Octanis1/Octanis1-Electronics/README.md

This repo contains all Octanis 1 electronics schematics, BOM, etc.
