Octanis1/Octanis1-Electronics/octanis_eps/v0.2_compact_version/octanis_eps_revised.pdf

09/05/15 21:36 f=2.00 /Users/raffael/Desktop/Octanis/octanis-pcb/Octanis1-Electronics/octanis_eps/v0.2_compact_version/octanis_eps_revised.brd

86k6

3k32

100nF

10uF 100mH

22uF

100nF

TPS2022D 1M

100nF
100nF

920k

Octanis_EPS v0.2
