Octanis1/Octanis1-Electronics/octanis_eps/v0.3_footprint_corrections/indexed.bmp

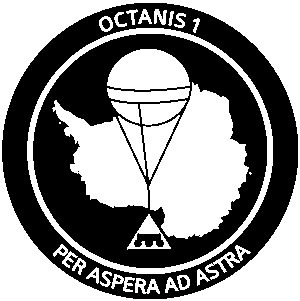
octanis_eps/v0.3_footprint_corrections/indexed.bmp
