Octanis1/Octanis1-Electronics/octanis_bom.xlsx

Sheet: octanis_v0.1bom
 | STATUS | Qty | Value | Device | Package | Parts | Description
 | mouser | 2 |  | LEDCHIP-LED0603 | CHIP-LED0603 | LED1
 | order in progress | 1 | - BAT + | PINHD-1X2 | 1X02 | BATTERY | PIN HEADER
 | order in progress | 1 | - SOLAR + | PINHD-1X2 | 1X02 | SOLAR | PIN HEADER
 | mouser | 1 | 0.01 | R-EU_R1206 | R1206 | RSBAT | RESISTOR
 | in kit | 7 | 0.1uF | C-EUC0603 | C0603 | C11
 | mouser | 1 | 0.22uF | C-EUC0603 | C0603 | C13 | CAPACITOR
 | in kit | 1 | 0.47uF | C-EUC0603 | C0603 | CG4 | CAPACITOR
 | in kit | 1 | 0R | R-EU_R0603 | R0603 | R28 | RESISTOR
should be matched | 2M in kit | 1 | 1.8M | R-EU_R0603 | R0603 | RG1 | RESISTOR
 | in kit | 2 | 100 | R-EU_R0603 | R0603 | RG5
 | in kit | 1 | 100k | R-EU_R0603 | R0603 | R5 | RESISTOR
 | in kit | 5 | 100nF | C-EUC0603 | C0603 | C14
 | mouser | 2 | 103AT | THERMISTOR-2
 | in kit | 2 | 10k | R-EU_R0603 | R0603 | RPUC
 | in kit | 2 | 10nF | C-EUC0603 | C0603 | C4
 | mouser | 2 | 10uF | CPOL-EUA/3216-18R | A/3216-18R | C12 | POLARIZED CAPACITOR
re-ordered ebay | mouser | 2 | 12p | C-EUC0603 | C0603 | C25 | cap at resonator !TOO SMALL!
should be matched | 20k in Kit | 1 | 18.2k | R-EU_R0603 | R0603 | RG2 | RESISTOR
 | in kit | 1 | 1M | R-EU_R0603 | R0603 | R16 | RESISTOR
 | in kit | 4 | 1k | R-EU_R0603 | R0603 | R1
 | in kit | 2 | 1uF | C-EUC0603 | C0603 | C7
 | in kit 603 | 2 | 1uF | C-EUC1206 | C1206 | C1
 | mouser | 1 | 1uH | XFL4020 | Coilcraft XFL4020 | L1 | http://www.mouser.ch/ProductDetail/Coilcraft/XFL4020-102MEB/
 | ebay |  | 2.2nF
 |  | 1 | 21.5k | R-EU_R1206 | R1206 | RT1 | RESISTOR
 | mouser | 3 | 22uF | C-EUC0603 | C0603 | C3 | http://www.mouser.ch/ProductDetail/TDK/C1608X5R1A226M080AC/?qs=sGAEpiMZZMs0AnBnWHyRQFzBYxg9rzNcR2ipNJY1lio%3d
 | mouser | 1 | 32.768kHz | FC-12M | FC-12M | Q1 | kHz RANGE CRYSTAL UNIT
 | mouser | 1 | 33nF | C-EUC0603 | C0603 | CG2 | CAPACITOR
 | mouser | 1 | 4.7uF | C-EUC0603 | C0603 | C10 | CAPACITOR
should be matched | in kit | 1 | 68k | R-EU_R0603 | R0603 | R3 | RESISTOR
should be matched | in kit | 1 | 270k | R-EU_R0603 | R0603 | R3 | RESISTOR
 | in kit | 1 | 470n | C-EUC0603 | C0603 | C18 | CAPACITOR
 | 510 in kit | 1 | 500 (variable) | R-EU_R1206 | R1206 | R4 | RESISTOR
 | mouser | 1 | 5V-ok | LEDCHIPLED_0603 | CHIPLED_0603 | LED3 | LED
 | available | 2 | BC547 | BC547 | TO92 | T1
mouser 3 | breakout | 1 | BMP180 | BMP180 | BMP180 | U9 | temp/pressure sensor
 | samples ordered | 1 | BQ24210 | BQ24210_DQC_10 | DQC10_P84X2P4 | U1 | charge controller
 | samples ordered | 1 | BQ27510_DRZ_12 | BQ27510_DRZ_12 | DRZ12_1P95X2P45 | U2 | fuel gauge
 | samples ordered | 4 | DRV8836DSSR | DRV8836DSSR | SON50P200X300X80-13N | U3 | h-bridge driver
 | available | 1 | HEATPAD | 22-23-2021 | 22-23-2021 | HEATPAD | .100 (2.54mm) Center Header - 2 Pin"
ebay | breakout | 1 | HMC5883L | HMC5883L | LPCC16 | COMPASS
ebay | breakout | 1 | MPU-6050 | MPU-6050 | QFN24 | MPU-6050 | pressure sensor
 | samples ordered | 1 | MSP430F5529IPNR | F552X---PN80 | PN80 | U6 | ***MSP430F552X***PN80
 | samples ordered | 1 | REG1117 | REG1117 | SOT223 | IC1 | 800mA and 1A Low Dropout (LDO) Positive Regulator
 | samples ordered | 1 | TPS61230 | TPS61230 | DRC-S-PVSON-N11 | U$1 | step up converter
 | check value! | 1 | float | R-EU_R1206 | R1206 | RVDM | RESISTOR

Sheet: eps_v0.2bom
BOM EPS Octanis1
Active components |  |  |  |  |  |  |  |  |  |  | Digikey | (QTY: for 4 boards)
Reference | Unit Price (CHF) | Qty | Total price | Manufacturer | Package | Provider | Description |  |  |  | TI samples
TPS62086RLTT | 6.35 | 1 | 6.35 | TI | VQFN-7 | Farnell | 3.3V 3A buck converter (discharge) |  |  |  | more qty needed |  | more qty ordered
LTC3402EMS#PBF | 11.1 | 1 | 11.1 | Linear Devices | MSOP10 | Farnell | Adjustable boost converter 2A (charge |  |  |  | available in the lab
MSP430G2744IDA38R | 2.85 | 1 | 2.85 | TI | TSSOP38 | TI | MCU |  |  |  | similar available in the lab
INA213AIDCKT | 1.7 | 2 | 3.4 | TI | SC70-6 | Farnell | Gain 50 current sensor 35µA polarization |  |  |  | not on digikey
TPS2022D | 3.5 | 3 | 10.5 | TI | SOIC8 | Farnell | 1.5A distribution switch
ADR127BUJZ-REEL7 | 10.15 | 1 | 10.15 | Analog Devices | TSOT23-6 | Farnell | Precision 1.25V voltage reference
OPA2333AIDGKT | 3.6 | 4 | 14.4 | TI | MSOP8 | Farnell | Low power OPA 2 channels
FDV301N | 0.288 | 3 | 0.864 | Farichild | SOT-23 | Farnell | N canal MOSFET
IRLL024NPBF | 1.25 | 3 | 3.75 | IR | SOT-223 | Farnell | N hexfet 2V threshold
MJD44H11T4 | 0.713 | 1 | 0.713 | ST micro | TO-252 | Farnell | BJT
Reference | Unit Price (CHF) | Qty | Total price | Manufacturer | Package | Provider | Description | Comment on order
1kOhm | 0.015 | 3 | 0.045 | - | 603 | Farnell
50mOhm 0.1% 1/2W | 0.1 | 3 | 0.3 | - | 1206 | Farnell | current shunts precision resistor | 25pcs 0.5%
10kOhm 0.1% | 0.03 | 6 | 0.18 | - | 603 | Farnell |  | 30pc
100kOhm | 0.015 | 5 | 0.075 | - | 603 | Farnell
200kOhm | 0.015 | 5 | 0.075 | - | 603 | Farnell
147kOhm 0.1% | 0.03 | 1 | 0.03 | - | 603 | Farnell |  | 5
953Ohm 0.1% | 0.03 | 1 | 0.03 | - | 603 | Farnell |  | 5
86k6Ohm 0.1% | 0.5 | 1 | 0.5 | - | 603 | Farnell |  | 5
4k02Ohm 0.1% | 0.5 | 1 | 0.5 | - | 603 | Farnell |  | 5
560kOhm 0.1% | 0.1 | 2 | 0.2 | - | 603 | Farnell |  | 10pcs
3k32Ohm 0.1% | 0.5 | 1 | 0.5 | - | 603 | Farnell |  | 5
30k1Ohm 0.1% | 0.5 | 1 | 0.5 | - | 603 | Farnell |  | 5
~~1.3MOhm 0.1%~~ | ~~0.5~~ | ~~1~~ | ~~0.5~~ | ~~-~~ | ~~603~~ | ~~Farnell~~ |  | ~~5pc 1%~~
~~549kOhm 0.1%~~ | ~~0.5~~ | ~~1~~ | ~~0.5~~ | ~~-~~ | ~~603~~ | ~~Farnell~~ |  | ~~5pc 1%~~
82kOhm 0.1% | 0.5 | 1 | 0.5 | - | 603 | Farnell |  | 5
1MOhm | 0.015 | 6 | 0.09 | - | 603 | Farnell
162kOhms 1% | 0.015 | 3 | 0.045 |  | 603 | Farnell |  | 15pcs
20kOhms 0.11% | 0.03 | 1 | 0.03 |  | 603 | Farnell |  | 5
23.2kOhms 0.1% | 0.03 | 1 | 0.03 |  | 603 | Farnell |  | 5
31.60kOhms 0.1% | 0.03 | 1 | 0.03 |  | 603 | Farnell |  | 5
920kOhms 0.1% | 0.03 | 1 | 0.03 |  | 603 | Farnell |  |  | BUY 820K + 100K | ordered 10+20
MBRM120LT1G | 0.9 | 3 | 2.7 | - | D0216AA | Farnell | shottky | 25pc
150nF | 0.03 | 4 | 0.12 | - | 603 | Farnell |  | 20pc | 1,5uF in schematics | note: only 10% available for this package
100nF | 0.03 | 10 | 0.3 | - | 603 | Farnell
10nF | 0.03 | 10 | 0.3 | - | 603 | Farnell
12pF 1% -->12.5?? | 0.5 | 2 | 1 | - | 603 | Farnell |  | 25pc
10uF | 0.5 | 1 | 0.5 | - | A/3216-18R | Farnell | polarized capacitor
22uF | 0.5 | 1 | 0.5 | - | A/3216-18R | Farnell | polarized capacitor
470pF | 0.003 | 1 | 0.003 | - | 603 | Farnell |  | 10pcs
4.7pF | 0.003 | 1 | 0.003 | - | 603 | Farnell |  | 10pc
4.7uF | 0.5 | 1 | 0.5 | - | 1206 | Farnell | X5R or X7R family recommended | 10pcs 1206
22uF | 0.5 | 2 | 1 | - | 603 | Farnell | X5R or X7R family recommended
10uF | 0.5 | 2 | 1 | - | 1206 | Farnell | X5R or X7R family recommended | 10pcs
10uH | 1.25 | 1 | 1.25 | Coiltronics | DR127 | Farnell | Power inductor 10uH
DR127-R47-R. | 1.2 | 1 | 1.2 | Coiltronics | DR128 | Farnell | Power inductor 0.47uH
32kHz crystal | 0.5 | 1 | 0.5 | - | FC-12M | Farnell | Crystal | ordered one with 6pF cap!
 |  |  | 79.643

Sheet: eps_v0.4bom
BOM EPS Octanis1 |  |  |  |  |  |  |  |  |  |  |  |  |  |  |  |  |  | 2:50:00
Active components |  |  |  |  |  |  |  |  |  |  |  |  |  |  |  |  |  |  | Digikey | (QTY: for 4 boards)
Reference | Unit Price (CHF) | Qty | Total price | Manufacturer | Package | Provider | Description |  |  |  | Qty | Value | Device | Package | Parts |  | Description |  | samples
TPS62086RLTT | 6.35 | 1 | 6.35 | TI | VQFN-7 | Farnell | 3.3V 3A buck converter (discharge) |  |  |  | 1 | TPS62086 | TPS62086 | QFN-7 | U$4 |  | 3-A |  | more qty needed |  | more qty ordered
LTC3402EMS#PBF | 11.1 | 1 | 11.1 | Linear Devices | MSOP10 | Farnell | Adjustable boost converter 2A (charge |  |  |  | 3 | TPS2022D | TPS2022D | SO8 | U$101, U$102, U | $103 | TEXAS INSTRUMENTS - TPS202 | 2D - IC, 1.5A PWR DIST SWITCH 8SOIC | available in the lab
MSP430G2744IDA38R | 2.85 | 1 | 2.85 | TI | TSSOP38 | TI | MCU |  |  |  | 1 | OPA347 | OPA347 | SC70-5 | IC101 |  | micro Power, |  | similar available in the lab
INA213AIDCKT | 1.7 | 2 | 3.4 | TI | SC70-6 | Farnell | Gain 50 current sensor 35µA polarization |  |  |  | 3 | OPA2333DGK | OPA2333DGK | MSOP08 | IC1, IC2, IC100 |  | DUAL 1.8V, microPOWER CMOS | OPERATIONAL AMPLIFIERS Zerø-Drift Series | not on digikey
TPS2022D | 3.5 | 3 | 10.5 | TI | SOIC8 | Farnell | 1.5A distribution switch |  |  |  | 3 | IRLL024NPBF | N-HEXFET-2D_SOT232- | SOT223 | Q1, Q2, Q100 |  | HEXFET® Power MOSFET 2 Dra | in connects | more precision needed
ADR127BUJZ-REEL7 | 10.15 | 1 | 10.15 | Analog Devices | TSOT23-6 | Farnell | Precision 1.25V voltage reference |  |  |  | 1 | MSP430G2544 | MSP430G2544 | TSSOP38_MSPGXX44_SERIES | U$5 |  | MSP430G2x44 |  | Ordered on MOUSER
OPA2333AIDGKT | 3.6 | 4 | 14.4 | TI | MSOP8 | Farnell | Low power OPA 2 channels |  |  |  | 1 | MJD44H11T0-252 | MJD44H11T0-252 | TO252 | U$1 |  | MJD44H11,
FDV301N | 0.288 | 3 | 0.864 | Farichild | SOT-23 | Farnell | N canal MOSFET |  |  |  | 1 | MBRM120LTIG | MBRM120LTIG | DO216AA | U$7
IRLL024NPBF | 1.25 | 3 | 3.75 | IR | SOT-223 | Farnell | N hexfet 2V threshold |  |  |  | 1 | MAX6190BESA | MAX6190BESA | SO8 | U$100 |  | MAX6190–MAX6195/MAX6198
MJD44H11T4 | 0.713 | 1 | 0.713 | ST micro | TO-252 | Farnell | BJT |  |  |  | 1 (2 available) | LTC3402 | LTC3402 | MSOP10 | U$6 |  | 1
Reference | Unit Price (CHF) | Qty | Total price | Manufacturer | Package | Provider | Description | Comment on order |  |  | 2 | INA213 | INA213 | SC70-6 | U$2, U$3 |  | Voltage
1kOhm | 0.015 | 3 | 0.045 | - | 603 | Farnell |  |  |  |  | 1 | FC-12M | FC-12M | FC-12M | Q3 |  | kHz RANGE CRYSTAL UNIT
50mOhm 0.1% 1/2W | 0.1 | 3 | 0.3 | - | 1206 | Farnell | current shunts precision resistor | 25pcs 0.5% |  |  | 1 | 0.47uH | DR127 | DR127 | 0.47uH |  | High Power Density, High E | fficiency, Shielded Inductors
10kOhm 0.1% | 0.03 | 6 | 0.18 | - | 603 | Farnell |  | 30pc |  |  | 2 | 10UH | DR127 | DR127 | 10UH |  | High Power Density, High E | fficiency, Shielded Inductors
100kOhm | 0.015 | 5 | 0.075 | - | 603 | Farnell
200kOhm | 0.015 | 5 | 0.075 | - | 603 | Farnell |  |  |  |  | 1 | 953R 0.1% | R-EU_R0603 | R0603 | R100 |  | RESISTOR, European symbol
147kOhm 0.1% | 0.03 | 1 | 0.03 | - | 603 | Farnell |  | 5 |  |  | 1 | 0Ohm | R-EU_R0603 | R0603 | R4 |  | RESISTOR, European symbol
953Ohm 0.1% | 0.03 | 1 | 0.03 | - | 603 | Farnell |  | 5 |  |  | 4 | 1.5uF | C-EUC0603 | C0603 | C1, C2, C7, C12 |  | CAPACITOR, European symbol
86k6Ohm 0.1% | 0.5 | 1 | 0.5 | - | 603 | Farnell |  | 5 |  |  | 8 | 100k --> precision??? | R-EU_R0603 | R0603 | R15, R19, R104, | R108, R111, R112, R117, R119 | RESISTOR, European symbol
4k02Ohm 0.1% | 0.5 | 1 | 0.5 | - | 603 | Farnell |  | 5 |  |  | 1 | 100mH | BLM15HD601SN1 | 402 | FERRITE |  | EMIFIL (R) Chip Ferrite Be | ad for GHz Noise
560kOhm 0.1% | 0.1 | 2 | 0.2 | - | 603 | Farnell |  | 10pcs |  |  | 8 | 100nF | C-EUC0603 | C0603 | C10, C100, C102 | , C105, C_IC1, C_IC2, C_IC100, C_IC101 | CAPACITOR, European symbol
3k32Ohm 0.1% | 0.5 | 1 | 0.5 | - | 603 | Farnell |  | 5 |  |  | 3 | 10k 0.1% | R-EU_R0603 | R0603 | R11, R18, R23 |  | RESISTOR, European symbol
30k1Ohm 0.1% | 0.5 | 1 | 0.5 | - | 603 | Farnell |  | 5 |  |  | 2 | 10m | CURRENT_RESISTOR | 4PADS_RESISTOR | RSENSE1, R_SENS | E1
~~1.3MOhm 0.1%~~ | ~~0.5~~ | ~~1~~ | ~~0.5~~ | ~~-~~ | ~~603~~ | ~~Farnell~~ |  | ~~5pc 1%~~ |  |  | 1 | 10nF | C-EUC0603 | C0603 | C11 |  | CAPACITOR, European symbol
~~549kOhm 0.1%~~ | ~~0.5~~ | ~~1~~ | ~~0.5~~ | ~~-~~ | ~~603~~ | ~~Farnell~~ |  | ~~5pc 1%~~ |  |  | 1 | 10uF | C-EUC1206 | C1206 | C3 |  | CAPACITOR, European symbol
82kOhm 0.1% | 0.5 | 1 | 0.5 | - | 603 | Farnell |  | 5 |  |  | 1 | 10uF | CPOL-EUA/3216-18R | A/3216-18R | C103 |  | POLARIZED CAPACITOR, Europ | ean symbol
1MOhm | 0.015 | 6 | 0.09 | - | 603 | Farnell |  |  |  |  | 2 | 12pF | C-EUC0603 | C0603 | C5, C6 |  | CAPACITOR, European symbol
162kOhms 1% | 0.015 | 3 | 0.045 |  | 603 | Farnell |  | 15pcs |  |  | 1 | 147k 0.1% | R-EU_R0603 | R0603 | R105 |  | RESISTOR, European symbol
20kOhms 0.11% | 0.03 | 1 | 0.03 |  | 603 | Farnell |  | 5 |  |  | 3 | 162k 0.1% | R-EU_R0603 | R0603 | R14, R22, R27 |  | RESISTOR, European symbol
23.2kOhms 0.1% | 0.03 | 1 | 0.03 |  | 603 | Farnell |  | 5 |  |  | 7 | 1k | R-EU_R0603 | R0603 | R1, R2, R3, R5, | R10, R13, R17 | RESISTOR, European symbol
31.60kOhms 0.1% | 0.03 | 1 | 0.03 |  | 603 | Farnell |  | 5 |  |  | 8 | 1M | R-EU_R0603 | R0603 | R6, R7, R8, R9, | R24, R113, R114, R115 | RESISTOR, European symbol
920kOhms 0.1% | 0.03 | 1 | 0.03 |  | 603 | Farnell |  |  | BUY 820K + 100K | ordered 10+20 | 1 | 2.2nF | C-EUC0603 | C0603 | C101 |  | CAPACITOR, European symbol
MBRM120LT1G | 0.9 | 3 | 2.7 | - | D0216AA | Farnell | shottky | 25pc |  |  | 5 | 200k | R-EU_R0603 | R0603 | R29, R103, R107 | , R116, R118 | RESISTOR, European symbol
150nF | 0.03 | 4 | 0.12 | - | 603 | Farnell |  | 20pc | 1,5uF in schematics | note: only 10% available for this package | 1 | 20k 0.1% | R-EU_R0603 | R0603 | R25 |  | RESISTOR, European symbol
100nF | 0.03 | 10 | 0.3 | - | 603 | Farnell |  |  |  |  | 1 | 22uF | C-EUC0603 | C0603 | C14 |  | CAPACITOR, European symbol
10nF | 0.03 | 10 | 0.3 | - | 603 | Farnell |  |  |  |  | 1 | 22uF | C-EUC1206 | C1206 | C4 |  | CAPACITOR, European symbol
12pF 1% -->12.5?? | 0.5 | 2 | 1 | - | 603 | Farnell |  | 25pc |  |  | 1 | 22uF | CPOL-EUA/3216-18R | A/3216-18R | C104 |  | POLARIZED CAPACITOR, Europ | ean symbol
10uF | 0.5 | 1 | 0.5 | - | A/3216-18R | Farnell | polarized capacitor |  |  |  | 1 | 23.2k 0.1% | R-EU_R0603 | R0603 | R28 |  | RESISTOR, European symbol
22uF | 0.5 | 1 | 0.5 | - | A/3216-18R | Farnell | polarized capacitor |  |  |  | 1 | 30.1k 0.1% | R-EU_R0603 | R0603 | R16 |  | RESISTOR, European symbol
470pF | 0.003 | 1 | 0.003 | - | 603 | Farnell |  | 10pcs |  |  | 1 | 31.60k 0.1% | R-EU_R0603 | R0603 | R26 |  | RESISTOR, European symbol
4.7pF | 0.003 | 1 | 0.003 | - | 603 | Farnell |  | 10pc |  |  | 1 | 3k32 0.1% | R-EU_R0603 | R0603 | R106 |  | RESISTOR, European symbol
4.7uF | 0.5 | 1 | 0.5 | - | 1206 | Farnell | X5R or X7R family recommended | 10pcs 1206 |  |  | 1 | 4.7pF | C-EUC0603 | C0603 | C8 |  | CAPACITOR, European symbol
22uF | 0.5 | 2 | 1 | - | 603 | Farnell | X5R or X7R family recommended |  |  |  | 1 | 4.7uF | C-EUC1206 | C1206 | C13 |  | CAPACITOR, European symbol
10uF | 0.5 | 2 | 1 | - | 1206 | Farnell | X5R or X7R family recommended | 10pcs |  |  | 1 | 470pF | C-EUC0603 | C0603 | C9 |  | CAPACITOR, European symbol
10uH | 1.25 | 1 | 1.25 | Coiltronics | DR127 | Farnell | Power inductor 10uH |  |  |  | 1 | 4k02 0.1% | R-EU_R0603 | R0603 | R102 |  | RESISTOR, European symbol
DR127-R47-R. | 1.2 | 1 | 1.2 | Coiltronics | DR128 | Farnell | Power inductor 0.47uH |  |  |  | 1 | 50m | CURRENT_RESISTOR | 4PADS_RESISTOR | RSENSE2
32kHz crystal | 0.5 | 1 | 0.5 | - | FC-12M | Farnell | Crystal | ordered one with 6pF cap! |  |  | 2 | 560k 0.1% | R-EU_R0603 | R0603 | R21, R109 |  | RESISTOR, European symbol
 |  |  |  |  |  |  |  |  |  |  | 1 | 82k 0.1% | R-EU_R0603 | R0603 | R12 |  | RESISTOR, European symbol
 |  |  |  |  |  |  |  |  |  |  | 1 | 86k6 0.1% | R-EU_R0603 | R0603 | R101 |  | RESISTOR, European symbol
 |  |  | 79.643 |  |  |  |  |  |  |  | 2 | 920k (100k + 820k) 0.1% | R-EU_R0603 | R0603 | R20, R110 |  | RESISTOR, European symbol
Part | list exported from / | Users/raffael/Deskto | p/Octanis/octanis-pcb/Oc | tanis1-Electron | ics/octanis_eps/v0.4_second_run/octanis | _eps_v04.sch at 08/09/15 1 | 2:50:00
Qty | Value | Device | Package | Parts |  | Description
2 |  | JP1E | JP1 | I2C, SLEEP |  | JUMPER
1 |  | JP4Q | JP4Q | JP3 |  | JUMPER
4 |  | PINHD-1X1 | 1X01 | BT_CHG, DSP_CMD | , VCC, VREF | PIN HEADER
1 |  | PINHD-2X12 | 2X12 | JP1 |  | PIN HEADER
1 | 0Ohm | R-EU_R0603 | R0603 | R4 |  | RESISTOR, European symbol
4 | 1.5uF | C-EUC0603 | C0603 | C1, C2, C7, C12 |  | CAPACITOR, European symbol
8 | 100k | R-EU_R0603 | R0603 | R15, R19, R104, | R108, R111, R112, R117, R119 | RESISTOR, European symbol
1 | 100mH | BLM15HD601SN1 | 402 | FERRITE |  | EMIFIL (R) Chip Ferrite Be | ad for GHz Noise
8 | 100nF | C-EUC0603 | C0603 | C10, C100, C102 | , C105, C_IC1, C_IC2, C_IC100, C_IC101 | CAPACITOR, European symbol
3 | 10k | R-EU_R0603 | R0603 | R11, R18, R23 |  | RESISTOR, European symbol
2 | 10m | CURRENT_RESISTOR | 4PADS_RESISTOR | RSENSE1, R_SENS | E1
1 | 10nF | C-EUC0603 | C0603 | C11 |  | CAPACITOR, European symbol
1 | 10uF | C-EUC1206 | C1206 | C3 |  | CAPACITOR, European symbol
1 | 10uF | CPOL-EUA/3216-18R | A/3216-18R | C103 |  | POLARIZED CAPACITOR, Europ | ean symbol
2 | 12pF | C-EUC0603 | C0603 | C5, C6 |  | CAPACITOR, European symbol
1 | 147k | R-EU_R0603 | R0603 | R105 |  | RESISTOR, European symbol
3 | 162k | R-EU_R0603 | R0603 | R14, R22, R27 |  | RESISTOR, European symbol
8 | 1M | R-EU_R0603 | R0603 | R6, R7, R8, R9, | R24, R113, R114, R115 | RESISTOR, European symbol
7 | 1k | R-EU_R0603 | R0603 | R1, R2, R3, R5, | R10, R13, R17 | RESISTOR, European symbol
1 | 2.2nF | C-EUC0603 | C0603 | C101 |  | CAPACITOR, European symbol
5 | 200k | R-EU_R0603 | R0603 | R29, R103, R107 | , R116, R118 | RESISTOR, European symbol
1 | 20k | R-EU_R0603 | R0603 | R25 |  | RESISTOR, European symbol
1 | 22uF | C-EUC0603 | C0603 | C14 |  | CAPACITOR, European symbol
1 | 22uF | C-EUC1206 | C1206 | C4 |  | CAPACITOR, European symbol
1 | 22uF | CPOL-EUA/3216-18R | A/3216-18R | C104 |  | POLARIZED CAPACITOR, Europ | ean symbol
1 | 23.2k | R-EU_R0603 | R0603 | R28 |  | RESISTOR, European symbol
1 | 30.1k | R-EU_R0603 | R0603 | R16 |  | RESISTOR, European symbol
1 | 31.60k | R-EU_R0603 | R0603 | R26 |  | RESISTOR, European symbol
1 | 3k32 | R-EU_R0603 | R0603 | R106 |  | RESISTOR, European symbol
1 | 4.7pF | C-EUC0603 | C0603 | C8 |  | CAPACITOR, European symbol
1 | 4.7uF | C-EUC1206 | C1206 | C13 |  | CAPACITOR, European symbol
1 | 470pF | C-EUC0603 | C0603 | C9 |  | CAPACITOR, European symbol
1 | 4k02 | R-EU_R0603 | R0603 | R102 |  | RESISTOR, European symbol
1 | 50m | CURRENT_RESISTOR | 4PADS_RESISTOR | RSENSE2
2 | 560k | R-EU_R0603 | R0603 | R21, R109 |  | RESISTOR, European symbol
1 | 82k | R-EU_R0603 | R0603 | R12 |  | RESISTOR, European symbol
1 | 86k6 | R-EU_R0603 | R0603 | R101 |  | RESISTOR, European symbol
2 | 920k | R-EU_R0603 | R0603 | R20, R110 |  | RESISTOR, European symbol
1 | 953R | R-EU_R0603 | R0603 | R100 |  | RESISTOR, European symbol
2 | DR127 | DR127 | DR127 | 0.47UH, 10UH |  | High Power Density, High E | fficiency, Shielded Inductors
1 | FC-12M | FC-12M | FC-12M | Q3 |  | kHz RANGE CRYSTAL UNIT
2 | INA213 | INA213 | SC70-6 | U$2, U$3 |  | Voltage
1 | LTC3402 | LTC3402 | MSOP10 | U$6 |  | 1
1 | MAX6190BESA | MAX6190BESA | SO8 | U$100 |  | MAX6190–MAX6195/MAX6198
1 | MBRM120LTIG | MBRM120LTIG | DO216AA | U$7
1 | MJD44H11T0-252 | MJD44H11T0-252 | TO252 | U$1 |  | MJD44H11,
1 | MSP430G2544 | MSP430G2544 | TSSOP38_MSPGXX44_SERIES | U$5 |  | MSP430G2x44
3 | N-HEXFET-2D_SOT232- | N-HEXFET-2D_SOT232- | SOT223 | Q1, Q2, Q100 |  | HEXFET® Power MOSFET 2 Dra | in connects
3 | OPA2333DGK | OPA2333DGK | MSOP08 | IC1, IC2, IC100 |  | DUAL 1.8V, microPOWER CMOS | OPERATIONAL AMPLIFIERS Zerø-Drift Series
1 | OPA347 | OPA347 | SC70-5 | IC101 |  | micro Power,
3 | TPS2022D | TPS2022D | SO8 | U$101, U$102, U | $103 | TEXAS INSTRUMENTS - TPS202 | 2D - IC, 1.5A PWR DIST SWITCH 8SOIC
1 | TPS62086 | TPS62086 | QFN-7 | U$4 |  | 3-A
1 | d SBW clk | PINHD-1X2 | 1X02 | JP2 |  | PIN HEADER

Sheet: octanis_v0.4bom
ORDERED | Qty | Value | Device | Package | Parts | Description |  | Digikey | (QTY: for 4 boards)
 | 1 | 0R | R-EU_R0402 | R0402 | R7 | RESISTOR, European symbol |  | TI samples
 | 10 | 100n | C-EUC0603 | C0603 | C2, C11, C15, C16, C18, C19, C20, C29 | CAPACITOR, European symbol (2 of them in 0402 package) |  | more qty needed |  | more qty ordered
 | 3 | 10k | R-EU_R0603 | R0603 | R16, RPUC, RPUD | RESISTOR, European symbol |  | available in the lab
 | 2 | 10n | C-EUC0603 | C0603 | C17 | CAPACITOR, European symbol |  | similar available in the lab
 | 2 | 10u | CPOL-EUA/3216-18R | A/3216-18R | C25, C30 | POLARIZED CAPACITOR, European symbol |  | not on digikey
 | 2 | 12p | C-EUC0402 | C0402 | C9, C22 | CAPACITOR, European symbol |  | ordered on MOUSER
 | 2 | 1M | R-EU_R0603 | R0603 | R2, R3 | RESISTOR, European symbol
 | 4 | 1k | R-EU_R0603 | R0603 | R4, R6, R8, R9 | RESISTOR, European symbol
 | 1 | 1uH | XFL4020 | XFL4020 | L1 | coilcraft
 | 1 | 2.2n | C-EUC0603 | C0603 | C21 | CAPACITOR, European symbol
470nF in kit | 1 | 220n | C-EUC0603 | C0603 | C13 | CAPACITOR, European symbol
 | 4 | 22uF | C-EUC0603 | C0603 | C3, C5, C6 | CAPACITOR, European symbol
10pc | 1 | 32.768kHz | MS3V-T1R | MS3V-T1R | Q2 | microcrystal | --> Abracon LLC AB26TRQ-32.768KHZ-T
 | 1 | 3V-ok | LEDCHIPLED_0603 | CHIPLED_0603 | GREEN | LED
 | 1 | 4.7u | C-EUC0603 | C0603 | C10 | CAPACITOR, European symbol
5pc | 1 | 4.7uH | LQM2MP_G0 | 806 | L3 | LQM2MPN4R7NG0
 | 4 | 470n | C-EUC0603 | C0603 | C8, C26, C27, C28 | CAPACITOR, European symbol
 | 1 | 5V-ok | LEDCHIPLED_0603 | CHIPLED_0603 | RED | LED
4 pc | 1 | 91k 0.1% Â±25 ppm/Â°C | R-EU_R0402 | R0402 | R10 | RESISTOR, European symbol
4 pc | 1 | BME280 | BME280 | BME280 | IC1 | DIGITAL HUMIDITY, PRESSURE AND TEMPERATURE SENSOR* Digital interface IÂ²C (up to 3.4 MHz) and SPI (3 and 4 wire, up to 10 MHz)* Supply voltage VDD main supply voltage range: 1.71 V to 3.6 V*VDDIO interface voltage range: 1.2 V to 3.6 V
 | 4 | DRV8836DSSR | DRV8836DSSR | SON50P200X300X80-13N | U3, U4, U5, U7 | DUAL LOW VOLTAGE H-BRIDGE IC,SON-12
3pc | 1 | HMC5883L | HMC5883L | LPCC16 | COMPASS
 | 1 | HX1 | HX1 | HX1 | U$4 | Radiometrix HX1:
 | 2 | LED0 | LEDCHIPLED_0603 | CHIPLED_0603 | LED0 | LED
 | 1 | MPU-6050 | MPU-6050 | QFN24 | MPU-6050
 | 1 | MSP432 | MSP432 | PZ100 | MSP1
4pc | 1 | SST26VF064B | SST26VF064B | SOIC_8-LEAD | U$3
5pc | 1 | TPS61232 | TPS61232 | S-PVSON-N10 | U$1 | Up to 96% Efficiency Synchronous Boost Converter
50pin + ali | 7pin | header 2mm male
2pc + ali | 7pin | header 2mm female

Sheet: octanis_v0.5bom
ORDERED | Qty | Value | Device | Package | Parts | Description |  | Digikey | (QTY: for 4 boards)
 |  |  |  |  |  |  |  | TI samples
 |  |  |  |  |  |  |  | more qty needed |  | more qty ordered
 |  |  |  |  |  |  |  | available in the lab
 |  |  |  |  |  |  |  | similar available in the lab
 |  |  |  |  |  |  |  | not on digikey
 |  |  |  |  |  |  |  | ordered on MOUSER
 | 1 | 0R | R-EU_R0402 | R0402 | R11 | RESISTOR, European symbol
 | 3 | 100k | R-EU_R0603 | R0603 | R12, R13, R21 | RESISTOR, European symbol
 | 2 | 100n | C-EUC0402 | C0402 | C16, C26 | CAPACITOR, European symbol
 | 7 | 100n | C-EUC0603 | C0603 | C6, C11, C14, C18, C20, C21, C24 | CAPACITOR, European symbol | --> Abracon LLC AB26TRQ-32.768KHZ-T
 | 1 | 10k | R-EU_R0603 | R0603 | R19 | RESISTOR, European symbol
 | 4 | 10n | C-EUC0603 | C0603 | C33, C34, C35, C36 | CAPACITOR, European symbol
 | 1 | 10nF | C-EUC0603 | C0603 | C5 | CAPACITOR, European symbol
 | 2 | 10u | CPOL-EUA/3216-18R | A/3216-18R | C13, C15 | POLARIZED CAPACITOR, European symbol
 | 1 | 100n + 10n | C-EUC0603 | C0603 | C22 | CAPACITOR, European symbol
 | 2 | 6p | C-EUC0402 | C0402 | C23, C25 | CAPACITOR, European symbol
 | 2 | 12p | C-EUC0603 | C0603 | C17, C19 | CAPACITOR, European symbol
 | 2 | 1M | R-EU_R0603 | R0603 | R4, R5 | RESISTOR, European symbol
 | 4 | 1k | R-EU_R0603 | R0603 | R2, R6, R7, R9 | RESISTOR, European symbol
 | 1 | 1n | C-EUC0603 | C0603 | C1 | CAPACITOR, European symbol
 | 1 | 1uH | XFL4020 | XFL4020 | L1
 | 3 | 22uF | C-EUC0603 | C0603 | C2, C4, C7 | CAPACITOR, European symbol
 | 1 | 3 x 22uF | C-EUC0603 | C0603 | C9 | CAPACITOR, European symbol
 | 1 | 32.768kHz | FC-12M | FC-12M | Q1 | kHz RANGE CRYSTAL UNIT
 | 1 | 32.768kHz | MS3V-T1R | MS3V-T1R | Q2
 | 1 | 3V-ok | LEDCHIPLED_0603 | CHIPLED_0603 | 3V | LED
 | 2 | 4.7k | R-EU_R0603 | R0603 | R1, R3 | RESISTOR, European symbol
 | 1 | 4.7uH | LQM2MP_G0 | 806 | L2
 | 8 | 470n | C-EUC0603 | C0603 | C10, C12, C27, C28, C29, C30, C31, C32 | CAPACITOR, European symbol
 | 1 | 47k | R-EU_R0603 | R0603 | R10 | RESISTOR, European symbol
 | 1 | 5V-ok | LEDCHIPLED_0603 | CHIPLED_0603 | 5V | LED
 | 4 | 6.8k | R-EU_R0603 | R0603 | R15, R16, R18, R20 | RESISTOR, European symbol
 | 1 | 91k 0.1% ±25 ppm/°C | R-EU_R0402 | R0402 | R14 | RESISTOR, European symbol
 | 1 | BME280 | BME280 | BME280 | IC1 | DIGITAL HUMIDITY, PRESSURE AND TEMPERATURE SENSOR* Digital interface I²C (up to 3.4 MHz) and SPI (3 and 4 wire, up to 10 MHz)* Supply voltage VDD main supply voltage range: 1.71 V to 3.6 V*VDDIO interface voltage range: 1.2 V to 3.6 V
 | 1 | BNO055A | BNO055A | BNO055 | IC2
 | 4 | DRV8836DSSR | DRV8836DSSR | SON50P200X300X80-13N | U2, U3, U6, U7 | DUAL LOW VOLTAGE H-BRIDGE IC,SON-12
 | 4 | INA210 | INA210 | SC70-6 | U9, U10, U11, U12 | Voltage
 | 1 | LED0 | LEDCHIPLED_0603 | CHIPLED_0603 | LED1 | LED
 | 1 | LED1 | LEDCHIPLED_0603 | CHIPLED_0603 | LED2 | LED
 | 1 | MAX6001SOT-23 | MAX6001SOT-23 | MAX6001 | U8
 | 1 | MSP432 | MSP432 | PZ100 | U4
 | 1 | RN2483 | RN2483 | RN2483 | U13 | Microchip Low-Power Long Range LoRaTM Technology Transceiver Module
 | 1 | 0.05R | CURRENT_RESISTOR | 4PADS_RESISTOR | RS4
 | 1 | 0.05R | CURRENT_RESISTOR | 4PADS_RESISTOR | RS3
 | 1 | 0.05R | CURRENT_RESISTOR | 4PADS_RESISTOR | RS2
 | 1 | 0.05R | CURRENT_RESISTOR | 4PADS_RESISTOR | RS1
--> search different flash | 1 | SST26VF064B | SST25VF064C | SOIC_8-LEAD | U5
 | 1 | TPS61232 | TPS61232 | S-PVSON-N10 | U1 | Up to 96% Efficiency Synchronous Boost Converter

Sheet: weather_strip_v1bom
ORDERED | Qty | Value | Device | Package | Parts | Description | MPN | OC_FARNELL | OC_NEWARK | PACKAGE | Digikey | (QTY: for 4 boards)
 | 1 |  | PINHD-1X5 | 1X05 | JP1 | PIN HEADER |  |  |  |  | TI samples
 |  |  |  |  |  |  |  |  |  |  | more qty needed |  | more qty ordered
 | 4 | 100n | C-EUC0603 | C0603 | C3, C4, C11 | CAPACITOR, European symbol |  |  |  |  | available in the lab
 | 1 | 10k | R-EU_R0603 | R0603 | R1 | RESISTOR, European symbol |  |  |  |  | similar available in the lab
 | 1 | 10u | CPOL-EUA/3216-18R | A/3216-18R | C12 | POLARIZED CAPACITOR, European symbol |  |  |  |  | not on digikey
 | 1 | 1nF | 1NF/1000PF-50V-10%(0603) | 0603-CAP | C1 | CAP-07886 |  |  |  |  | Mouser
reordered 3 | 1 | BMP180 | BMP180 | BMP180 | U9 | BOSCH BMP180 DIGITAL BAROMETRIC PRESSURE SENSOR
3 pc | 1 | MCP3425 | MCP3425 | SOT-23-6 | U$5
 | 1 | ML8511-UV-SENSOR | ML8511-UV-SENSORSMD | ML8511 | U1
3 pc | 1 | SHT21 | SHT21 | DFN300X300X110-7N | U2 | SENSOR, HUMIDITY & TEMP | SHT21 | 1855468 | 20T1172 | DFN-6

Sheet: EPSv05_BOM
Qty | Value | Device | Package | Parts | Description
4 |  | PINHD-1X2 | 1X02 | JP2, JP3, JP5, JP6 | PIN HEADER
1 |  | PINHD-2X4 | 2X04 | JP1 | PIN HEADER
1 |  | PINHD-2X8 | 2X08 | JP4 | PIN HEADER
2 | 50mOhm | CURRENT_RESISTOR | 4PADS_RESISTOR | R_SENSE |  | p
1 | 10mOhm | CURRENT_RESISTOR | 4PADS_RESISTOR | R_SENSE1 |  | p
1 | 10uF | CPOL-EUA/3216-18R | A/3216-18R | C7 | POLARIZED CAPACITOR, European symbol | p
4 | 1.5uF | C-EUC0603 | C0603 | C1, C2, C8, C9 | CAPACITOR, European symbol | p
7 | 100nF | C-EUC0603 | C0603 | C3, C4, C15, C31, C35, C100, C_IC1 | CAPACITOR, European symbol | p
1 | 10nF | C-EUC0603 | C0603 | C13 | CAPACITOR, European symbol | 100n?
1 | 150pF | C-EUC0603 | C0603 | C24 | CAPACITOR, European symbol | p
4 | 1uF | C-EUC0603 | C0603 | C20, C21, C27, C101 | CAPACITOR, European symbol | p
2 | 2.2uF | C-EUC0603 | C0603 | C22, C23 | CAPACITOR, European symbol | p
1 | 22pF | C-EUC0603 | C0603 | C26 | CAPACITOR, European symbol | p
1 | 22uF | C-EUC0603 | C0603 | C19 | CAPACITOR, European symbol | p
1 | 4.7nF | C-EUC0603 | C0603 | C25 | CAPACITOR, European symbol
1 | 47nF | C-EUC0603 | C0603 | C36 | CAPACITOR, European symbol
7 | 10uF | C-EUC0805 | C0805 | C10, C14, C32, C34, C37, C38, C104 | CAPACITOR, European symbol | p
12 | 22uF | C-EUC0805 | C0805 | C5, C6, C11, C12, C16, C17, C18, C28, C29, C30, C102, C103 | CAPACITOR, European symbol | p
1 | 47uF Tantal | C-EUC1210 | C1210 | C33 | CAPACITOR, European symbol | p
8 | LED | LEDCHIPLED_0603 | CHIPLED_0603 | +3V3_1 | LED | red
5 | CSD16327Q3_DQG_8 | CSD16327Q3_DQG_8 | DQG8 | U1, U2, U3, U10, U11 |  | p
1 | DR127 | DR127 | DR127 | 6.8UH | High Power Density, High Efficiency, Shielded Inductors
1 | 32.768kHz | MS3V-T1R | MS3V-T1R | Q1 |  | p
1 | OPA2333DGK | OPA2333DGK | MSOP08 | IC1 | DUAL 1.8V, microPOWER CMOS OPERATIONAL AMPLIFIERS Zerø-Drift Series | p
1 | 33k | R-EU_R0603 | R0603 | R100 | RESISTOR, European symbol
1 | 165k | R-EU_R0603 | R0603 | R101 | RESISTOR, European symbol | 15+150
1 | 1.5k | R-EU_R0603 | R0603 | R15 | RESISTOR, European symbol | p
6 | 100k | R-EU_R0603 | R0603 | R9, R17, R20, R21, R32, R33 | RESISTOR, European symbol | p
1 | 10k | R-EU_R0603 | R0603 | R19 | RESISTOR, European symbol | p
1 | 150-220k | R-EU_R0603 | R0603 | R37 | RESISTOR, European symbol | p
10 | 1M | R-EU_R0603 | R0603 | R4, R6, R8, R24, R27, R28, R30, R102, R103, R104 | RESISTOR, European symbol | p
11 | 1k | R-EU_R0603 | R0603 | R1, R2, R3, R5, R7, R11, R12, R13, R14, R25, R26 | RESISTOR, European symbol | p
1 | 2.2M 1% | R-EU_R0603 | R0603 | R34 | RESISTOR, European symbol | p
4 | 200k 0.1% | R-EU_R0603 | R0603 | R10, R18, R22, R23 | RESISTOR, European symbol | p
1 | 270k | R-EU_R0603 | R0603 | R35 | RESISTOR, European symbol | p
1 | 4.7k | R-EU_R0603 | R0603 | R16 | RESISTOR, European symbol | p
1 | 470k | R-EU_R0603 | R0603 | R38 | RESISTOR, European symbol | 510k
1 | 47k | R-EU_R0603 | R0603 | R39 | RESISTOR, European symbol | p
2 | 4k7 | R-EU_R0603 | R0603 | R29, R31 | RESISTOR, European symbol | p
1 | 56k | R-EU_R0603 | R0603 | R36 | RESISTOR, European symbol | 68k
1 | 10 | R-EU_R1206 | R1206 | R40 | RESISTOR, European symbol | p
1 | 2 | R-EU_R2012 | R2012 | R41 | RESISTOR, European symbol | -
3 | TPS630250RNCT | TPS630250RNCR | RNC0014A | U6, U7, U100 |  | ?
1 | TPS61088 | TPS61088 | R-PVQFN-N20 | U$1 |  | p
1 | BQ24650_RVA_16 | BQ24650_RVA_16 | RVA16_2P14X2P14 | U9 |  | p
2 | INA213 | INA213 | SC70-6 | U$2, U$3 | Current sensor | p
1 | TPS2022D | TPS2022D | SO8 | U5 | TEXAS INSTRUMENTS - TPS2022D - IC, 1.5A PWR DIST SWITCH 8SOIC | p
1 | BAT54C | BAT54C | SOT23 | D1 | Schottky Diodes | p
1 | BSS123 | BSS123 | SOT23 | Q100 | N-CHANNEL MOS FET
1 | TPS61232 | TPS61232 | S-PVSON-N10 | U8 | Up to 96% Efficiency Synchronous Boost Converter | p
1 | MSP430G2544 | MSP430G2544 | TSSOP38_MSPGXX44_SERIES | U4 | MSP430G2x44
1 | 1.5uH | XFL4020 | XFL4020 | L4
4 | 1uH | XFL4020 | XFL4020 | L1, L2, L3, L100

Sheet: weather_strip_v2bom
ORDERED | Qty | Value | Device | Package | Parts | Description | MPN | OC_FARNELL | OC_NEWARK | PACKAGE | Digikey | (QTY: for 4 boards)
 | 1 |  | PINHD-1X5 | 1X05 | JP1 | PIN HEADER |  |  |  |  | TI samples
 |  |  |  |  |  |  |  |  |  |  | more qty needed |  | more qty ordered
 | 4 | 100n | C-EUC0603 | C0603 | C3, C4, C11 | CAPACITOR, European symbol |  |  |  |  | available in the lab
 | 1 | 10k | R-EU_R0603 | R0603 | R1 | RESISTOR, European symbol |  |  |  |  | similar available in the lab
 | 1 | 10u | CPOL-EUA/3216-18R | A/3216-18R | C12 | POLARIZED CAPACITOR, European symbol |  |  |  |  | not on digikey
 | 1 | 1nF | 1NF/1000PF-50V-10%(0603) | 0603-CAP | C1 | CAP-07886 |  |  |  |  | Mouser
reordered 3 | 1 | BMP180 | BMP180 | BMP180 | U9 | BOSCH BMP180 DIGITAL BAROMETRIC PRESSURE SENSOR
3 pc | 1 | MCP3425 | MCP3425 | SOT-23-6 | U$5
 | 1 | ML8511-UV-SENSOR | ML8511-UV-SENSORSMD | ML8511 | U1
3 pc | 1 | SHT21 | SHT21 | DFN300X300X110-7N | U2 | SENSOR, HUMIDITY & TEMP | SHT21 | 1855468 | 20T1172 | DFN-6
BOM weather strip board v2
BOARD PANNEL 1 |  |  |  |  | BOARD PANNEL 2
Part | Value | Package | Library |  | Part | Value | Package | Library
C15 | 1n | 0603-CAP | SparkFun-Capacitors |  | C31 | 1n | 0603-CAP | SparkFun-Capacitors
C16 | 100n | 0603-CAP | SparkFun-Capacitors |  | C32 | 100n | 0603-CAP | SparkFun-Capacitors
C17 | 100n | C0603 | rcl |  | C33 | 100n | C0603 | rcl
C18 | 100n | C0603 | rcl |  | C34 | 100n | C0603 | rcl
C19 | 100n | C0603 | rcl |  | C35 | 100n | C0603 | rcl
C20 | 100n | C0603 | rcl |  | C36 | 100n | C0603 | rcl
C21 | 100n | C0603 | rcl |  | C37 | 100n | C0603 | rcl
C22 | 12p | C0603 | rcl |  | C38 | 12p | C0603 | rcl
C23 | 12p | C0603 | rcl |  | C39 | 12p | C0603 | rcl
C24 | 100n + 10n | C0603 | rcl |  | C40 | 100n + 10n | C0603 | rcl
C25 | 670p | C0603 | rcl |  | C41 | 670p | C0603 | rcl
C26 | 270p | C0603 | rcl |  | C42 | 270p | C0603 | rcl
C27 | 10u | C0603 | rcl |  | C43 | 10u | C0603 | rcl
C28 | 1u | C0603 | rcl |  | C44 | 1u | C0603 | rcl
C29 | 100n | C0603 | rcl |  | C45 | 100n | C0603 | rcl
C30 | 10uF | EIA3216 | SparkFun-Retired |  | C46 | 10uF | EIA3216 | SparkFun-Retired
L1 | 100uH | COILCRAFT | AS3935 |  | L2 | 100uH | COILCRAFT | AS3935
Q4 | 32.768kHz | FC-12M | crystal |  | Q5 | 32.768kHz | FC-12M | crystal
R30 | 10k | R0603 | resistor |  | R34 | 10k | R0603 | resistor
R31 | 10k | R0603 | rcl |  | R35 | 10k | R0603 | rcl
R32 | 10k | R0603 | rcl |  | R36 | 10k | R0603 | rcl
R33 | 10k | R0603 | resistor |  | R37 | 10k | R0603 | resistor
U1 | BMP180 | BMP180 | SparkFun-Sensors |  | U7 | SHT21 | DFN300X300X110-7N | SENSIRION-SHT21
U2 | SHT21 | DFN300X300X110-7N | SENSIRION-SHT21 |  | U8 | BMP180 | BMP180 | SparkFun-Sensors
U3 | ML8511-UV-SENSORSMD | ML8511 | SparkFun-Sensors |  | U4 | MCP3425 | SOT-23-6 | phMeter
U4 | MCP3425 | SOT-23-6 | phMeter |  | U3 | ML8511-UV-SENSORSMD | ML8511 | SparkFun-Sensors
U5 | BNO055A | BNO055 | BNO055 |  | U11 | AS3935 | 16LDMLPQ | AS3935
U6 | AS3935 | 16LDMLPQ | AS3935 |  | U12 | BNO055A | BNO055 | BNO055

Sheet: aria
 | 120 | 1 inch header |  | Digikey | (QTY: for 1 boards)
digi | 100 | 2mm header |  | TI samples
 |  | BAT-CR1220 |  | more qty needed
 |  | MISCRO-SD |  | available in the lab
 |  | 100n | C-EUC0603 | similar available in the lab
 |  |  |  | not on digikey

Sheet: resistorcap in folder
Available Kit components
 | No. | Description | Spec | Item (25pcs/item) | Amount | Additionnal values in separate strips | Additionnal values in stock
 | Resistor |  |  |  |  |  | 0.01 5%
 | 1 | YAGEO R0603,0Ω±5% | RC0603 JR-07 0R | 4 | 100 |  | 0.05 1%
 | 2 | YAGEO R0603,1Ω±5% | RC0603 JR-07 1R | 2 | 50
 | 3 | YAGEO R0603,1.2Ω±5% | RC0603 JR-07 1R2 | 2 | 50
 | 4 | YAGEO R0603,1.5Ω±5% | RC0603 JR-07 1R5 | 2 | 50
 | 5 | YAGEO R0603,2Ω±5% | RC0603 JR-07 2R | 2 | 50
 | 6 | YAGEO R0603,2.7Ω±5% | RC0603 JR-07 2R7 | 2 | 50
 | 7 | YAGEO R0603,3.3Ω±5% | RC0603 JR-07 3R3 | 2 | 50
 | 8 | YAGEO R0603,4.3Ω±5% | RC0603 JR-07 4R3 | 2 | 50
 | 9 | YAGEO R0603,5.1Ω±5% | RC0603 JR-07 5R1 | 2 | 50
 | 10 | YAGEO R0603,6.8Ω±5% | RC0603 JR-07 6R8 | 2 | 50
 | 11 | YAGEO R0603,8.2Ω±5% | RC0603 JR-07 8R2 | 2 | 50
 | 12 | YAGEO R0603,10Ω±5% | RC0603 JR-07 10R | 2 | 50
 | 13 | YAGEO R0603,12Ω±5% | RC0603 JR-07 12R | 2 | 50
 | 14 | YAGEO R0603,15Ω±5% | RC0603 JR-07 15R | 2 | 50
 | 15 | YAGEO R0603,20Ω±5% | RC0603 JR-07 20R | 2 | 50 | 22R
 | 16 | YAGEO R0603,27Ω±5% | RC0603 JR-07 27R | 2 | 50 | 30R
 | 17 | YAGEO R0603,33Ω±5% | RC0603 JR-07 33R | 2 | 50 | 39R
 | 18 | YAGEO R0603,43Ω±5% | RC0603 JR-07 43R | 2 | 50
 | 19 | YAGEO R0603,51Ω±5% | RC0603 JR-07 51R | 2 | 50 | 56R
 | 20 | YAGEO R0603,68Ω±5% | RC0603 JR-07 68R | 2 | 50 | 75R
 | 21 | YAGEO R0603,82Ω±5% | RC0603 JR-07 82R | 2 | 50 | 91R
 | 22 | YAGEO R0603,100Ω±5% | RC0603 JR-07 100R | 2 | 50
 | 23 | YAGEO R0603,120Ω±5% | RC0603 JR-07 120R | 2 | 50
 | 24 | YAGEO R0603,150Ω±5% | RC0603 JR-07 150R | 2 | 50
 | 25 | YAGEO R0603,200Ω±5% | RC0603 JR-07 200R | 2 | 50 | 220R
 | 26 | YAGEO R0603,270Ω±5% | RC0603 JR-07 270R | 2 | 50 | 300R
 | 27 | YAGEO R0603,330Ω±5% | RC0603 JR-07 330R | 2 | 50 | 390R
 | 28 | YAGEO R0603,430Ω±5% | RC0603 JR-07 430R | 2 | 50 | 470R
 | 29 | YAGEO R0603,510Ω±5% | RC0603 JR-07 510R | 2 | 50 | 560R
 | 30 | YAGEO R0603,680Ω±5% | RC0603 JR-07 680R | 2 | 50 | 750R
 | 31 | YAGEO R0603,820Ω±5% | RC0603 JR-07 820R | 2 | 50 | 910R
 | 32 | YAGEO R0603,1KΩ±5% | RC0603 JR-07 1K | 4 | 100
 | 33 | YAGEO R0603,1.2KΩ±5% | RC0603 JR-07 1K2 | 2 | 50
 | 34 | YAGEO R0603,1.5KΩ±5% | RC0603 JR-07 1K5 | 2 | 50
 | 35 | YAGEO R0603,2KΩ±5% | RC0603 JR-07 2K | 2 | 50 | 2K2
 | 36 | YAGEO R0603,2.7KΩ±5% | RC0603 JR-07 2K7 | 2 | 50 | 3K
 | 37 | YAGEO R0603,3.3KΩ±5% | RC0603 JR-07 3K3 | 2 | 50 | 3K9
 | 38 | YAGEO R0603,4.3KΩ±5% | RC0603 JR-07 4K3 | 2 | 50 | 4K7
 | 39 | YAGEO R0603,5.1KΩ±5% | RC0603 JR-07 5K1 | 2 | 50 | 5k6
 | 40 | YAGEO R0603,6.8KΩ±5% | RC0603 JR-07 6K8 | 2 | 50 | 7k5
 | 41 | YAGEO R0603,8.2KΩ±5% | RC0603 JR-07 8K2 | 2 | 50 | 9k1
 | 42 | YAGEO R0603,10KΩ±5% | RC0603 JR-07 10K | 4 | 100
 | 43 | YAGEO R0603,12KΩ±5% | RC0603 JR-07 12K | 2 | 50
 | 44 | YAGEO R0603,15KΩ±5% | RC0603 JR-07 15K | 2 | 50
 | 45 | YAGEO R0603,20KΩ±5% | RC0603 JR-07 20K | 2 | 50 | 22k
 | 46 | YAGEO R0603,27KΩ±5% | RC0603 JR-07 27K | 2 | 50 | 30k
 | 47 | YAGEO R0603,33KΩ±5% | RC0603 JR-07 33K | 2 | 50 | 39k
 | 48 | YAGEO R0603,43KΩ±5% | RC0603 JR-07 43K | 2 | 50 | 47k
 | 49 | YAGEO R0603,51KΩ±5% | RC0603 JR-07 51K | 2 | 50 | 56k
 | 50 | YAGEO R0603,68KΩ±5% | RC0603 JR-07 68K | 2 | 50 | 75k
 | 51 | YAGEO R0603,82KΩ±5% | RC0603 JR-07 82K | 2 | 50 | 91k
 | 52 | YAGEO R0603,100KΩ±5% | RC0603 JR-07 100K | 2 | 50
 | 53 | YAGEO R0603,120KΩ±5% | RC0603 JR-07 120K | 1 | 25
 | 54 | YAGEO R0603,150KΩ±5% | RC0603 JR-07 150K | 1 | 25
 | 55 | YAGEO R0603,200KΩ±5% | RC0603 JR-07 200K | 1 | 25 | 220k
 | 56 | YAGEO R0603,270KΩ±5% | RC0603 JR-07 270K | 1 | 25 | 300k
 | 57 | YAGEO R0603,330KΩ±5% | RC0603 JR-07 330K | 1 | 25 | 390k
 | 58 | YAGEO R0603,430KΩ±5% | RC0603 JR-07 430K | 1 | 25 | 470k
 | 59 | YAGEO R0603,510KΩ±5% | RC0603 JR-07 510K | 1 | 25 | 560k
 | 60 | YAGEO R0603,680KΩ±5% | RC0603 JR-07 680K | 1 | 25 | 750k
 | 61 | YAGEO R0603,820KΩ±5% | RC0603 JR-07 820K | 1 | 25 | 910k
 | 62 | YAGEO R0603,1MΩ±5% | RC0603 JR-07 1M | 1 | 25
 | 63 | YAGEO R0603,2MΩ±5% | RC0603 JR-07 2M | 1 | 25
 | Capacitor
 | 1 | SAMSUNG/muRata C0603,15pF±5% 50V C0G | C0603 15pF | 1 | 25 |  | 12p
 | 2 | SAMSUNG/muRata C0603,22pF±5% 50V C0G | C0603 22pF | 4 | 100
 | 3 | SAMSUNG/muRata C0603,27pF±5% 50V C0G | C0603 27pF | 2 | 50
 | 4 | SAMSUNG/muRata C0603,33pF±5% 50V C0G | C0603 33pF | 2 | 50
 | 5 | SAMSUNG/muRata C0603,47pF±5% 50V C0G | C0603 47pF | 1 | 25
 | 6 | SAMSUNG/muRata C0603,68pF±5% 50V C0G | C0603 68pF | 1 | 25
 | 7 | SAMSUNG/muRata C0603,82pF±5% 50V C0G | C0603 82pF | 1 | 25
 | 8 | SAMSUNG/muRata C0603,100pF±5% 50V C0G | C0603 100pF | 2 | 50
 | 9 | SAMSUNG/muRata C0603,120pF±5% 50V C0G | C0603 120pF | 1 | 25
 | 10 | SAMSUNG/muRata C0603,150pF±5% 50V C0G | C0603 150pF | 1 | 25
 | 11 | SAMSUNG/muRata C0603,180pF±5% 50V C0G | C0603 180pF | 1 | 25
 | 12 | SAMSUNG/muRata C0603,220pF±10% 50V X7R | C0603 220pF | 1 | 25
 | 13 | SAMSUNG/muRata C0603,1nF±10% 50V X7R | C0603 1nF | 1 | 25 |  | 2.2n
 | 14 | SAMSUNG/muRata C0603,10nF±10% 25V X7R | C0603 10nF | 1 | 25 |  | 33n
 | 15 | SAMSUNG/muRata C0603,100nF±10% 16V X7R | C0603 100nF | 4 | 100 |  | 220n
 | 16 | SAMSUNG/muRata C0603,470nF±10% 16V X7R | C0603 470nF | 2 | 50 |  | 150n
 | 17 | SAMSUNG/muRata C0603,1uF±10% 10V X5R | C0603 1uF | 2 | 50
 |  |  |  |  |  |  | 4.7u
 |  |  |  |  |  |  | 10u (603) | 10u (tantalum 1201)
 |  |  |  |  |  |  | 22u
