Octanis1/Octanis1-Electronics/octanis_eps/BOM EPS octanis1.xlsx

BOM EPS Octanis1
Active components
Reference | Unit Price (CHF) | Qty | Total price | Manufacturer | Package | Provider | Description
TPS62086RLTT | 6.35 | 1 | 6.35 | TI | VQFN-7 | Farnell | 3.3V 3A buck converter (discharge)
LTC3402EMS#PBF | 11.1 | 1 | 11.1 | Linear Devices | MSOP10 | Farnell | Adjustable boost converter 2A (charge
MSP430G2744IDA38R | 2.85 | 1 | 2.85 | TI | TSSOP38 | TI | MCU
INA213AIDCKT | 1.7 | 2 | 3.4 | TI | SC70-6 | Farnell | Gain 50 current sensor 35µA polarization
TPS2022D | 3.5 | 3 | 10.5 | TI | SOIC8 | Farnell | 1.5A distribution switch
ADR127BUJZ-REEL7 | 10.15 | 1 | 10.15 | Analog Devices | TSOT23-6 | Farnell | Precision 1.25V voltage reference
OPA2333AIDGKT | 3.6 | 4 | 14.4 | TI | MSOP8 | Farnell | Low power OPA 2 channels
FDV301N | 0.038 | 3 | 0.114 | Farichild | SOT-23 | Farnell | N canal MOSFET
IRLL024NPBF | 1.25 | 3 | 3.75 | IR | SOT-223 | Farnell | N hexfet 2V threshold
MJD44H11T4 | 0.713 | 1 | 0.713 | ST micro | TO-252 | Farnell | BJT
Reference | Unit Price (CHF) | Qty | Total price | Manufacturer | Package | Provider | Description
1kOhm | 0.015 | 3 | 0.045 | - | 603 | Farnell
50mOhm 0.1% | 0.1 | 3 | 0.3 | - | 1206 | Farnell | current shunts precision resistor
10kOhm 0.1% | 0.03 | 6 | 0.18 | - | 603 | Farnell
100kOhm | 0.015 | 5 | 0.075 | - | 603 | Farnell
200kOhm | 0.015 | 5 | 0.075 | - | 603 | Farnell
147kOhm 0.1% | 0.03 | 1 | 0.03 | - | 603 | Farnell
953Ohm 0.1% | 0.03 | 1 | 0.03 | - | 603 | Farnell
86k6Ohm 0.1% | 0.5 | 1 | 0.5 | - | 603 | Farnell
4k02Ohm 0.1% | 0.5 | 1 | 0.5 | - | 603 | Farnell
560kOhm 0.1% | 0.1 | 2 | 0.2 | - | 603 | Farnell
3k32Ohm 0.1% | 0.5 | 1 | 0.5 | - | 603 | Farnell
30k1Ohm 0.1% | 0.5 | 1 | 0.5 | - | 603 | Farnell
1.3MOhm 0.1% | 0.5 | 1 | 0.5 | - | 603 | Farnell
549kOhm 0.1% | 0.5 | 1 | 0.5 | - | 603 | Farnell
82kOhm 0.1% | 0.5 | 1 | 0.5 | - | 603 | Farnell
1MOhm | 0.015 | 6 | 0.09 | - | 603 | Farnell
162kOhms 1% | 0.015 | 3 | 0.045 |  | 603 | Farnell
20kOhms 0.11% | 0.03 | 1 | 0.03 |  | 603 | Farnell
23.2kOhms 0.1% | 0.03 | 1 | 0.03 |  | 603 | Farnell
31.60kOhms 0.1% | 0.03 | 1 | 0.03 |  | 603 | Farnell
920kOhms 0.1% | 0.03 | 1 | 0.03 |  | 603 | Farnell
MBRM120LT1G | 0.9 | 3 | 2.7 | - | D0216AA | Farnell | shottky
150nF | 0.03 | 4 | 0.12 | - | 603 | Farnell
100nF | 0.03 | 10 | 0.3 | - | 603 | Farnell
10nF | 0.03 | 10 | 0.3 | - | 603 | Farnell
12pF 1% | 0.5 | 2 | 1 | - | 603 | Farnell
10uF | 0.5 | 1 | 0.5 | - | A/3216-18R | Farnell | polarized capacitor
22uF | 0.5 | 1 | 0.5 | - | A/3216-18R | Farnell | polarized capacitor
470pF | 0.003 | 1 | 0.003 | - | 603 | Farnell
4.7pF | 0.003 | 1 | 0.003 | - | 603 | Farnell
4.7uF | 0.5 | 1 | 0.5 | - | 1206 | Farnell | X5R or X7R family recommended
22uF | 0.5 | 2 | 1 | - | 603 | Farnell | X5R or X7R family recommended
10uF | 0.5 | 2 | 1 | - | 1206 | Farnell | X5R or X7R family recommended
10uH | 1.25 | 1 | 1.25 | Coiltronics | DR127 | Farnell | Power inductor 10uH
DR127-R47-R. | 1.2 | 1 | 1.2 | Coiltronics | DR128 | Farnell | Power inductor 0.47uH
32Mhz crystal | 0.5 | 1 | 0.5 | - | FC-12M | Farnell | Crystal
 |  | Total | 78.893
