Octanis1/Octanis1-Electronics/MSP-EXP432P401R Hardware Design Files/Hardware/MSP-EXP432P401R_BOM.xlsx

BOM for MSP-EXP432P401R
Do not populate (Dnp) part if Quantity equals zero
Use exact PartNumber and Manufacturer if this data is provided
Feedback from CM needed where supplier equals CM
 | Qty | Reference | Manufacturer | Description | Part Number | PCB Decal/Package | Value | Supplier1 | Digikey Number | Comment
 | 1 | C1 | Standard | CAP CER 0.1UF 10V 20% X5R 0402,Digikey 445-4984-1-ND |  | 402 | 100n | Digikey | 445-4984-1-ND
 | 1 | C2 | Standard | CAP CER 0.1UF 10V 20% X5R 0402,Digikey 445-4984-1-ND |  | 402 | 100n | Digikey | 445-4984-1-ND
 | 1 | C3 | Standard | CAP TANT 10UF 10V 20% 1206,Digikey 493-2351-1-ND |  | TANT_3216 | 10u | Digikey | 493-2351-1-ND
 | 1 | C4 | Standard | CAP CER 0.1UF 10V 20% X5R 0402,Digikey 445-4984-1-ND |  | 402 | 100n | Digikey | 445-4984-1-ND
 | 1 | C5 | Standard | CAP CER 12PF 50V 5% NP0 0402,Digikey 445-1236-1-ND |  | 402 | 12p | Digikey | 445-1236-1-ND
 | 1 | C6 | Standard | CAP CER 12PF 50V 5% NP0 0402,Digikey 445-1236-1-ND |  | 402 | 12p | Digikey | 445-1236-1-ND
 | 1 | C7 | Standard | CAP CER 0.1UF 10V 20% X5R 0402,Digikey 445-4984-1-ND |  | 402 | 100n | Digikey | 445-4984-1-ND
 | 1 | C8 | Standard | CAP CER 0.1UF 10V 20% X5R 0402,Digikey 445-4984-1-ND |  | 402 | 100n | Digikey | 445-4984-1-ND
 | 1 | C9 | Standard | CAP CER 0.1UF 10V 20% X5R 0402,Digikey 445-4984-1-ND |  | 402 | 100n | Digikey | 445-4984-1-ND
 | 1 | C10 | Standard | CAP CER 4.7UF 10V Y5V 0805, Digikey 445-1370-1-ND |  | 805 | 4.7u | Digikey | 445-1370-1-ND
 | 1 | C11 | Standard | CAP CER 22PF 50V 5% NP0 0402, Digikey 445-1239-1-ND |  | 402 | 22p | Digikey | 445-1239-1-ND
 | 1 | C12 | Standard | CAP CER 22PF 50V 5% NP0 0402, Digikey 445-1239-1-ND |  | 402 | 22p | Digikey | 445-1239-1-ND
 | 1 | C13 | Standard | CAP CER 1000PF 50V 10% X7R 0402,Digikey 445-1256-1-ND |  | 402 | 1n | Digikey | 445-1256-1-ND
 | 1 | C14 | Standard | CAP CER 0.1UF 10V 20% X5R 0402,Digikey 445-4984-1-ND |  | 402 | 100n | Digikey | 445-4984-1-ND
 | 1 | C101 | Standard | CAP CER 12PF 50V 5% NP0 0402,Digikey 445-1236-1-ND |  | 402 | 12p | Digikey | 445-1236-1-ND
 | 1 | C102 | Standard | CAP CER 12PF 50V 5% NP0 0402,Digikey 445-1236-1-ND |  | 402 | 12p | Digikey | 445-1236-1-ND
 | 1 | C103 | Standard | CAP CER 0.1UF 10V 20% X5R 0402,Digikey 445-4984-1-ND |  | 402 | 100n | Digikey | 445-4984-1-ND
 | 1 | C104 | Standard | CAP CER 10000PF 10V 10% X7R 0402, Digikey 478-7890-1-ND |  | 402 | 10n | Digikey | 478-7890-1-ND
 | 1 | C105 | Standard | CAP CER 2.2UF 10V 10% X5R 0603, Digikey 587-1253-1-ND |  | 603 | 2.2u | Digikey | 587-1253-1-ND
 | 1 | C106 | Standard | CAP TANT 4.7UF 10V 10% 1206,Digikey 478-8221-1-ND |  | TANT_3216 | 4.7u | Digikey | 478-8221-1-ND
 | 1 | C107 | Standard | CAP CER 1UF 10V 10% X5R 0603, Digikey 445-1321-1-ND |  | 603 | 1u | Digikey | 445-1321-1-ND
 | 0 | C108 | Standard |  |  | 402 | dnp
 | 1 | C109 | Standard | CAP CER 10000PF 10V 10% X7R 0402, Digikey 478-7890-1-ND |  | 402 | 10n | Digikey | 478-7890-1-ND
 | 1 | C110 | Standard | CAP CER 10000PF 10V 10% X7R 0402, Digikey 478-7890-1-ND |  | 402 | 10n | Digikey | 478-7890-1-ND
 | 1 | C111 | Standard | CAP CER 0.1UF 10V 20% X5R 0402,Digikey 445-4984-1-ND |  | 402 | 100n | Digikey | 445-4984-1-ND
 | 1 | C112 | Standard | CAP CER 10000PF 10V 10% X7R 0402, Digikey 478-7890-1-ND |  | 402 | 10n | Digikey | 478-7890-1-ND
 | 1 | C113 | Standard | CAP CER 0.1UF 10V 20% X5R 0402,Digikey 445-4984-1-ND |  | 402 | 100n | Digikey | 445-4984-1-ND
 | 1 | C114 | Standard | CAP CER 10000PF 10V 10% X7R 0402, Digikey 478-7890-1-ND |  | 402 | 10n | Digikey | 478-7890-1-ND
 | 1 | C115 | Standard | CAP CER 33PF 50V 5% NP0 0402,Digikey 445-1241-1-ND |  | 402 | 33p | Digikey | 445-1241-1-ND
 | 1 | C116 | Standard | CAP CER 33PF 50V 5% NP0 0402,Digikey 445-1241-1-ND |  | 402 | 33p | Digikey | 445-1241-1-ND
 | 1 | C117 | Standard | CAP CER 4.7UF 10V 10% X5R 0603,Digikey 445-5170-1-ND |  | 603 | 4.7u | Digikey | 445-5170-1-ND
 | 1 | C118 | Standard | CAP CER 0.1UF 10V 20% X5R 0402,Digikey 445-4984-1-ND |  | 402 | 100n | Digikey | 445-4984-1-ND
 | 1 | C119 | TDK | CAP CER 4.7UF 10V 10% X5R 0603, Digikey 445-5170-1-ND | C1608X5R1A475K080AC | 603 | 4.7u | Digikey | 445-5170-1-ND
 | 1 | C120 | Standard | CAP CER 0.1UF 10V 20% X5R 0402,Digikey 445-4984-1-ND |  | 402 | 100n | Digikey | 445-4984-1-ND
 | 1 | C121 | Standard | CAP CER 0.1UF 10V 20% X5R 0402,Digikey 445-4984-1-ND |  | 402 | 100n | Digikey | 445-4984-1-ND
 | 1 | C122 | Standard | CAP CER 10000PF 10V 10% X7R 0402, Digikey 478-7890-1-ND |  | 402 | 10n | Digikey | 478-7890-1-ND
 | 1 | C123 | Standard | CAP CER 10000PF 10V 10% X7R 0402, Digikey 478-7890-1-ND |  | 402 | 10n | Digikey | 478-7890-1-ND
 | 1 | C124 | Standard | CAP CER 0.1UF 10V 20% X5R 0402,Digikey 445-4984-1-ND |  | 402 | 100n | Digikey | 445-4984-1-ND
 | 1 | C125 | Standard | CAP CER 10000PF 10V 10% X7R 0402, Digikey 478-7890-1-ND |  | 402 | 10n | Digikey | 478-7890-1-ND
 | 1 | C126 | Standard | CAP CER 0.22UF 16V 10% X5R 0402,Digikey 445-4972-1-ND |  | 402 | 220n | Digikey | 445-4972-1-ND
 | 1 | C127 | Standard | CAP CER 0.22UF 16V 10% X5R 0402,Digikey 445-4972-1-ND |  | 402 | 220n | Digikey | 445-4972-1-ND
 | 1 | C128 | Standard | CAP CER 47UF 10V 20% X5R 1206, Digikey 445-6006-1-ND |  | TANT_3216 | 47u | Digikey | 445-6006-1-ND
 | 1 | C129 | Standard | CAP CER 0.1UF 10V 20% X5R 0402,Digikey 445-4984-1-ND |  | 402 | 100n | Digikey | 445-4984-1-ND
 | 1 | C130 | Standard | CAP CER 1UF 10V 10% X5R 0603, Digikey 445-1321-1-ND |  | 603 | 1u | Digikey | 445-1321-1-ND
 | 1 | C131 | Standard | CAP CER 0.1UF 10V 20% X5R 0402,Digikey 445-4984-1-ND |  | 402 | 100n | Digikey | 445-4984-1-ND
 | 1 | C132 | Standard | CAP CER 1UF 10V 10% X5R 0603, Digikey 445-1321-1-ND |  | 603 | 1u | Digikey | 445-1321-1-ND
 | 1 | C133 | Standard | CAP CER 2.2UF 10V 10% X5R 0603, Digikey 587-1253-1-ND |  | 603 | 2.2u | Digikey | 587-1253-1-ND
 | 1 | C134 | Standard | CAP CER 0.1UF 10V 20% X5R 0402,Digikey 445-4984-1-ND |  | 402 | 100n | Digikey | 445-4984-1-ND
 | 1 | C135 | Standard | CAP CER 0.1UF 10V 20% X5R 0402,Digikey 445-4984-1-ND |  | 402 | 100n | Digikey | 445-4984-1-ND
 | 1 | C136 | Standard | CAP CER 0.1UF 10V 20% X5R 0402,Digikey 445-4984-1-ND |  | 402 | 100n | Digikey | 445-4984-1-ND
 | 1 | C137 | Standard | CAP CER 2.2UF 10V 10% X5R 0603, Digikey 587-1253-1-ND |  | 603 | 2.2u | Digikey | 587-1253-1-ND
 | 1 | C138 | Standard | CAP CER 0.1UF 10V 20% X5R 0402,Digikey 445-4984-1-ND |  | 402 | 100n | Digikey | 445-4984-1-ND
 | 1 | C139 | Standard | CAP CER 2.2UF 10V 10% X5R 0603, Digikey 587-1253-1-ND |  | 603 | 2.2u | Digikey | 587-1253-1-ND
 | 1 | C140 | Standard | CAP TANT 4.7UF 10V 10% 1206,Digikey 478-8221-1-ND |  | TANT_3216 | 4.7u | Digikey | 478-8221-1-ND
 | 1 | C141 | Standard | CAP CER 1UF 10V 10% X5R 0603, Digikey 445-1321-1-ND |  | 603 | 1u | Digikey | 445-1321-1-ND
 | 1 | C142 | Standard | CAP CER 0.1UF 10V 20% X5R 0402,Digikey 445-4984-1-ND |  | 402 | 100n | Digikey | 445-4984-1-ND
 | 1 | C143 | Standard | CAP CER 0.1UF 10V 20% X5R 0402,Digikey 445-4984-1-ND |  | 402 | 100n | Digikey | 445-4984-1-ND
 | 1 | C144 | Standard | CAP CER 2.2UF 10V 10% X5R 0603, Digikey 587-1253-1-ND |  | 603 | 2.2u | Digikey | 587-1253-1-ND
 | 1 | C145 | Standard | CAP CER 10000PF 10V 10% X7R 0402, Digikey 478-7890-1-ND |  | 402 | 10n | Digikey | 478-7890-1-ND
 | 1 | C146 | Standard | CAP CER 10000PF 10V 10% X7R 0402, Digikey 478-7890-1-ND |  | 402 | 10n | Digikey | 478-7890-1-ND
 | 1 | C147 | Standard | CAP CER 10000PF 10V 10% X7R 0402, Digikey 478-7890-1-ND |  | 402 | 10n | Digikey | 478-7890-1-ND
 | 1 | C148 | Standard | CAP CER 10000PF 10V 10% X7R 0402, Digikey 478-7890-1-ND |  | 402 | 10n | Digikey | 478-7890-1-ND
 | 1 | C149 | Standard | CAP CER 0.1UF 10V 20% X5R 0402,Digikey 445-4984-1-ND |  | 402 | 100n | Digikey | 445-4984-1-ND
 | 1 | D101 | NXP | DIODE SCHOTTKY 40V 120MA TO236AB,Digikey 568-4862-1-ND | BAS40-05 215 | SOT-23 | BAS40-05 | Digikey | 568-4862-1-ND
 | 1 | D102 | NXP | DIODE SCHOTTKY 40V 120MA TO236AB,Digikey 568-4862-1-ND | BAS40-05 215 | SOT-23 | BAS40-05 | Digikey | 568-4862-1-ND
 | 1 | IC101 | TI | IC REG LDO 3.3V 0.5A 8SON,Digikey 296-24854-1-ND | TPS73533DRB |  | TPS73533DRB | Digikey | 296-24854-1-ND
 | 1 | IC102 | TI | IC 4CH ESD-PROT ARRAY 6-SON,Digikey 296-23618-1-ND | TPD4E004DRY | USON | TPD4E004DRY | Digikey | 296-23618-1-ND
 | 1 | IC103 | TI | IC OR CTRLR SRC SELECT SOT23-5, Digikey 296-10880-1-ND | TPS2012DBV | SOT23-5 | TPS2012DBV | Digikey | 296-10880-1-ND
 | 1 | IC104 | TI | IC REG LDO 1.8V 0.2A 6WSON, Digikey 296-25213-1-ND | TLV70018DSE | WSON6 | TPS73533DRB | Digikey | 296-25213-1-ND
 | 1 | IC105 | TI | IC TXRX USB 2.0 ULPI 32QFN, Digikey 296-28545-1-ND | TUSB1210RHB | USON | TPD4E004DRY | Digikey | 296-28545-1-ND
 | 1 | IC106 | TI | IC MCU 32BIT | TM4C1294NCPDT |  | TM4C1294NCPDT | Digikey | 296-38028-ND
 | 1 | IC107 | TI | IC VREF SHUNT PREC 2.5V SC-70-5, Digikey 296-20873-1-ND | LM4040B25DCK | SC70-5 | LM4040B25DCK | Digikey | 296-20873-1-ND
 | 1 | IC108 | TI | IC BUS TRANSCVR 4BIT 16-UQFN, Digikey 296-24366-1-ND | SN74AVC4T245RSV | UQFN-16 | SN74AVC4T245RSV | Digikey | 296-24366-1-ND
 | 1 | IC109 | TI | IC BUS TRANSCVR 4BIT 16-UQFN, Digikey 296-24366-1-ND | SN74AVC4T245RSV | UQFN-16 | SN74AVC4T245RSV | Digikey | 296-24366-1-ND
 | 1 | IC110 | TI | IC BUS TRANSCVR 4BIT 16-UQFN, Digikey 296-24366-1-ND | SN74AVC4T245RSV | UQFN-16 | SN74AVC4T245RSV | Digikey | 296-24366-1-ND
 | 1 | IC111 | TI | IC 4BIT 1-4 FET MUX/DEMUX 16UQFN, Digikey 296-35586-1-ND | SN74CBTLV3257 | UQFN-16 | SN74CBTLV3257 | Digikey | 296-35586-1-ND
 | 1 | J1/J3 | CM | CONN HEADER 20POS .100" DUAL, FEMALE with long male leads | CNT-F254-2*10-GS-850-9 | 2X10 |  | CM | to be provided by CM
 | 1 | J2/J4 | CM | CONN HEADER 20POS .100" DUAL, FEMALE with long male leads | CNT-F254-2*10-GS-850-9 | 2X10 |  | CM | to be provided by CM
 | 0 | J5 | Standard | CONN HEADER .100 DUAL STR 40POS,Digikey S2012E-20-ND |  | 0.100 inch x 2 x 20 | dnp | Digikey | S2012E-20-ND
 | 1 | J6 | Standard | CONN HEADER .100 SINGL STR 3POS,Digikey S1012E-03-ND |  | 0.100 inch x 3 |  | Digikey | S1012E-03-ND
 | 1 | J7 | Standard | CONN HEADER .100 SINGL STR 3POS,Digikey S1012E-03-ND |  | 0.100 inch x 3 |  | Digikey | S1012E-03-ND
 | 0 | JP1 | Standard | CONN HEADER 2POS .100" SNGL TIN,Digikey SAM1075-02-ND |  | JP1M | GND | Digikey | SAM1075-02-ND | Part of JPX
 | 1 | JP2 | Standard | CONN HEADER 2POS .100" SNGL TIN,Digikey SAM1075-02-ND |  | JP1M | Place Jumper (+5V) | Digikey | SAM1075-02-ND | Part of JPX
 | 1 | JP3 | Standard | CONN HEADER 2POS .100" SNGL TIN,Digikey SAM1075-02-ND |  | JP1M | Place Jumper (+3V3) | Digikey | SAM1075-02-ND | Part of JPX
 | 1 | JP4.1 | Standard | CONN HEADER 2POS .100" SNGL TIN,Digikey SAM1075-02-ND |  | JP1M | Place Jumper (RTS) | Digikey | SAM1075-02-ND | Part of JPX
 | 1 | JP4.2 | Standard | CONN HEADER 2POS .100" SNGL TIN,Digikey SAM1075-02-ND |  | JP1M | Place Jumper (CTS) | Digikey | SAM1075-02-ND | Part of JPX
 | 1 | JP4.3 | Standard | CONN HEADER 2POS .100" SNGL TIN,Digikey SAM1075-02-ND |  | JP1M | Place Jumper (RXD) | Digikey | SAM1075-02-ND | Part of JPX
 | 1 | JP4.4 | Standard | CONN HEADER 2POS .100" SNGL TIN,Digikey SAM1075-02-ND |  | JP1M | Place Jumper (TXD) | Digikey | SAM1075-02-ND | Part of JPX
 | 0 | JP5.1 | Standard | CONN HEADER 2POS .100" SNGL TIN,Digikey SAM1075-02-ND |  | JP1M | SWCLK | Digikey | SAM1075-02-ND | Part of JPX
 | 0 | JP5.2 | Standard | CONN HEADER 2POS .100" SNGL TIN,Digikey SAM1075-02-ND |  | JP1M | SWTDIO | Digikey | SAM1075-02-ND | Part of JPX
 | 0 | JP5.3 | Standard | CONN HEADER 2POS .100" SNGL TIN,Digikey SAM1075-02-ND |  | JP1M | SWO | Digikey | SAM1075-02-ND | Part of JPX
 | 0 | JP5.4 | Standard | CONN HEADER 2POS .100" SNGL TIN,Digikey SAM1075-02-ND |  | JP1M | RST | Digikey | SAM1075-02-ND | Part of JPX
 | 1 | JP8 | Standard | CONN HEADER .100 SINGL STR 2POS,Digikey S1012E-02-ND |  | 0.100 inch x 2 | Place Jumper | Digikey | S1012E-02-ND
 | 1 | JP9 | Standard | CONN HEADER .100 SINGL STR 2POS,Digikey S1012E-02-ND |  | 0.100 inch x 2 | Place Jumper | Digikey | S1012E-02-ND
 | 1 | JP10 | Standard | CONN HEADER .100 SINGL STR 2POS,Digikey S1012E-02-ND |  | 0.100 inch x 2 | Place Jumper | Digikey | S1012E-02-ND
 | 1 | JP11 | Standard | CONN HEADER .100 SINGL STR 2POS,Digikey S1012E-02-ND |  | 0.100 inch x 2 | Place Jumper | Digikey | S1012E-02-ND
 | 1 | J101 | Hirose Electrical Co | CONN RCPT MICRO USB B SMD R/A, Digikey H11574CT-ND | ZX62R-B-5P | 6x8 mm | ZX62R-B-5P | Digikey | H11574CT-ND
 | 1 | J102 | Standard | CONN HEADER 10POS DUAL VERT, Digikey FTSH-105-01-F-D-K-ND | FTSH-105-01-F-D-K |  |  | Digikey | FTSH-105-01-F-D-K-ND
 | 0 | J103 | Standard |  |  | 0.050 inch x 7 | dnp
 | 1 | L1 | Murata | INDUCTOR 4.7UH 300MA 0806, Digikey 490-4044-1-ND | LQH2MCN4R7M02L | 806 | 4.7uH | Digikey | 490-4044-1-ND
 | 1 | L101 | Taiyo Yuden | 2.2uH, Tayo Yuden CBC2518T2R2M, Digikey 587-1618-1-ND | CBC2518T2R2M | 1007 | 2.2uH | Digikey | 587-1618-1-ND
 | 1 | LED1 | Standard | LED RED CLEAR 0603 SMD,Digikey 160-1181-1-ND |  | 603 | Low Current Red | Digikey | 160-1181-1-ND
 | 1 | LED2 | Everlight | LED RGB CLEAR SMD, Everlight 19-337/R6GHBHC-A01/2T | 19-337/R6GHBHC-A01/2T |  | 19-337 | Everlight | 19-337/R6GHBHC-A01/2T
 | 1 | LED101 | Standard | LED RED CLEAR 0603 SMD,Digikey 160-1181-1-ND |  | 603 | Low Current Red | Digikey | 160-1181-1-ND
 | 1 | LED102 | Standard | LED GREEN CLEAR 0603 SMD,Digikey 160-1183-1-ND |  | 603 | Low Current Green | Digikey | 160-1183-1-ND
 | 1 | MSP1 | TI | IC MCU 32BIT | MSP432P401RIPZ |  |  | #VALUE! | #VALUE!
 | 1 | MSP101 | TI | IC MCU 16BIT 8KB FLASH 16QFN,Digikey 296-28129-1-ND | MSP430G2452RSA | QFN 16 | MSP430G2452RSA | Digikey | 296-28129-1-ND
 | 1 | Q1 | Micro Crystal AG | MICRO CRYSTAL - MS3V-T1R 32.768KHZ 7.0PF +/-20PPM | MS3V-T1R | 6.7 x 1.40 mm | 32.7638 kHz, 7.0pF | Microcrystal | MS3V-T1R 7pF
 | 1 | Q2 | Standard | Crystal KX-7T 48MHz 12pF 30/30/50ppm | Geyer Electronic - 12.88710 |  | 48MHz, 12pF
 | 1 | Q101 | Standard | CRYSTAL 16MHZ 8PF SMD, Digikey 644-1174-1-ND | NX3225GA-16.000M-STD-CRG-1 |  | 16MHz, 8pF | Digikey | 644-1174-1-ND
 | 1 | R1 | Standard | RES 0.0 OHM 1/16W 0402 SMD,Digikey 311-0.0JRTR-ND |  | 402 | 0 | Digikey | 311-0.0JRTR-ND
 | 1 | R2 | Standard | RES 110 OHM 1/16W 1% 0402 SMD,Digikey 311-110LRCT-ND |  | 402 | 110 | Digikey | 311-110LRCT-ND
 | 1 | R3 | Standard | RES 16 OHM 1/10W 5% 0402 SMD, Digikey P16JCT-ND |  | 402 | 16 | Digikey | P16JCT-ND
 | 1 | R4 | Standard | RES 24 OHM 1/16W 5% 0402 SMD, Digikey 311-24JRCT-ND |  | 402 | 24 | Digikey | 311-24JRCT-ND
 | 1 | R5 | Panasonic | RES 91K OHM 1/8W 0.1% 0805 SMD, Digikey P91KDACT-ND | ERA-6AEB913V | 805 | 91kOhm, 0.1%, 25ppm/°C | Digikey | P91KDACT-ND
 | 1 | R6 | Standard | RES 47.0K OHM 1/16W 1% 0402 SMD,Digikey 311-47.0KLRCT-ND |  | 402 | 47k | Digikey | 311-47.0KLRCT-ND
 | 1 | R7 | Standard | RES 470 OHM 1/16W 1% 0402 SMD,Digikey 311-470LRCT-ND |  | 402 | 470 | Digikey | 311-470LRCT-ND
 | 1 | R8 | Standard | RES 1.0K OHM 1/16W 5% 0402 SMD, Digikey 311-1.0KJRCT-ND |  | 402 | 1k | Digikey | 311-1.0KJRCT-ND
 | 0 | R101 | Standard | RES 220K OHM 1/16W 1% 0402 SMD,Digikey 311-220KLRCT-ND |  | 402 | dnp | Digikey | 311-220KLRCT-ND
 | 1 | R102 | Standard | RES 100 OHM 1/16W 1% 0402 SMD, Digikey 311-100LRCT-ND |  | 402 | 100 | Digikey | 311-100LRCT-ND
 | 1 | R103 | Standard | RES 10.0K OHM 1/16W 1% 0402 SMD,Digikey 311-10.0KLRCT-ND |  | 402 | 10k | Digikey | 311-10.0KLRCT-ND
 | 1 | R104 | Standard | RES 51 OHM 1/16W 5% 0402 SMD, Digikey 311-51JRCT-ND |  | 402 | 51 | Digikey | 311-51JRCT-ND
 | 1 | R105 | Standard | RES 1.00K OHM 1/16W 1% 0402 SMD, Digikey 311-1.00KLRCT-ND |  | 402 | 1k | Digikey | 311-1.00KLRCT-ND
 | 1 | R106 | Standard | RES 2.0 OHM 1/16W 5% 0402 SMD, Digikey 311-2.0JRCT-ND |  | 402 | 2 | Digikey | 311-2.0JRCT-ND
 | 1 | R107 | Standard | RES 47.0K OHM 1/16W 1% 0402 SMD,Digikey 311-47.0KLRCT-ND |  | 402 | 47k | Digikey | 311-47.0KLRCT-ND
 | 1 | R108 | Standard | RES 1.0K OHM 1/16W 5% 0402 SMD, Digikey 311-1.0KJRCT-ND |  | 402 | 1k | Digikey | 311-1.0KJRCT-ND
 | 1 | R109 | Standard | RES 1.0K OHM 1/16W 5% 0402 SMD, Digikey 311-1.0KJRCT-ND |  | 402 | 1k | Digikey | 311-1.0KJRCT-ND
 | 1 | R110 | Standard | RES 1.0K OHM 1/16W 5% 0402 SMD, Digikey 311-1.0KJRCT-ND |  | 402 | 1k | Digikey | 311-1.0KJRCT-ND
 | 1 | R111 | Standard | RES 470 OHM 1/16W 1% 0402 SMD,Digikey 311-470LRCT-ND |  | 402 | 470 | Digikey | 311-470LRCT-ND
 | 1 | R112 | Standard | RES 220K OHM 1/16W 1% 0402 SMD,Digikey 311-220KLRCT-ND |  | 402 | 220k | Digikey | 311-220KLRCT-ND
 | 1 | R113 | Standard | RES 220K OHM 1/16W 1% 0402 SMD,Digikey 311-220KLRCT-ND |  | 402 | 220k | Digikey | 311-220KLRCT-ND
 | 1 | R114 | Standard | RES 220K OHM 1/16W 1% 0402 SMD,Digikey 311-220KLRCT-ND |  | 402 | 220k | Digikey | 311-220KLRCT-ND
 | 1 | R115 | Standard | RES 220K OHM 1/16W 1% 0402 SMD,Digikey 311-220KLRCT-ND |  | 402 | 220k | Digikey | 311-220KLRCT-ND
 | 1 | R116 | Standard | RES 4.7K OHM 1/16W 5% 0402 SMD,Digikey 311-4.7KJRCT-ND |  | 402 | 4k7 | Digikey | 311-4.7KJRCT-ND
 | 1 | R117 | Standard | RES 4.7K OHM 1/16W 5% 0402 SMD,Digikey 311-4.7KJRCT-ND |  | 402 | 4k7 | Digikey | 311-4.7KJRCT-ND
 | 1 | R118 | Standard | RES 820 OHM 1/16W 1% 0402 SMD,Digikey 311-820LRCT-ND |  | 402 | 820 | Digikey | 311-820LRCT-ND
 | 1 | R119 | Standard | RES 0.0 OHM 1/16W 0402 SMD,Digikey 311-0.0JRTR-ND |  | 402 | 0 | Digikey | 311-0.0JRTR-ND
 | 1 | R120 | Standard | RES 470 OHM 1/16W 1% 0402 SMD,Digikey 311-470LRCT-ND |  | 402 | 470 | Digikey | 311-470LRCT-ND
 | 0 | R121 | Standard | RES 0.0 OHM 1/16W 0402 SMD,Digikey 311-0.0JRTR-ND |  | 402 | 0 | Digikey | 311-0.0JRTR-ND
 | 0 | R122 | Standard | RES 0.0 OHM 1/16W 0402 SMD,Digikey 311-0.0JRTR-ND |  | 402 | 0 | Digikey | 311-0.0JRTR-ND
 | 1 | R123 | Standard | RES 33 OHM 1/16W 5% 0402 SMD,Digikey 311-33JRCT-ND |  | 402 | 33 | Digikey | 311-33JRCT-ND
 | 1 | R124 | Standard | RES 470 OHM 1/16W 1% 0402 SMD,Digikey 311-470LRCT-ND |  | 402 | 470 | Digikey | 311-470LRCT-ND
 | 1 | R125 | Standard | RES 10.0K OHM 1/16W 1% 0402 SMD,Digikey 311-10.0KLRCT-ND |  | 402 | 10k | Digikey | 311-10.0KLRCT-ND
 | 1 | R126 | Standard | RES 2.20K OHM 1/16W 1% 0402 SMD,Digikey 311-2.20KLRCT-ND |  | 402 | 2k2 | Digikey | 311-2.20KLRCT-ND
 | 1 | R127 | Standard | RES 3.30K OHM 1/16W 1% 0402 SMD,Digikey 311-3.30KLRCT-ND |  | 402 | 3k3 | Digikey | 311-3.30KLRCT-ND
 | 1 | R128 | Standard | RES 6.80K OHM 1/16W 1% 0402 SMD,Digikey 311-6.80KLRCT-ND |  | 402 | 6k8 | Digikey | 311-6.80KLRCT-ND
 | 1 | R129 | Standard | RES 10.0K OHM 1/16W 1% 0402 SMD,Digikey 311-10.0KLRCT-ND |  | 402 | 10k | Digikey | 311-10.0KLRCT-ND
 | 0 | R130 | Standard | RES 0.0 OHM 1/16W 0402 SMD,Digikey 311-0.0JRTR-ND |  | 402 | 0 | Digikey | 311-0.0JRTR-ND
 | 1 | R131 | Standard | RES 0.0 OHM 1/16W 0402 SMD,Digikey 311-0.0JRTR-ND |  | 402 | 0 | Digikey | 311-0.0JRTR-ND
 | 1 | R132 | Standard | RES 330K OHM 1/16W 1% 0402 SMD, Digikey 311-330KLRCT-ND |  | 402 | 330k | Digikey | 311-330KLRCT-ND
 | 1 | R133 | Standard | RES 220K OHM 1/16W 1% 0402 SMD,Digikey 311-220KLRCT-ND |  | 402 | 220k | Digikey | 311-220KLRCT-ND
 | 0 | R134 | Standard | RES 220K OHM 1/16W 1% 0402 SMD,Digikey 311-220KLRCT-ND |  | 402 | dnp | Digikey | 311-220KLRCT-ND
 | 1 | R135 | Standard | RES 220K OHM 1/16W 1% 0402 SMD,Digikey 311-220KLRCT-ND |  | 402 | 220k | Digikey | 311-220KLRCT-ND
 | 1 | R136 | Standard | RES 220K OHM 1/16W 1% 0402 SMD,Digikey 311-220KLRCT-ND |  | 402 | 220k | Digikey | 311-220KLRCT-ND
 | 1 | R137 | Standard | RES 0.0 OHM 1/16W 0402 SMD,Digikey 311-0.0JRTR-ND |  | 402 | 0 | Digikey | 311-0.0JRTR-ND
 | 1 | R138 | Standard | RES 0.0 OHM 1/16W 0402 SMD,Digikey 311-0.0JRTR-ND |  | 402 | 0 | Digikey | 311-0.0JRTR-ND
 | 0 | R139 | Standard | RES 4.87K OHM 1/16W 1% 0402 SMD, Digikey 541-4.87KLCT-ND |  | 402 | 4k87 | Digikey | 541-4.87KLCT-ND
 | 1 | S1 | Standard | SWITCH TACTILE SPST-NO 0.02A 15V,Digikey P12216SCT-ND |  | 0.236 x 0.236 inch | EVQ221304M | Digikey | P12216SCT-ND
 | 1 | S2 | Standard | SWITCH TACTILE SPST-NO 0.02A 15V,Digikey P12216SCT-ND |  | 0.236 x 0.236 inch | EVQ221304M | Digikey | P12216SCT-ND
 | 1 | S3 | Standard | SWITCH TACTILE SPST-NO 0.02A 15V,Digikey P12216SCT-ND |  | 0.236 x 0.236 inch | EVQ221304M | Digikey | P12216SCT-ND
 | 1 | S101 | CM | SW SLIDE DPDT 2POS | M096V |  |  | CM | to be provided by CM
 | 1 | T101 | Diodes | MOSFET P-CH 20V 820MA SOT323,Digikey DMG1013UW-7DICT-ND | DMG1013UW-7 | SOT-323 | DMG1013UW-7 | Digikey | DMG1013UW-7DICT-ND
 | 1 | T102 | NXP | TRANSISTOR NPN 45V 100MA SOT323,Digikey 568-6076-1-ND | BC850CW-115 | SOT-323 | BC850CW-115 | Digikey | 568-6076-1-ND
 | 1 | TP101 | Standard | Test Point,Hole, Digikey nothing-to-purchase |  | TP | TPD4E004DRY | Digikey | nothing-to-purchase
 | 1 | TP102 | Standard | Test Point,Hole, Digikey nothing-to-purchase |  |  | STD | Digikey | nothing-to-purchase
 | 1 | TP103 | Standard | Test Point,Hole, Digikey nothing-to-purchase |  |  | STD | Digikey | nothing-to-purchase
 | 1 | TP104 | Standard | Test Point,Hole, Digikey nothing-to-purchase |  |  | STD | Digikey | nothing-to-purchase
 | 1 | TP105 | Standard | Test Point,Hole, Digikey nothing-to-purchase |  |  | STD | Digikey | nothing-to-purchase
 | 1 | TP106 | Standard | Test Point,Hole, Digikey nothing-to-purchase |  |  | STD | Digikey | nothing-to-purchase
 | 1 | TP108 | Standard | Test Point,Hole, Digikey nothing-to-purchase |  |  | STD | Digikey | nothing-to-purchase
 | 1 | TP109 | Standard | Test Point,Hole, Digikey nothing-to-purchase |  |  | STD | Digikey | nothing-to-purchase
 | 1 | TP110 | Standard | Test Point,Hole, Digikey nothing-to-purchase |  |  | STD | Digikey | nothing-to-purchase
 | 1 | TP111 | Standard | Test Point,Hole, Digikey nothing-to-purchase |  |  | STD | Digikey | nothing-to-purchase
