Octanis1/Octanis1-Electronics/octanis_main_pcb_v1.0/BOMv1.xlsx

Part | list exported from / | Users/raffael/Deskto | p/Octanis/Octanis1-El | ectronics/octa | nis_main_pcb_v1.0/octanis_v1.sch at | 2016-03-13 15:46
Qty | Value | Device | Package | Parts |  | Description MF MPN OC_FARNELL OC_NEWARK PACKAGE SUPPLIER TP_SIGNAL_NAME URL VALUE
1 | 142-0701-801 | SMACONNECTOR_EDGE | SMA_EDGELAUNCH | 868MHZ |  | SMA Connector
4 | 0.05R | CURRENT_RESISTOR | 4PADS_RESISTOR | RS1, RS2, RS3, | RS4
1 | 0R | R-EU_R0402 | R0402 | R13 |  | RESISTOR, European symbol
3 | 100k | R-EU_R0603 | R0603 | R4, R5, R12 |  | RESISTOR, European symbol
2 | 100n | C-EUC0402 | C0402 | C16, C20 |  | CAPACITOR, European symbol
8 | 100n | C-EUC0603 | C0603 | C2, C3, C8, C1 | 3, C14, C17, C36, C37 | CAPACITOR, European symbol
1 | 100k | R-EU_R0603 | R0603 | R18 |  | RESISTOR, European symbol
4 | 10n | C-EUC0603 | C0603 | C24, C25, C27, | C28 | CAPACITOR, European symbol
3 | 10u | C-EUC0805K | C0805K | C1, C9, C10 |  | CAPACITOR, European symbol
2 | 10u | CPOL-EUA/3216-18R | A/3216-18R | C12, C15 |  | POLARIZED CAPACITOR, European symbol
2 | 120n | C-EUC0603 | C0603 | C4, C5 |  | CAPACITOR, European symbol
2 | 12p | C-EUC0402 | C0402 | C18, C19 |  | CAPACITOR, European symbol
2 | 12p | C-EUC0603 | C0603 | C6, C7 |  | CAPACITOR, European symbol
3 | 1M | R-EU_R0603 | R0603 | R6, R7, R8 |  | RESISTOR, European symbol
3 | 1k | R-EU_R0603 | R0603 | R10, R11, R102 |  | RESISTOR, European symbol
1 | 1n | C-EUC0603 | C0603 | C11 |  | CAPACITOR, European symbol
3 | 2N7002P,215 | NMOSSOT23 | SOT-23 | T1, T3, T4 |  | MOS FET unknown unknown
1 | 1.2k | R-EU_R0603 | R0603 | R101 |  | RESISTOR, European symbol
1 | ST2012SB32768H5 | FC-12M | FC-12M | Q1 |  | kHz RANGE CRYSTAL UNIT http://www.mouser.ch/ProductDetail/ECS/ECS-327-125-12-TR/?qs=sGAEpiMZZMsBj6bBr9Q9adKxTNdvE4KvM1b8HDkgjuY%3d
1 | AB26TRQ-32.768kHz-T | MS3V-T1R | MS3V-T1R | Q2
1 | HT-193UYG-5592 | LEDCHIPLED_0603 | CHIPLED_0603 | 3V |  | LED green
2 | 4.7k | R-EU_R0603 | R0603 | R2, R3 |  | RESISTOR, European symbol
1 | 4.7uH | LQM2MP_G0 | 806 | L2
10 | 470n | C-EUC0603 | C0603 | C21, C22, C23, | C26, C29, C30, C31, C32, C33, C34 | CAPACITOR, European symbol
1 | 47k | R-EU_R0603 | R0603 | R9 |  | RESISTOR, European symbol
4 | 6.8k | R-EU_R0603 | R0603 | R15, R16, R17, | R19 | RESISTOR, European symbol
1 | 91k 0.1% ±25 ppm/°C | R-EU_R0402 | R0402 | R14 |  | RESISTOR, European symbol
1 | HT-193UYG-5592 | LEDCHIPLED_0603 | CHIPLED_0603 | BAT |  | LED green
1 | BME280 | BME280 | BME280 | IC2 |  | DIGITAL HUMIDITY, PRESSURE AND TEMPERATURE SENSOR* Digital interface I²C (up to 3.4 MHz) and SPI (3 and 4 wire, up to 10 MHz)* Supply voltage VDD main supply voltage range: 1.71 V to 3.6 V*VDDIO interface voltage range: 1.2 V to 3.6 V
1 | BNO055A | BNO055A | BNO055 | IC1
1 | BNO055_COORDINATES | BNO055_COORDINATES | BNO055_COORDINATES | U$3
1 | DMP2066LSN | PMOSSOT23 | SOT-23 | T2 |  | MOS FET unknown unknown
2 | DRV8835DSSR | DRV8836DSSR | SON50P200X300X80-13N | U4, U5 |  | DUAL LOW VOLTAGE H-BRIDGE IC,SON-12 DRV8836DSSR 2115236 94T6066 SON-12 TEXAS INSTRUMENTS
2 | DRV8836DSSR | DRV8836DSSR | SON50P200X300X80-13N | U11, U12 |  | DUAL LOW VOLTAGE H-BRIDGE IC,SON-12 DRV8836DSSR 2115236 94T6066 SON-12 TEXAS INSTRUMENTS
4 | INA210 | INA213 | SC70-6 | U7, U8, U9, U1 | 0 | Voltage
1 | LS Q976-NR-1 | LEDCHIPLED_0603 | CHIPLED_0603 | LED2 |  | LED red (LED0)
1 | HT-193UYG-5592 | LEDCHIPLED_0603 | CHIPLED_0603 | LED1 |  | LED green (LED1)
1 | LPS3015 | LPS3015 | LPS3015 | L1 |  | Shielded Power Inductor
1 | MAX6001SOT-23 | MAX6001SOT-23 | MAX6001 | U3
1 | MSP432 | MSP432 | PZ100 | U2
1 | RN2483 | RN2483 | RN2483 | U100 |  | Microchip Low-Power Long Range LoRaTM Technology Transceiver Module RN2483
1 | S25FL127S | SST25VF064C | SOIC_8-LEAD | U6
1 | TPS61201 | TPS61201 | S-PDSO-N10 | U1 |  | LOW INPUT VOLTAGE SYNCHRONOUS BOOST CONVERTER WITH 1.3-A SWITCHES TPS61201DRCT unknown 37M0068
3 | TPTP06R | TPTP06R | TP06R | MOD, MOD., VCC | MOT | Test pad
