Octanis1/Octanis1-Electronics/octanis_main_pcb_v0.6/octanis_v0.6%N.cmp.dxf

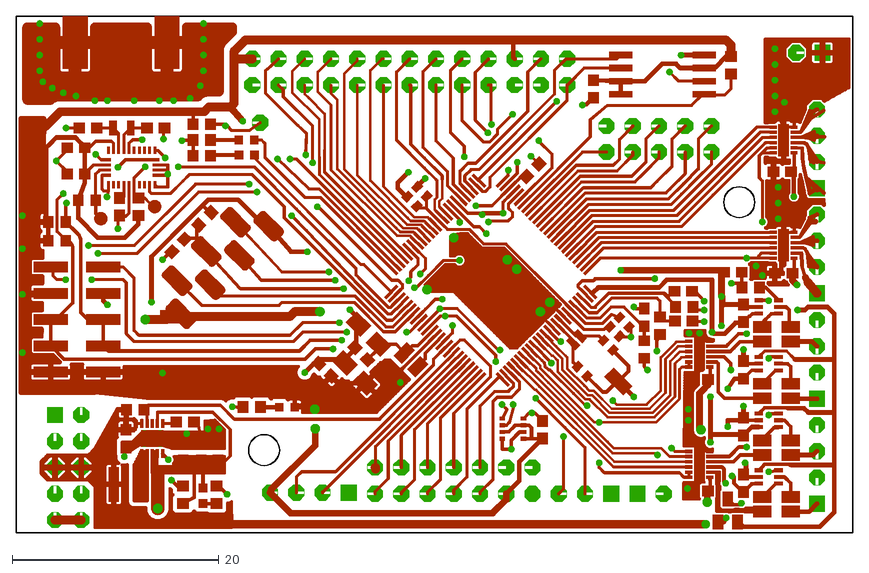
[picture p8: CAD file, 2016-01-02, an earlier design]
octanis_main_pcb_v0.6/octanis_v0.6%N.cmp.dxf
81.0 x 50.0
