Octanis1/Octanis1-Electronics/octanis_main_pcb_v0.6/stencilw.dxf

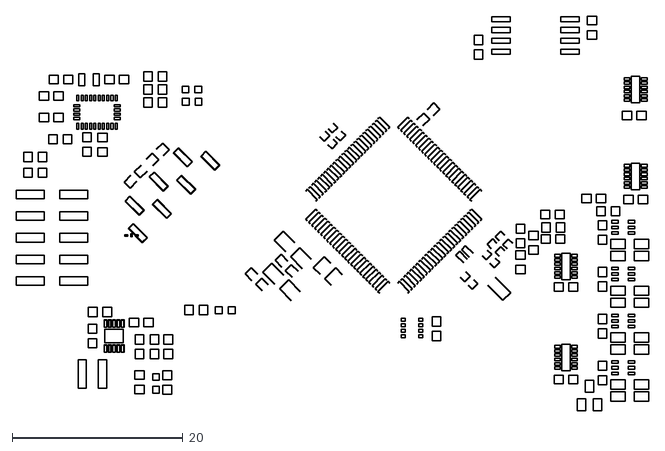
[picture p9: CAD file, 2016-01-02, an earlier design]
octanis_main_pcb_v0.6/stencilw.dxf
74.2 x 46.3
