Octanis1/Octanis1-Electronics/octanis_main_pcb_v0.6/octanis_v0.6.dxf

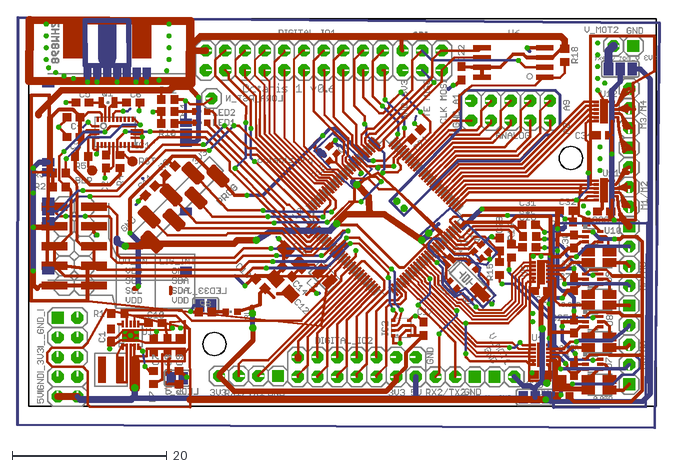
[picture p10: CAD file, 2016-01-02, an earlier design]
octanis_main_pcb_v0.6/octanis_v0.6.dxf
83.1 x 53.3
