Octanis1/Octanis1-Electronics/(threads)

Thread 1 (2016-05-31):

Assemble one EPS v1.0 prototype and ensure its correct functionality

traffael, 2016-05-31:

Closed 2016-08-04.

Thread 2 (2016-06-02):

Design new EPS

traffael, 2016-06-02:
- add Vbat output with circuit breaker
- add 0R resistors everywhere to cut enable pins from mcu
- add jumper between VCC and MCU supply
- replace BGA with "normal" component
- add a second power input (5V USB) in parallel to solar input for battery charging.

Deadline: June 12th (design)
June 30th fabrication of 3 running boards

Closed 2016-06-22.

Thread 3 (2016-07-03):

Solder 1 replacement board of mainboard

traffael, 2016-07-03:

Closed 2016-07-17.

Thread 6 (2016-07-08):

Proper cabling and connectors for electronic boards

traffael, 2016-07-08:
- Solder polarized connector for all battery and solar cell inputs
- Use flat cables and DIN connectors for board-to-board or board-to-module connections, for easy plug-and-play
- Ensure rigidity (mechanical stability) of the connections and solder joints
- Label all cables

Closed 2016-09-17.

Thread 8 (2016-07-17):

Replace L/C & Rsense to limit charge current to 2A on all EPS

traffael, 2016-07-17:
.. wait for components

Closed 2016-07-31.

Thread 12 (2016-09-07):

Pre-shipping: IMPORTANT: remove solar charger LEDs of rover EPS board

traffael, 2016-09-07:
to avoid damage when connected to wrong power supply

Thread 13 (2016-09-07):

Olimex boot-done state not correctly detected by EPS

traffael, 2016-09-07:
possible reason: charge remains on shutdown_state_pin -> add pulldown could be a solution.

traffael, 2016-09-10:
pulldown is already activated on EPS. need different solution!

Closed 2016-09-14.
