Octanis1/Octanis1-Electronics/octanis_eps/docu/EPS_PMB.PDF

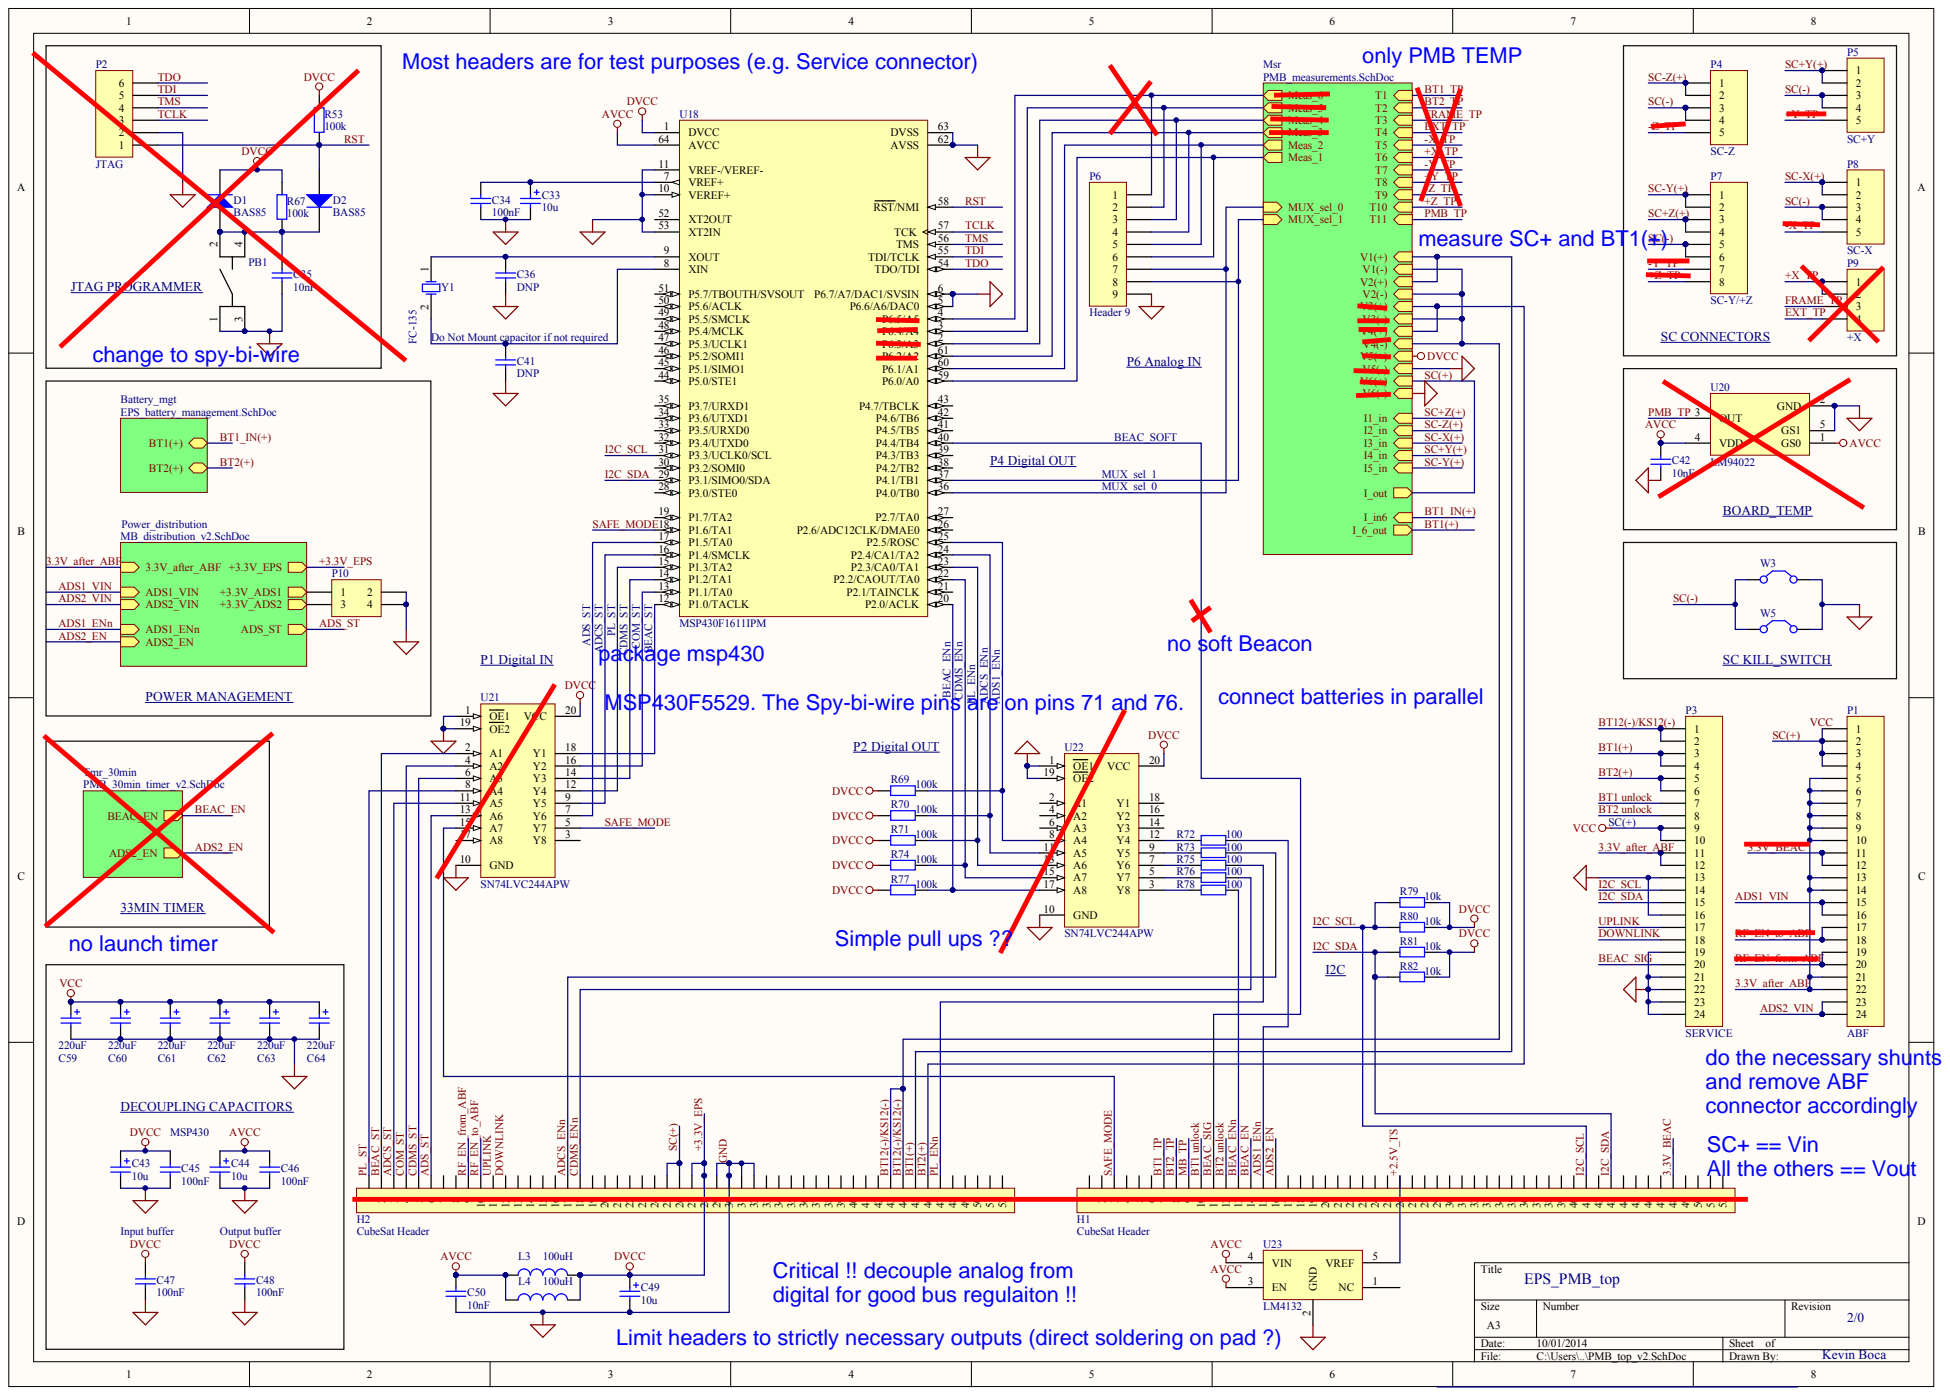
[picture p11: page 1]

Do Not Mount capacitor if not required

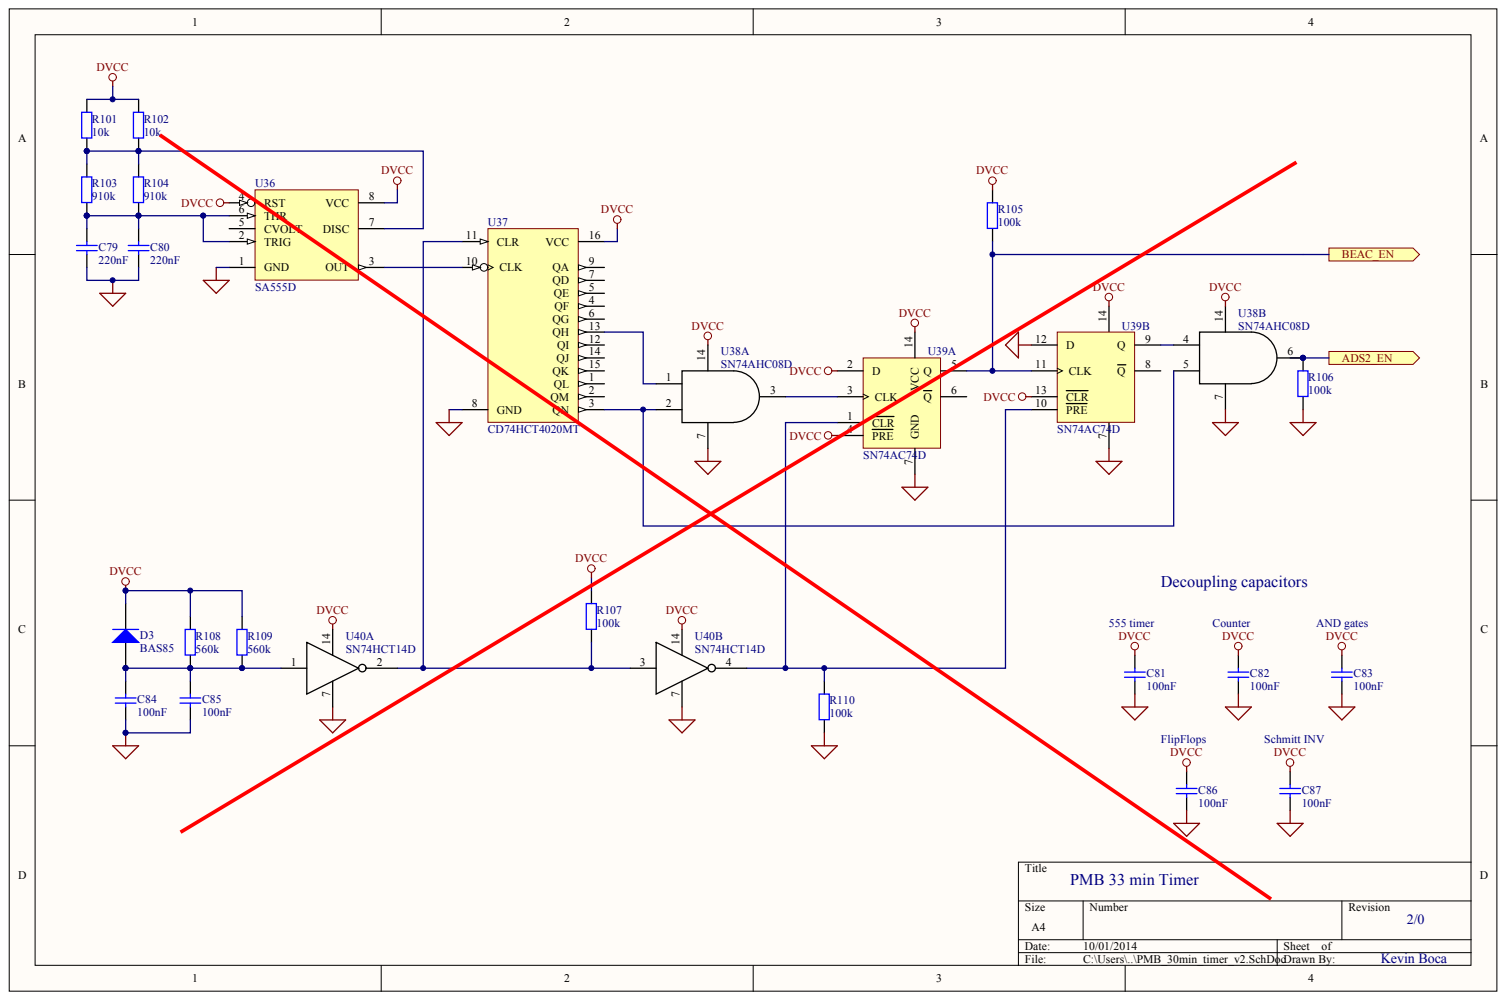
[picture p12: page 2]

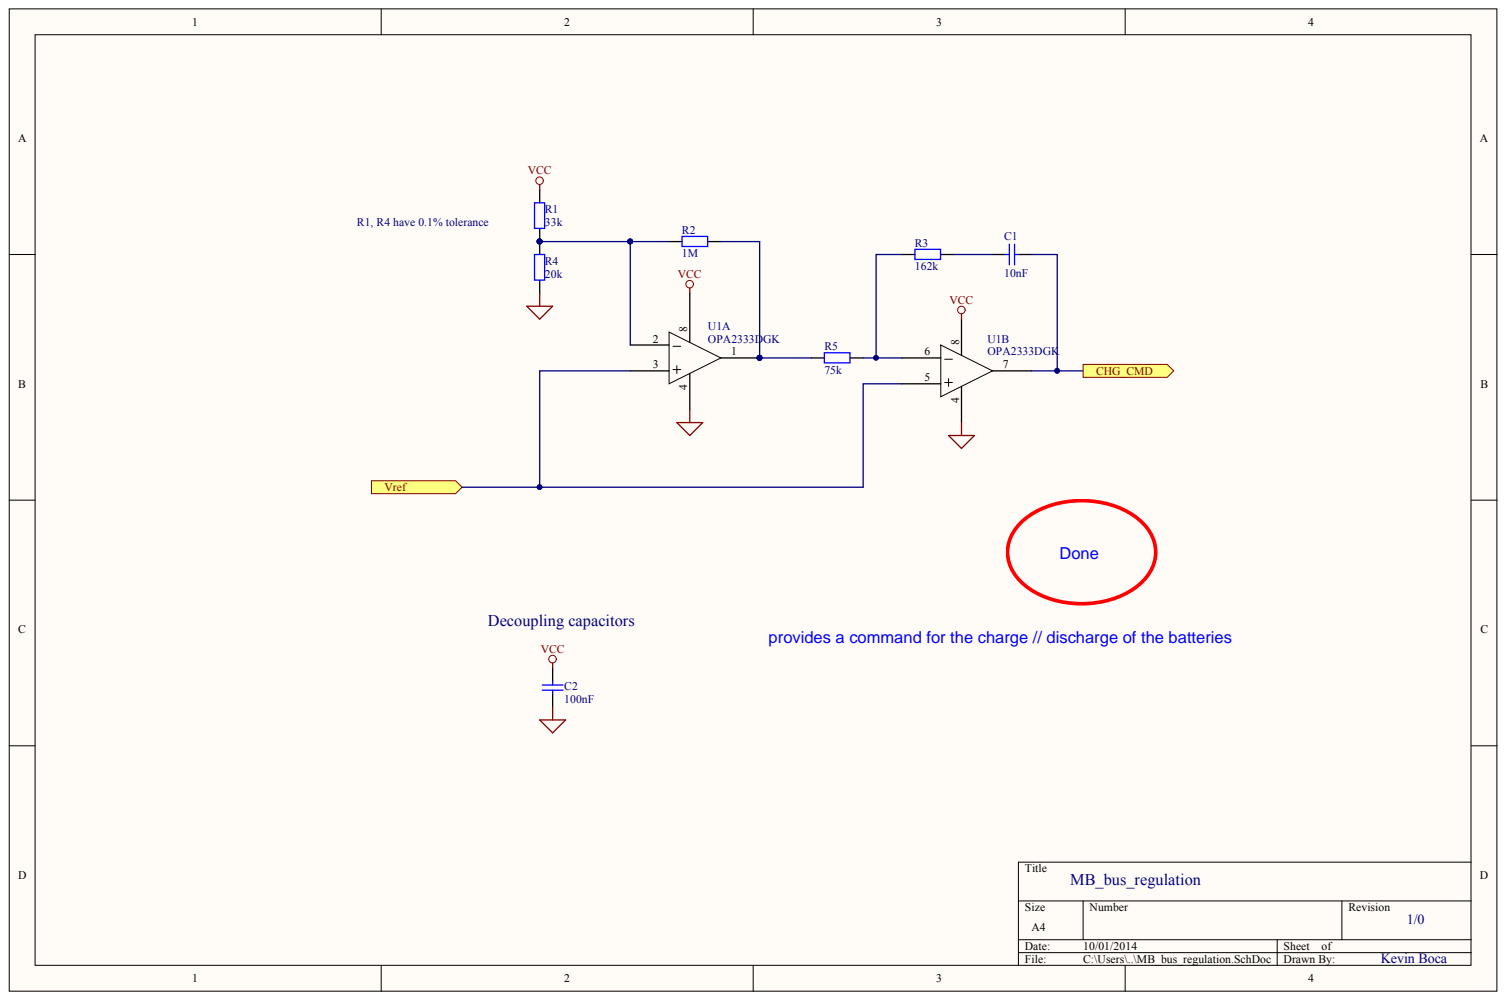
[picture p13: page 3]

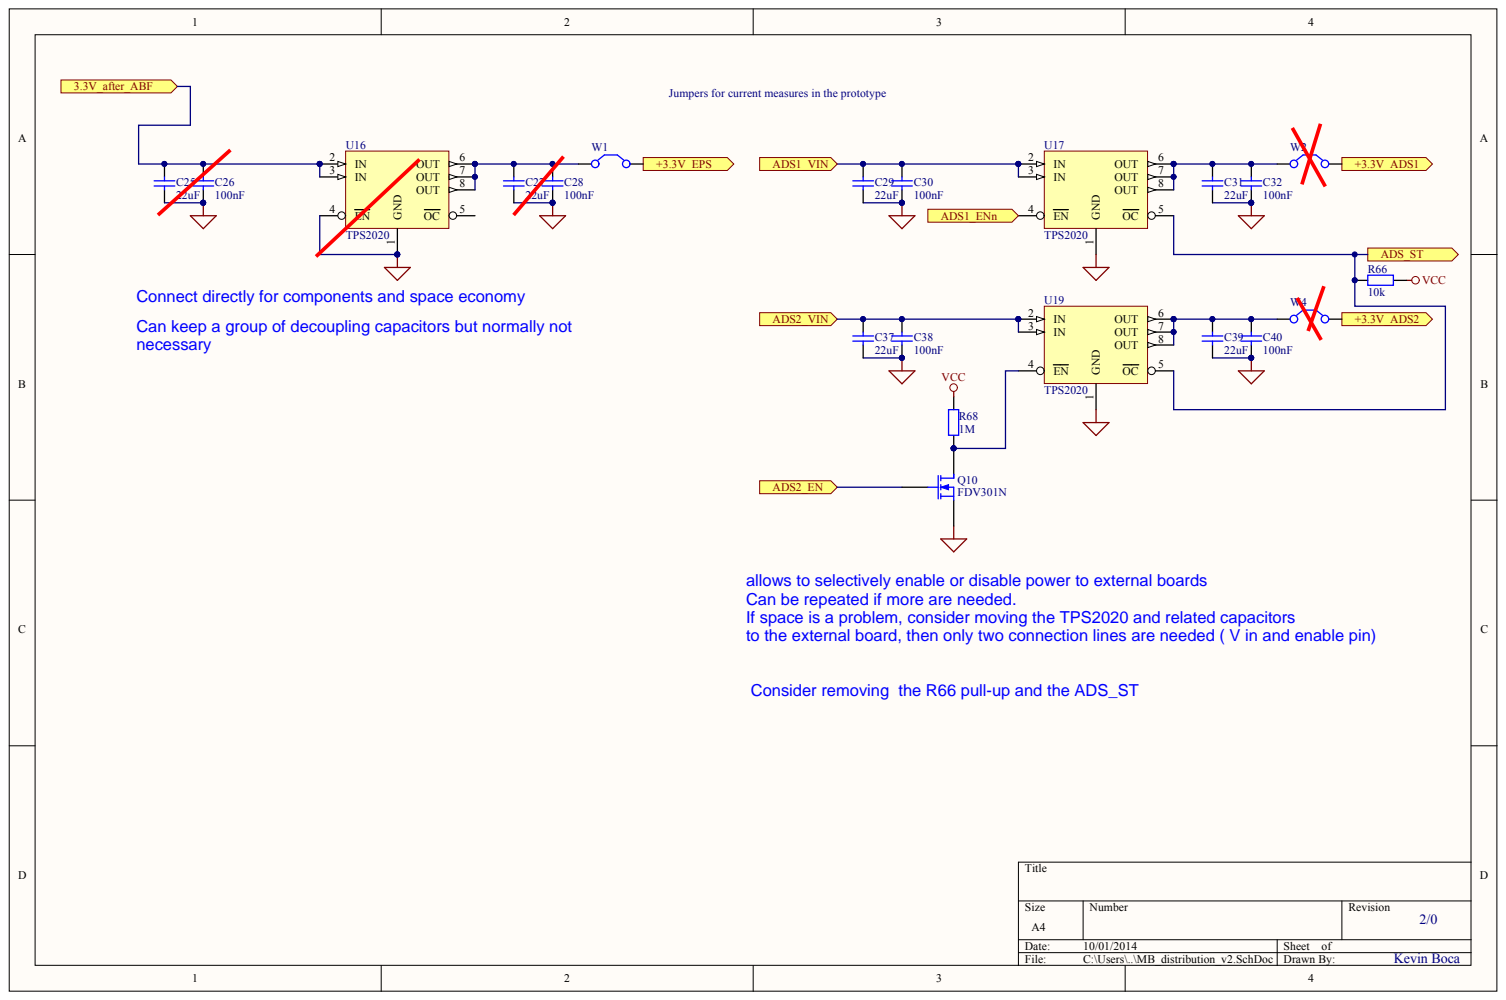
[picture p14: page 4]

Jumpers for current measures in the prototype

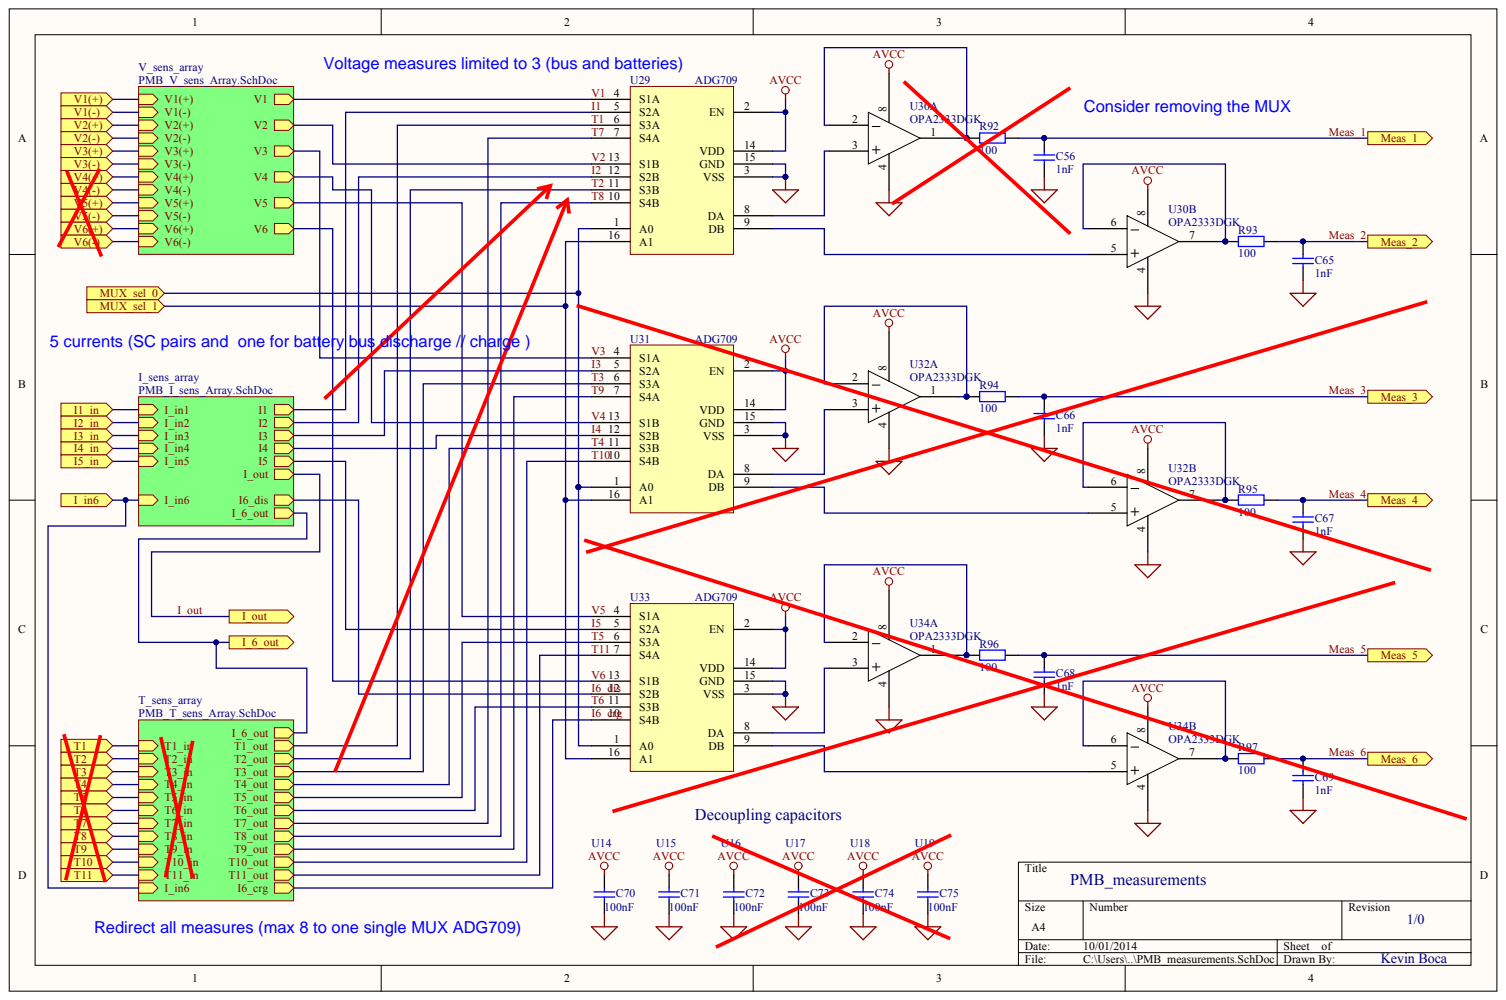
[picture p15: page 5]

T2 | | 8
T8

A1 16

I_in1 I1 I_in2 I2 I_in3 I3 I_in4 I4 I_in5 I5 I_out I_in6 I6_dis I_6_out | | | V4

T4 | | 8
T10

T_sens_array PMB_T_sens_Array.SchDoc | | | T11 7

I6_dis | S1B 13 S2B 12 S3B 11 S4B 10 | 3

T6 | | 8
I6_crg

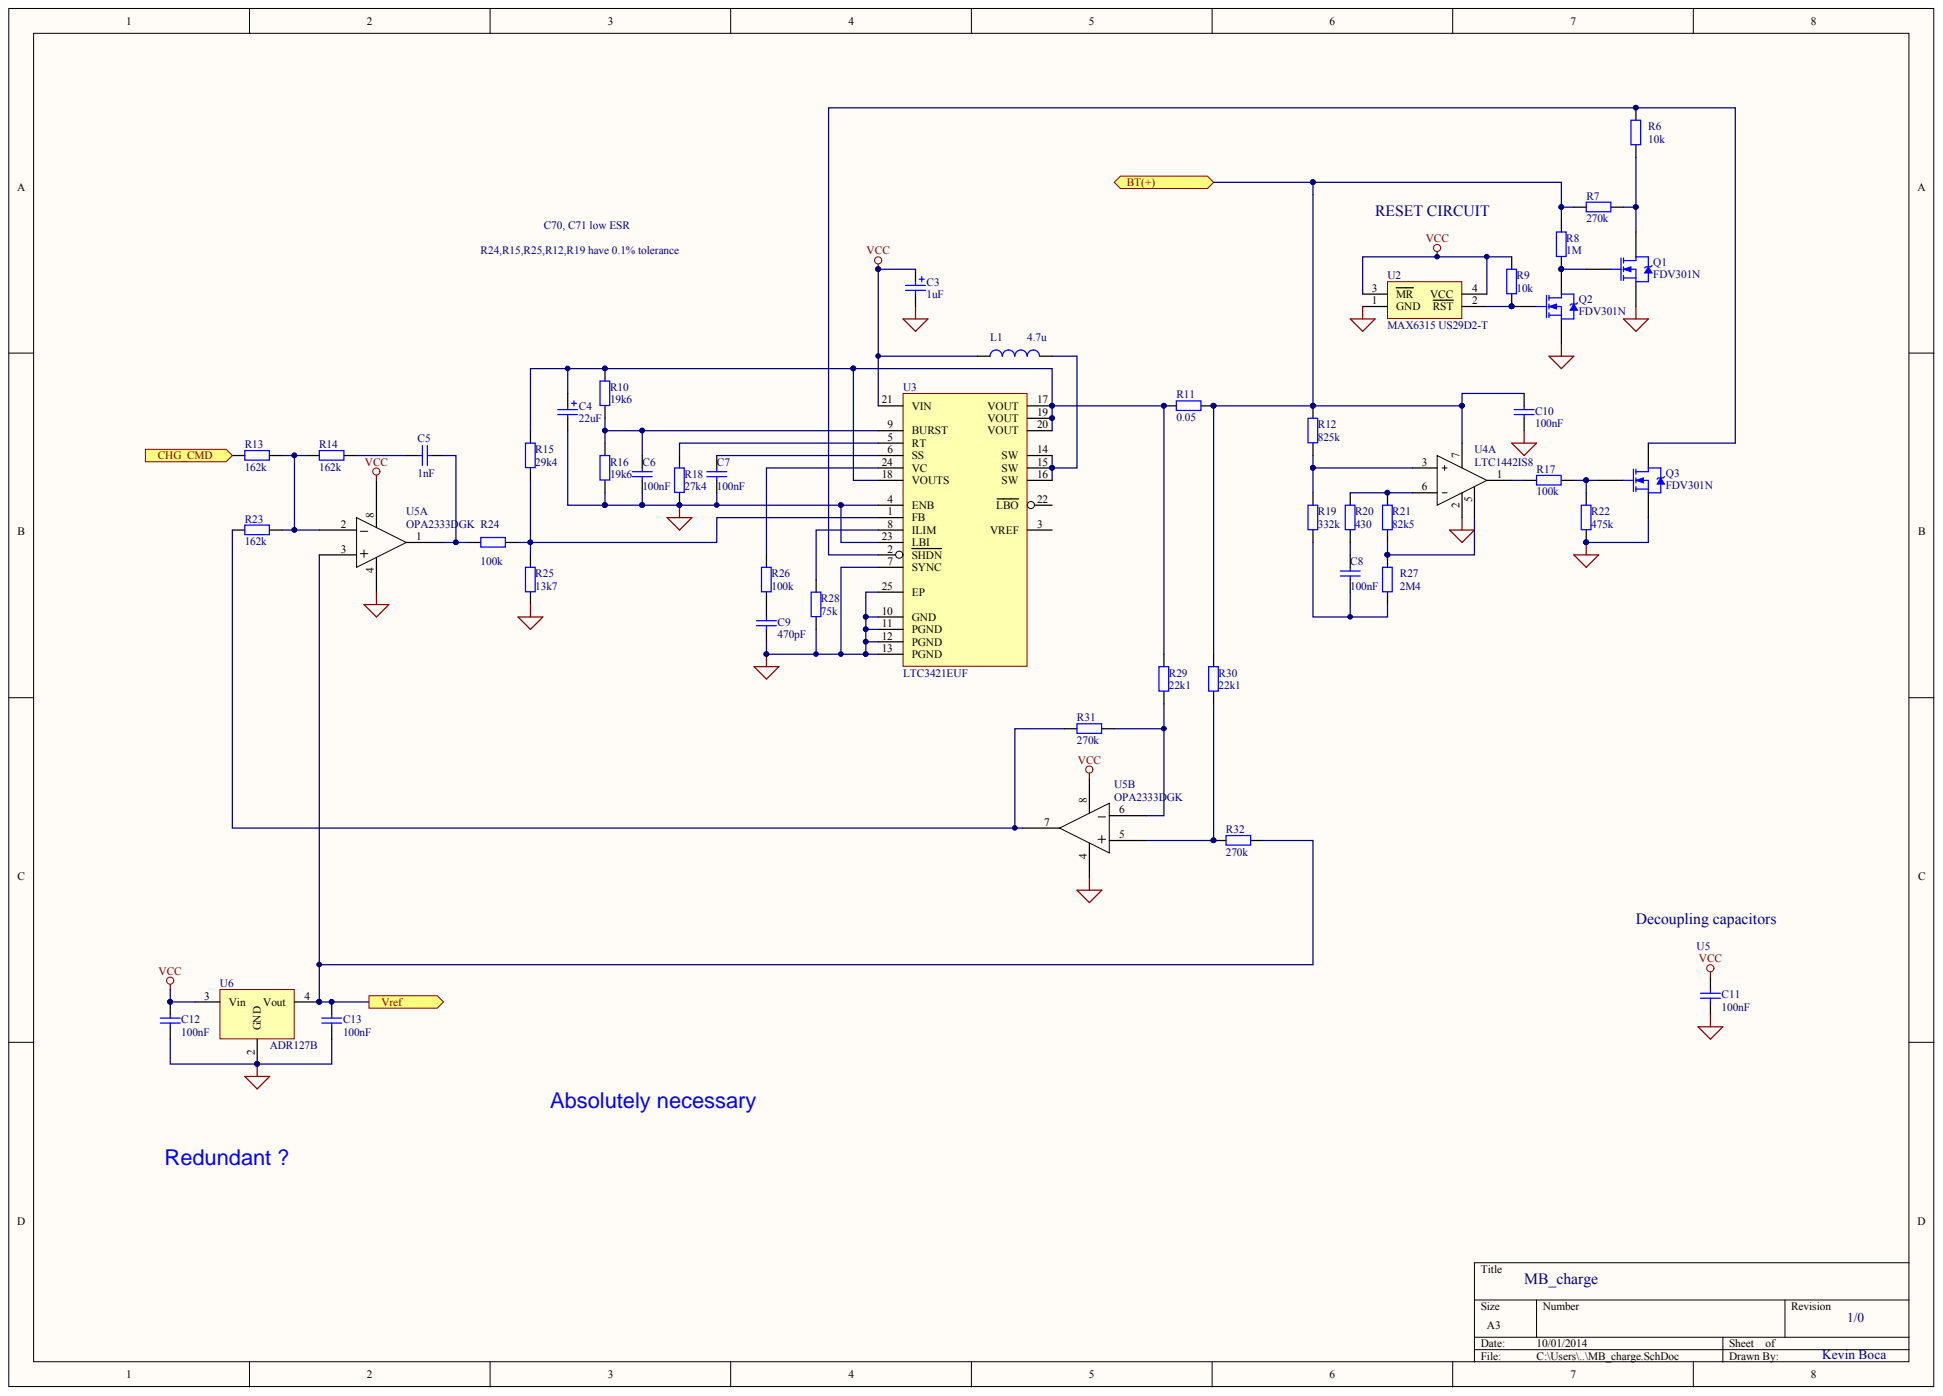
[picture p16: page 6]

RT 5 SW SW SW LBO | 14
SS 6
VC 24 | 15
VOUTS 18 | 16

ENB 4 | 22
FB 1
ILIM 8
LBI 23 SHDN 2

SYNC 7 | | | | C8

GND 10
PGND 11
PGND 12
PGND 13

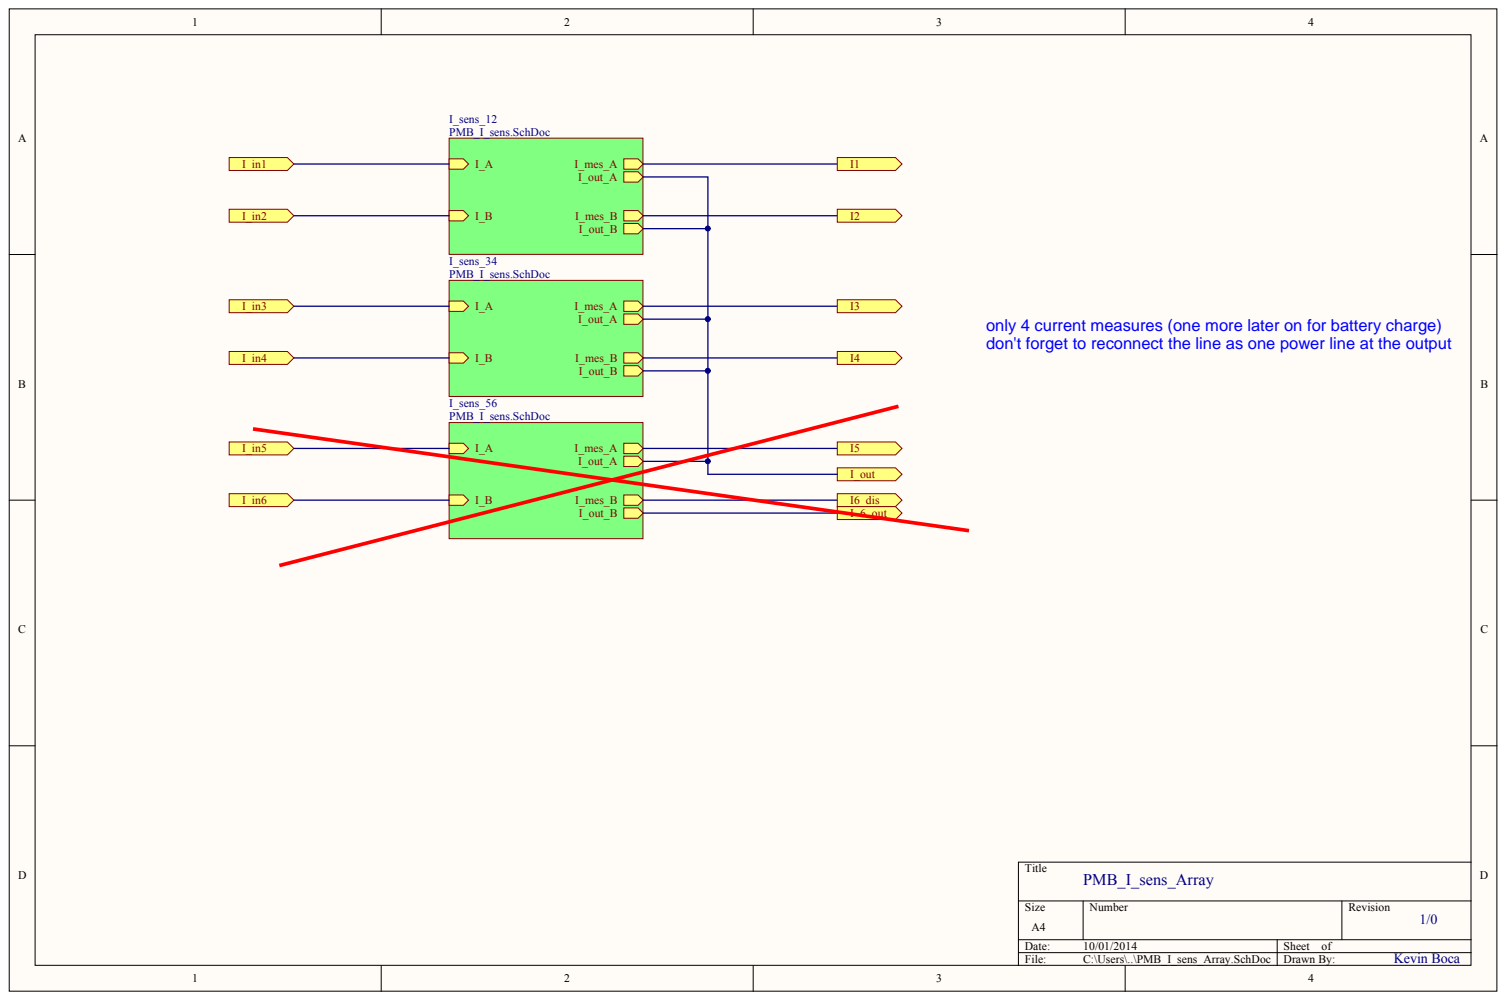
[picture p17: page 7]

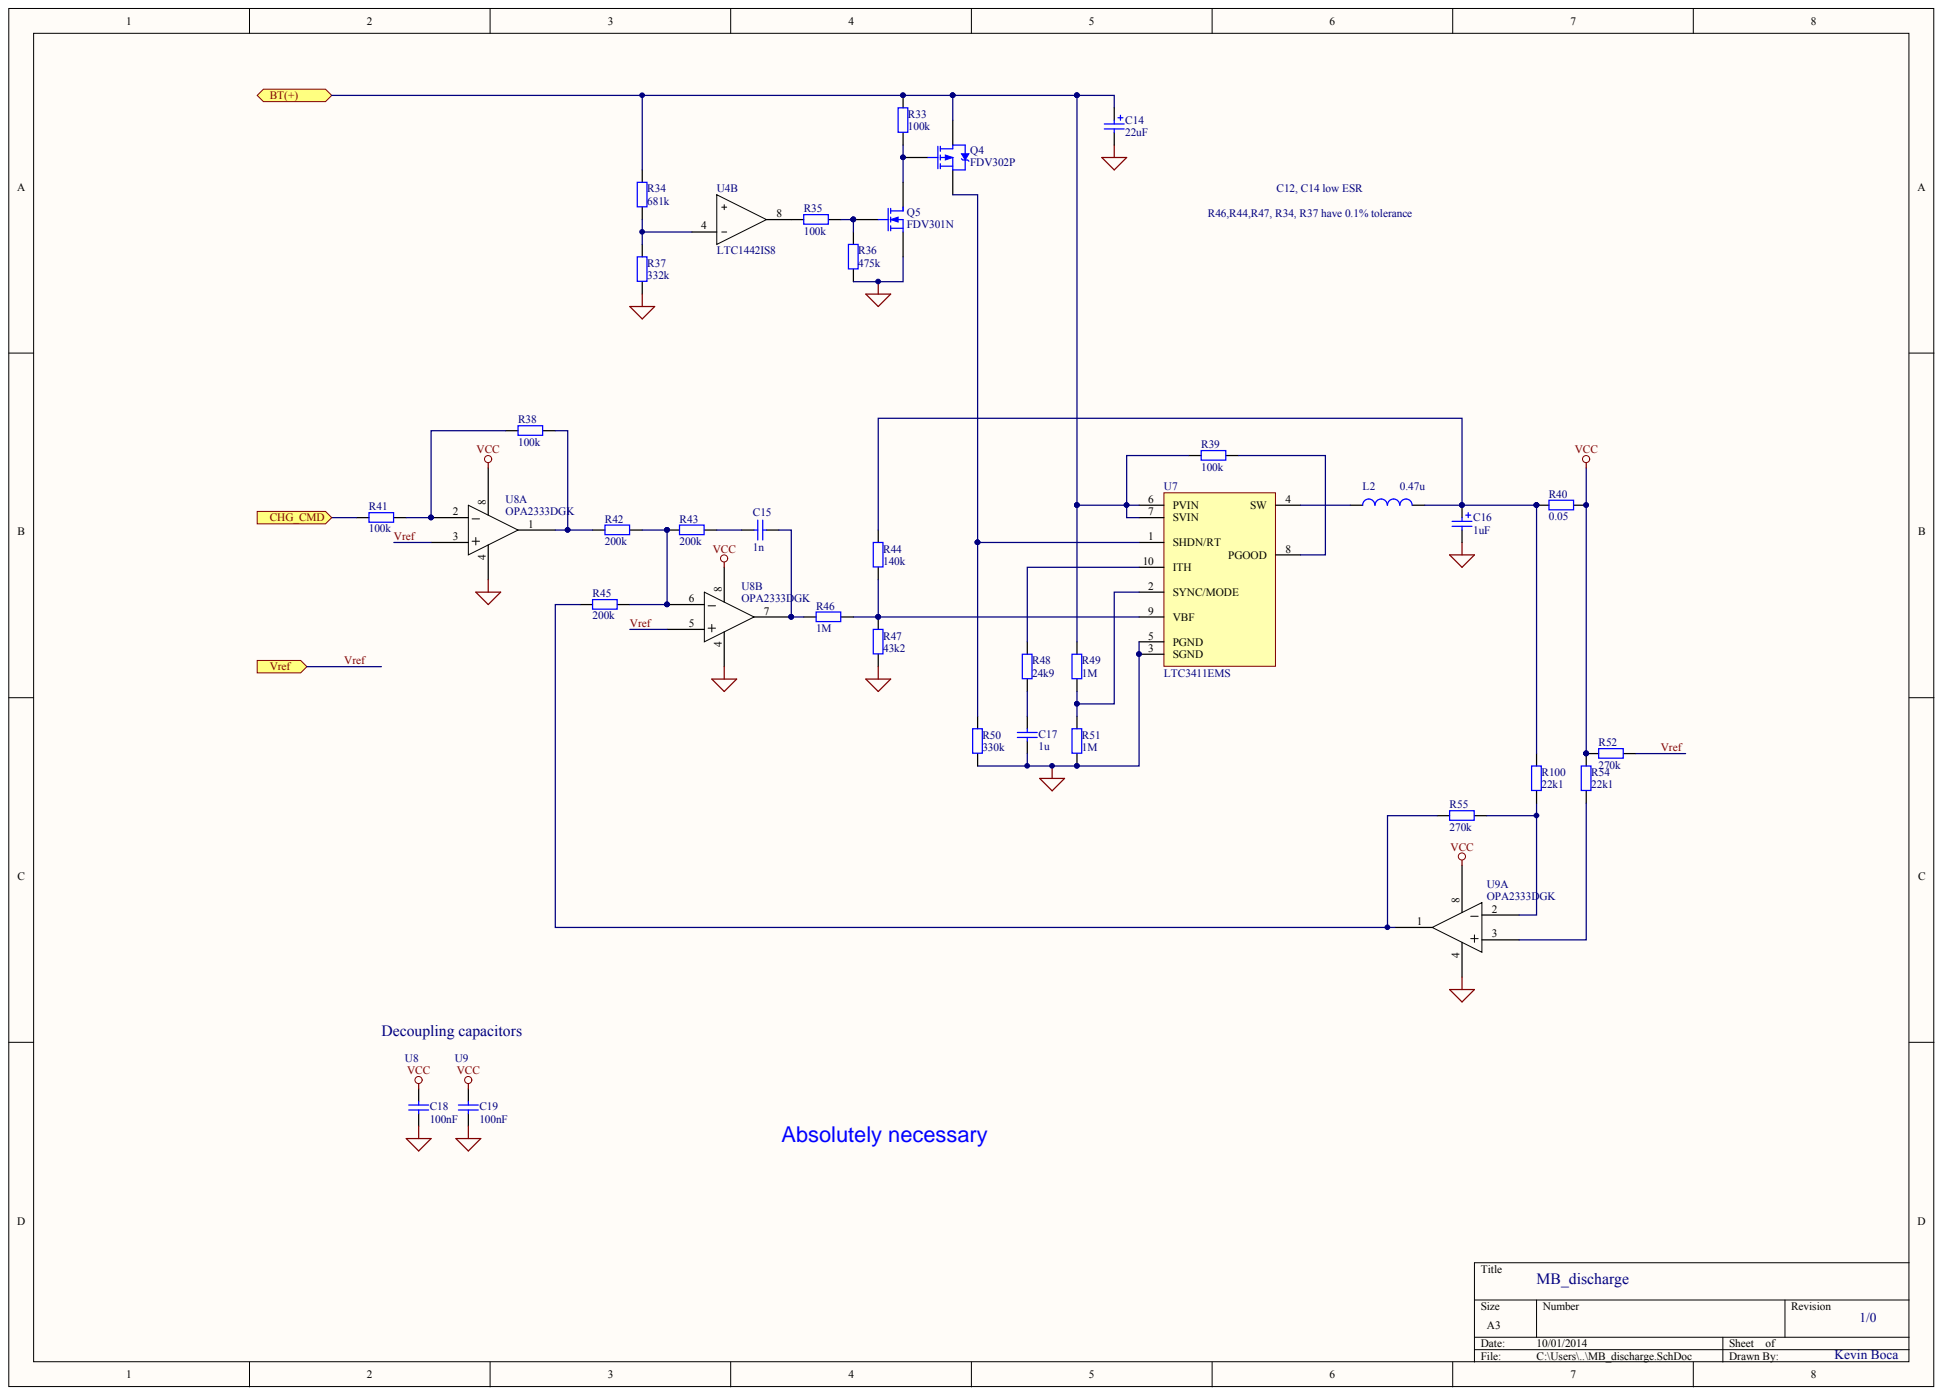
[picture p18: page 8]

PVIN 6
SVIN 7

SHDN/RT 1 PGOOD | 8

SYNC/MODE 2

VBF 9

PGND 5
SGND 3

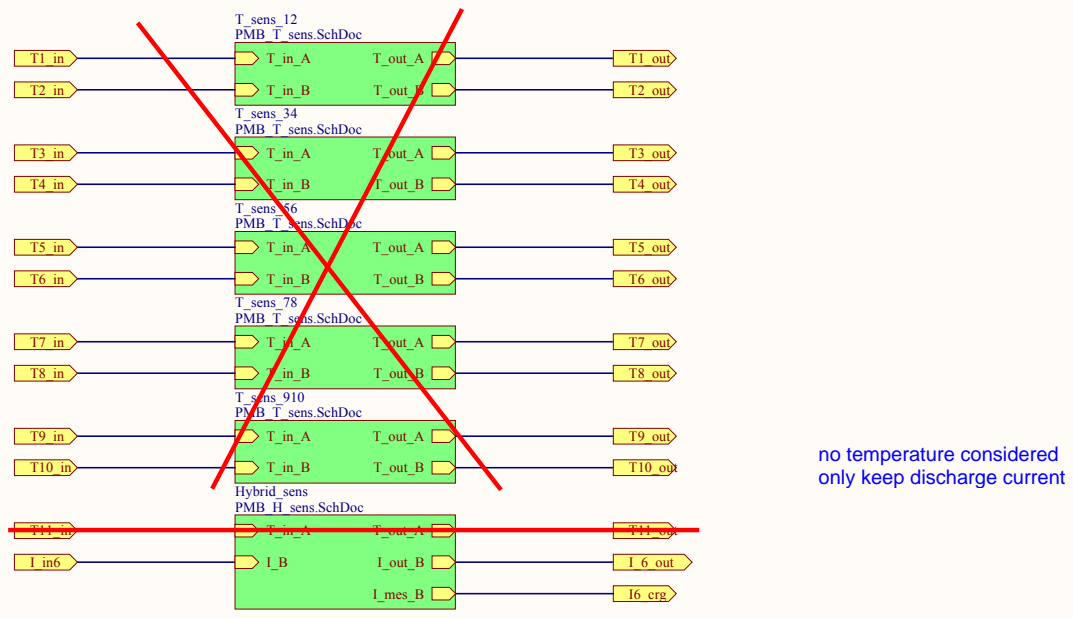
[picture p19: page 9]

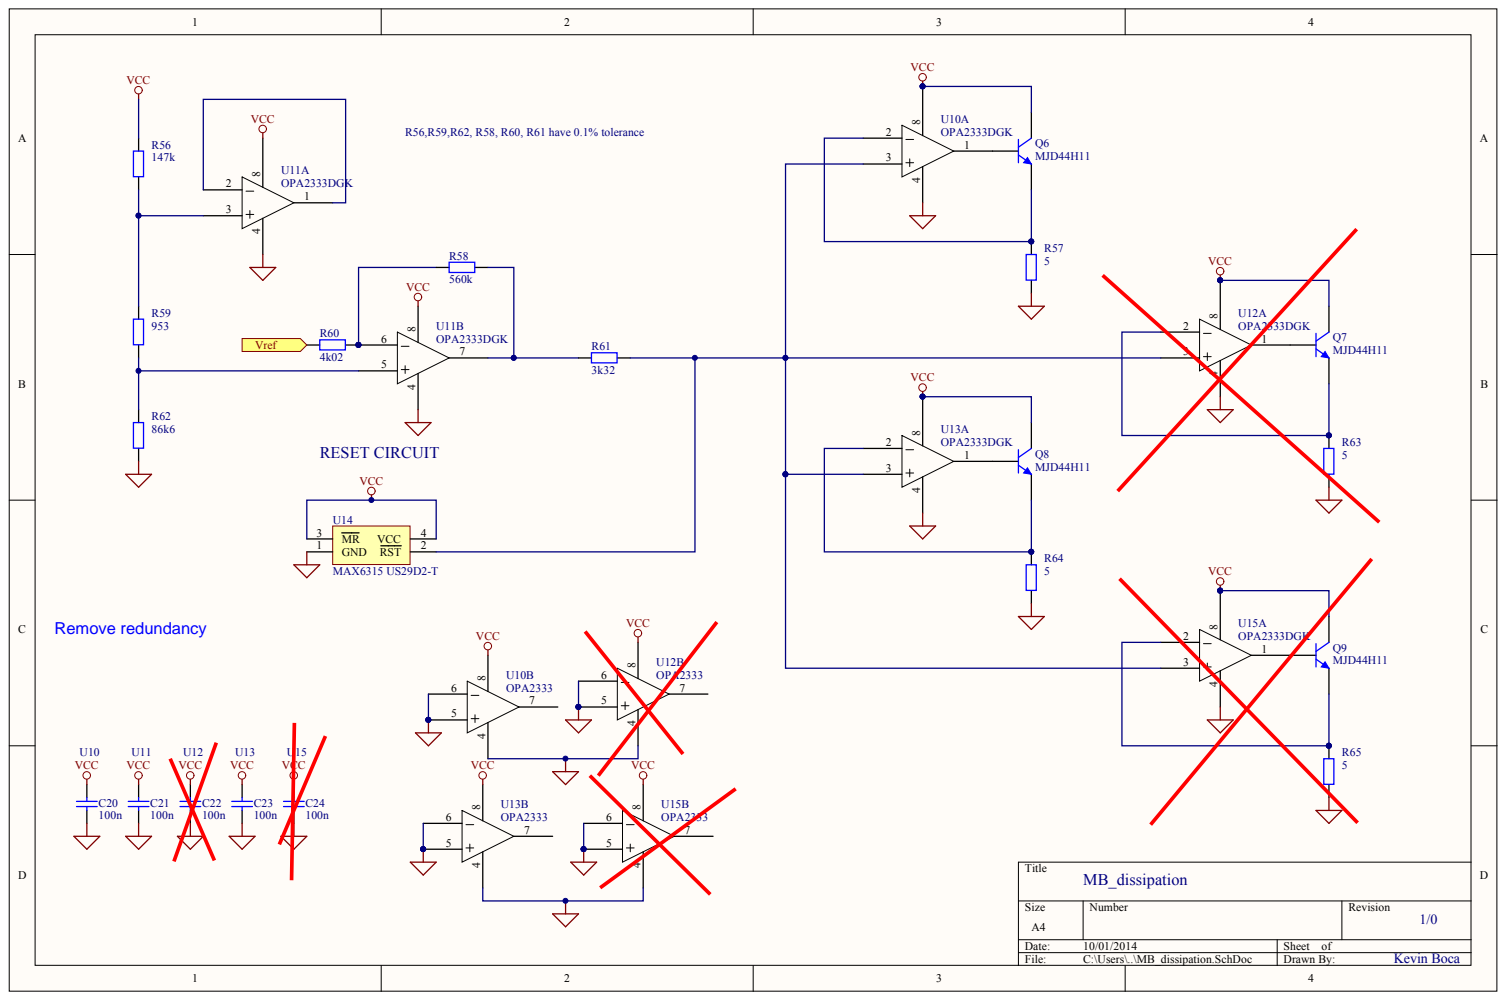
[picture p20: page 10]

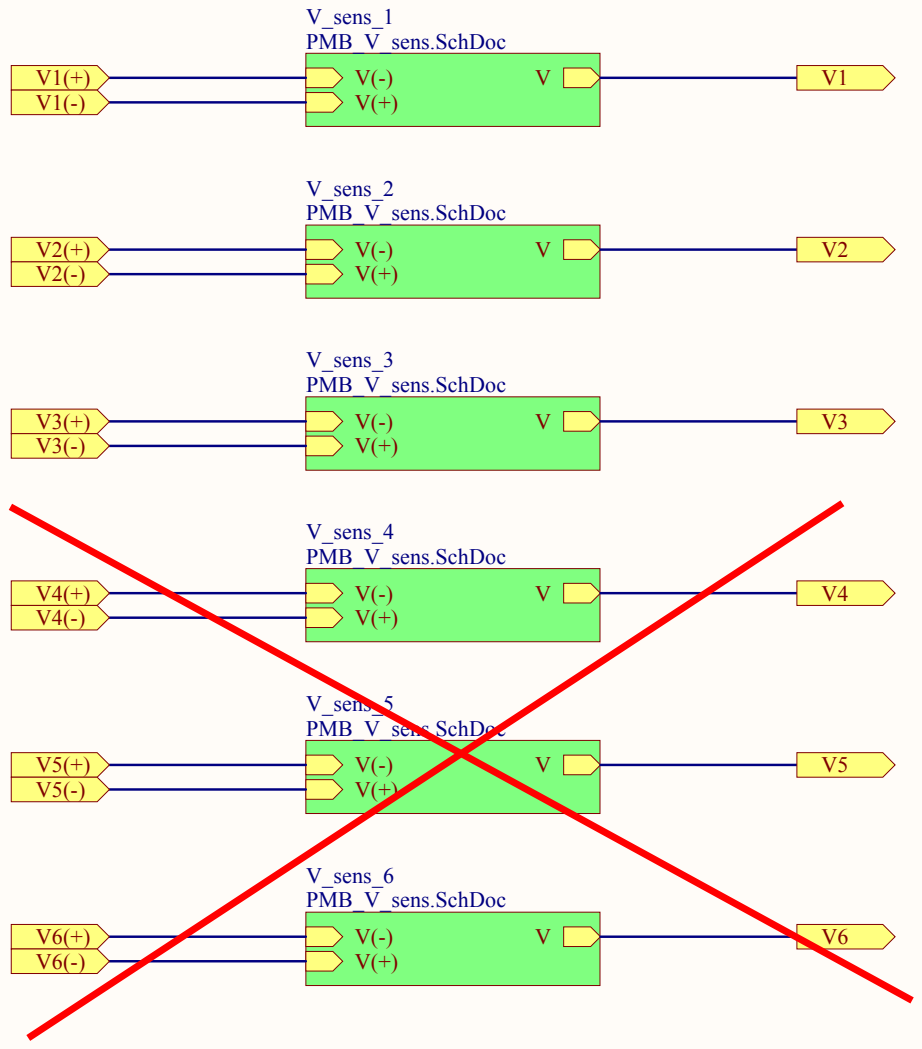
[picture p21: page 11]

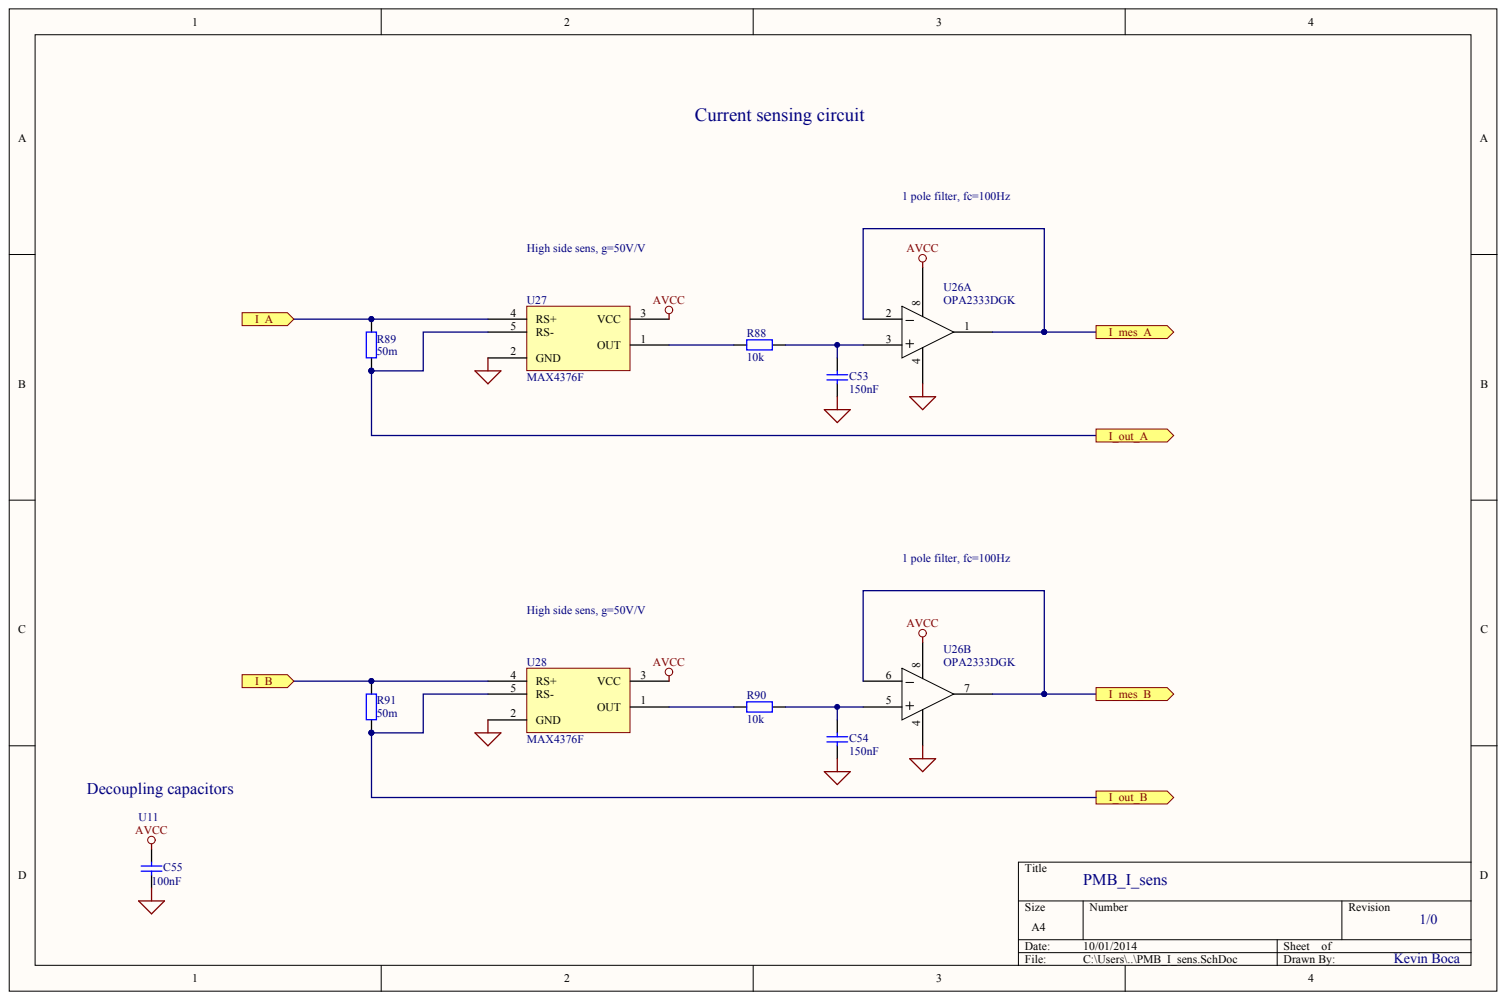
[picture p22: page 12]

AVCC | 1

GND 2

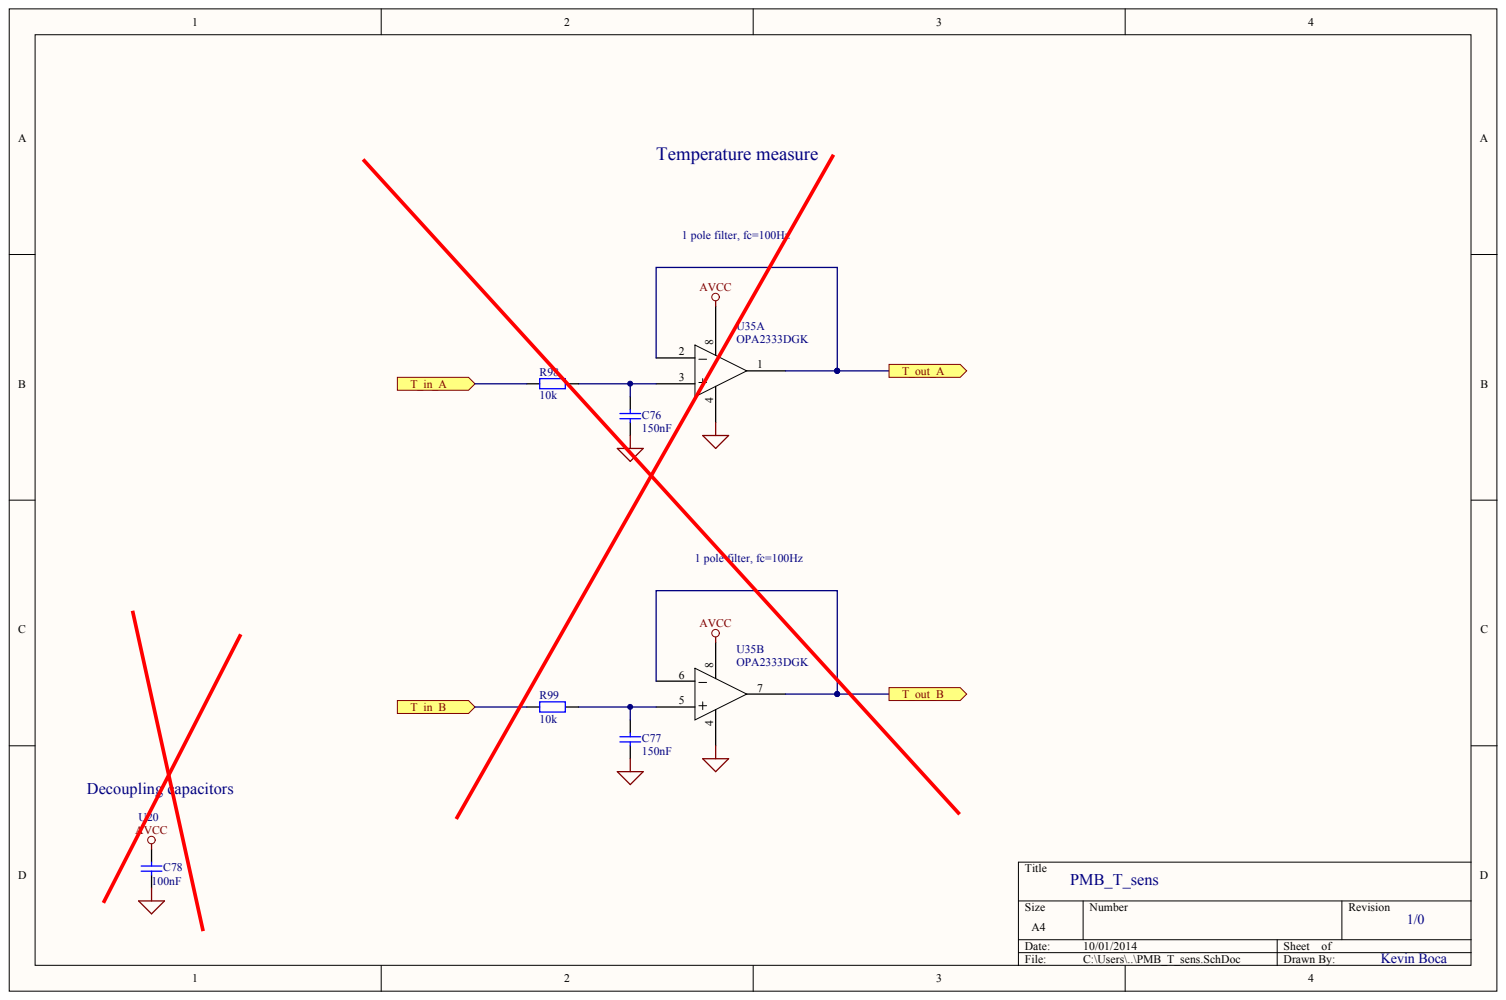
[picture p23: page 13]

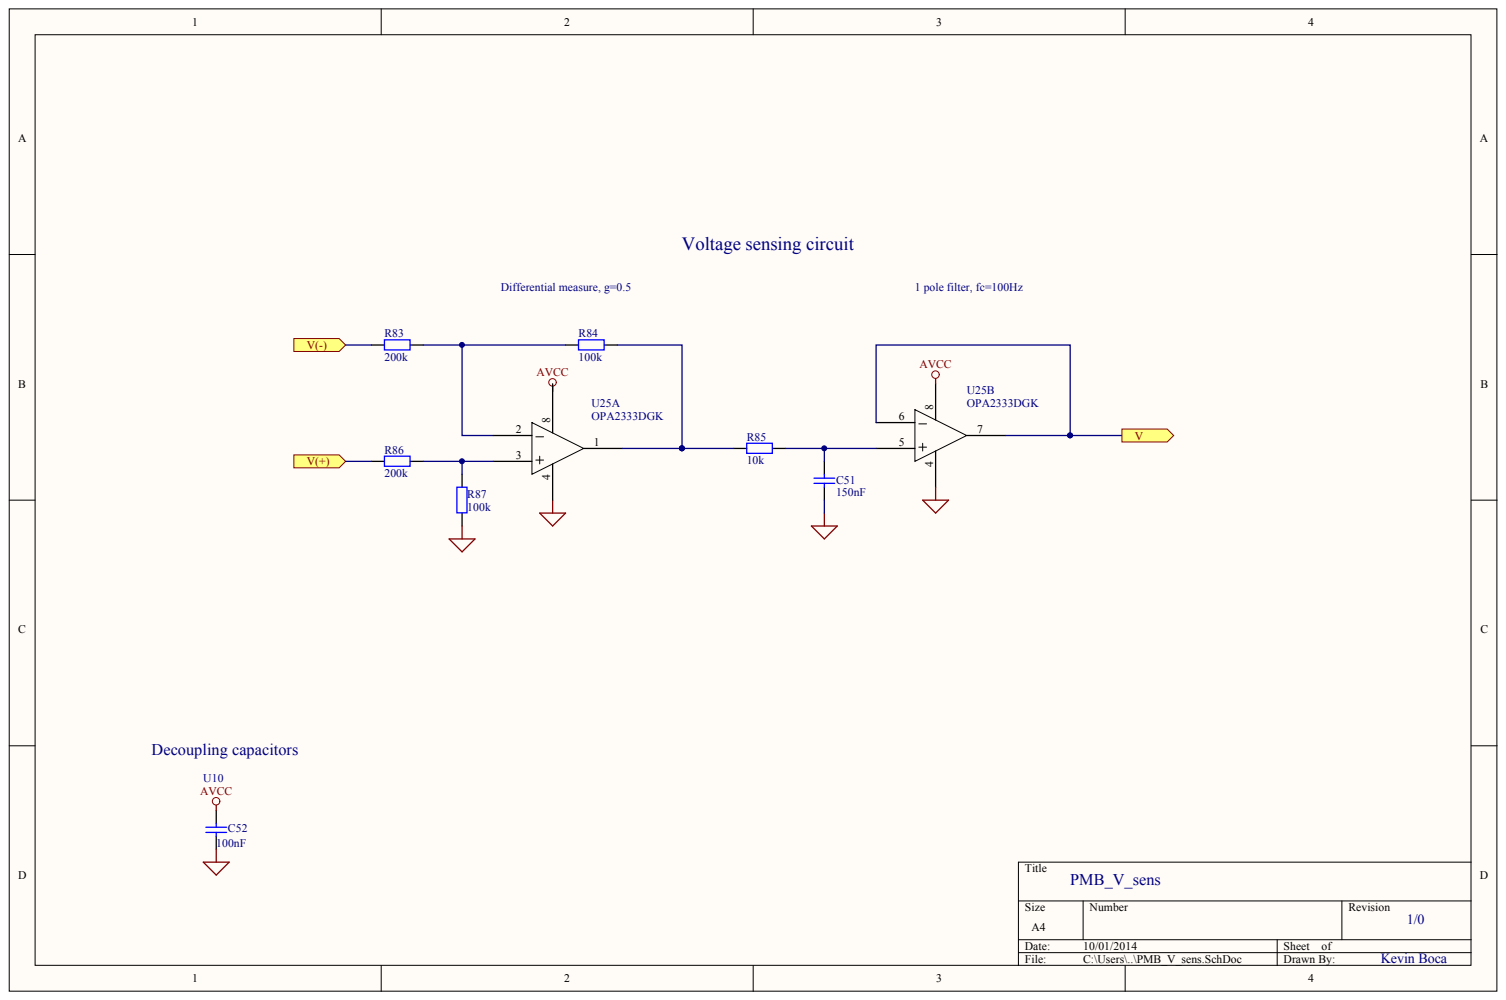
[picture p24: page 14]

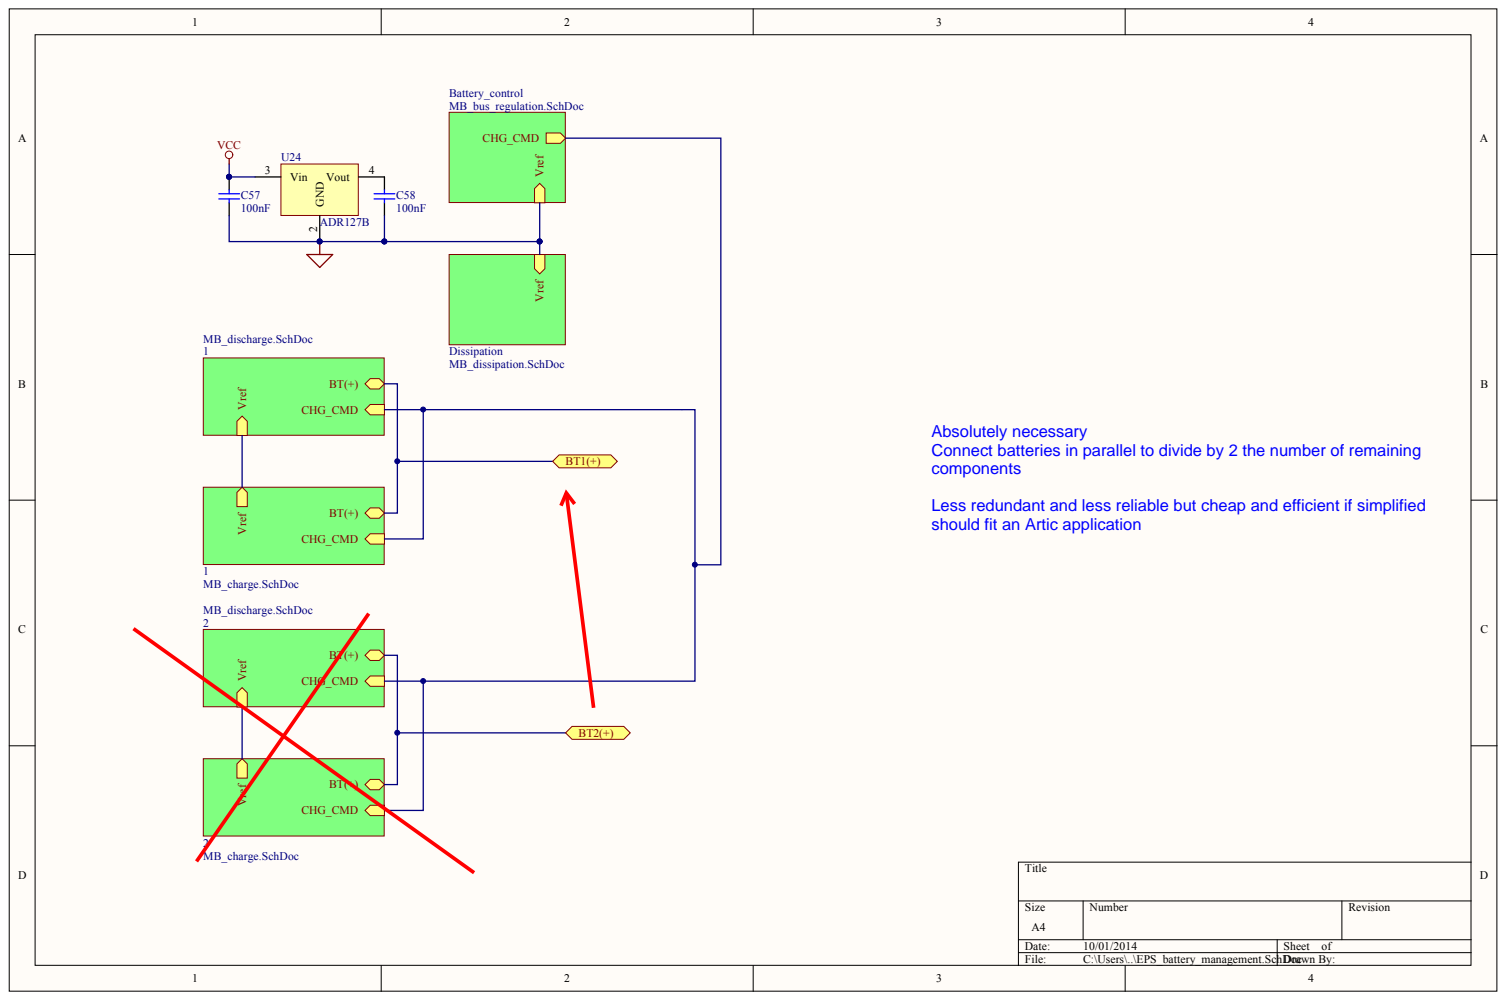
[picture p25: page 15]

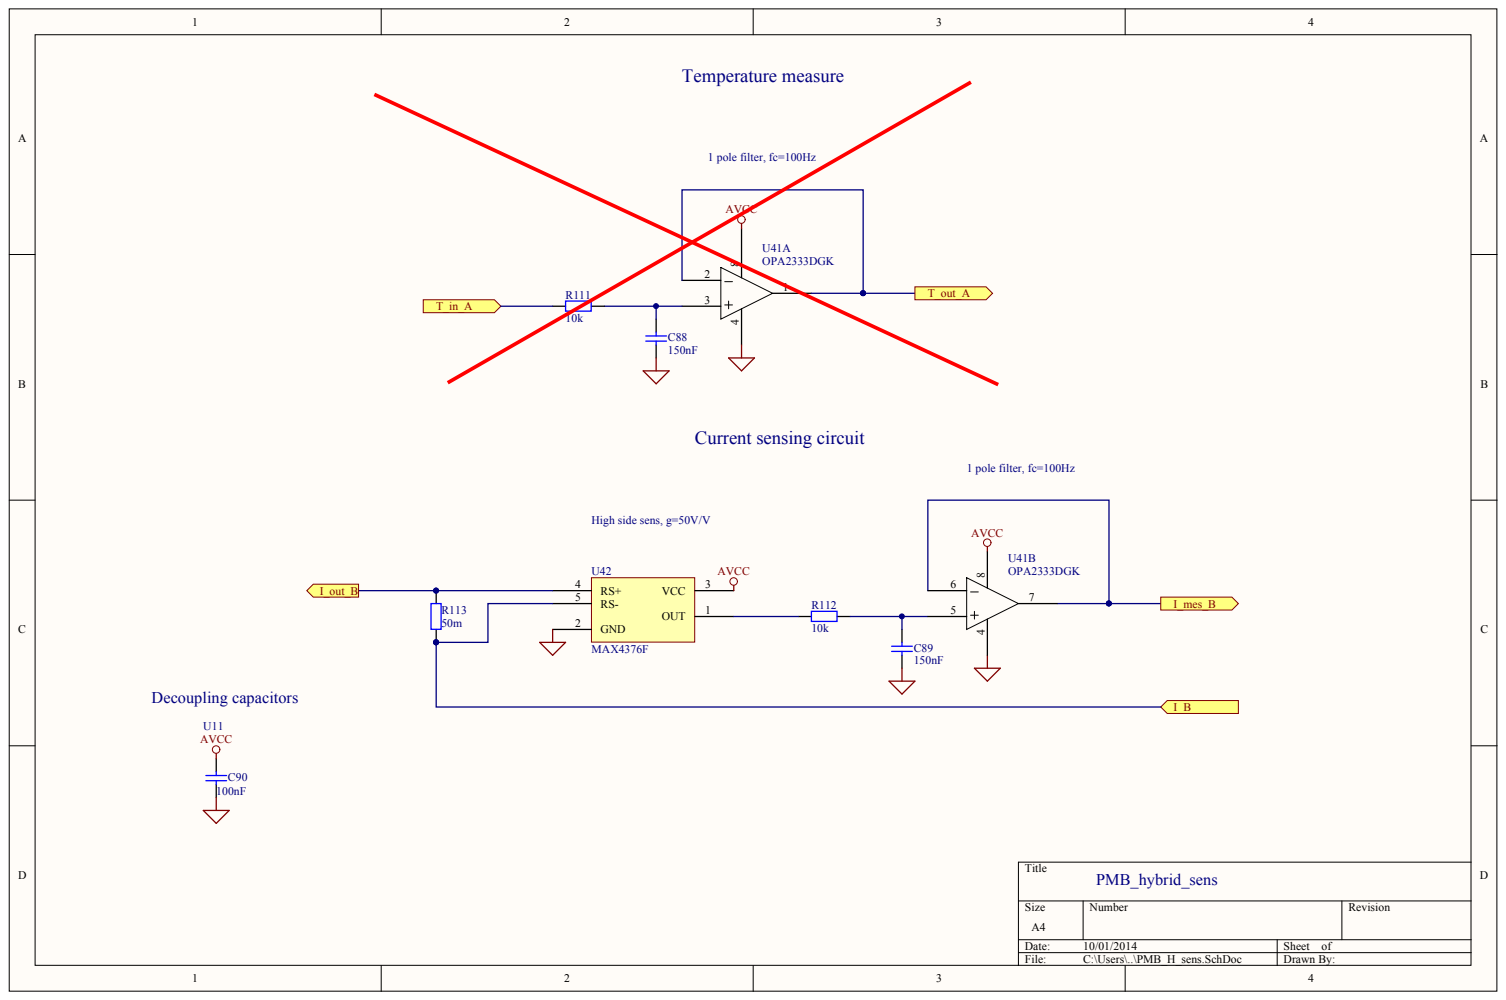
[picture p26: page 16]
