Octanis1/Octanis1-Electronics/octanis_main_pcb_v0.4/octanis_v0.4.pdf

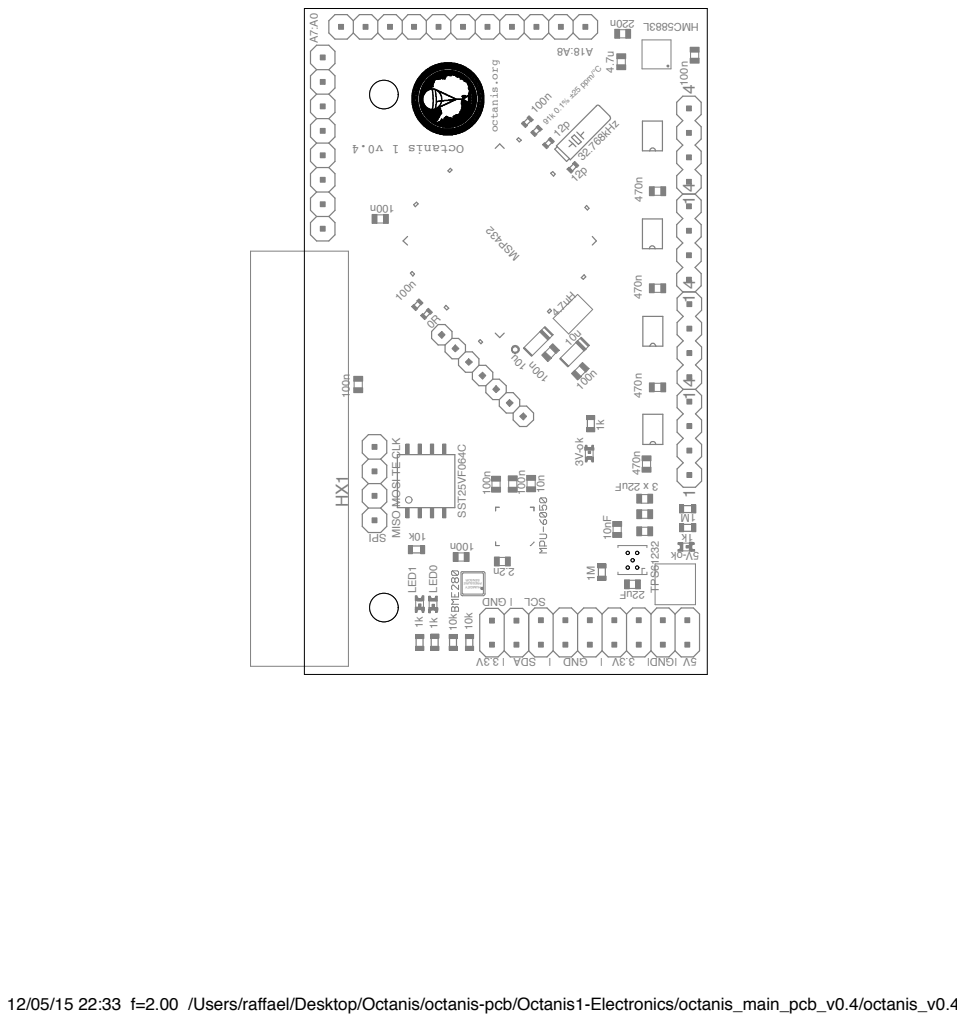
[picture p34: page 1]
octanis.org; TPS61232; 32.768kHz; SST25VF064C; LED0 1k; LED1 1k; MSP432; 91k 0.1% ±25 ppm/°C

MISO MOSI TE CLK

12/05/15 22:33 f=2.00 /Users/raffael/Desktop/Octanis/octanis-pcb/Octanis1-Electronics/octanis_main_pcb_v0.4/octanis_v0.4.brd
