Octanis1/Octanis1-Electronics/octanis_eps/v2.0/octanis_eps_v2.brd

## EAGLE design octanis_eps/v2.0/octanis_eps_v2.brd (2016-06-23)

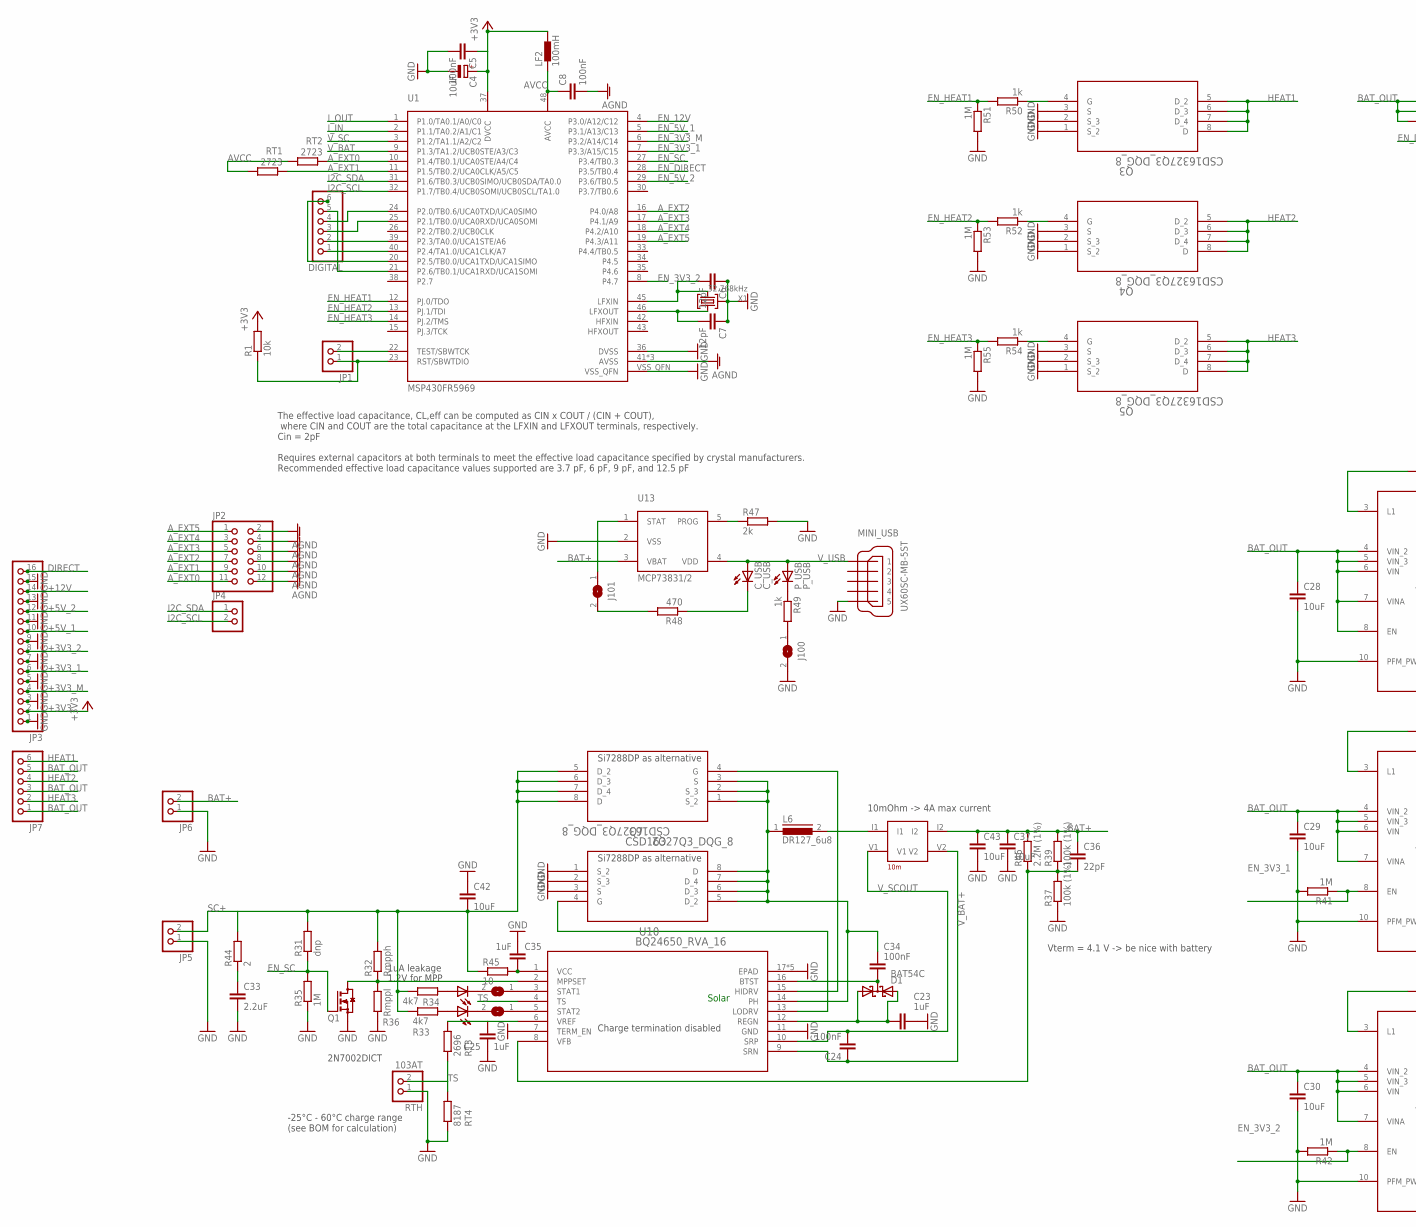
[picture p35: schematic octanis_eps_v2.sch, part in row 1, column 1]

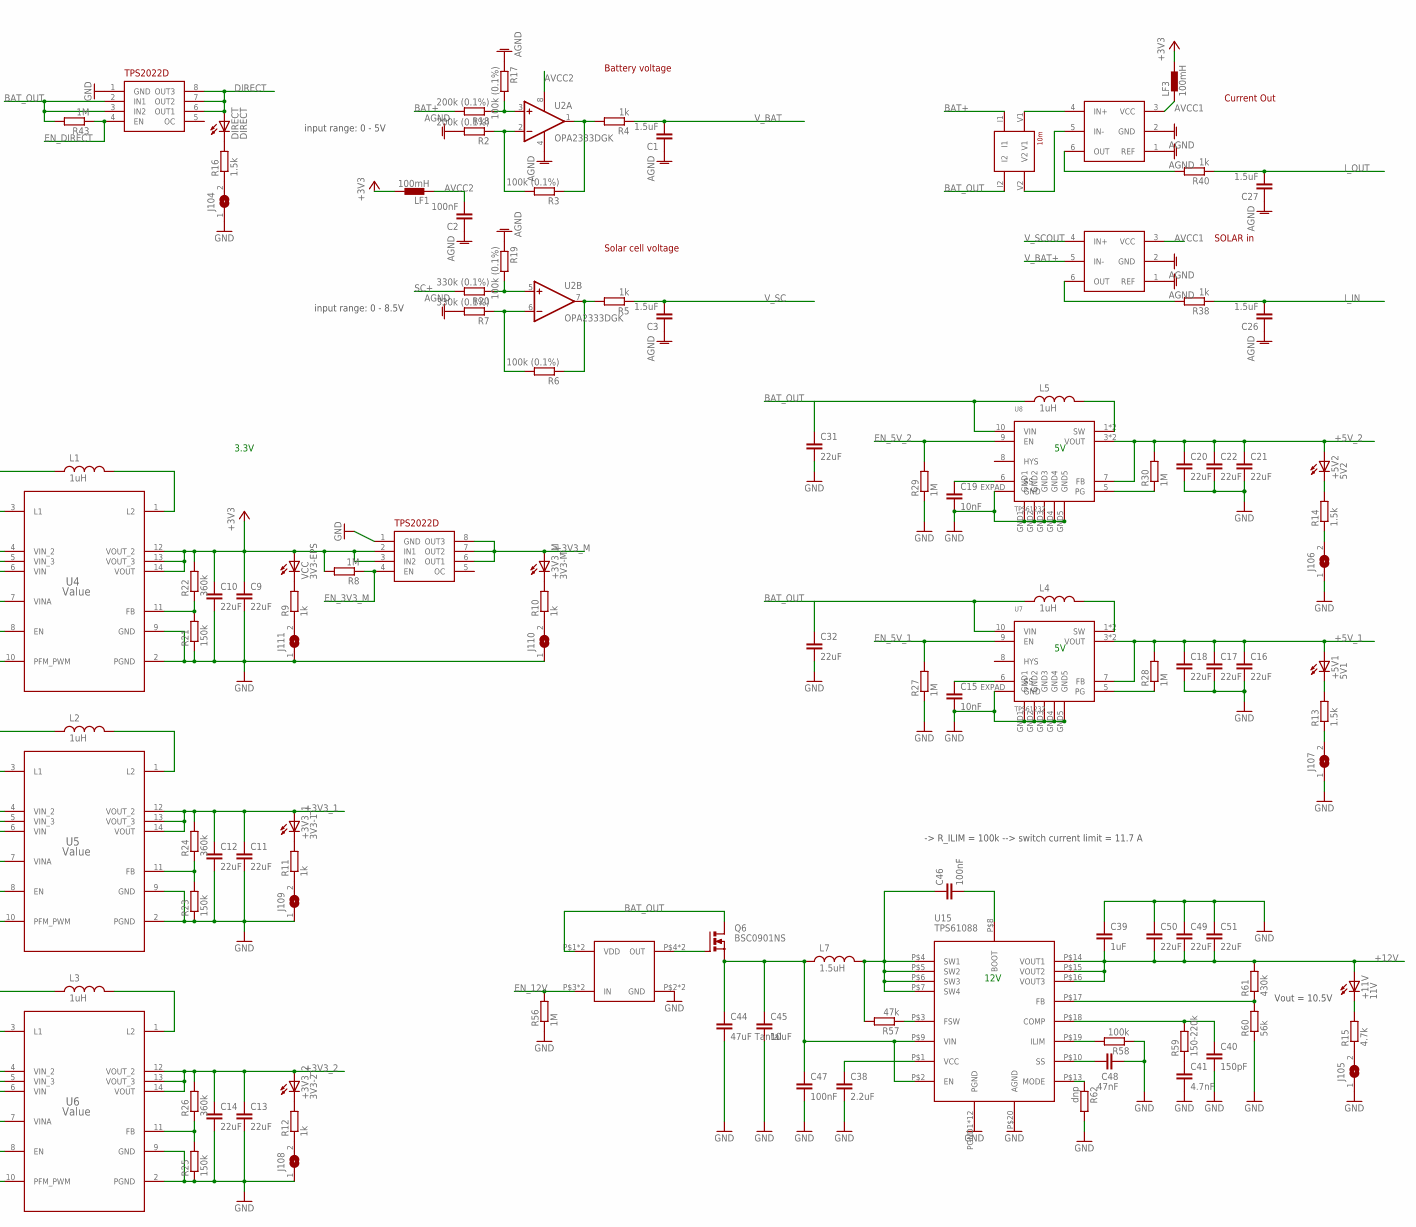
[picture p36: schematic octanis_eps_v2.sch, part in row 1, column 2]

Parts:
+3V3_1: 3V3-1; CHIPLED_0603
+3V3_2: 3V3-2; CHIPLED_0603
+3V3_M: 3V3-M; CHIPLED_0603
+5V1: 5V1; CHIPLED_0603
+5V2: 5V2; CHIPLED_0603
+11V: 11V; CHIPLED_0603
C1, C3, C26, C27: 1.5uF; C0603
C2, C5, C8, C24, C34, C46, C47: 100nF; C0603
C4: 10uF; A/3216-18R
C6, C7: 12pF; C0603
C9, C10, C11, C12, C13, C14, C16, C17, C18, C20, C21, C22, C31, C32, C49, C50, C51: 22uF; C0805
C15, C19: 10nF; C0603
C23, C25, C35, C39: 1uF; C0603
C28, C29, C30, C37, C42, C43, C45: 10uF; C0805
C33, C38: 2.2uF; C0603
C36: 22pF; C0603
C40: 150pF; C0603
C41: 4.7nF; C0603
C44: 47uF Tantal; C1210
C48: 47nF; C0603
C_USB: C_USB; CHIPLED_0603
D1: BAT54C; SOT23
DIGITAL: PINHD-1X6B; 1X06-BIG
DIRECT: DIRECT; CHIPLED_0603
J100, J101, J102, J103, J104, J105, J106, J107, J108, J109, J110, J111: SJ
JP1, JP4, JP5, JP6: PINHD-1X2; 1X02
JP2: PINHD-2X6; 2X06
JP3: PINHD-1X16; 1X16
JP7: PINHD-1X6; 1X06
L1, L2, L3, L4, L5: 1uH; XFL4020
L6: DR127_6u8; DR127
L7: 1.5uH; XFL4020
LF1, LF2, LF3: 100mH; 0402
MINI_USB: UX60SC-MB-5ST
P_USB: P_USB; CHIPLED_0603
Q1: BSS123; SOT23
Q2, Q3, Q4, Q5, Q7: CSD16327Q3_DQG_8; DQG8
Q6: BSC0901NS; PG-TDSON-8
R1: 10k; R0603
R2, R18: 200k (0.1%); R0603
R3, R6, R17, R19: 100k (0.1%); R0603
R4, R5, R9, R10, R11, R12, R38, R40, R49, R50, R52, R54: 1k; R0603
R7, R20: 330k (0.1%); R0603
R8, R27, R28, R29, R30, R35, R41, R42, R43, R51, R53, R55, R56: 1M; R0603
R13, R14, R16: 1.5k; R0603
R15: 4.7k; R0603
R21, R23, R25: 150k; R0603
R22, R24, R26: 360k; R0603
R31, R62: dnp; R0603
R32: Rmpph; R0603
R33, R34: 4k7; R0603
R36: Rmppl; R0603
R37, R39: 100k (1%); R0603
R44: 2; R2010
R45: 10; R1206
R46: 2.2M (1%); R0603
R47: 2k; R0603
R48: 470; R0603
R57: 47k; R0603
R58: 100k; R0603
R59: 150-220k; R0603
R60: 56k; R0603
R61: 430k; R0603
RS1, RS2: 10m; 4PADS_RESISTOR
RT1, RT2: 2723; R0603
RT3: 2696; R0603
RT4: 8187; R0603
RTH: 103AT; 1X02
STAT1, STAT2: 5V-ok; CHIPLED_0603
U1: MSP430FR5969; S-PVQFN-N48
U2: OPA2333DGK; MSOP08
U3, U9: TPS2022D; SO8
U4, U5, U6: Value; RNC0014A
U7, U8: TPS61232; S-PVSON-N10
U10: BQ24650_RVA_16; RVA16_2P14X2P14
U11, U12: INA213; SC70-6
U13: MCP73831/2; SOT23-5
U14: MIC5019; QFN-4
U15: TPS61088; R-PVQFN-N20
VCC: 3V3-EPS; CHIPLED_0603
X1: 32.768kHz; MS3V-T1R

Connections:
+3V3: C4.+, C5.1, C9.1, C10.1, JP3.2, LF1.2, LF2.2, LF3.2, R1.2, R8.2, R22.2, U1.37 (DVCC), U3.2 (IN1), U3.3 (IN2), U4.12 (VOUT_2), U4.13 (VOUT_3), U4.14 (VOUT), VCC.A
+3V3_1: +3V3_1.A, C11.1, C12.1, JP3.6, R24.2, U5.12 (VOUT_2), U5.13 (VOUT_3), U5.14 (VOUT)
+3V3_2: +3V3_2.A, C13.1, C14.1, JP3.8, R26.2, U6.12 (VOUT_2), U6.13 (VOUT_3), U6.14 (VOUT)
+3V3_M: +3V3_M.A, JP3.4, U3.6 (OUT1), U3.7 (OUT2), U3.8 (OUT3)
+5V_1: +5V1.A, C16.1, C17.1, C18.1, JP3.10, R28.2, U7.3 (VOUT), U7.4 (VOUT), U7.7 (FB)
+5V_2: +5V2.A, C20.1, C21.1, C22.1, JP3.12, R30.2, U8.3 (VOUT), U8.4 (VOUT), U8.7 (FB)
+12V: +11V.A, C39.2, C49.2, C50.2, C51.2, JP3.14, R61.2, U15.P$14 (VOUT1), U15.P$15 (VOUT2), U15.P$16 (VOUT3)
AGND: C1.1, C2.1, C3.1, C8.2, C26.1, C27.1, JP2.2, JP2.4, JP2.6, JP2.8, JP2.10, JP2.12, R2.2, R7.2, R17.1, R19.1, U1.41 (AVSS), U1.44 (AVSS), U1.47 (AVSS), U2.4 (V-), U11.1 (REF), U11.2 (GND), U12.1 (REF), U12.2 (GND)
AVCC: C8.1, LF2.1, RT1.1, RT2.1, U1.48 (AVCC)
AVCC1: LF3.1, U11.3 (VCC), U12.3 (VCC)
AVCC2: C2.2, LF1.1, U2.8 (V+)
A_EXT0: JP2.11, RT2.2, U1.10 (P1.4/TB0.1/UCA0STE/A4/C4)
A_EXT1: JP2.9, RT1.2, U1.11 (P1.5/TB0.2/UCA0CLK/A5/C5)
A_EXT2: JP2.7, U1.16 (P4.0/A8)
A_EXT3: JP2.5, U1.17 (P4.1/A9)
A_EXT4: JP2.3, U1.18 (P4.2/A10)
A_EXT5: JP2.1, U1.19 (P4.3/A11)
BAT+: C36.1, C37.1, C43.1, JP6.2, R18.2, R39.2, R46.2, RS1.I1, RS2.I2, U13.3 (VBAT)
BAT_11V: C44.1, C45.1, C47.1, L7.P$1 (1), Q6.1 (S), Q6.2 (S), Q6.3 (S), U15.P$2 (EN), U15.P$9 (VIN)
BAT_OUT: C28.1, C29.1, C30.1, C31.1, C32.1, JP7.1, JP7.3, JP7.5, L4.P$1 (1), L5.P$1 (1), Q6.5 (D), Q6.6 (D), Q6.7 (D), Q6.8 (D), R43.2, RS1.I2, U4.4 (VIN_2), U4.5 (VIN_3), U4.6 (VIN), U4.7 (VINA), U4.8 (EN), U5.4 (VIN_2), U5.5 (VIN_3), U5.6 (VIN), U5.7 (VINA), U6.4 (VIN_2), U6.5 (VIN_3), U6.6 (VIN), U6.7 (VINA), U7.10 (VIN), U8.10 (VIN), U9.2 (IN1), U9.3 (IN2), U14.P1 (VDD), U14.P$1 (VDD)
DIRECT: DIRECT.A, JP3.16, U9.6 (OUT1), U9.7 (OUT2), U9.8 (OUT3)
EN_3V3_1: R41.1, U1.7 (P3.3/A15/C15), U5.8 (EN)
EN_3V3_2: R42.1, U1.8 (P4.7), U6.8 (EN)
EN_3V3_M: R8.1, U1.6 (P3.2/A14/C14), U3.4 (EN)
EN_5V_1: R27.2, U1.5 (P3.1/A13/C13), U7.9 (EN)
EN_5V_2: R29.2, U1.29 (P3.6/TB0.5), U8.9 (EN)
EN_12V: R56.2, U1.4 (P3.0/A12/C12), U14.P3 (IN), U14.P$3 (IN)
EN_DIRECT: R43.1, U1.28 (P3.5/TB0.4), U9.4 (EN)
EN_HEAT1: R50.2, R51.1, U1.12 (PJ.0/TDO)
EN_HEAT2: R52.2, R53.1, U1.13 (PJ.1/TDI)
EN_HEAT3: R54.2, R55.1, U1.14 (PJ.2/TMS)
EN_SC: Q1.1 (G), R31.1, R35.2, U1.27 (P3.4/TB0.3)
GND: C4.-, C5.2, C6.1, C7.1, C9.2, C10.2, C11.2, C12.2, C13.2, C14.2, C15.2, C16.2, C17.2, C18.2, C19.2, C20.2, C21.2, C22.2, C23.2, C25.2, C28.2, C29.2, C30.2, C31.2, C32.2, C33.2, C35.2, C37.2, C38.2, C39.1, C40.2, C41.2, C42.1, C43.2, C44.2, C45.2, C47.2, C48.2, C49.1, C50.1, C51.1, J100.2, J104.1, J105.1, J106.1, J107.1, J108.1, J109.1, J110.1, J111.1, JP3.1, JP3.3, JP3.5, JP3.7, JP3.9, JP3.11, JP3.13, JP3.15, JP5.1, JP6.1, MINI_USB.5, Q1.2 (S), Q3.1 (S_2), Q3.2 (S_3), Q3.3 (S), Q4.1 (S_2), Q4.2 (S_3), Q4.3 (S), Q5.1 (S_2), Q5.2 (S_3), Q5.3 (S), Q7.1 (S_2), Q7.2 (S_3), Q7.3 (S), R21.1, R23.1, R25.1, R27.1, R29.1, R35.1, R36.1, R37.1, R41.2, R42.2, R47.2, R51.2, R53.2, R55.2, R56.1, R58.1, R60.1, R62.2, RT4.2, RTH.1, U1.36 (DVSS), U1.VSS_QFN, U3.1 (GND), U4.2 (PGND), U4.9 (GND), U4.10 (PFM_PWM), U5.2 (PGND), U5.9 (GND), U5.10 (PFM_PWM), U6.2 (PGND), U6.9 (GND), U6.10 (PFM_PWM), U7.EXPAD (GND), U7.GND1, U7.GND2, U7.GND3, U7.GND4, U7.GND5, U8.EXPAD (GND), U8.GND1, U8.GND2, U8.GND3, U8.GND4, U8.GND5, U9.1 (GND), U10.7 (TERM_EN), U10.11 (GND), U10.17 (EPAD), U10.V (EPAD), U10.V_1 (EPAD), U10.V_2 (EPAD), U10.V_3 (EPAD), U13.2 (VSS), U14.P2 (GND), U14.P$2 (GND), U15.P$20 (AGND), U15.PGND1 (PGND), U15.PGND2 (PGND), U15.PGND3 (PGND), U15.PGND4 (PGND), U15.PGND5 (PGND), U15.PGND6 (PGND), U15.PGND7 (PGND), U15.PGND8 (PGND), U15.PGND9 (PGND), U15.PGND10 (PGND), U15.PGND11 (PGND), U15.PGND12 (PGND), X1.P3 (GND)
HEAT1: JP7.6, Q3.5 (D_2), Q3.6 (D_3), Q3.7 (D_4), Q3.8 (D)
HEAT2: JP7.4, Q4.5 (D_2), Q4.6 (D_3), Q4.7 (D_4), Q4.8 (D)
HEAT3: JP7.2, Q5.5 (D_2), Q5.6 (D_3), Q5.7 (D_4), Q5.8 (D)
I2C_SCL: JP4.2, U1.32 (P1.7/TB0.4/UCB0SOMI/UCB0SCL/TA1.0)
I2C_SDA: JP4.1, U1.31 (P1.6/TB0.3/UCB0SIMO/UCB0SDA/TA0.0)
IND: L4.P$2 (2), U7.1 (SW), U7.2 (SW)
IND1: L5.P$2 (2), U8.1 (SW), U8.2 (SW)
I_IN: C26.2, R38.1, U1.2 (P1.1/TA0.2/A1/C1)
I_OUT: C27.2, R40.1, U1.1 (P1.0/TA0.1/A0/C0)
LED1: +5V2.C, R14.2
LED2: DIRECT.C, R16.2
LED5: +5V1.C, R13.2
unnamed: L1.P$1 (1), U4.3 (L1)
unnamed: R28.1, U7.5 (PG)
unnamed: L1.P$2 (2), U4.1 (L2)
unnamed: L6.2, RS2.I1
unnamed: C15.1, U7.6 (SS)
unnamed: L2.P$1 (1), U5.3 (L1)
unnamed: L2.P$2 (2), U5.1 (L2)
unnamed: R62.1, U15.P$13 (MODE)
unnamed: Q6.4 (G), U14.P4 (OUT), U14.P$4 (OUT)
unnamed: L3.P$1 (1), U6.3 (L1)
unnamed: L3.P$2 (2), U6.1 (L2)
unnamed: JP1.1, R1.1, U1.23 (RST/SBWTDIO)
unnamed: J107.2, R13.1
unnamed: JP1.2, U1.22 (TEST/SBWTCK)
unnamed: C7.2, U1.46 (LFXOUT), X1.P1 (1)
unnamed: C6.2, U1.45 (LFXIN), X1.P2 (2)
unnamed: DIGITAL.3, U1.25 (P2.1/TB0.0/UCA0RXD/UCA0SOMI)
unnamed: R3.1, R4.2, U2.1 (OUT)
unnamed: R2.1, R3.2, U2.2 (-IN)
unnamed: R17.2, R18.1, U2.3 (+IN)
unnamed: R5.2, R6.1, U2.7 (OUT)
unnamed: R6.2, R7.1, U2.6 (-IN)
unnamed: R19.2, R20.1, U2.5 (+IN)
unnamed: R40.2, U11.6 (OUT)
unnamed: R38.2, U12.6 (OUT)
unnamed: Q5.4 (G), R54.1
unnamed: DIGITAL.4, U1.24 (P2.0/TB0.6/UCA0TXD/UCA0SIMO)
unnamed: DIGITAL.2, U1.39 (P2.3/TA0.0/UCA1STE/A6)
unnamed: DIGITAL.1, U1.40 (P2.4/TA1.0/UCA1CLK/A7)
unnamed: Q4.4 (G), R52.1
unnamed: RS1.V1, U11.4 (IN+)
unnamed: RS1.V2, U11.5 (IN-)
unnamed: R21.2, R22.1, U4.11 (FB)
unnamed: R23.2, R24.1, U5.11 (FB)
unnamed: DIGITAL.5, U1.21 (P2.6/TB0.1/UCA1RXD/UCA1SOMI)
unnamed: Q3.4 (G), R50.1
unnamed: C46.2, U15.P$8 (BOOT)
unnamed: +3V3_M.C, R10.2
unnamed: J110.2, R10.1
unnamed: DIGITAL.6, U1.20 (P2.5/TB0.0/UCA1TXD/UCA1SIMO)
unnamed: C33.1, R44.1
unnamed: R9.2, VCC.C
unnamed: R30.1, U8.5 (PG)
unnamed: J111.2, R9.1
unnamed: +3V3_2.C, R12.2
unnamed: J108.2, R12.1
unnamed: +11V.C, R15.2
unnamed: J105.2, R15.1
unnamed: C46.1, L7.P$2 (2), R57.2, U15.P$4 (SW1), U15.P$5 (SW2), U15.P$6 (SW3), U15.P$7 (SW4)
unnamed: +3V3_1.C, R11.2
unnamed: J109.2, R11.1
unnamed: R57.1, U15.P$3 (FSW)
unnamed: C41.1, R59.1
unnamed: J106.2, R14.1
unnamed: C48.1, U15.P$10 (SS)
unnamed: R58.2, U15.P$19 (ILIM)
unnamed: C40.1, R59.2, U15.P$18 (COMP)
unnamed: C38.1, U15.P$1 (VCC)
unnamed: R60.2, R61.1, U15.P$17 (FB)
unnamed: C19.1, U8.6 (SS)
unnamed: R25.2, R26.1, U6.11 (FB)
unnamed: R47.1, U13.5 (PROG)
unnamed: Q1.3 (D), R32.1, R36.2, U10.2 (MPPSET)
unnamed: J101.1, U13.1 (STAT)
unnamed: R34.1, STAT2.A
unnamed: J103.2, STAT1.C
unnamed: J102.2, STAT2.C
unnamed: R33.1, STAT1.A
unnamed: J103.1, U10.5 (STAT2)
unnamed: J102.1, U10.3 (STAT1)
unnamed: C25.1, RT3.1, U10.6 (VREF)
unnamed: C35.1, R45.2, U10.1 (VCC)
unnamed: J101.2, R48.2
unnamed: C_USB.C, R48.1
unnamed: C34.1, L6.1, Q2.1 (S_2), Q2.2 (S_3), Q2.3 (S), Q7.5 (D_2), Q7.6 (D_3), Q7.7 (D_4), Q7.8 (D), U10.14 (PH)
unnamed: J104.2, R16.1
unnamed: P_USB.C, R49.1
unnamed: J100.1, R49.2
unnamed: Q2.4 (G), U10.15 (HIDRV)
unnamed: Q7.4 (G), U10.13 (LODRV)
unnamed: C36.2, R37.2, R39.1, R46.1, U10.8 (VFB)
unnamed: C23.1, D1.1 (A1), D1.2 (A2), U10.12 (REGN)
unnamed: C34.2, D1.3 (CC), U10.16 (BTST)
SC+: C42.2, JP5.2, Q2.5 (D_2), Q2.6 (D_3), Q2.7 (D_4), Q2.8 (D), R20.2, R31.2, R32.2, R33.2, R34.2, R44.2, R45.1
TS: RT3.2, RT4.1, RTH.2, U10.4 (TS)
V_BAT: C1.2, R4.1, U1.9 (P1.3/TA1.2/UCB0STE/A3/C3)
V_BAT+: C24.1, RS2.V2, U10.9 (SRN), U12.5 (IN-)
V_SC: C3.2, R5.1, U1.3 (P1.2/TA1.1/A2/C2)
V_SCOUT: C24.2, RS2.V1, U10.10 (SRP), U12.4 (IN+)
V_USB: C_USB.A, MINI_USB.1, P_USB.A, U13.4 (VDD)

Notes on the sheet:
Solar
3.3V
12V
Battery voltage
Solar cell voltage
SOLAR in
Current Out
Vout = 10.5V
1.2V for MPP
1uA leakage
Charge termination disabled
Vterm = 4.1 V -> be nice with battery
10mOhm -> 4A max current
2N7002DICT
Si7288DP as alternative
-> R_ILIM = 100k --> switch current limit = 11.7 A
The effective load capacitance, CL,eff can be computed as CIN x COUT / (CIN + COUT), where CIN and COUT are the total capacitance at the LFXIN and LFXOUT terminals, respectively. Cin = 2pF Requires external capacitors at both terminals to meet the effective load capacitance specified by crystal man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
input range: 0 - 8.5V
input range: 0 - 5V
-25°C - 60°C charge range (see BOM for calculation)

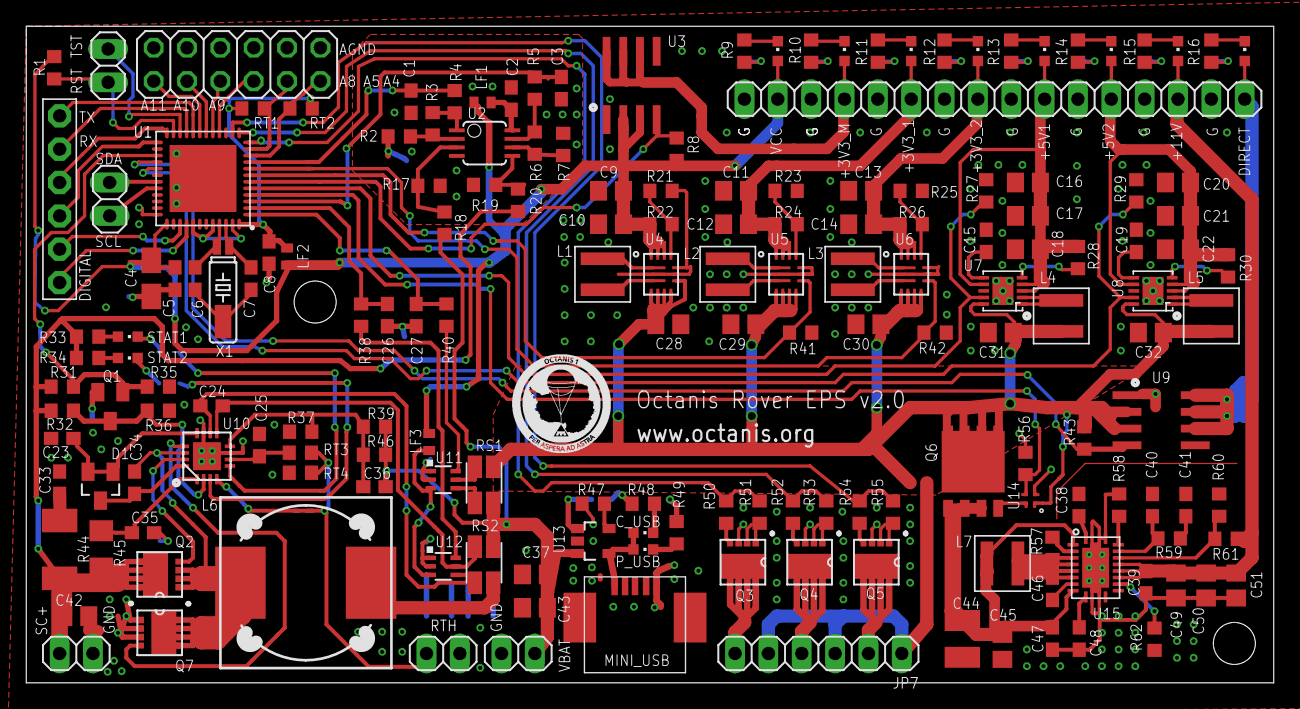
[picture p37: board octanis_eps_v2.brd from above]

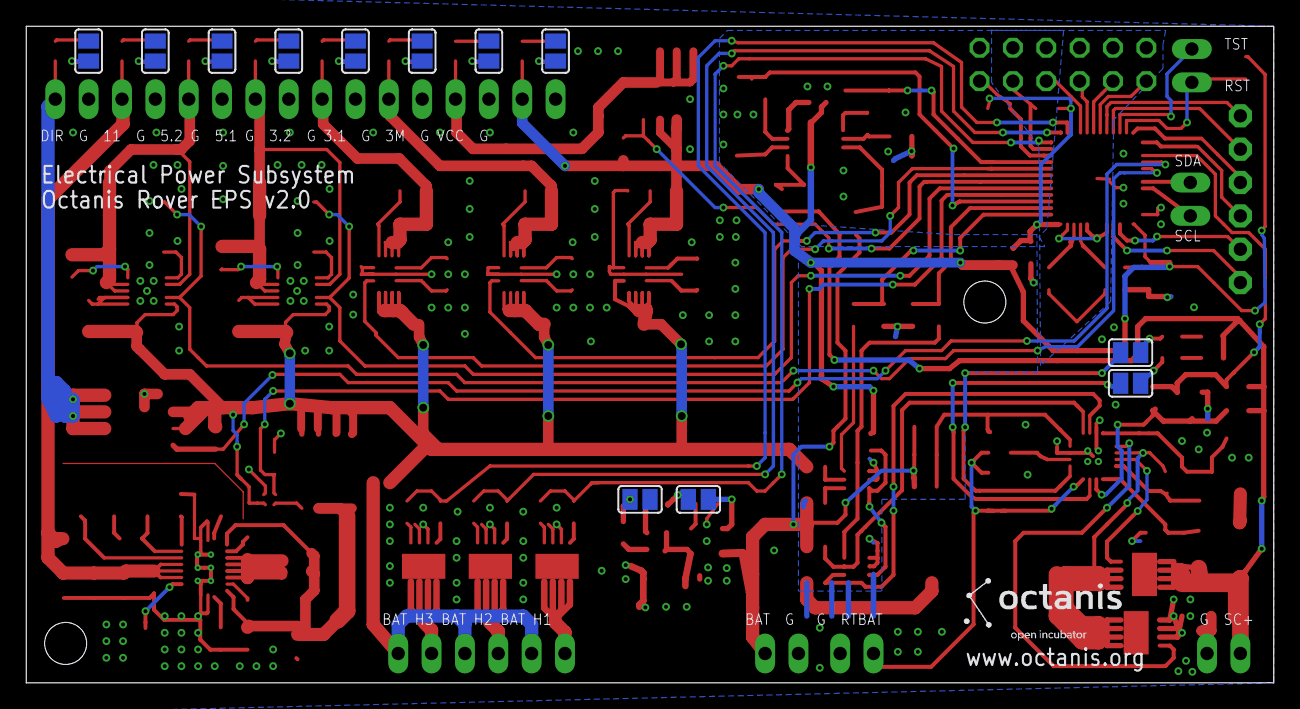
[picture p38: board octanis_eps_v2.brd from below]

Board: 2 copper layers, 95.0 x 50.0 mm, 187 parts (12 on the bottom side), 135 nets.
