Octanis1/Octanis1-Electronics/external_weather_strip/external_strip_v4.brd

## EAGLE design external_weather_strip/external_strip_v4.brd (2016-06-23)

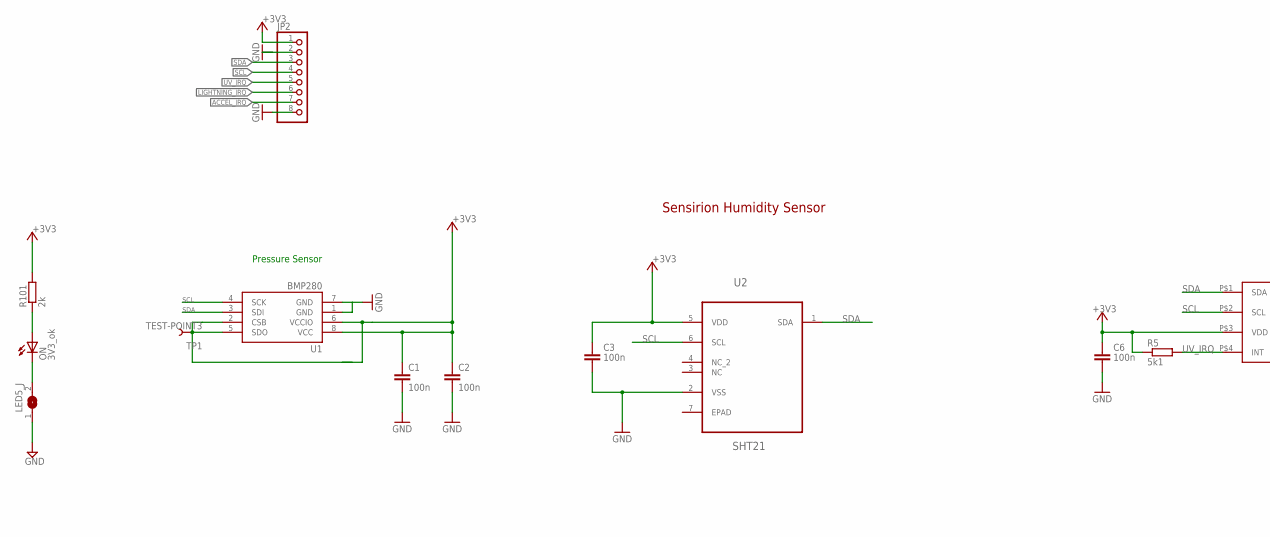
[picture p39: schematic external_strip_v4.sch, part in row 1, column 1]

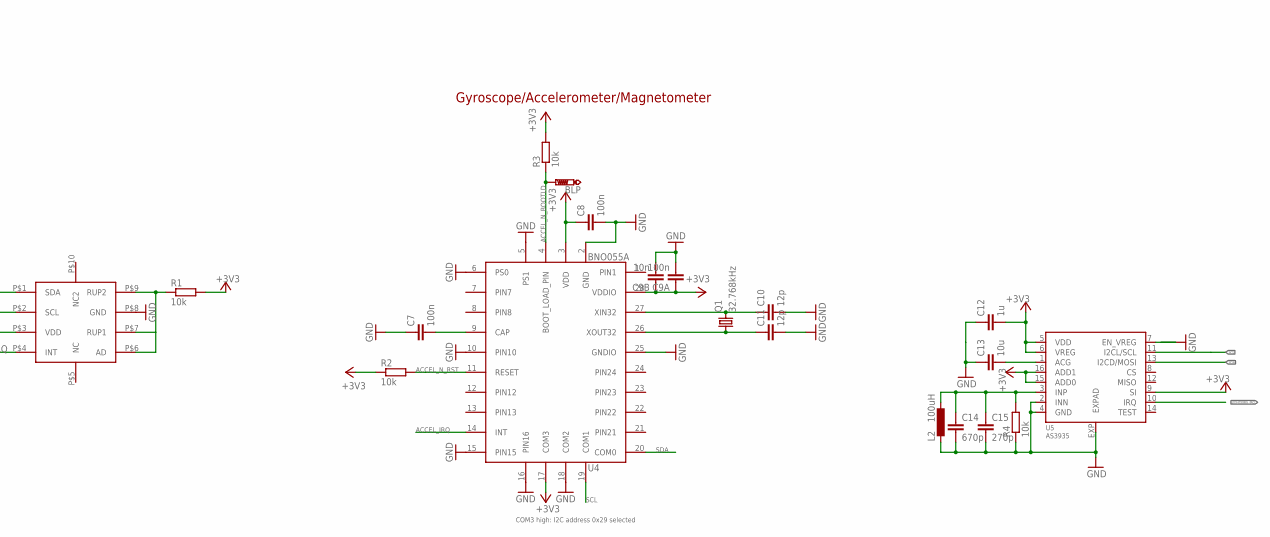
[picture p40: schematic external_strip_v4.sch, part in row 1, column 2]

Parts:
BLP: PTR1B1,27; B1,27
C1, C2, C3, C6, C7, C8, C9A: 100n; C0603
C9B: 10n; C0603
C10, C11: 12p; C0603
C12: 1u; C0603
C13: 10u; C0603
C14: 670p; C0603
C15: 270p; C0603
JP2: PINHD-1X8; 1X08
L2: 100uH; COILCRAFT
LED5_J: SJ
ON: 3V3_ok; CHIPLED_0603
Q1: 32.768kHz; FC-12M
R1, R2, R3, R4: 10k; R0603
R5: 5k1; R0603
R101: 2k; R0603
TP1: TEST-POINT3; PAD.03X.03
U1: BMP280; LGA8
U2: SHT21; DFN300X300X110-7N
U3: SI1133; DFN2X2
U4: BNO055A; BNO055
U5: AS3935; 16LDMLPQ

Connections:
+3V3: C1.1, C2.1, C3.1, C6.1, C8.1, C9A.1, C9B.1, C12.2, JP2.1, R1.2, R2.1, R3.2, R5.1, R101.2, TP1.P$1, U1.2 (CSB), U1.5 (SDO), U1.6 (VCCIO), U1.8 (VCC), U2.5 (VDD), U3.P$3 (VDD), U4.3 (VDD), U4.17 (COM3), U4.28 (VDDIO), U5.5 (VDD), U5.6 (VREG), U5.9 (SI), U5.15 (ADD0), U5.16 (ADD1)
ACCEL_IRQ: JP2.7, U4.14 (INT)
ACCEL_N_BOOTLD: BLP.TP, R3.1, U4.4 (BOOT_LOAD_PIN)
ACCEL_N_RST: R2.2, U4.11 (RESET)
GND: C1.2, C2.2, C3.2, C6.2, C7.1, C8.2, C9A.2, C9B.2, C10.2, C11.2, C12.1, C13.1, C14.2, C15.2, JP2.2, JP2.8, L2.2, LED5_J.1, R4.1, U1.1 (GND), U1.7 (GND), U2.2 (VSS), U3.P$8 (GND), U4.2 (GND), U4.5 (PS1), U4.6 (PS0), U4.10 (PIN10), U4.15 (PIN15), U4.16 (PIN16), U4.18 (COM2), U4.25 (GNDIO), U5.2 (INN), U5.4 (GND), U5.7 (EN_VREG), U5.EXP (EXPAD)
LIGHTNING_IRQ: JP2.6, U5.10 (IRQ)
unnamed: C13.2, U5.1 (ACG)
unnamed: LED5_J.2, ON.C
unnamed: C14.1, C15.1, L2.1, R4.2, U5.3 (INP)
unnamed: ON.A, R101.1
unnamed: R1.1, U3.P$6 (AD), U3.P$7 (RUP1), U3.P$9 (RUP2)
unnamed: C7.2, U4.9 (CAP)
unnamed: C10.1, Q1.2, U4.27 (XIN32)
unnamed: C11.1, Q1.1, U4.26 (XOUT32)
SCL: JP2.4, U1.4 (SCK), U2.6 (SCL), U3.P$2 (SCL), U4.19 (COM1), U5.11 (I2CL/SCL)
SDA: JP2.3, U1.3 (SDI), U2.1 (SDA), U3.P$1 (SDA), U4.20 (COM0), U5.13 (I2CD/MOSI)
UV_IRQ: JP2.5, R5.2, U3.P$4 (INT)

Notes on the sheet:
Sensirion Humidity Sensor
Pressure Sensor
Gyroscope/Accelerometer/Magnetometer
COM3 high: I2C address 0x29 selected

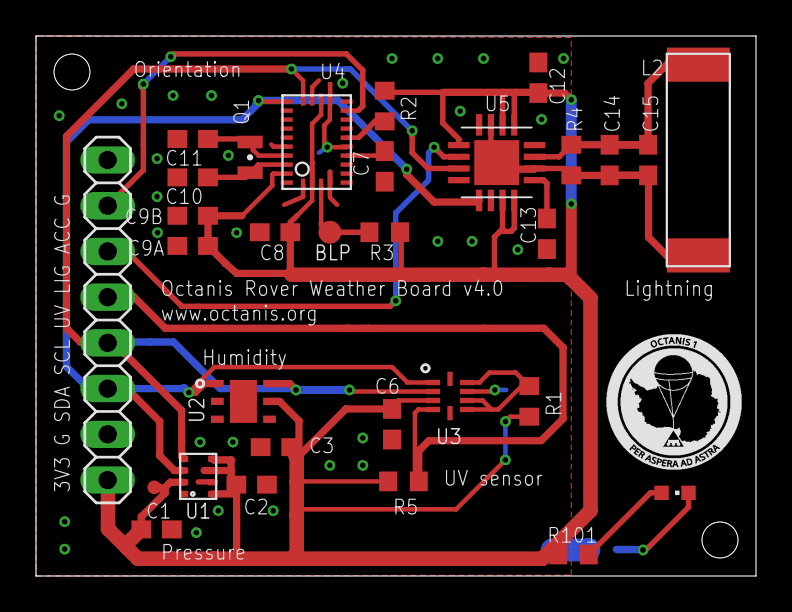
[picture p41: board external_strip_v4.brd from above]

Board: 2 copper layers, 40.0 x 30.0 mm, 32 parts (1 on the bottom side), 17 nets.
