Octanis1/Octanis1-Electronics/octanis_eps/v1.0/octanis_eps_v1.brd

## EAGLE design octanis_eps/v1.0/octanis_eps_v1.brd (2016-06-21, an earlier design)

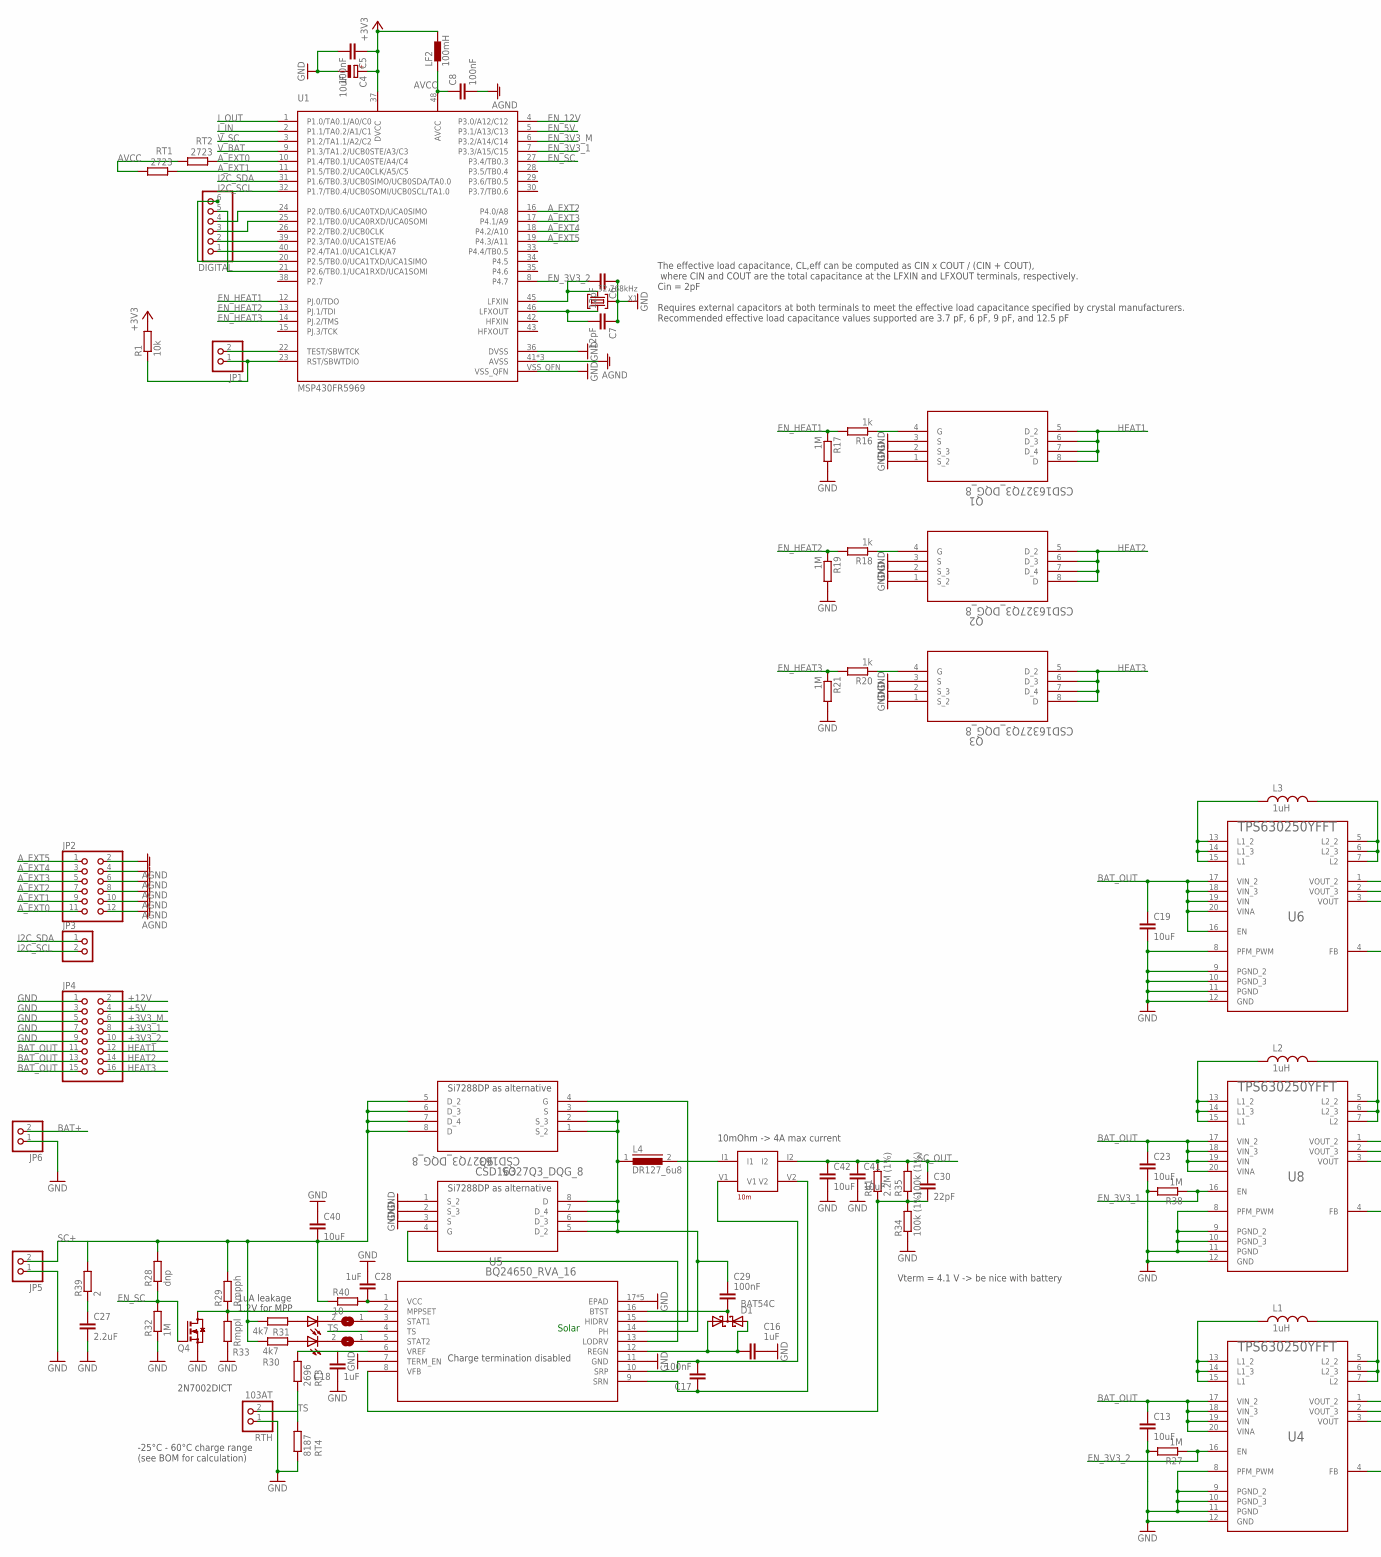
[picture p42: schematic octanis_eps_v1.sch, part in row 1, column 1]

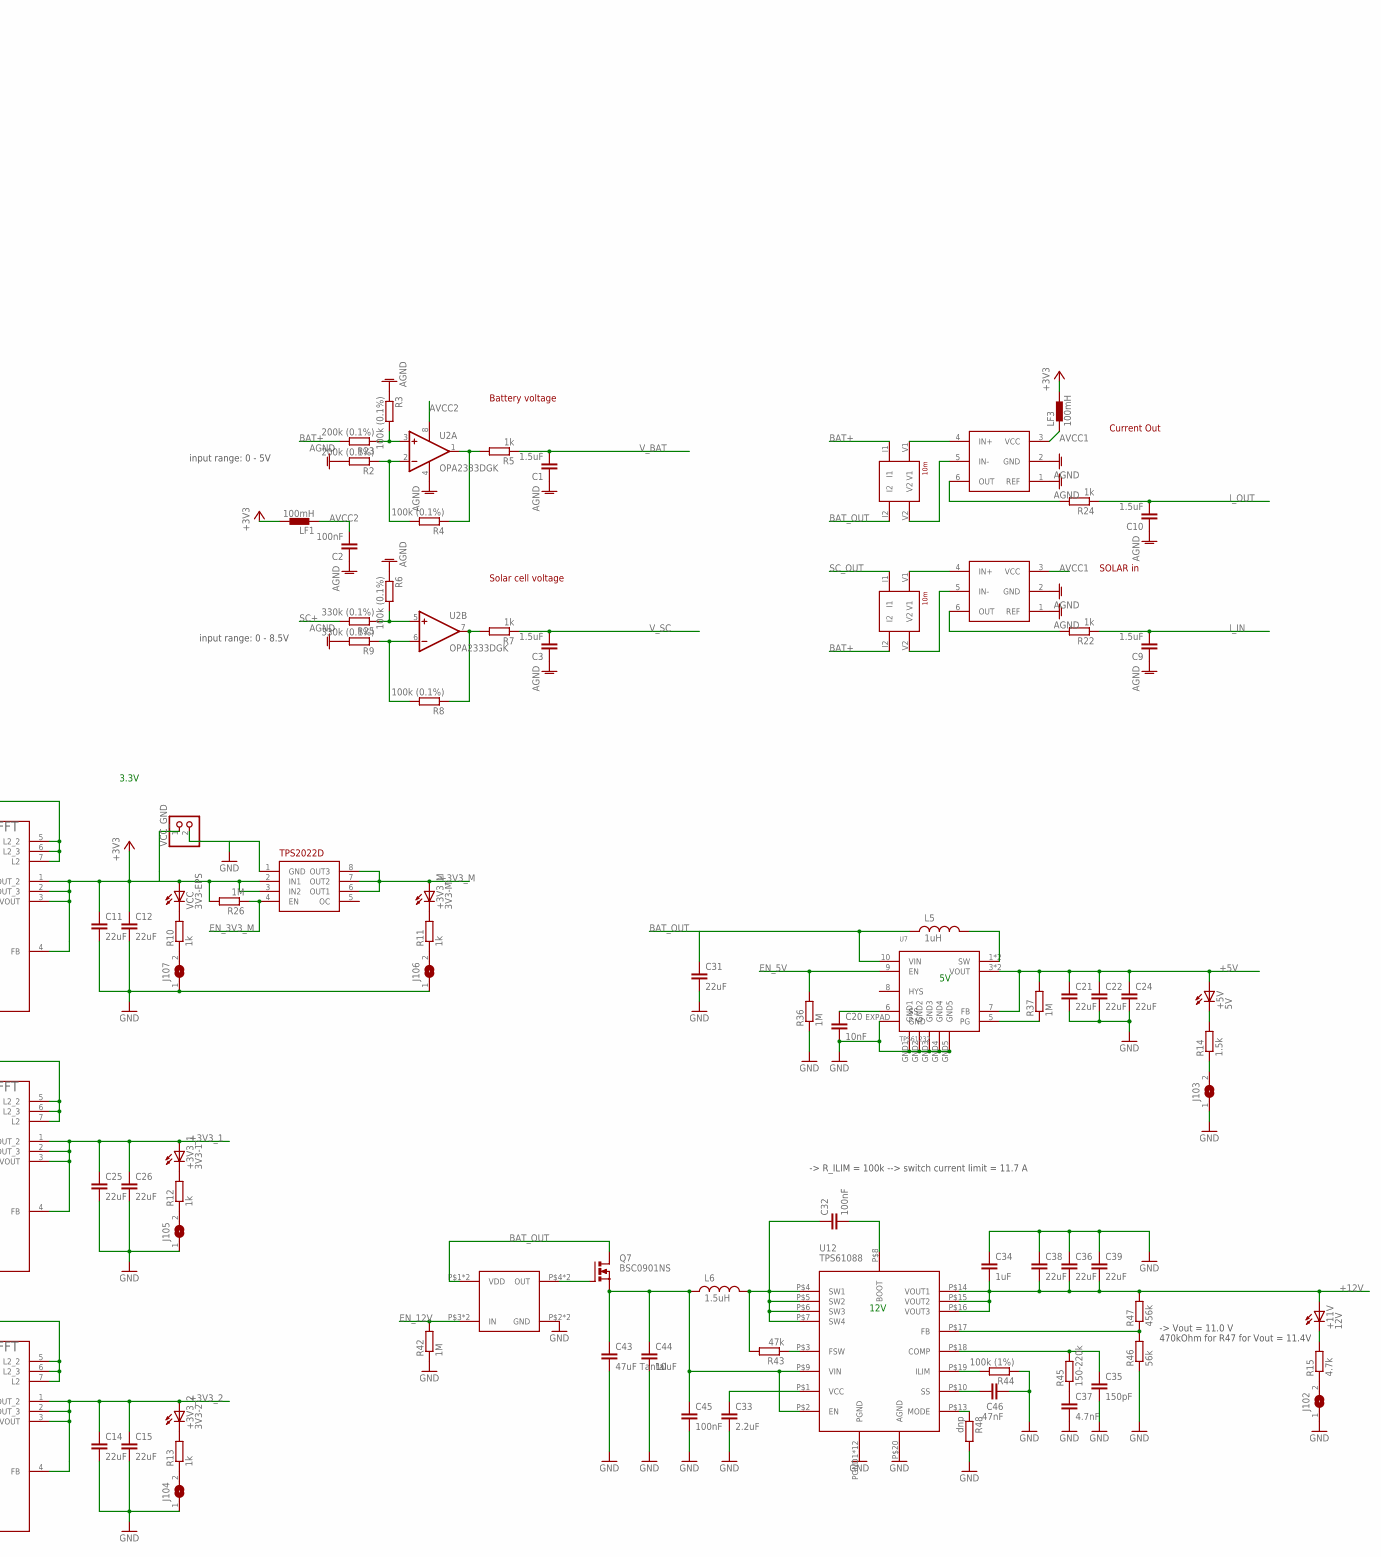
[picture p43: schematic octanis_eps_v1.sch, part in row 1, column 2]

Parts:
+3V3_1: 3V3-1; CHIPLED_0603
+3V3_2: 3V3-2; CHIPLED_0603
+3V3_M: 3V3-M; CHIPLED_0603
+5V: 5V; CHIPLED_0603
+11V: 12V; CHIPLED_0603
C1, C3, C9, C10: 1.5uF; C0603
C2, C5, C8, C17, C29, C32, C45: 100nF; C0603
C4: 10uF; A/3216-18R
C6, C7: 12pF; C0603
C11, C12, C14, C15, C21, C22, C24, C25, C26, C36, C38, C39: 22uF; C0805
C13, C19, C23, C40, C41, C42, C44: 10uF; C0805
C16, C18, C28, C34: 1uF; C0603
C20: 10nF; C0603
C27, C33: 2.2uF; C0603
C30: 22pF; C0603
C31: 22uF; C0603
C35: 150pF; C0603
C37: 4.7nF; C0603
C43: 47uF Tantal; C1210
C46: 47nF; C0603
D1: BAT54C; SOT23
DIGITAL: PINHD-1X6B; 1X06-BIG
J100, J101, J102, J103, J104, J105, J106, J107: SJ
JP1, JP3, JP5, JP6: PINHD-1X2; 1X02
JP2: PINHD-2X6; 2X06
JP4: PINHD-2X8; 2X08
L1, L2, L3, L5: 1uH; XFL4020
L4: DR127_6u8; DR127
L6: 1.5uH; XFL4020
LF1, LF2, LF3: 100mH; 0402
Q1, Q2, Q3, Q5, Q6: CSD16327Q3_DQG_8; DQG8
Q4: BSS123; SOT23
Q7: BSC0901NS; PG-TDSON-8
R1: 10k; R0603
R2, R23: 200k (0.1%); R0603
R3, R4, R6, R8: 100k (0.1%); R0603
R5, R7, R10, R11, R12, R13, R16, R18, R20, R22, R24: 1k; R0603
R9, R25: 330k (0.1%); R0603
R14: 1.5k; R0603
R15: 4.7k; R0603
R17, R19, R21, R26, R27, R32, R36, R37, R38, R42: 1M; R0603
R28, R48: dnp; R0603
R29: Rmpph; R0603
R30, R31: 4k7; R0603
R33: Rmppl; R0603
R34, R35, R44: 100k (1%); R0603
R39: 2; R2010
R40: 10; R1206
R41: 2.2M (1%); R0603
R43: 47k; R0603
R45: 150-220k; R0603
R46: 56k; R0603
R47: 456k; R0603
RS1, RS2, RS3: 10m; 4PADS_RESISTOR
RT1, RT2: 2723; R0603
RT3: 2696; R0603
RT4: 8187; R0603
RTH: 103AT; 1X02
STAT1, STAT2: 5V-ok; CHIPLED_0603
U1: MSP430FR5969; S-PVQFN-N48
U2: OPA2333DGK; MSOP08
U3: TPS2022D; SO8
U4, U6, U8: TPS630250YFFT; YFF0020AEBA
U5: BQ24650_RVA_16; RVA16_2P14X2P14
U7: TPS61232; S-PVSON-N10
U9, U10: INA213; SC70-6
U11: MIC5019; QFN-4
U12: TPS61088; R-PVQFN-N20
VCC: 3V3-EPS; CHIPLED_0603
VCC_GND: PINHD-1X2; 1X02
X1: 32.768kHz; MS3V-T1R

Connections:
+3V3: C4.+, C5.1, C11.1, C12.1, LF1.2, LF2.2, LF3.2, R1.2, R26.2, U1.37 (DVCC), U3.2 (IN1), U3.3 (IN2), U6.1 (VOUT_2), U6.2 (VOUT_3), U6.3 (VOUT), U6.4 (FB), VCC.A, VCC_GND.1
+3V3_1: +3V3_1.A, C25.1, C26.1, JP4.8, U8.1 (VOUT_2), U8.2 (VOUT_3), U8.3 (VOUT), U8.4 (FB)
+3V3_2: +3V3_2.A, C14.1, C15.1, JP4.10, U4.1 (VOUT_2), U4.2 (VOUT_3), U4.3 (VOUT), U4.4 (FB)
+3V3_M: +3V3_M.A, JP4.6, U3.6 (OUT1), U3.7 (OUT2), U3.8 (OUT3)
+5V: +5V.A, C21.1, C22.1, C24.1, JP4.4, R37.2, U7.3 (VOUT), U7.4 (VOUT), U7.7 (FB)
+12V: +11V.A, C34.2, C36.2, C38.2, C39.2, JP4.2, R47.2, U12.P$14 (VOUT1), U12.P$15 (VOUT2), U12.P$16 (VOUT3)
AGND: C1.1, C2.1, C3.1, C8.2, C9.1, C10.1, JP2.2, JP2.4, JP2.6, JP2.8, JP2.10, JP2.12, R2.2, R3.1, R6.1, R9.2, U1.41 (AVSS), U1.44 (AVSS), U1.47 (AVSS), U2.4 (V-), U9.1 (REF), U9.2 (GND), U10.1 (REF), U10.2 (GND)
AVCC: C8.1, LF2.1, RT1.1, RT2.1, U1.48 (AVCC)
AVCC1: LF3.1, U9.3 (VCC), U10.3 (VCC)
AVCC2: C2.2, LF1.1, U2.8 (V+)
A_EXT0: JP2.11, RT2.2, U1.10 (P1.4/TB0.1/UCA0STE/A4/C4)
A_EXT1: JP2.9, RT1.2, U1.11 (P1.5/TB0.2/UCA0CLK/A5/C5)
A_EXT2: JP2.7, U1.16 (P4.0/A8)
A_EXT3: JP2.5, U1.17 (P4.1/A9)
A_EXT4: JP2.3, U1.18 (P4.2/A10)
A_EXT5: JP2.1, U1.19 (P4.3/A11)
BAT+: JP6.2, R23.2, RS2.I2, RS3.I1
BAT_11V: C43.1, C44.1, C45.1, L6.P$1 (1), Q7.1 (S), Q7.2 (S), Q7.3 (S), U12.P$2 (EN), U12.P$9 (VIN)
BAT_OUT: C13.1, C19.1, C23.1, C31.1, JP4.11, JP4.13, JP4.15, L5.P$1 (1), Q7.5 (D), Q7.6 (D), Q7.7 (D), Q7.8 (D), RS3.I2, U4.17 (VIN_2), U4.18 (VIN_3), U4.19 (VIN), U4.20 (VINA), U6.16 (EN), U6.17 (VIN_2), U6.18 (VIN_3), U6.19 (VIN), U6.20 (VINA), U7.10 (VIN), U8.17 (VIN_2), U8.18 (VIN_3), U8.19 (VIN), U8.20 (VINA), U11.P1 (VDD), U11.P$1 (VDD)
EN_3V3_1: R38.1, U1.7 (P3.3/A15/C15), U8.16 (EN)
EN_3V3_2: R27.1, U1.8 (P4.7), U4.16 (EN)
EN_3V3_M: R26.1, U1.6 (P3.2/A14/C14), U3.4 (EN)
EN_5V: R36.2, U1.5 (P3.1/A13/C13), U7.9 (EN)
EN_12V: R42.2, U1.4 (P3.0/A12/C12), U11.P3 (IN), U11.P$3 (IN)
EN_HEAT1: R16.2, R17.1, U1.12 (PJ.0/TDO)
EN_HEAT2: R18.2, R19.1, U1.13 (PJ.1/TDI)
EN_HEAT3: R20.2, R21.1, U1.14 (PJ.2/TMS)
EN_SC: Q4.1 (G), R28.1, R32.2, U1.27 (P3.4/TB0.3)
GND: C4.-, C5.2, C6.1, C7.1, C11.2, C12.2, C13.2, C14.2, C15.2, C16.2, C18.2, C19.2, C20.2, C21.2, C22.2, C23.2, C24.2, C25.2, C26.2, C27.2, C28.2, C31.2, C33.2, C34.1, C35.2, C36.1, C37.2, C38.1, C39.1, C40.1, C41.2, C42.2, C43.2, C44.2, C45.2, C46.2, J102.1, J103.1, J104.1, J105.1, J106.1, J107.1, JP4.1, JP4.3, JP4.5, JP4.7, JP4.9, JP5.1, JP6.1, Q1.1 (S_2), Q1.2 (S_3), Q1.3 (S), Q2.1 (S_2), Q2.2 (S_3), Q2.3 (S), Q3.1 (S_2), Q3.2 (S_3), Q3.3 (S), Q4.2 (S), Q6.1 (S_2), Q6.2 (S_3), Q6.3 (S), R17.2, R19.2, R21.2, R27.2, R32.1, R33.1, R34.1, R36.1, R38.2, R42.1, R44.1, R46.1, R48.2, RT4.2, RTH.1, U1.36 (DVSS), U1.VSS_QFN, U3.1 (GND), U4.8 (PFM_PWM), U4.9 (PGND_2), U4.10 (PGND_3), U4.11 (PGND), U4.12 (GND), U5.7 (TERM_EN), U5.11 (GND), U5.17 (EPAD), U5.V (EPAD), U5.V_1 (EPAD), U5.V_2 (EPAD), U5.V_3 (EPAD), U6.8 (PFM_PWM), U6.9 (PGND_2), U6.10 (PGND_3), U6.11 (PGND), U6.12 (GND), U7.EXPAD (GND), U7.GND1, U7.GND2, U7.GND3, U7.GND4, U7.GND5, U8.8 (PFM_PWM), U8.9 (PGND_2), U8.10 (PGND_3), U8.11 (PGND), U8.12 (GND), U11.P2 (GND), U11.P$2 (GND), U12.P$20 (AGND), U12.PGND1 (PGND), U12.PGND2 (PGND), U12.PGND3 (PGND), U12.PGND4 (PGND), U12.PGND5 (PGND), U12.PGND6 (PGND), U12.PGND7 (PGND), U12.PGND8 (PGND), U12.PGND9 (PGND), U12.PGND10 (PGND), U12.PGND11 (PGND), U12.PGND12 (PGND), VCC_GND.2, X1.P3 (GND)
HEAT1: JP4.12, Q1.5 (D_2), Q1.6 (D_3), Q1.7 (D_4), Q1.8 (D)
HEAT2: JP4.14, Q2.5 (D_2), Q2.6 (D_3), Q2.7 (D_4), Q2.8 (D)
HEAT3: JP4.16, Q3.5 (D_2), Q3.6 (D_3), Q3.7 (D_4), Q3.8 (D)
I2C_SCL: JP3.2, U1.32 (P1.7/TB0.4/UCB0SOMI/UCB0SCL/TA1.0)
I2C_SDA: JP3.1, U1.31 (P1.6/TB0.3/UCB0SIMO/UCB0SDA/TA0.0)
IND: L5.P$2 (2), U7.1 (SW), U7.2 (SW)
I_IN: C9.2, R22.1, U1.2 (P1.1/TA0.2/A1/C1)
I_OUT: C10.2, R24.1, U1.1 (P1.0/TA0.1/A0/C0)
LED5: +5V.C, R14.2
unnamed: L3.P$1 (1), U6.13 (L1_2), U6.14 (L1_3), U6.15 (L1)
unnamed: R37.1, U7.5 (PG)
unnamed: L3.P$2 (2), U6.5 (L2_2), U6.6 (L2_3), U6.7 (L2)
unnamed: L4.2, RS1.I1
unnamed: C20.1, U7.6 (SS)
unnamed: L2.P$1 (1), U8.13 (L1_2), U8.14 (L1_3), U8.15 (L1)
unnamed: L2.P$2 (2), U8.5 (L2_2), U8.6 (L2_3), U8.7 (L2)
unnamed: R48.1, U12.P$13 (MODE)
unnamed: Q7.4 (G), U11.P4 (OUT), U11.P$4 (OUT)
unnamed: L1.P$1 (1), U4.13 (L1_2), U4.14 (L1_3), U4.15 (L1)
unnamed: L1.P$2 (2), U4.5 (L2_2), U4.6 (L2_3), U4.7 (L2)
unnamed: JP1.1, R1.1, U1.23 (RST/SBWTDIO)
unnamed: J103.2, R14.1
unnamed: JP1.2, U1.22 (TEST/SBWTCK)
unnamed: C7.2, U1.46 (LFXOUT), X1.P1 (1)
unnamed: C6.2, U1.45 (LFXIN), X1.P2 (2)
unnamed: DIGITAL.3, U1.25 (P2.1/TB0.0/UCA0RXD/UCA0SOMI)
unnamed: R4.1, R5.2, U2.1 (OUT)
unnamed: R2.1, R4.2, U2.2 (-IN)
unnamed: R3.2, R23.1, U2.3 (+IN)
unnamed: R7.2, R8.1, U2.7 (OUT)
unnamed: R8.2, R9.1, U2.6 (-IN)
unnamed: R6.2, R25.1, U2.5 (+IN)
unnamed: R24.2, U10.6 (OUT)
unnamed: R22.2, U9.6 (OUT)
unnamed: Q3.4 (G), R20.1
unnamed: DIGITAL.4, U1.24 (P2.0/TB0.6/UCA0TXD/UCA0SIMO)
unnamed: DIGITAL.2, U1.39 (P2.3/TA0.0/UCA1STE/A6)
unnamed: DIGITAL.1, U1.40 (P2.4/TA1.0/UCA1CLK/A7)
unnamed: Q2.4 (G), R18.1
unnamed: RS3.V1, U10.4 (IN+)
unnamed: RS3.V2, U10.5 (IN-)
unnamed: RS2.V1, U9.4 (IN+)
unnamed: RS2.V2, U9.5 (IN-)
unnamed: DIGITAL.5, U1.21 (P2.6/TB0.1/UCA1RXD/UCA1SOMI)
unnamed: Q1.4 (G), R16.1
unnamed: C32.2, U12.P$8 (BOOT)
unnamed: +3V3_M.C, R11.2
unnamed: J106.2, R11.1
unnamed: DIGITAL.6, U1.20 (P2.5/TB0.0/UCA1TXD/UCA1SIMO)
unnamed: C27.1, R39.1
unnamed: R10.2, VCC.C
unnamed: J107.2, R10.1
unnamed: +3V3_2.C, R13.2
unnamed: J104.2, R13.1
unnamed: +11V.C, R15.2
unnamed: J102.2, R15.1
unnamed: C32.1, L6.P$2 (2), R43.2, U12.P$4 (SW1), U12.P$5 (SW2), U12.P$6 (SW3), U12.P$7 (SW4)
unnamed: +3V3_1.C, R12.2
unnamed: J105.2, R12.1
unnamed: R43.1, U12.P$3 (FSW)
unnamed: C37.1, R45.1
unnamed: C46.1, U12.P$10 (SS)
unnamed: R44.2, U12.P$19 (ILIM)
unnamed: C35.1, R45.2, U12.P$18 (COMP)
unnamed: C33.1, U12.P$1 (VCC)
unnamed: R46.2, R47.1, U12.P$17 (FB)
unnamed: Q4.3 (D), R29.1, R33.2, U5.2 (MPPSET)
unnamed: R31.1, STAT1.A
unnamed: J101.2, STAT2.C
unnamed: J100.2, STAT1.C
unnamed: R30.1, STAT2.A
unnamed: J101.1, U5.5 (STAT2)
unnamed: J100.1, U5.3 (STAT1)
unnamed: C18.1, RT3.1, U5.6 (VREF)
unnamed: C28.1, R40.2, U5.1 (VCC)
unnamed: C29.1, L4.1, Q5.1 (S_2), Q5.2 (S_3), Q5.3 (S), Q6.5 (D_2), Q6.6 (D_3), Q6.7 (D_4), Q6.8 (D), U5.14 (PH)
unnamed: C17.2, RS1.V1, U5.10 (SRP)
unnamed: C17.1, RS1.V2, U5.9 (SRN)
unnamed: Q5.4 (G), U5.15 (HIDRV)
unnamed: Q6.4 (G), U5.13 (LODRV)
unnamed: C30.2, R34.2, R35.1, R41.1, U5.8 (VFB)
unnamed: C16.1, D1.1 (A1), D1.2 (A2), U5.12 (REGN)
unnamed: C29.2, D1.3 (CC), U5.16 (BTST)
SC+: C40.2, JP5.2, Q5.5 (D_2), Q5.6 (D_3), Q5.7 (D_4), Q5.8 (D), R25.2, R28.2, R29.2, R30.2, R31.2, R39.2, R40.1
SC_OUT: C30.1, C41.1, C42.1, R35.2, R41.2, RS1.I2, RS2.I1
TS: RT3.2, RT4.1, RTH.2, U5.4 (TS)
V_BAT: C1.2, R5.1, U1.9 (P1.3/TA1.2/UCB0STE/A3/C3)
V_SC: C3.2, R7.1, U1.3 (P1.2/TA1.1/A2/C2)

Notes on the sheet:
Solar
3.3V
12V
Battery voltage
Solar cell voltage
SOLAR in
Current Out
-> Vout = 11.0 V
470kOhm for R47 for Vout = 11.4V
1.2V for MPP
1uA leakage
Charge termination disabled
Vterm = 4.1 V -> be nice with battery
10mOhm -> 4A max current
2N7002DICT
Si7288DP as alternative
-> R_ILIM = 100k --> switch current limit = 11.7 A
The effective load capacitance, CL,eff can be computed as CIN x COUT / (CIN + COUT), where CIN and COUT are the total capacitance at the LFXIN and LFXOUT terminals, respectively. Cin = 2pF Requires external capacitors at both terminals to meet the effective load capacitance specified by crystal man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
input range: 0 - 8.5V
input range: 0 - 5V
-25°C - 60°C charge range (see BOM for calculation)

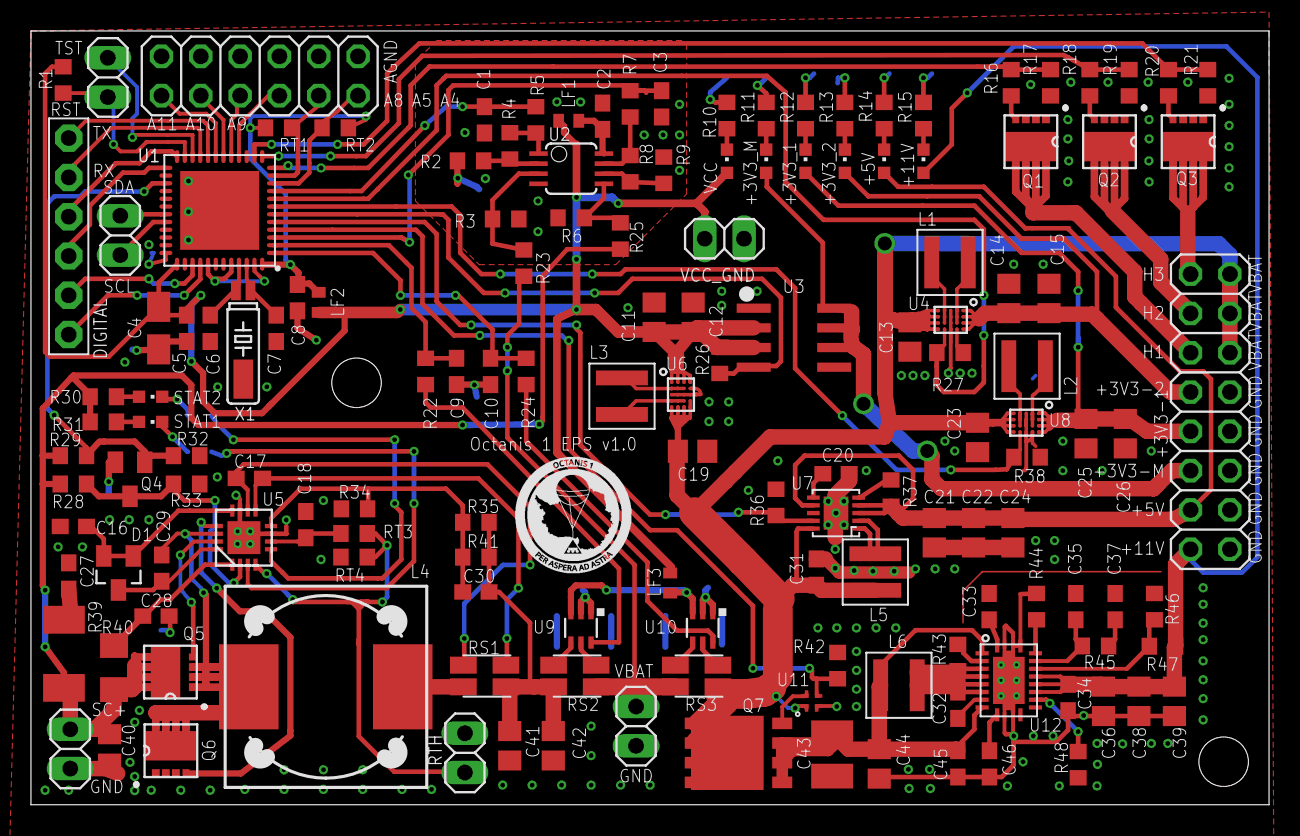
[picture p44: board octanis_eps_v1.brd from above]

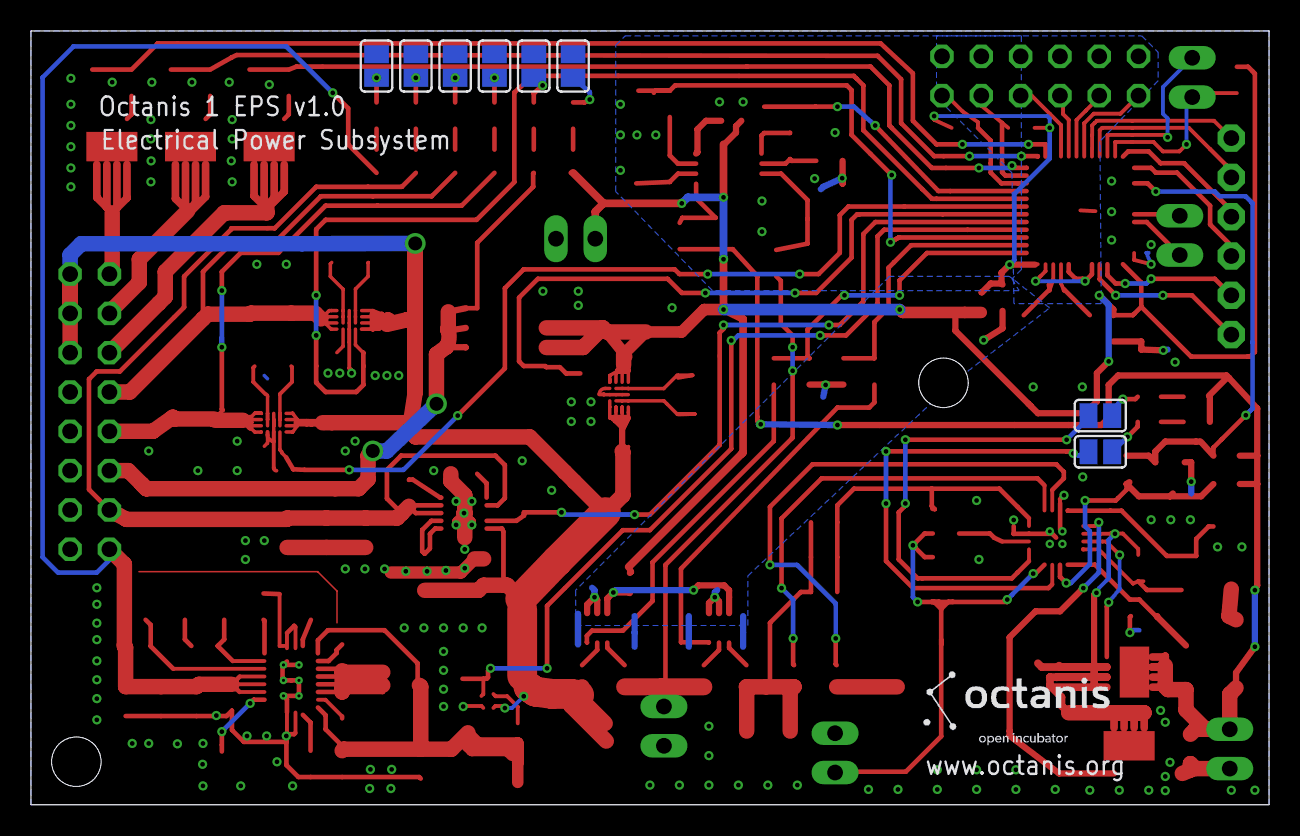
[picture p45: board octanis_eps_v1.brd from below]

Board: 2 copper layers, 80.0 x 50.0 mm, 156 parts (8 on the bottom side), 117 nets.
