Octanis1/Octanis1-Electronics/external_weather_strip/external_strip_v3_1.brd

## EAGLE design external_weather_strip/external_strip_v3_1.brd (2016-05-28, an earlier design)

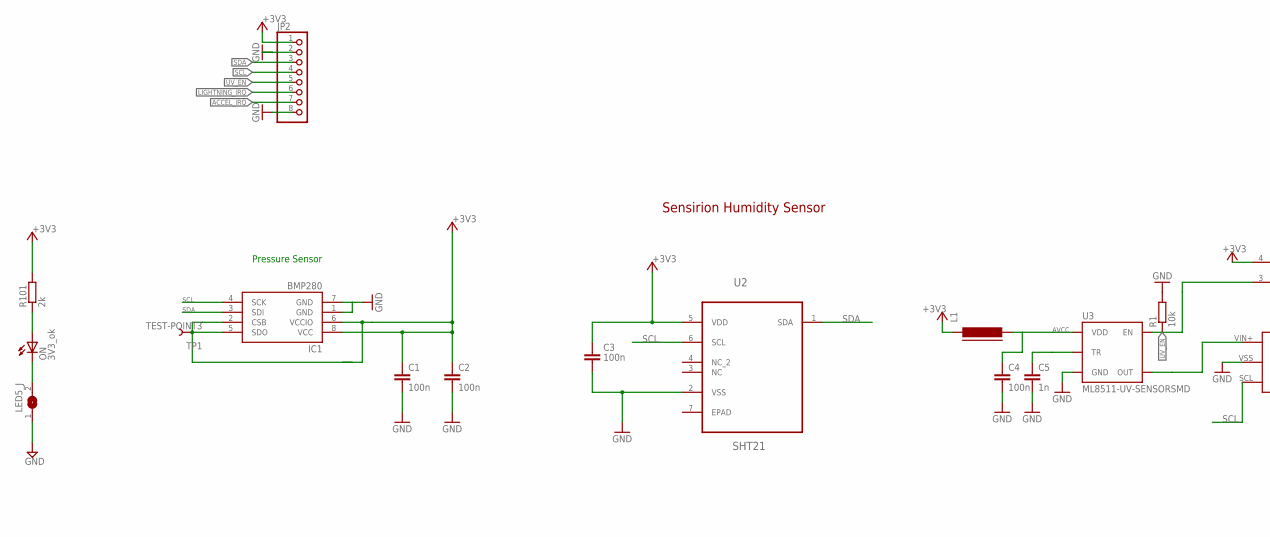
[picture p46: schematic external_strip_v3_1.sch, part in row 1, column 1]

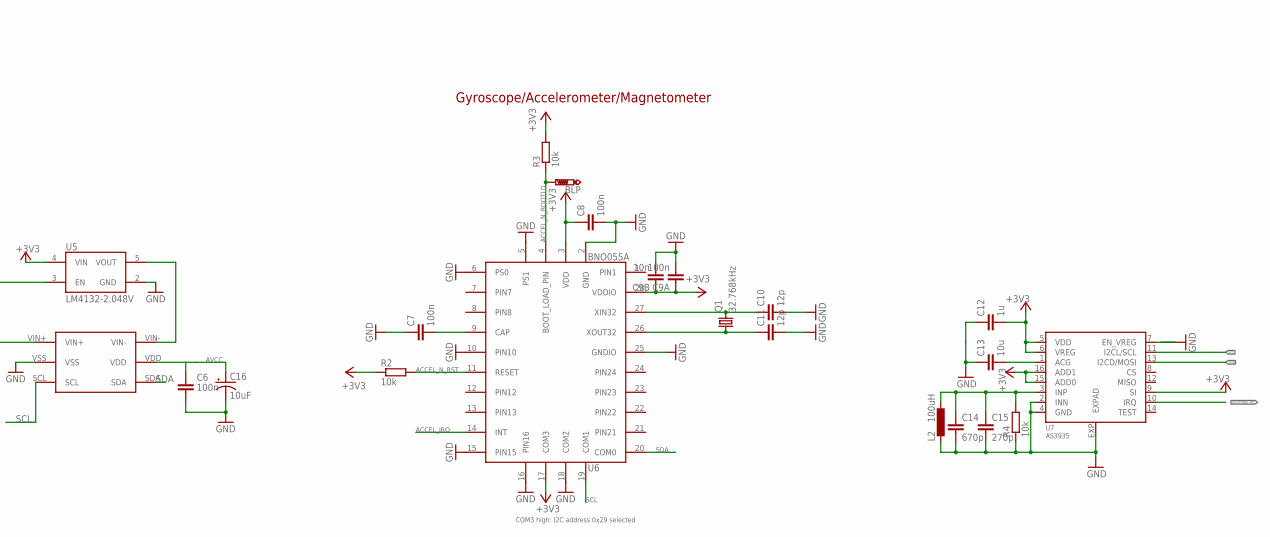
[picture p47: schematic external_strip_v3_1.sch, part in row 1, column 2]

Parts:
BLP: PTR1B1,27; B1,27
C1, C2, C3, C6, C7, C8, C9A: 100n; C0603
C4: 100n; 0603-CAP
C5: 1n; 0603-CAP
C9B: 10n; C0603
C10, C11: 12p; C0603
C12: 1u; C0603
C13: 10u; C0603
C14: 670p; C0603
C15: 270p; C0603
C16: 10uF; EIA3216
IC1: BMP280; LGA8
JP2: PINHD-1X8; 1X08
L1: FERRITE-0603; FB603
L2: 100uH; COILCRAFT
LED5_J: SJ
ON: 3V3_ok; CHIPLED_0603
Q1: 32.768kHz; FC-12M
R1, R2, R3, R4: 10k; R0603
R101: 2k; R0603
TP1: TEST-POINT3; PAD.03X.03
U2: SHT21; DFN300X300X110-7N
U3: ML8511-UV-SENSORSMD; ML8511
U4: MCP3425; SOT-23-6
U5: LM4132-2.048V; SOT23-5
U6: BNO055A; BNO055
U7: AS3935; 16LDMLPQ

Connections:
+3V3: C1.1, C2.1, C3.1, C8.1, C9A.1, C9B.1, C12.2, IC1.2 (CSB), IC1.5 (SDO), IC1.6 (VCCIO), IC1.8 (VCC), JP2.1, L1.1, R2.1, R3.2, R101.2, TP1.P$1, U2.5 (VDD), U5.4 (VIN), U6.3 (VDD), U6.17 (COM3), U6.28 (VDDIO), U7.5 (VDD), U7.6 (VREG), U7.9 (SI), U7.15 (ADD0), U7.16 (ADD1)
ACCEL_IRQ: JP2.7, U6.14 (INT)
ACCEL_N_BOOTLD: BLP.TP, R3.1, U6.4 (BOOT_LOAD_PIN)
ACCEL_N_RST: R2.2, U6.11 (RESET)
AVCC: C4.1, C6.1, C16.A (+), L1.2, U3.7 (VDD), U4.VDD
GND: C1.2, C2.2, C3.2, C4.2, C5.2, C6.2, C7.1, C8.2, C9A.2, C9B.2, C10.2, C11.2, C12.1, C13.1, C14.2, C15.2, C16.C (-), IC1.1 (GND), IC1.7 (GND), JP2.2, JP2.8, L2.2, LED5_J.1, R1.2, R4.1, U2.2 (VSS), U3.5 (GND), U4.VSS, U5.2 (GND), U6.2 (GND), U6.5 (PS1), U6.6 (PS0), U6.10 (PIN10), U6.15 (PIN15), U6.16 (PIN16), U6.18 (COM2), U6.25 (GNDIO), U7.2 (INN), U7.4 (GND), U7.7 (EN_VREG), U7.EXP (EXPAD)
LIGHTNING_IRQ: JP2.6, U7.10 (IRQ)
unnamed: U3.8 (OUT), U4.VIN+
unnamed: C13.2, U7.1 (ACG)
unnamed: C5.1, U3.9 (TR)
unnamed: LED5_J.2, ON.C
unnamed: C14.1, C15.1, L2.1, R4.2, U7.3 (INP)
unnamed: U4.VIN-, U5.5 (VOUT)
unnamed: ON.A, R101.1
unnamed: C7.2, U6.9 (CAP)
unnamed: C10.1, Q1.2, U6.27 (XIN32)
unnamed: C11.1, Q1.1, U6.26 (XOUT32)
SCL: IC1.4 (SCK), JP2.4, U2.6 (SCL), U4.SCL, U6.19 (COM1), U7.11 (I2CL/SCL)
SDA: IC1.3 (SDI), JP2.3, U2.1 (SDA), U4.SDA, U6.20 (COM0), U7.13 (I2CD/MOSI)
UV_EN: JP2.5, R1.1, U3.4 (EN), U5.3 (EN)

Notes on the sheet:
Sensirion Humidity Sensor
Pressure Sensor
Gyroscope/Accelerometer/Magnetometer
COM3 high: I2C address 0x29 selected

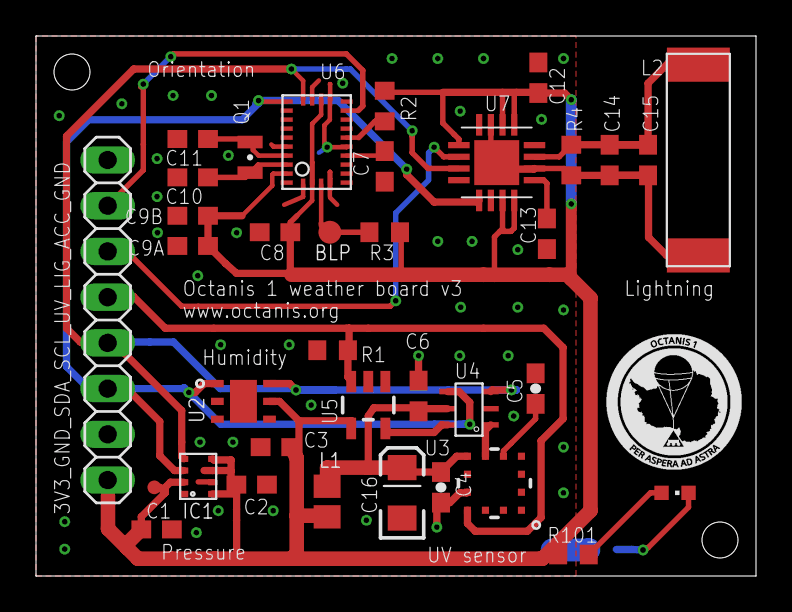
[picture p48: board external_strip_v3_1.brd from above]

Board: 2 copper layers, 40.0 x 30.0 mm, 37 parts (1 on the bottom side), 20 nets.
