Octanis1/Octanis1-Electronics/octanis_eps/v0.5_T_architecture/octanis_eps_v05.brd

## EAGLE design octanis_eps/v0.5_T_architecture/octanis_eps_v05.brd (2016-05-22, an earlier design)

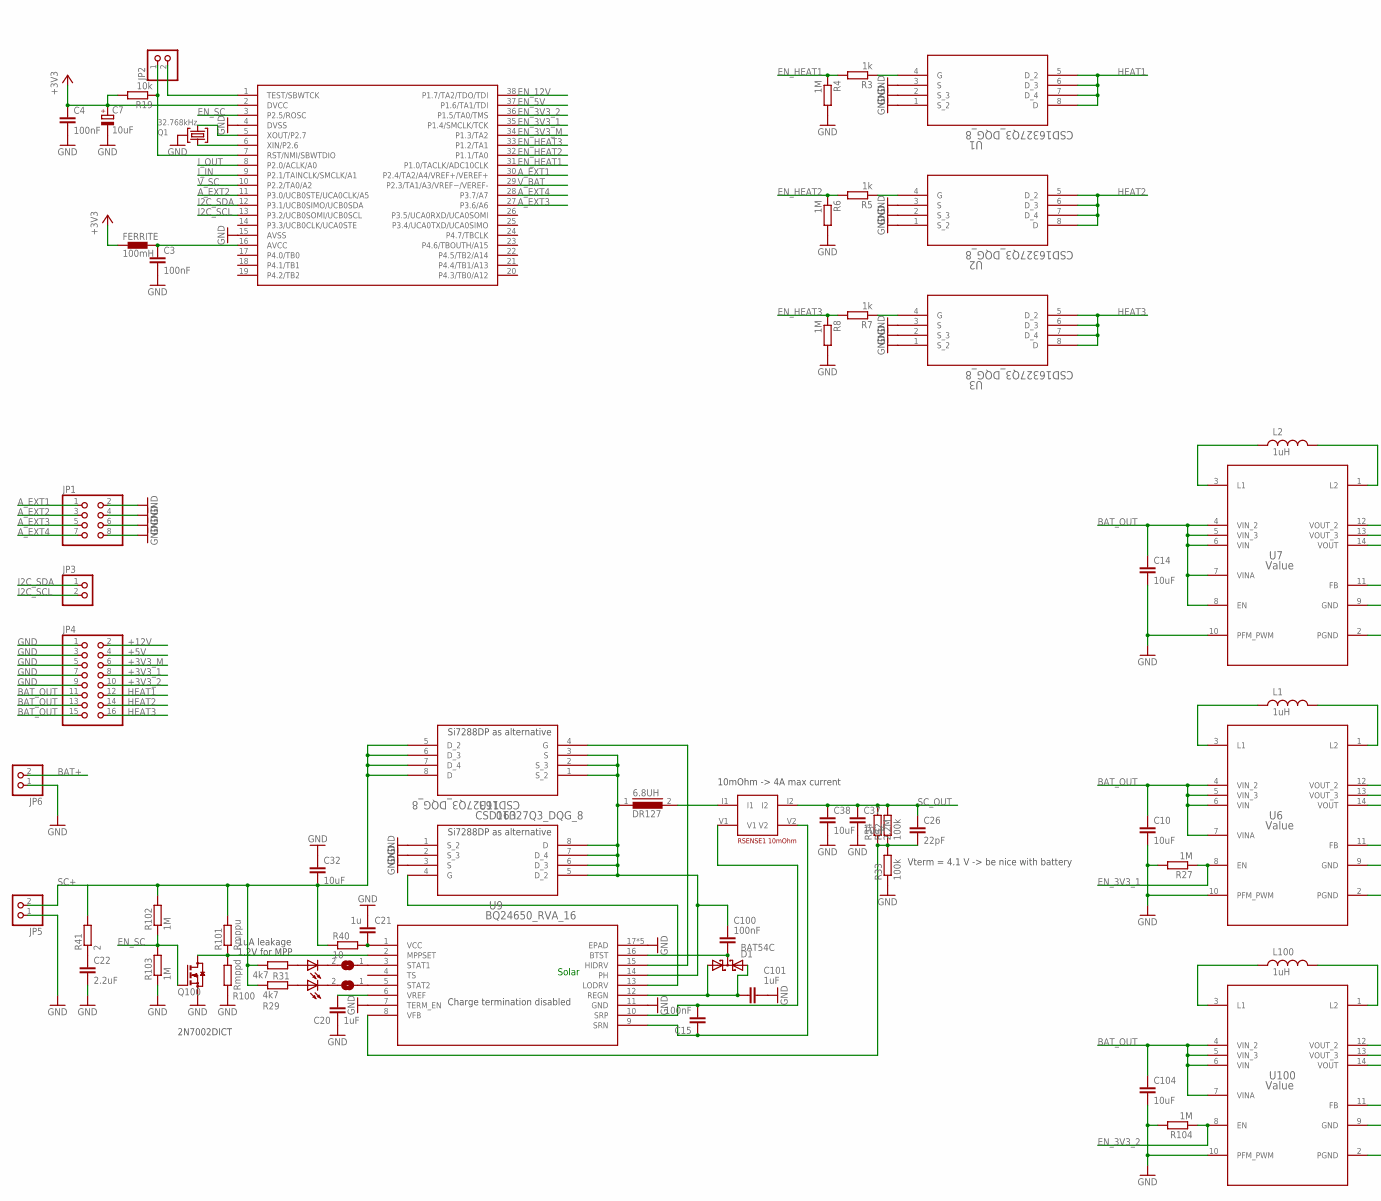
[picture p49: schematic octanis_eps_v05.sch, part in row 1, column 1]

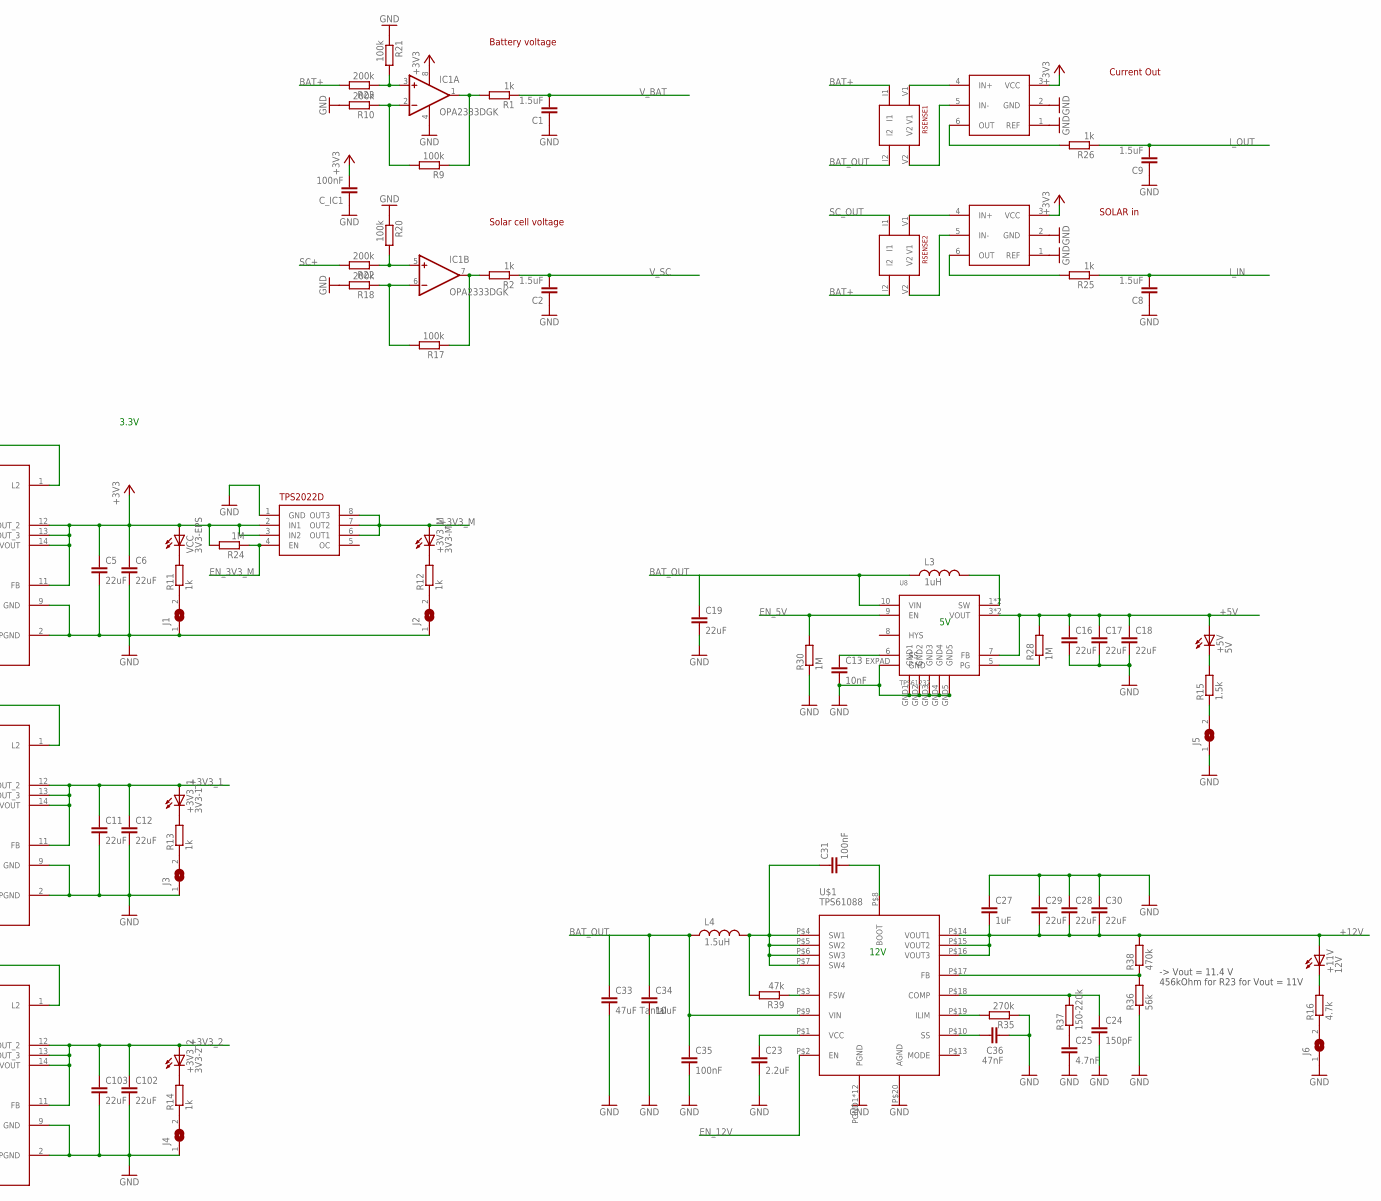
[picture p50: schematic octanis_eps_v05.sch, part in row 1, column 2]

Parts:
6.8UH: DR127
+3V3_1: 3V3-1; CHIPLED_0603
+3V3_2: 3V3-2; CHIPLED_0603
+3V3_M: 3V3-M; CHIPLED_0603
+5V: 5V; CHIPLED_0603
+11V: 12V; CHIPLED_0603
C1, C2, C8, C9: 1.5uF; C0603
C3, C4, C15, C31, C35, C100: 100nF; C0603
C5, C6, C11, C12, C16, C17, C18, C28, C29, C30, C102, C103: 22uF; C0805
C7: 10uF; A/3216-18R
C10, C14, C32, C34, C37, C38, C104: 10uF; C0805
C13: 10nF; C0603
C19: 22uF; C0603
C20, C27, C101: 1uF; C0603
C21: 1u; C0603
C22, C23: 2.2uF; C0603
C24: 150pF; C0603
C25: 4.7nF; C0603
C26: 22pF; C0603
C33: 47uF Tantal; C1210
C36: 47nF; C0603
C_IC1: 100nF; C0603
D1: BAT54C; SOT23
FERRITE: 100mH; 0402
IC1: OPA2333DGK; MSOP08
J1, J2, J3, J4, J5, J6, J7, J8: SJ
JP1: PINHD-2X4; 2X04
JP2, JP3, JP5, JP6: PINHD-1X2; 1X02
JP4: PINHD-2X8; 2X08
L1, L2, L3, L100: 1uH; XFL4020
L4: 1.5uH; XFL4020
Q1: 32.768kHz; MS3V-T1R
Q100: BSS123; SOT23
R1, R2, R3, R5, R7, R11, R12, R13, R14, R25, R26: 1k; R0603
R4, R6, R8, R24, R27, R28, R30, R102, R103, R104: 1M; R0603
R9, R17, R20, R21, R32, R33: 100k; R0603
R10, R18, R22, R23: 200k; R0603
R15: 1.5k; R0603
R16: 4.7k; R0603
R19: 10k; R0603
R29, R31: 4k7; R0603
R34: 2.2M; R0603
R35: 270k; R0603
R36: 56k; R0603
R37: 150-220k; R0603
R38: 470k; R0603
R39: 47k; R0603
R40: 10; R1206
R41: 2; R2012
R100: Rmppd; R0603
R101: Rmppu; R0603
RSENSE1: RSENSE2; 4PADS_RESISTOR
R_SENSE1: RSENSE1 10mOhm; 4PADS_RESISTOR
R_SENSE2: RSENSE1; 4PADS_RESISTOR
STAT1, STAT2: 5V-ok; CHIPLED_0603
U1, U2, U3, U10, U11: CSD16327Q3_DQG_8; DQG8
U4: MSP430G2544; TSSOP38
U5: TPS2022D; SO8
U6, U7, U100: Value; RNC0014A
U8: TPS61232; S-PVSON-N10
U9: BQ24650_RVA_16; RVA16_2P14X2P14
U$1: TPS61088; R-PVQFN-N20
U$2, U$3: INA213; SC70-6
VCC: 3V3-EPS; CHIPLED_0603

Connections:
+3V3: C4.1, C5.1, C6.1, C7.+, C_IC1.2, FERRITE.1, IC1.8 (V+), R19.2, R24.2, U4.2 (DVCC), U5.2 (IN1), U5.3 (IN2), U7.11 (FB), U7.12 (VOUT_2), U7.13 (VOUT_3), U7.14 (VOUT), U$2.3 (VCC), U$3.3 (VCC), VCC.A
+3V3_1: +3V3_1.A, C11.1, C12.1, JP4.8, U6.11 (FB), U6.12 (VOUT_2), U6.13 (VOUT_3), U6.14 (VOUT)
+3V3_2: +3V3_2.A, C102.1, C103.1, JP4.10, U100.11 (FB), U100.12 (VOUT_2), U100.13 (VOUT_3), U100.14 (VOUT)
+3V3_M: +3V3_M.A, JP4.6, U5.6 (OUT1), U5.7 (OUT2), U5.8 (OUT3)
+5V: +5V.A, C16.1, C17.1, C18.1, JP4.4, R28.2, U8.3 (VOUT), U8.4 (VOUT), U8.7 (FB)
+12V: +11V.A, C27.2, C28.2, C29.2, C30.2, JP4.2, R38.2, U$1.P$14 (VOUT1), U$1.P$15 (VOUT2), U$1.P$16 (VOUT3)
A_EXT1: JP1.1, U4.30 (P2.4/TA2/A4/VREF+/VEREF+)
A_EXT2: JP1.3, U4.11 (P3.0/UCB0STE/UCA0CLK/A5)
A_EXT3: JP1.5, U4.27 (P3.6/A6)
A_EXT4: JP1.7, U4.28 (P3.7/A7)
BAT+: JP6.2, R23.2, RSENSE1.I2, R_SENSE2.I1
BAT_OUT: C10.1, C14.1, C19.1, C33.1, C34.1, C35.1, C104.1, JP4.11, JP4.13, JP4.15, L3.P$1 (1), L4.P$1 (1), R_SENSE2.I2, U6.4 (VIN_2), U6.5 (VIN_3), U6.6 (VIN), U6.7 (VINA), U7.4 (VIN_2), U7.5 (VIN_3), U7.6 (VIN), U7.7 (VINA), U7.8 (EN), U8.10 (VIN), U100.4 (VIN_2), U100.5 (VIN_3), U100.6 (VIN), U100.7 (VINA), U$1.P$9 (VIN)
EN_3V3_1: R27.1, U4.35 (P1.4/SMCLK/TCK), U6.8 (EN)
EN_3V3_2: R104.1, U4.36 (P1.5/TA0/TMS), U100.8 (EN)
EN_3V3_M: R24.1, U4.34 (P1.3/TA2), U5.4 (EN)
EN_5V: R30.2, U4.37 (P1.6/TA1/TDI), U8.9 (EN)
EN_12V: U4.38 (P1.7/TA2/TDO/TDI), U$1.P$2 (EN)
EN_HEAT1: R3.2, R4.1, U4.31 (P1.0/TACLK/ADC10CLK)
EN_HEAT2: R5.2, R6.1, U4.32 (P1.1/TA0)
EN_HEAT3: R7.2, R8.1, U4.33 (P1.2/TA1)
EN_SC: Q100.1 (G), R102.1, R103.2, U4.3 (P2.5/ROSC)
GND: C1.1, C2.1, C3.2, C4.2, C5.2, C6.2, C7.-, C8.1, C9.1, C10.2, C11.2, C12.2, C13.2, C14.2, C16.2, C17.2, C18.2, C19.2, C20.2, C21.2, C22.2, C23.2, C24.2, C25.2, C27.1, C28.1, C29.1, C30.1, C32.1, C33.2, C34.2, C35.2, C36.2, C37.2, C38.2, C101.2, C102.2, C103.2, C104.2, C_IC1.1, IC1.4 (V-), J1.1, J2.1, J3.1, J4.1, J5.1, J6.1, JP1.2, JP1.4, JP1.6, JP1.8, JP4.1, JP4.3, JP4.5, JP4.7, JP4.9, JP5.1, JP6.1, Q1.P3 (GND), Q100.2 (S), R4.2, R6.2, R8.2, R10.2, R18.2, R20.1, R21.1, R27.2, R30.1, R33.1, R35.1, R36.1, R100.1, R103.1, R104.2, U1.1 (S_2), U1.2 (S_3), U1.3 (S), U2.1 (S_2), U2.2 (S_3), U2.3 (S), U3.1 (S_2), U3.2 (S_3), U3.3 (S), U4.4 (DVSS), U4.15 (AVSS), U5.1 (GND), U6.2 (PGND), U6.9 (GND), U6.10 (PFM_PWM), U7.2 (PGND), U7.9 (GND), U7.10 (PFM_PWM), U8.EXPAD (GND), U8.GND1, U8.GND2, U8.GND3, U8.GND4, U8.GND5, U9.7 (TERM_EN), U9.11 (GND), U9.17 (EPAD), U9.V (EPAD), U9.V_1 (EPAD), U9.V_2 (EPAD), U9.V_3 (EPAD), U11.1 (S_2), U11.2 (S_3), U11.3 (S), U100.2 (PGND), U100.9 (GND), U100.10 (PFM_PWM), U$1.P$20 (AGND), U$1.PGND1 (PGND), U$1.PGND2 (PGND), U$1.PGND3 (PGND), U$1.PGND4 (PGND), U$1.PGND5 (PGND), U$1.PGND6 (PGND), U$1.PGND7 (PGND), U$1.PGND8 (PGND), U$1.PGND9 (PGND), U$1.PGND10 (PGND), U$1.PGND11 (PGND), U$1.PGND12 (PGND), U$2.1 (REF), U$2.2 (GND), U$3.1 (REF), U$3.2 (GND)
HEAT1: JP4.12, U1.5 (D_2), U1.6 (D_3), U1.7 (D_4), U1.8 (D)
HEAT2: JP4.14, U2.5 (D_2), U2.6 (D_3), U2.7 (D_4), U2.8 (D)
HEAT3: JP4.16, U3.5 (D_2), U3.6 (D_3), U3.7 (D_4), U3.8 (D)
I2C_SCL: JP3.2, U4.13 (P3.2/UCB0SOMI/UCB0SCL)
I2C_SDA: JP3.1, U4.12 (P3.1/UCB0SIMO/UCB0SDA)
IND: L3.P$2 (2), U8.1 (SW), U8.2 (SW)
I_IN: C8.2, R25.1, U4.9 (P2.1/TAINCLK/SMCLK/A1)
I_OUT: C9.2, R26.1, U4.8 (P2.0/ACLK/A0)
LED5: +5V.C, R15.2
unnamed: L2.P$1 (1), U7.3 (L1)
unnamed: R28.1, U8.5 (PG)
unnamed: L2.P$2 (2), U7.1 (L2)
unnamed: 6.8UH.2, R_SENSE1.I1
unnamed: C13.1, U8.6 (SS)
unnamed: L1.P$1 (1), U6.3 (L1)
unnamed: L1.P$2 (2), U6.1 (L2)
unnamed: L100.P$1 (1), U100.3 (L1)
unnamed: L100.P$2 (2), U100.1 (L2)
unnamed: J5.2, R15.1
unnamed: IC1.1 (OUT), R1.2, R9.1
unnamed: IC1.2 (-IN), R9.2, R10.1
unnamed: IC1.3 (+IN), R21.2, R23.1
unnamed: IC1.7 (OUT), R2.2, R17.1
unnamed: IC1.6 (-IN), R17.2, R18.1
unnamed: IC1.5 (+IN), R20.2, R22.1
unnamed: R26.2, U$3.6 (OUT)
unnamed: R25.2, U$2.6 (OUT)
unnamed: R7.1, U3.4 (G)
unnamed: Q1.P1 (1), U4.6 (XIN/P2.6)
unnamed: R5.1, U2.4 (G)
unnamed: R_SENSE2.V1, U$3.4 (IN+)
unnamed: R_SENSE2.V2, U$3.5 (IN-)
unnamed: RSENSE1.V1, U$2.4 (IN+)
unnamed: RSENSE1.V2, U$2.5 (IN-)
unnamed: Q1.P2 (2), U4.5 (XOUT/P2.7)
unnamed: R3.1, U1.4 (G)
unnamed: C31.2, U$1.P$8 (BOOT)
unnamed: +3V3_M.C, R12.2
unnamed: J2.2, R12.1
unnamed: R11.2, VCC.C
unnamed: J1.2, R11.1
unnamed: +3V3_2.C, R14.2
unnamed: J4.2, R14.1
unnamed: +11V.C, R16.2
unnamed: J6.2, R16.1
unnamed: C31.1, L4.P$2 (2), R39.2, U$1.P$4 (SW1), U$1.P$5 (SW2), U$1.P$6 (SW3), U$1.P$7 (SW4)
unnamed: +3V3_1.C, R13.2
unnamed: J3.2, R13.1
unnamed: R39.1, U$1.P$3 (FSW)
unnamed: C25.1, R37.1
unnamed: C36.1, U$1.P$10 (SS)
unnamed: R35.2, U$1.P$19 (ILIM)
unnamed: C24.1, R37.2, U$1.P$18 (COMP)
unnamed: C23.1, U$1.P$1 (VCC)
unnamed: R36.2, R38.1, U$1.P$17 (FB)
unnamed: Q100.3 (D), R100.2, R101.1, U9.2 (MPPSET)
unnamed: C22.1, R41.1
unnamed: R31.1, STAT1.A
unnamed: J7.2, STAT2.C
unnamed: J8.2, STAT1.C
unnamed: R29.1, STAT2.A
unnamed: J7.1, U9.5 (STAT2)
unnamed: J8.1, U9.3 (STAT1)
unnamed: C20.1, U9.6 (VREF)
unnamed: C21.1, R40.2, U9.1 (VCC)
unnamed: JP2.2, U4.1 (TEST/SBWTCK)
unnamed: 6.8UH.1, C100.1, U9.14 (PH), U10.1 (S_2), U10.2 (S_3), U10.3 (S), U11.5 (D_2), U11.6 (D_3), U11.7 (D_4), U11.8 (D)
unnamed: C15.2, R_SENSE1.V1, U9.10 (SRP)
unnamed: C15.1, R_SENSE1.V2, U9.9 (SRN)
unnamed: U9.15 (HIDRV), U10.4 (G)
unnamed: U9.13 (LODRV), U11.4 (G)
unnamed: C26.2, R32.1, R33.2, R34.1, U9.8 (VFB)
unnamed: C101.1, D1.1 (A1), D1.2 (A2), U9.12 (REGN)
unnamed: C100.2, D1.3 (CC), U9.16 (BTST)
unnamed: JP2.1, R19.1, U4.7 (RST/NMI/SBWTDIO)
unnamed: C3.1, FERRITE.2, U4.16 (AVCC)
SC+: C32.2, JP5.2, R22.2, R29.2, R31.2, R40.1, R41.2, R101.2, R102.2, U10.5 (D_2), U10.6 (D_3), U10.7 (D_4), U10.8 (D)
SC_OUT: C26.1, C37.1, C38.1, R32.2, R34.2, RSENSE1.I1, R_SENSE1.I2
V_BAT: C1.2, R1.1, U4.29 (P2.3/TA1/A3/VREF−/VEREF-)
V_SC: C2.2, R2.1, U4.10 (P2.2/TA0/A2)

Notes on the sheet:
Solar
3.3V
12V
Battery voltage
Solar cell voltage
SOLAR in
Current Out
-> Vout = 11.4 V
456kOhm for R23 for Vout = 11V
1.2V for MPP
1uA leakage
Charge termination disabled
Vterm = 4.1 V -> be nice with battery
10mOhm -> 4A max current
2N7002DICT
Si7288DP as alternative
