Octanis1/Octanis1-Electronics/octanis_eps/v0.5_T_architecture/octanis_eps_v05.brd

## EAGLE design octanis_eps/v0.5_T_architecture/octanis_eps_v05.brd (continued)

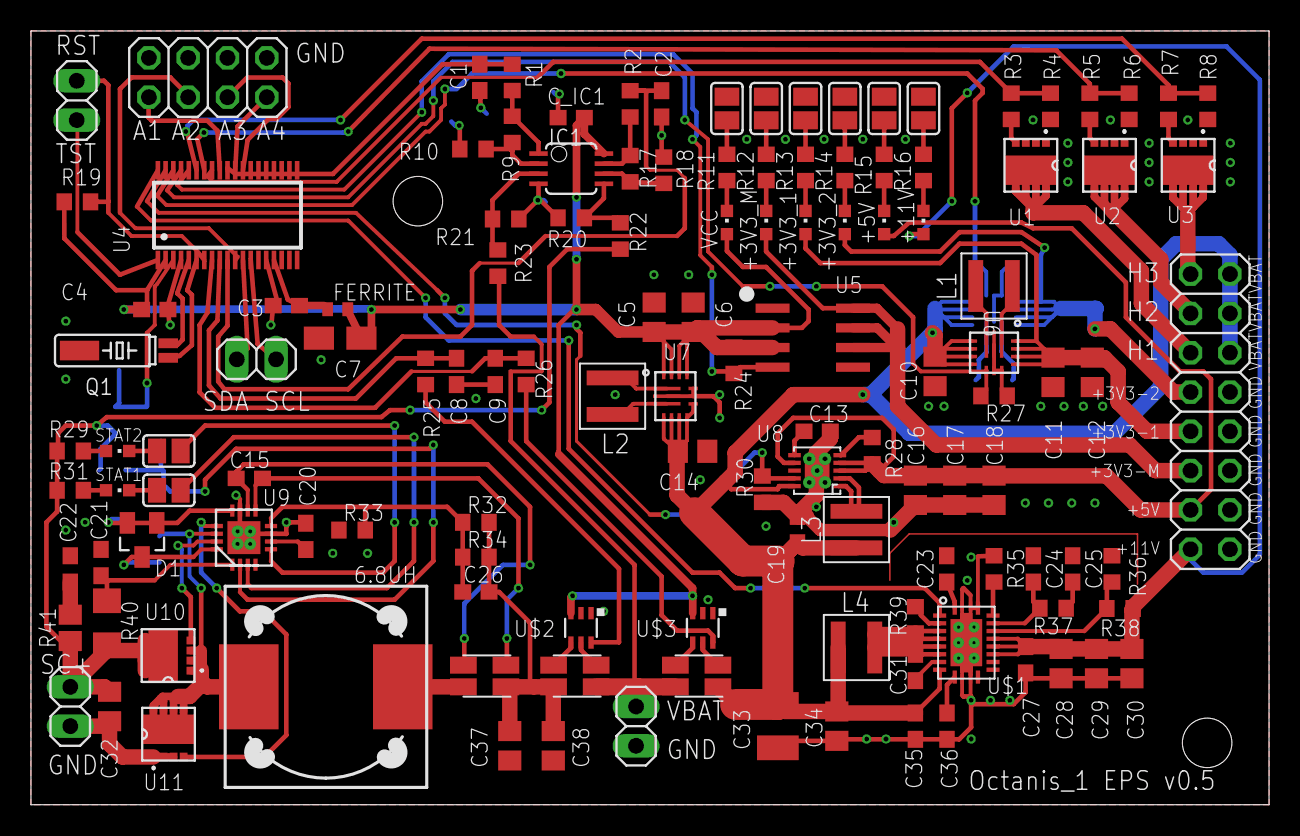
[picture p51: board octanis_eps_v05.brd from above]

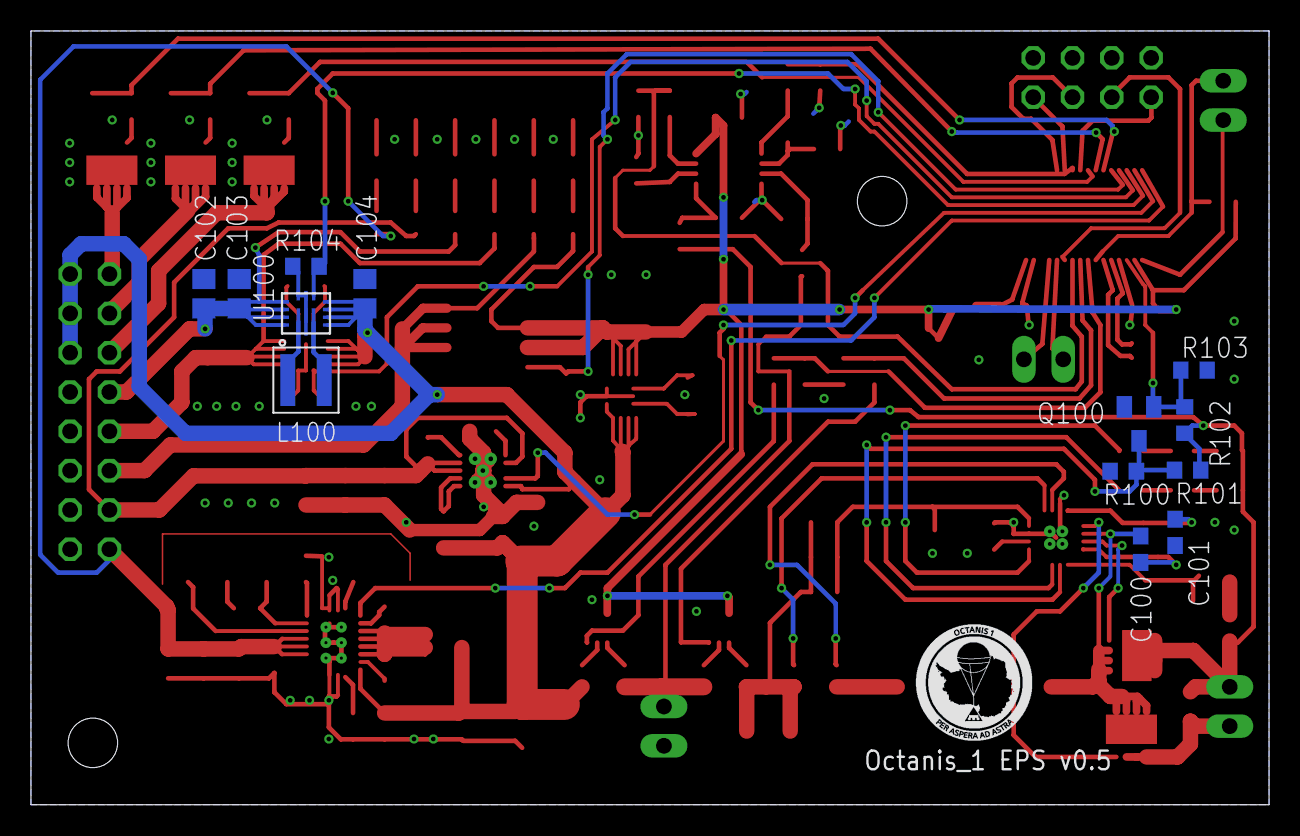
[picture p52: board octanis_eps_v05.brd from below]

Board: 2 copper layers, 80.0 x 50.0 mm, 141 parts (13 on the bottom side), 102 nets.
