Octanis1/Octanis1-Electronics/octanis_main_pcb_v1.0/octanis_v1.brd

## EAGLE design octanis_main_pcb_v1.0/octanis_v1.brd (continued)

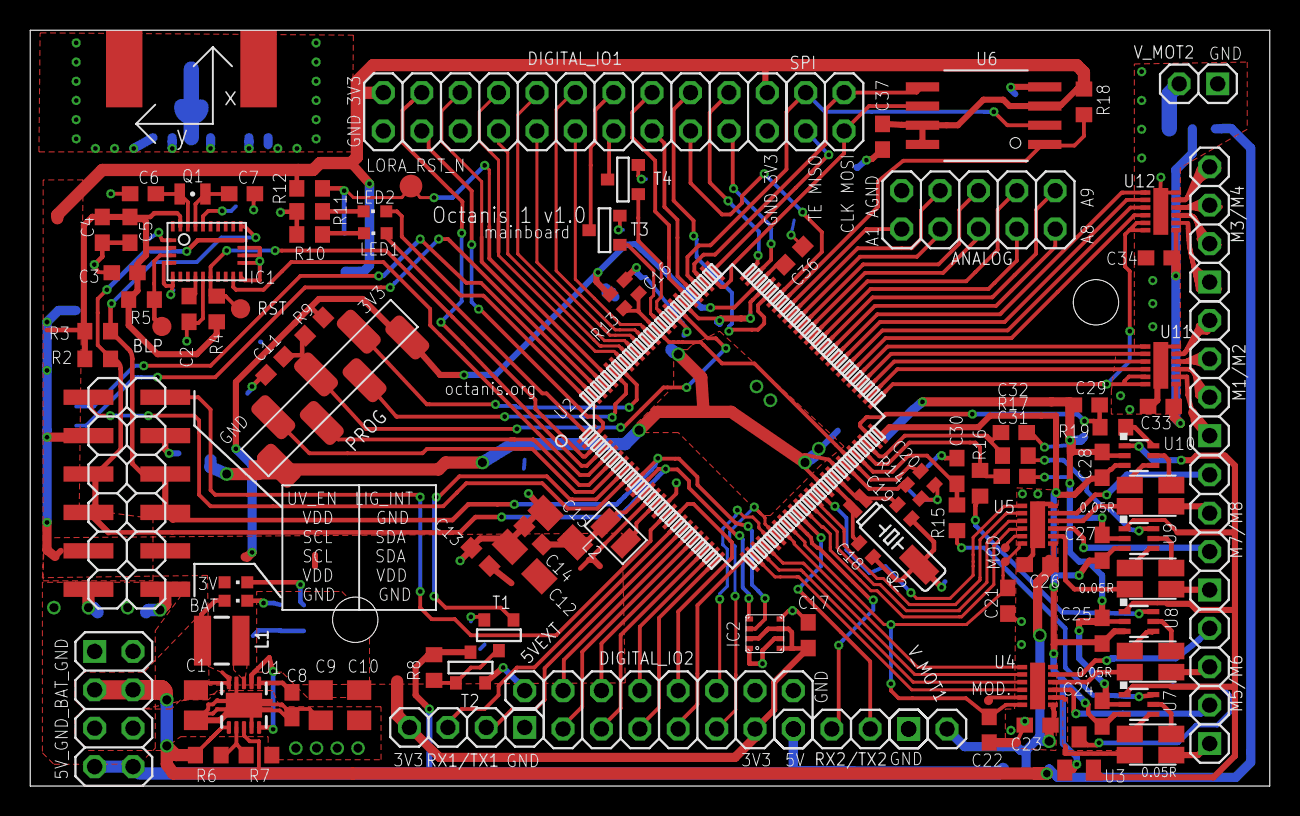
[picture p59: board octanis_v1.brd from above]

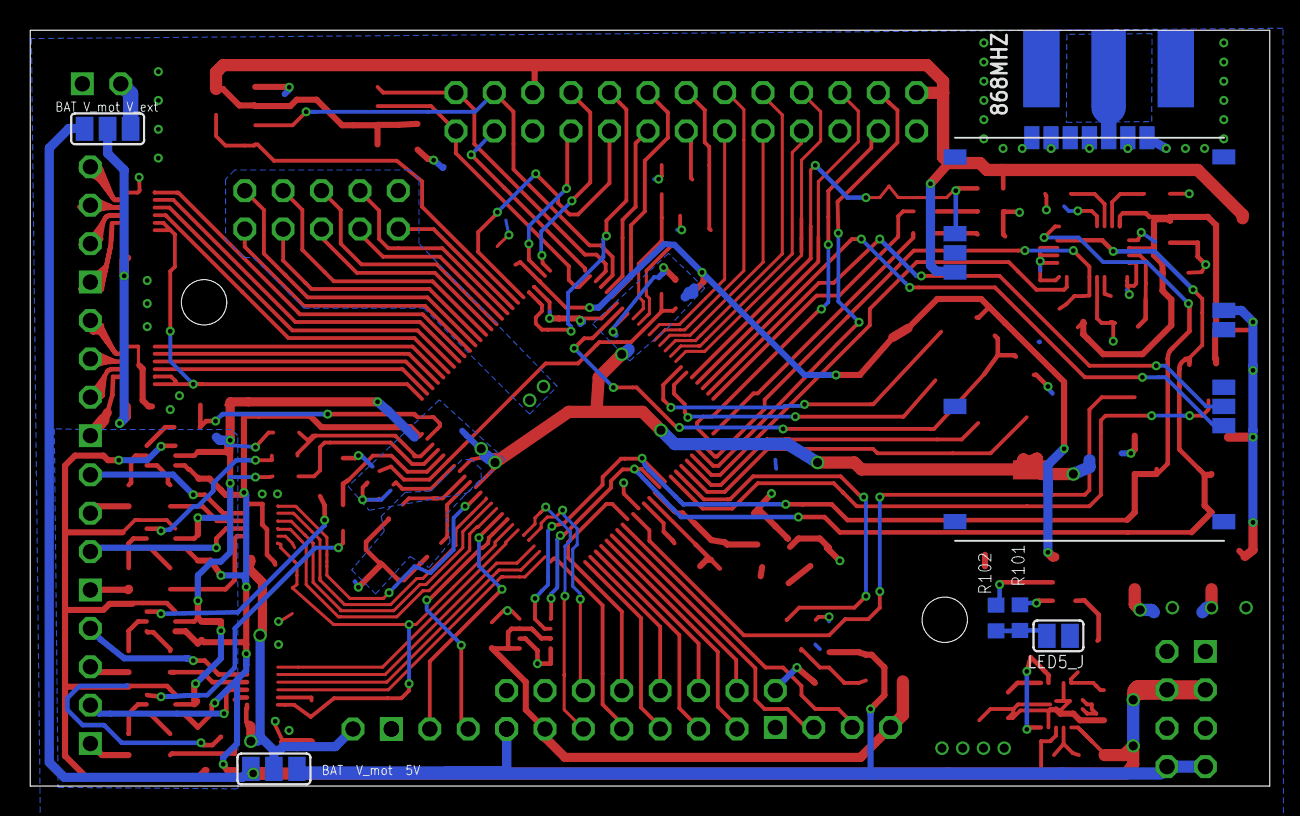
[picture p60: board octanis_v1.brd from below]

Board: 2 copper layers, 82.0 x 50.0 mm, 117 parts (7 on the bottom side), 151 nets.
