Octanis1/Octanis1-Electronics/magnetic_encoder/magnetic_encoder.brd

## EAGLE design magnetic_encoder/magnetic_encoder.brd (2016-01-03)

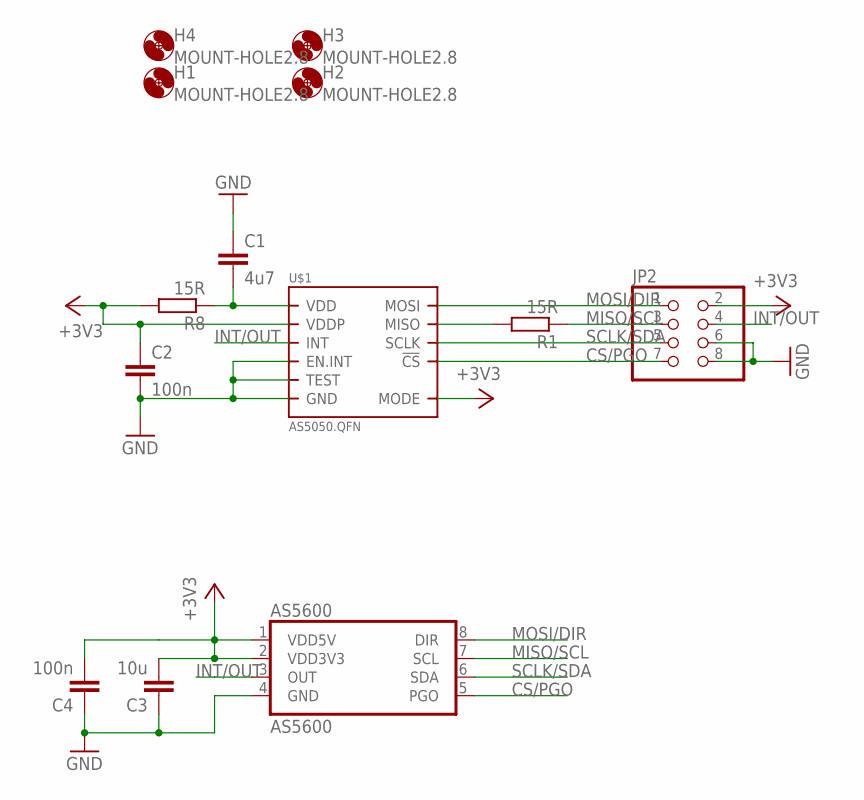
[picture p61: schematic magnetic_encoder.sch]

Parts:
AS5600: AS5600; SOIC-8
C1: 4u7; C0603
C2, C4: 100n; C0603
C3: 10u; C0603
H1, H2, H3, H4: MOUNT-HOLE2.8; 2,8
JP2: PINHD-2X4; 2X04
R1, R8: 15R; R0603
U$1: AS5050.QFN; QFN.16

Connections:
+3V3: AS5600.1 (VDD5V), AS5600.2 (VDD3V3), C2.1, C3.2, C4.2, JP2.2, R8.2, U$1.11 (VDDP), U$1.14 (MODE)
CS/PGO: AS5600.5 (PGO), JP2.7, U$1.4 (!CS)
GND: AS5600.4 (GND), C1.1, C2.2, C3.1, C4.1, JP2.6, JP2.8, U$1.9 (TEST), U$1.10 (EN.INT), U$1.13 (GND)
INT/OUT: AS5600.3 (OUT), JP2.4, U$1.15 (INT)
MISO/SCL: AS5600.7 (SCL), JP2.3, R1.1
MOSI/DIR: AS5600.8 (DIR), JP2.1, U$1.1 (MOSI)
unnamed: C1.2, R8.1, U$1.12 (VDD)
unnamed: R1.2, U$1.2 (MISO)
SCLK/SDA: AS5600.6 (SDA), JP2.5, U$1.3 (SCLK)

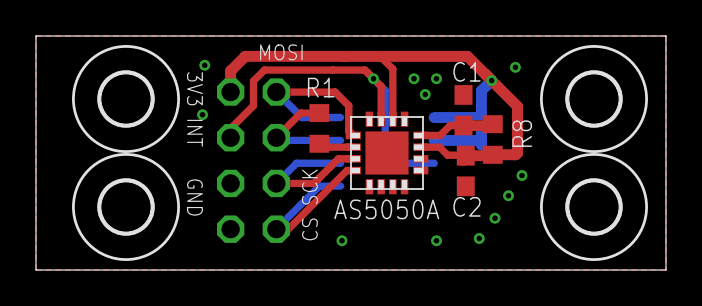
[picture p62: board magnetic_encoder.brd from above]

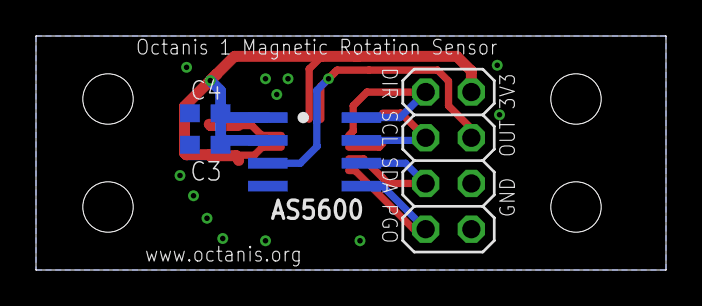
[picture p63: board magnetic_encoder.brd from below]

Board: 2 copper layers, 35.0 x 13.0 mm, 13 parts (4 on the bottom side), 9 nets.
