Octanis1/Octanis1-Electronics/octanis_eps/v0.4_second_run/octanis_eps_v04.brd

## EAGLE design octanis_eps/v0.4_second_run/octanis_eps_v04.brd (2016-01-02)

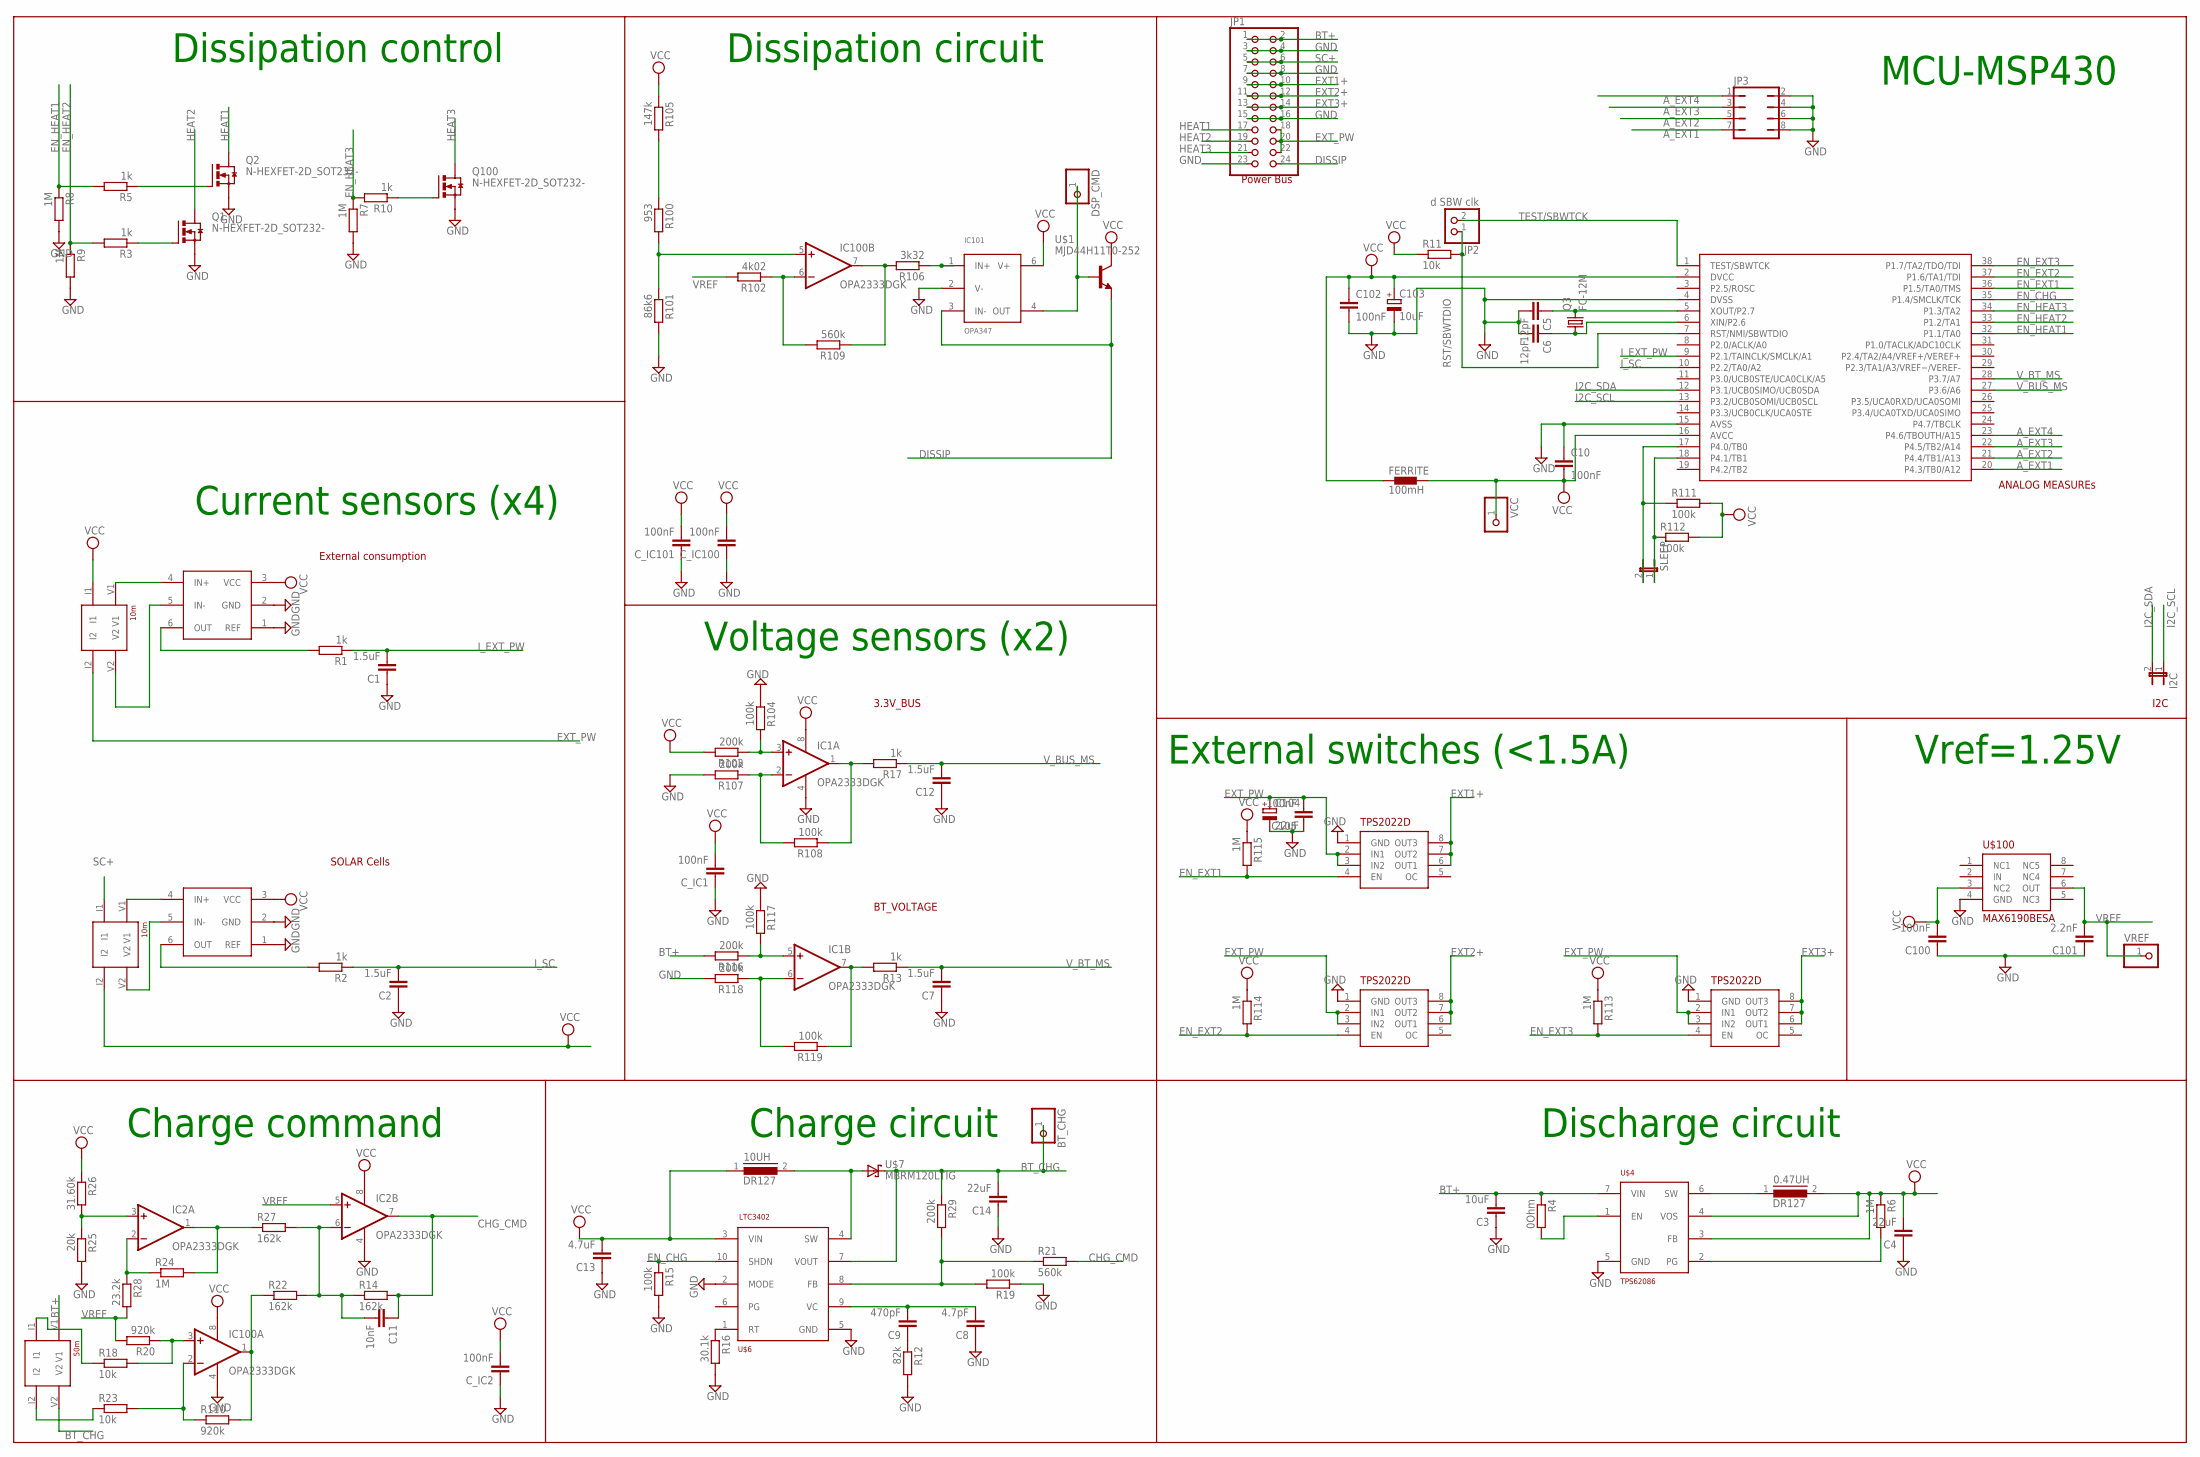
[picture p64: schematic octanis_eps_v04.sch]

Parts:
0.47UH, 10UH: DR127
BT_CHG: PINHD-1X1; 1X01
C1, C2, C7, C12: 1.5uF; C0603
C3: 10uF; C1206
C4: 22uF; C1206
C5, C6: 12pF; C0603
C8: 4.7pF; C0603
C9: 470pF; C0603
C10, C100, C102, C105: 100nF; C0603
C11: 10nF; C0603
C13: 4.7uF; C1206
C14: 22uF; C0603
C101: 2.2nF; C0603
C103: 10uF; A/3216-18R
C104: 22uF; A/3216-18R
C_IC1, C_IC2, C_IC100, C_IC101: 100nF; C0603
DSP_CMD: PINHD-1X1; 1X01
FERRITE: 100mH; 0402
I2C: JP1E; JP1
IC1, IC2, IC100: OPA2333DGK; MSOP08
IC101: OPA347; SC70-5
JP1: PINHD-2X12; 2X12
JP2: d SBW clk; 1X02
JP3: JP4Q
Q1, Q2, Q100: N-HEXFET-2D_SOT232-; SOT223
Q3: FC-12M
R1, R2, R3, R5, R10, R13, R17: 1k; R0603
R4: 0Ohm; R0603
R6, R7, R8, R9, R24, R113, R114, R115: 1M; R0603
R11, R18, R23: 10k; R0603
R12: 82k; R0603
R14, R22, R27: 162k; R0603
R15, R19, R104, R108, R111, R112, R117, R119: 100k; R0603
R16: 30.1k; R0603
R20, R110: 920k; R0603
R21, R109: 560k; R0603
R25: 20k; R0603
R26: 31.60k; R0603
R28: 23.2k; R0603
R29, R103, R107, R116, R118: 200k; R0603
R100: 953; R0603
R101: 86k6; R0603
R102: 4k02; R0603
R105: 147k; R0603
R106: 3k32; R0603
RSENSE1: 10m; 4PADS_RESISTOR
RSENSE2: 50m; 4PADS_RESISTOR
R_SENSE1: 10m; 4PADS_RESISTOR
SLEEP: JP1E; JP1
U$1: MJD44H11T0-252; TO252
U$2, U$3: INA213; SC70-6
U$4: TPS62086; QFN-7
U$5: MSP430G2544; TSSOP38_MSPGXX44_SERIES
U$6: LTC3402; MSOP10
U$7: MBRM120LTIG; DO216AA
U$100: MAX6190BESA; SO8
U$101, U$102, U$103: TPS2022D; SO8
VCC: PINHD-1X1; 1X01
VREF: PINHD-1X1; 1X01

Connections:
A_EXT1: JP3.7, U$5.20 (P4.3/TB0/A12)
A_EXT2: JP3.5, U$5.21 (P4.4/TB1/A13)
A_EXT3: JP3.3, U$5.22 (P4.5/TB2/A14)
A_EXT4: JP3.1, U$5.23 (P4.6/TBOUTH/A15)
BT+: C3.2, JP1.1, JP1.2, R4.1, R116.2, RSENSE2.V1, U$4.7 (VIN)
BT_CHG: BT_CHG.1, C14.2, R29.1, RSENSE2.V2, U$6.7 (VOUT), U$7.C (K)
CHG_CMD: C11.1, IC2.7 (OUT), R14.2, R21.2
DISSIP: IC101.3 (IN-), JP1.24, U$1.3 (E)
EN_CHG: R15.1, U$5.35 (P1.4/SMCLK/TCK), U$6.10 (SHDN)
EN_EXT1: R115.2, U$5.36 (P1.5/TA0/TMS), U$103.4 (EN)
EN_EXT2: R114.2, U$5.37 (P1.6/TA1/TDI), U$102.4 (EN)
EN_EXT3: R113.2, U$5.38 (P1.7/TA2/TDO/TDI), U$101.4 (EN)
EN_HEAT1: R5.2, R8.1, U$5.32 (P1.1/TA0)
EN_HEAT2: R3.2, R9.1, U$5.33 (P1.2/TA1)
EN_HEAT3: R7.1, R10.2, U$5.34 (P1.3/TA2)
EXT1+: JP1.9, JP1.10, U$103.6 (OUT1), U$103.7 (OUT2), U$103.8 (OUT3)
EXT2+: JP1.11, JP1.12, U$102.6 (OUT1), U$102.7 (OUT2), U$102.8 (OUT3)
EXT3+: JP1.13, JP1.14, U$101.6 (OUT1), U$101.7 (OUT2), U$101.8 (OUT3)
EXT_PW: C104.+, C105.2, JP1.18, JP1.20, JP1.22, R_SENSE1.I2, U$101.2 (IN1), U$101.3 (IN2), U$102.2 (IN1), U$102.3 (IN2), U$103.2 (IN1), U$103.3 (IN2)
GND: C1.1, C2.1, C3.1, C4.1, C5.2, C6.2, C7.1, C8.1, C10.1, C12.1, C13.1, C14.1, C100.1, C101.1, C102.2, C103.-, C104.-, C105.1, C_IC1.1, C_IC2.1, C_IC100.1, C_IC101.1, IC1.4 (V-), IC2.4 (V-), IC100.4 (V-), IC101.2 (V-), JP1.3, JP1.4, JP1.7, JP1.8, JP1.15, JP1.16, JP1.23, JP3.2, JP3.4, JP3.6, JP3.8, Q1.3 (S), Q2.3 (S), Q100.3 (S), R7.2, R8.2, R9.2, R12.2, R15.2, R16.2, R19.1, R25.2, R101.2, R104.1, R107.2, R117.1, R118.2, U$2.1 (REF), U$2.2 (GND), U$3.1 (REF), U$3.2 (GND), U$4.5 (GND), U$5.4 (DVSS), U$5.15 (AVSS), U$6.2 (MODE), U$6.5 (GND), U$100.4 (GND), U$101.1 (GND), U$102.1 (GND), U$103.1 (GND)
HEAT1: JP1.17, Q2.2 (D), Q2.4 (D)
HEAT2: JP1.19, Q1.2 (D), Q1.4 (D)
HEAT3: JP1.21, Q100.2 (D), Q100.4 (D)
I2C_SCL: I2C.1, U$5.13 (P3.2/UCB0SOMI/UCB0SCL)
I2C_SDA: I2C.2, U$5.12 (P3.1/UCB0SIMO/UCB0SDA)
I_EXT_PW: C1.2, R1.1, U$5.9 (P2.1/TAINCLK/SMCLK/A1)
I_SC: C2.2, R2.1, U$5.10 (P2.2/TA0/A2)
unnamed: R1.2, U$3.6 (OUT)
unnamed: R2.2, U$2.6 (OUT)
unnamed: R16.1, U$6.1 (RT)
unnamed: C9.1, R12.1
unnamed: IC100.1 (OUT), R22.1, R110.2
unnamed: IC2.3 (+IN), R25.1, R26.2
unnamed: IC2.2 (-IN), R24.1, R28.1
unnamed: C8.2, C9.2, U$6.9 (VC)
unnamed: IC2.1 (OUT), R24.2, R27.1
unnamed: IC1.7 (OUT), R13.2, R119.1
unnamed: C11.2, IC2.6 (-IN), R14.1, R22.2, R27.2
unnamed: IC1.1 (OUT), R17.2, R108.1
unnamed: IC1.2 (-IN), R107.1, R108.2
unnamed: IC1.3 (+IN), R103.1, R104.2
unnamed: IC1.6 (-IN), R118.1, R119.2
unnamed: IC1.5 (+IN), R116.1, R117.2
unnamed: IC100.2 (-IN), R23.2, R110.1
unnamed: R100.1, R105.2
unnamed: IC100.5 (+IN), R100.2, R101.1
unnamed: IC100.6 (-IN), R102.1, R109.2
unnamed: IC100.7 (OUT), R106.2, R109.1
unnamed: IC101.1 (IN+), R106.1
unnamed: R19.2, R21.1, R29.2, U$6.8 (FB)
unnamed: 10UH.2, U$6.4 (SW), U$7.A
unnamed: R6.2, U$4.2 (PG)
unnamed: 0.47UH.1, U$4.6 (SW)
unnamed: IC100.3 (+IN), R18.2, R20.1
unnamed: Q2.1 (G), R5.1
unnamed: R4.2, U$4.1 (EN)
unnamed: Q1.1 (G), R3.1
unnamed: R_SENSE1.V1, U$3.4 (IN+)
unnamed: R_SENSE1.V2, U$3.5 (IN-)
unnamed: RSENSE1.V1, U$2.4 (IN+)
unnamed: RSENSE1.V2, U$2.5 (IN-)
unnamed: Q100.1 (G), R10.1
unnamed: R23.1, RSENSE2.I2
unnamed: R18.1, RSENSE2.I1
unnamed: DSP_CMD.1, IC101.4 (OUT), U$1.1 (B)
unnamed: C5.1, Q3.2, U$5.5 (XOUT/P2.7)
unnamed: C6.1, Q3.1, U$5.6 (XIN/P2.6)
RST/SBWTDIO: JP2.1, R11.2, U$5.7 (RST/NMI/SBWTDIO)
SC+: JP1.5, JP1.6, RSENSE1.I1
TB0: R111.1, SLEEP.2, U$5.17 (P4.0/TB0)
TB1: R112.1, SLEEP.1, U$5.18 (P4.1/TB1)
TEST/SBWTCK: JP2.2, U$5.1 (TEST/SBWTCK)
VCC: 0.47UH.2, 10UH.1, C4.2, C10.2, C13.2, C100.2, C102.1, C103.+, C_IC1.2, C_IC2.2, C_IC100.2, C_IC101.2, FERRITE.1, FERRITE.2, IC1.8 (V+), IC2.8 (V+), IC100.8 (V+), IC101.6 (V+), R6.1, R11.1, R26.1, R103.2, R105.1, R111.2, R112.2, R113.1, R114.1, R115.1, RSENSE1.I2, R_SENSE1.I1, U$1.2 (C), U$2.3 (VCC), U$3.3 (VCC), U$4.3 (FB), U$4.4 (VOS), U$5.2 (DVCC), U$5.16 (AVCC), U$6.3 (VIN), U$100.3 (NC2), VCC.1
VREF: C101.2, IC2.5 (+IN), R20.2, R28.2, R102.2, U$100.6 (OUT), VREF.1
V_BT_MS: C7.2, R13.1, U$5.28 (P3.7/A7)
V_BUS_MS: C12.2, R17.1, U$5.27 (P3.6/A6)

Notes on the sheet:
Vref=1.25V
Current sensors (x4)
SOLAR Cells
3.3V_BUS
Charge circuit
Discharge circuit
External switches (<1.5A)
MCU-MSP430
Voltage sensors (x2)
BT_VOLTAGE
Dissipation circuit
ANALOG MEASUREs
I2C
External consumption
Dissipation control
Power Bus
Charge command

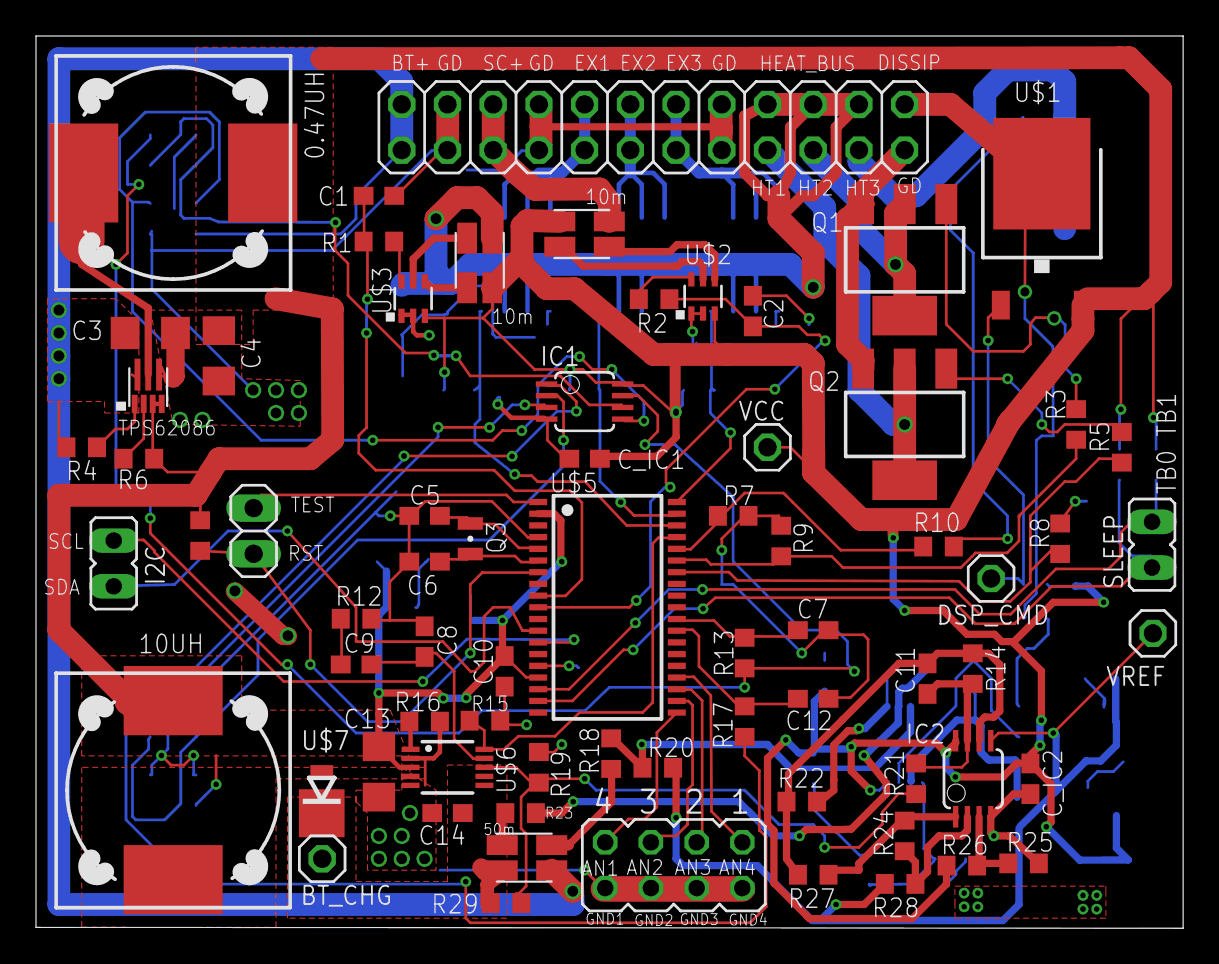
[picture p65: board octanis_eps_v04.brd from above]

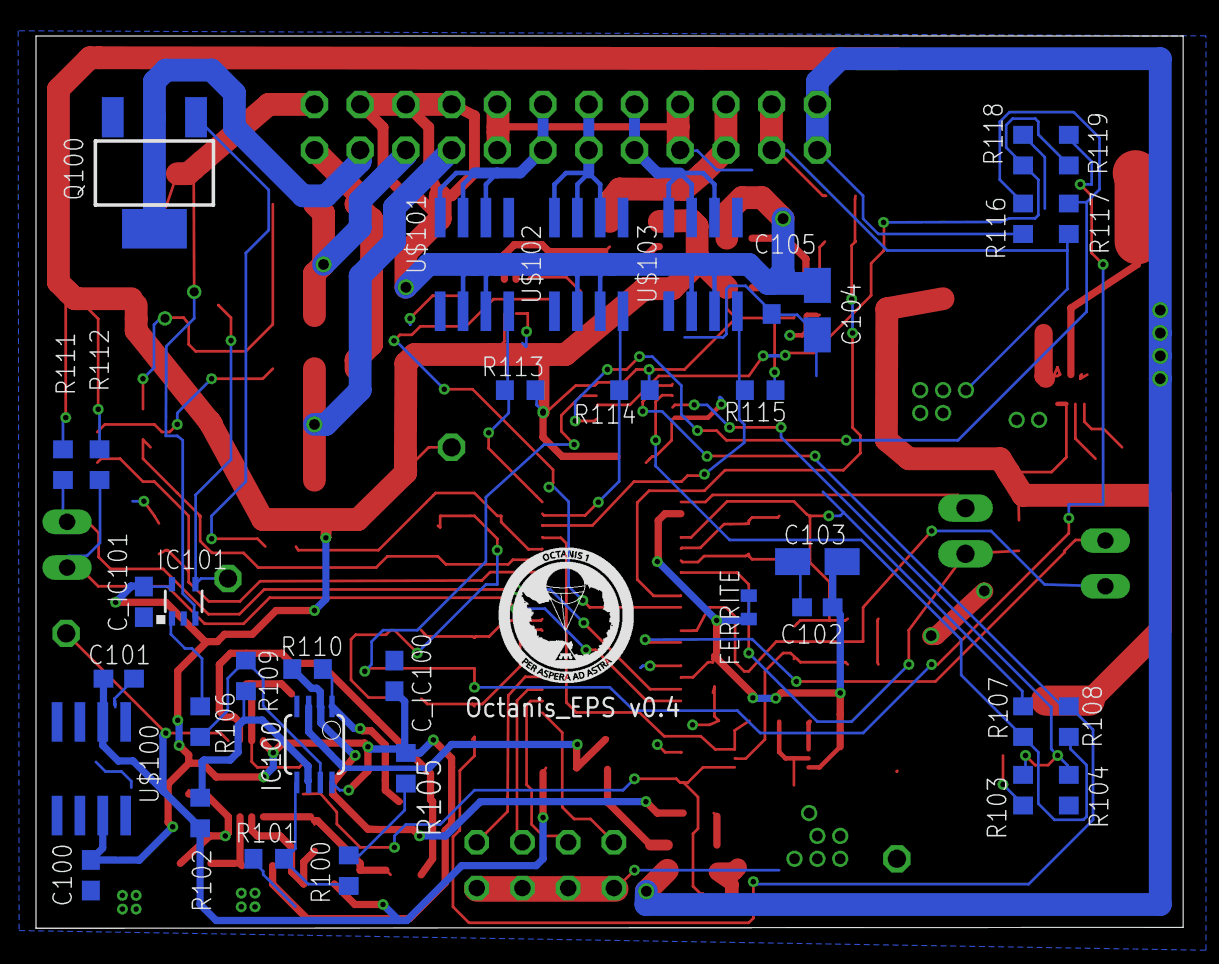
[picture p66: board octanis_eps_v04.brd from below]

Board: 4 copper layers, 63.7 x 49.6 mm, 107 parts (36 on the bottom side), 76 nets.
