Octanis1/Octanis1-Electronics/octanis_eps/_old/v0.3_footprint_corrections/octanis_eps_v03.brd

## EAGLE design octanis_eps/_old/v0.3_footprint_corrections/octanis_eps_v03.brd (2015-12-20, an earlier design)

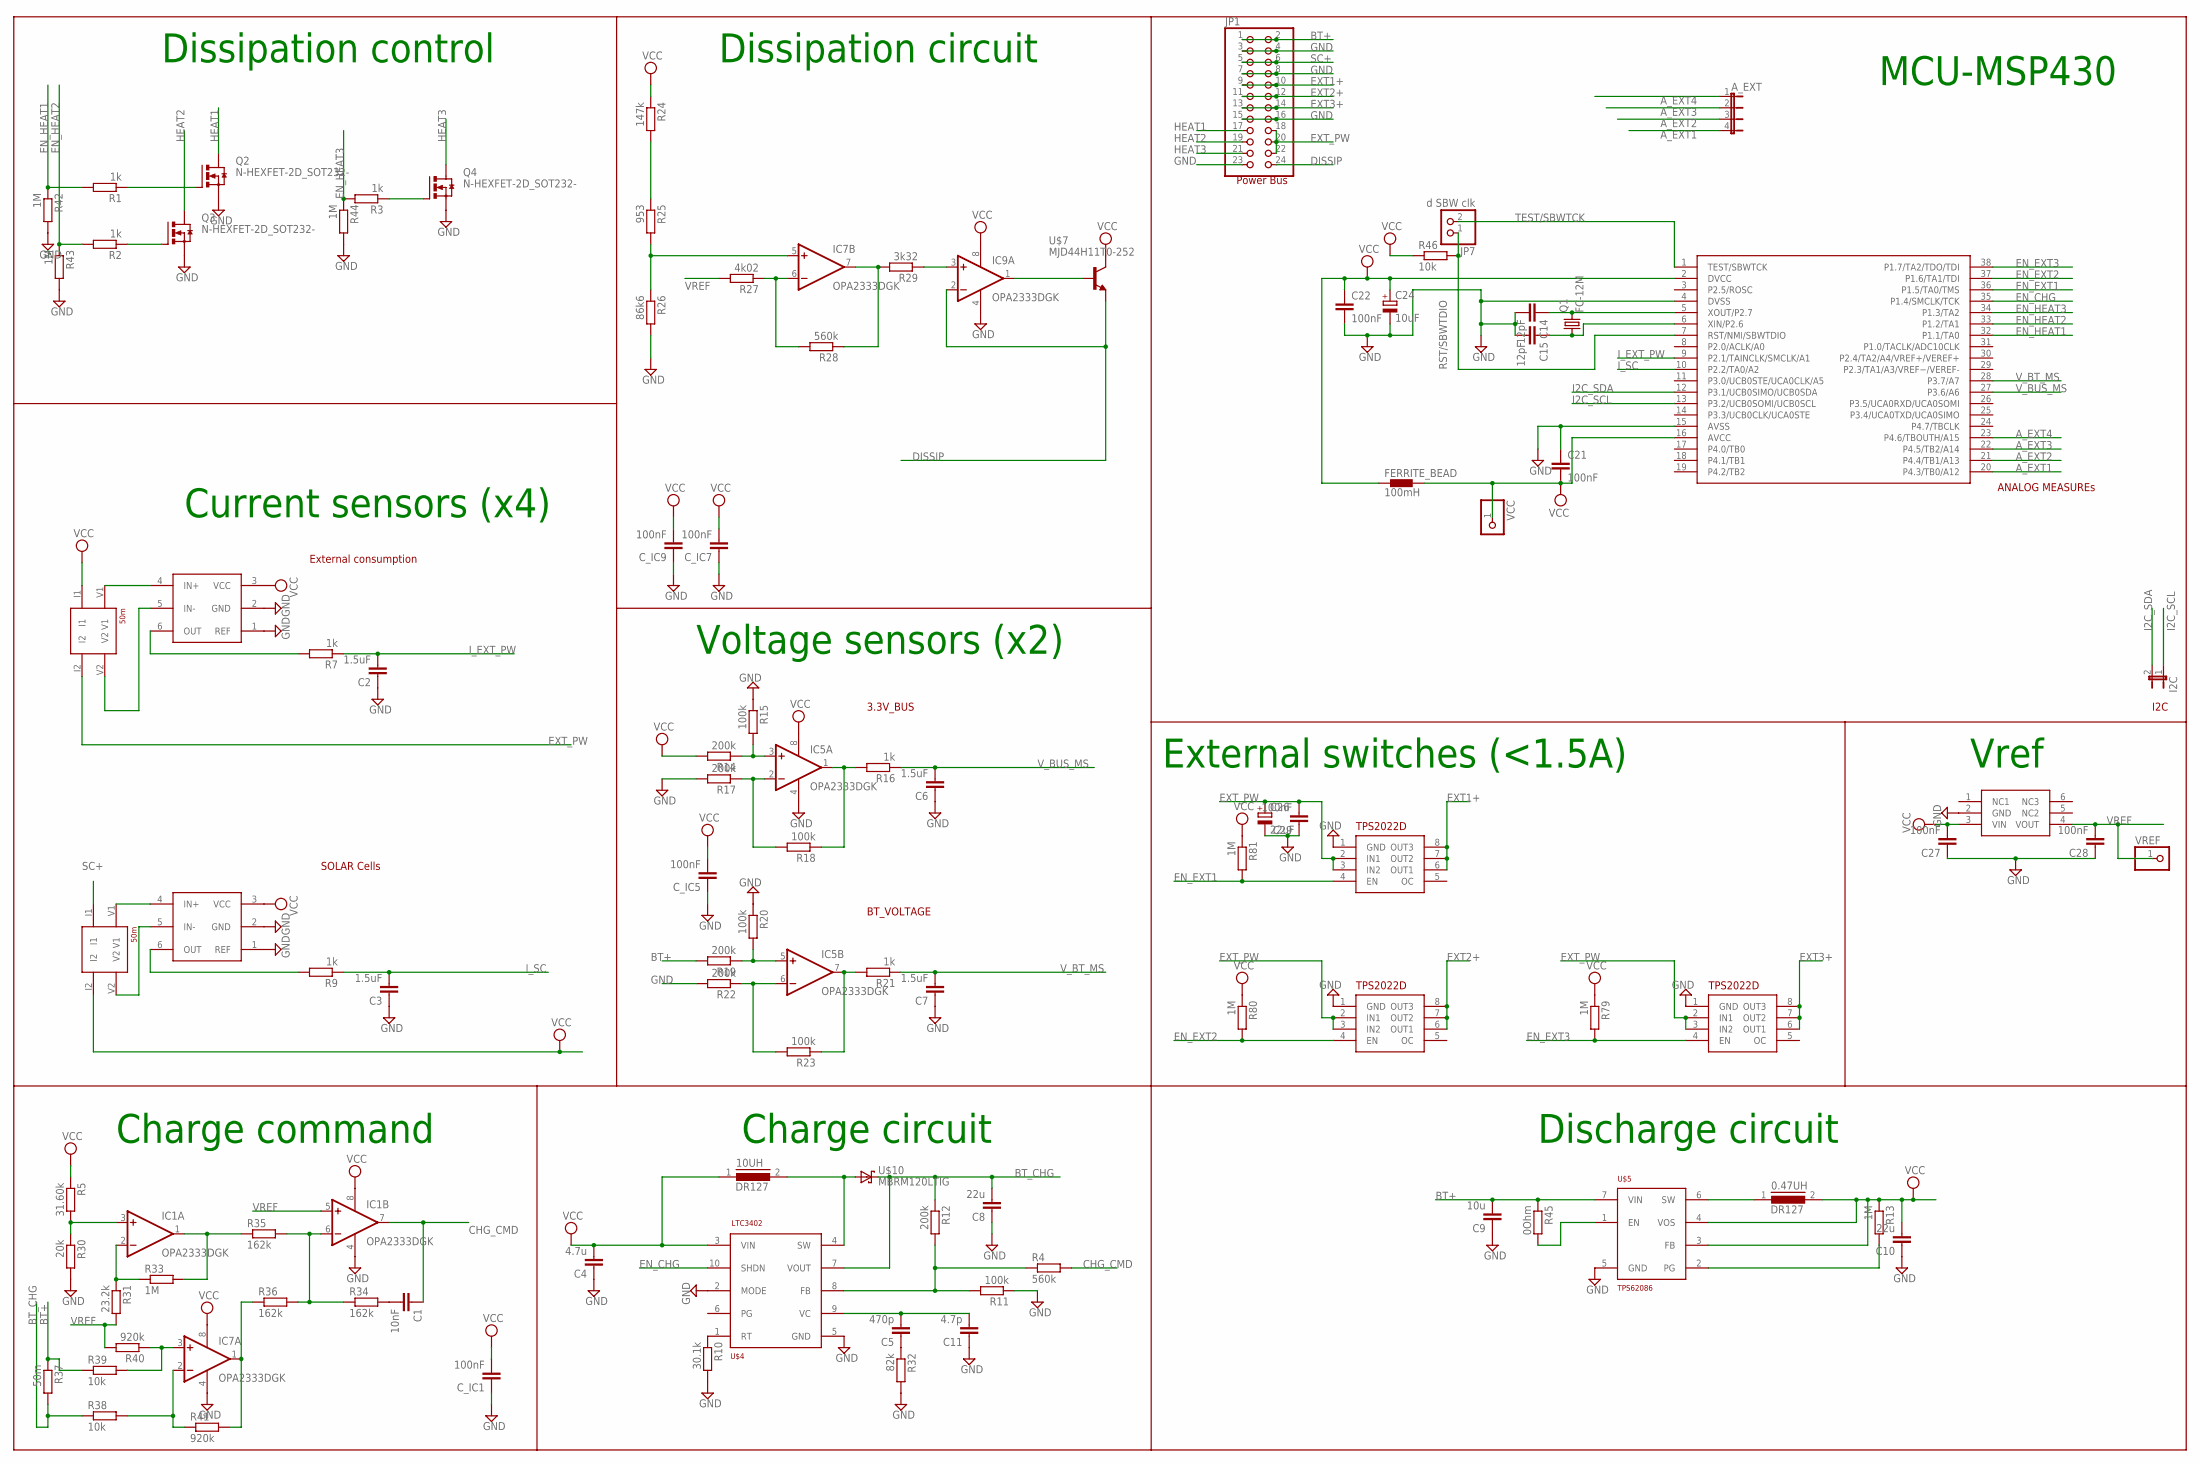
[picture p67: schematic octanis_eps_v03.sch]

Parts:
0.47UH, 10UH: DR127
A_EXT: JP4E; JP4
C1: 10nF; C0603
C2, C3, C6, C7: 1.5uF; C0603
C4: 4.7u; C1206
C5: 470p; C0603
C8: 22u; C0603
C9: 10u; C1206
C10: 22u; C1206
C11: 4.7p; C0603
C14, C15: 12pF; C0603
C21, C22, C27, C28, C29: 100nF; C0603
C24: 10uF; A/3216-18R
C26: 22uF; A/3216-18R
C_IC1, C_IC5, C_IC7, C_IC9: 100nF; C0603
FERRITE_BEAD: 100mH; 0402
I2C: JP1E; JP1
IC1, IC5, IC7, IC9: OPA2333DGK; MSOP08
JP1: PINHD-2X12; 2X12
JP7: d SBW clk; 1X02
Q1: FC-12M
Q2, Q3, Q4: N-HEXFET-2D_SOT232-; SOT223
R1, R2, R3, R7, R9, R16, R21: 1k; R0603
R4, R28: 560k; R0603
R5: 31.60k; R0603
R10: 30.1k; R0603
R11, R15, R18, R20, R23: 100k; R0603
R12, R14, R17, R19, R22: 200k; R0603
R13, R33, R42, R43, R44, R79, R80, R81: 1M; R0603
R24: 147k; R0603
R25: 953; R0603
R26: 86k6; R0603
R27: 4k02; R0603
R29: 3k32; R0603
R30: 20k; R0603
R31: 23.2k; R0603
R32: 82k; R0603
R34, R35, R36: 162k; R0603
R37: 50m; R1206
R38, R39, R46: 10k; R0603
R40, R41: 920k; R0603
R45: 0Ohm; R0603
U$1, U$8: 50m; 4PADS_RESISTOR
U$2, U$3: INA213; SC70-6
U$4: LTC3402; MSOP10
U$5: TPS62086; QFN-7
U$6: MSP430G2544; TSSOP38_MSPGXX44_SERIES
U$7: MJD44H11T0-252; TO252
U$10: MBRM120LTIG; DO216AA
U$16, U$17, U$18: TPS2022D; SO8
U$19: ADR127B; TSOT23-6
VCC: PINHD-1X1; 1X01
VREF: PINHD-1X1; 1X01

Connections:
A_EXT1: A_EXT.4, U$6.20 (P4.3/TB0/A12)
A_EXT2: A_EXT.3, U$6.21 (P4.4/TB1/A13)
A_EXT3: A_EXT.2, U$6.22 (P4.5/TB2/A14)
A_EXT4: A_EXT.1, U$6.23 (P4.6/TBOUTH/A15)
BT+: C9.2, JP1.1, JP1.2, R19.2, R37.1, R39.1, R45.1, U$5.7 (VIN)
BT_CHG: C8.2, R12.1, R37.2, R38.1, U$4.7 (VOUT), U$10.C (K)
CHG_CMD: C1.1, IC1.7 (OUT), R4.2
DISSIP: IC9.2 (-IN), JP1.24, U$7.3 (E)
EN_CHG: U$4.10 (SHDN), U$6.35 (P1.4/SMCLK/TCK)
EN_EXT1: R81.2, U$6.36 (P1.5/TA0/TMS), U$16.4 (EN)
EN_EXT2: R80.2, U$6.37 (P1.6/TA1/TDI), U$17.4 (EN)
EN_EXT3: R79.2, U$6.38 (P1.7/TA2/TDO/TDI), U$18.4 (EN)
EN_HEAT1: R1.2, R42.1, U$6.32 (P1.1/TA0)
EN_HEAT2: R2.2, R43.1, U$6.33 (P1.2/TA1)
EN_HEAT3: R3.2, R44.1, U$6.34 (P1.3/TA2)
EXT1+: JP1.9, JP1.10, U$16.6 (OUT1), U$16.7 (OUT2), U$16.8 (OUT3)
EXT2+: JP1.11, JP1.12, U$17.6 (OUT1), U$17.7 (OUT2), U$17.8 (OUT3)
EXT3+: JP1.13, JP1.14, U$18.6 (OUT1), U$18.7 (OUT2), U$18.8 (OUT3)
EXT_PW: C26.+, C29.2, JP1.18, JP1.20, JP1.22, U$1.I2, U$16.2 (IN1), U$16.3 (IN2), U$17.2 (IN1), U$17.3 (IN2), U$18.2 (IN1), U$18.3 (IN2)
GND: C2.1, C3.1, C4.1, C6.1, C7.1, C8.1, C9.1, C10.1, C11.1, C14.2, C15.2, C21.1, C22.2, C24.-, C26.-, C27.1, C28.1, C29.1, C_IC1.1, C_IC5.1, C_IC7.1, C_IC9.1, IC1.4 (V-), IC5.4 (V-), IC7.4 (V-), IC9.4 (V-), JP1.3, JP1.4, JP1.7, JP1.8, JP1.15, JP1.16, JP1.23, Q2.3 (S), Q3.3 (S), Q4.3 (S), R10.2, R11.1, R15.1, R17.2, R20.1, R22.2, R26.2, R30.2, R32.2, R42.2, R43.2, R44.2, U$2.1 (REF), U$2.2 (GND), U$3.1 (REF), U$3.2 (GND), U$4.2 (MODE), U$4.5 (GND), U$5.5 (GND), U$6.4 (DVSS), U$6.15 (AVSS), U$16.1 (GND), U$17.1 (GND), U$18.1 (GND), U$19.2 (GND)
HEAT1: JP1.17, Q2.2 (D), Q2.4 (D)
HEAT2: JP1.19, Q3.2 (D), Q3.4 (D)
HEAT3: JP1.21, Q4.2 (D), Q4.4 (D)
I2C_SCL: I2C.1, U$6.13 (P3.2/UCB0SOMI/UCB0SCL)
I2C_SDA: I2C.2, U$6.12 (P3.1/UCB0SIMO/UCB0SDA)
I_EXT_PW: C2.2, R7.1, U$6.9 (P2.1/TAINCLK/SMCLK/A1)
I_SC: C3.2, R9.1, U$6.10 (P2.2/TA0/A2)
unnamed: R7.2, U$2.6 (OUT)
unnamed: R9.2, U$3.6 (OUT)
unnamed: R10.1, U$4.1 (RT)
unnamed: C5.1, R32.1
unnamed: IC7.1 (OUT), R36.1, R41.2
unnamed: IC1.3 (+IN), R5.2, R30.1
unnamed: IC1.2 (-IN), R31.1, R33.1
unnamed: C5.2, C11.2, U$4.9 (VC)
unnamed: IC1.1 (OUT), R33.2, R35.1
unnamed: IC5.7 (OUT), R21.2, R23.1
unnamed: IC1.6 (-IN), R34.1, R35.2, R36.2
unnamed: IC5.1 (OUT), R16.2, R18.1
unnamed: IC5.2 (-IN), R17.1, R18.2
unnamed: IC5.3 (+IN), R14.1, R15.2
unnamed: IC5.6 (-IN), R22.1, R23.2
unnamed: IC5.5 (+IN), R19.1, R20.2
unnamed: IC7.2 (-IN), R38.2, R41.1
unnamed: R24.2, R25.1
unnamed: IC7.5 (+IN), R25.2, R26.1
unnamed: IC7.6 (-IN), R27.1, R28.2
unnamed: IC7.7 (OUT), R28.1, R29.2
unnamed: IC9.3 (+IN), R29.1
unnamed: R4.1, R11.2, R12.2, U$4.8 (FB)
unnamed: 10UH.2, U$4.4 (SW), U$10.A
unnamed: R13.2, U$5.2 (PG)
unnamed: 0.47UH.1, U$5.6 (SW)
unnamed: C1.2, R34.2
unnamed: IC7.3 (+IN), R39.2, R40.1
unnamed: Q2.1 (G), R1.1
unnamed: R45.2, U$5.1 (EN)
unnamed: Q3.1 (G), R2.1
unnamed: U$1.V1, U$2.4 (IN+)
unnamed: U$1.V2, U$2.5 (IN-)
unnamed: U$3.4 (IN+), U$8.V1
unnamed: U$3.5 (IN-), U$8.V2
unnamed: Q4.1 (G), R3.1
unnamed: IC9.1 (OUT), U$7.1 (B)
unnamed: C14.1, Q1.2, U$6.5 (XOUT/P2.7)
unnamed: C15.1, Q1.1, U$6.6 (XIN/P2.6)
RST/SBWTDIO: JP7.1, R46.2, U$6.7 (RST/NMI/SBWTDIO)
SC+: JP1.5, JP1.6, U$8.I1
TEST/SBWTCK: JP7.2, U$6.1 (TEST/SBWTCK)
VCC: 0.47UH.2, 10UH.1, C4.2, C10.2, C21.2, C22.1, C24.+, C27.2, C_IC1.2, C_IC5.2, C_IC7.2, C_IC9.2, FERRITE_BEAD.1, FERRITE_BEAD.2, IC1.8 (V+), IC5.8 (V+), IC7.8 (V+), IC9.8 (V+), R5.1, R13.1, R14.2, R24.1, R46.1, R79.1, R80.1, R81.1, U$1.I1, U$2.3 (VCC), U$3.3 (VCC), U$4.3 (VIN), U$5.3 (FB), U$5.4 (VOS), U$6.2 (DVCC), U$6.16 (AVCC), U$7.2 (C), U$8.I2, U$19.3 (VIN), VCC.1
VREF: C28.2, IC1.5 (+IN), R27.2, R31.2, R40.2, U$19.4 (VOUT), VREF.1
V_BT_MS: C7.2, R21.1, U$6.28 (P3.7/A7)
V_BUS_MS: C6.2, R16.1, U$6.27 (P3.6/A6)

Notes on the sheet:
Vref
Current sensors (x4)
SOLAR Cells
3.3V_BUS
Charge circuit
Discharge circuit
External switches (<1.5A)
MCU-MSP430
Voltage sensors (x2)
BT_VOLTAGE
Dissipation circuit
ANALOG MEASUREs
I2C
External consumption
Dissipation control
Power Bus
Charge command

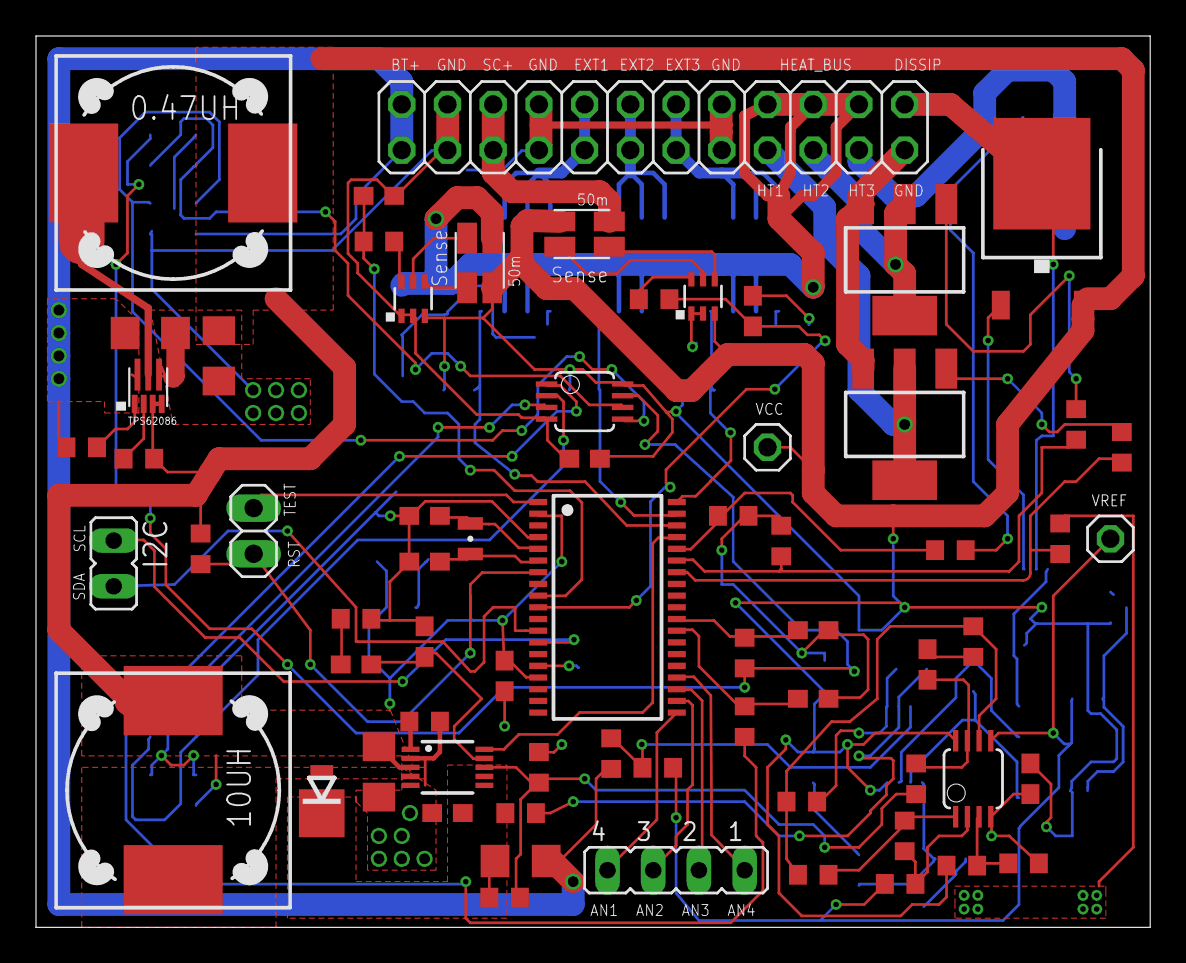
[picture p68: board octanis_eps_v03.brd from above]

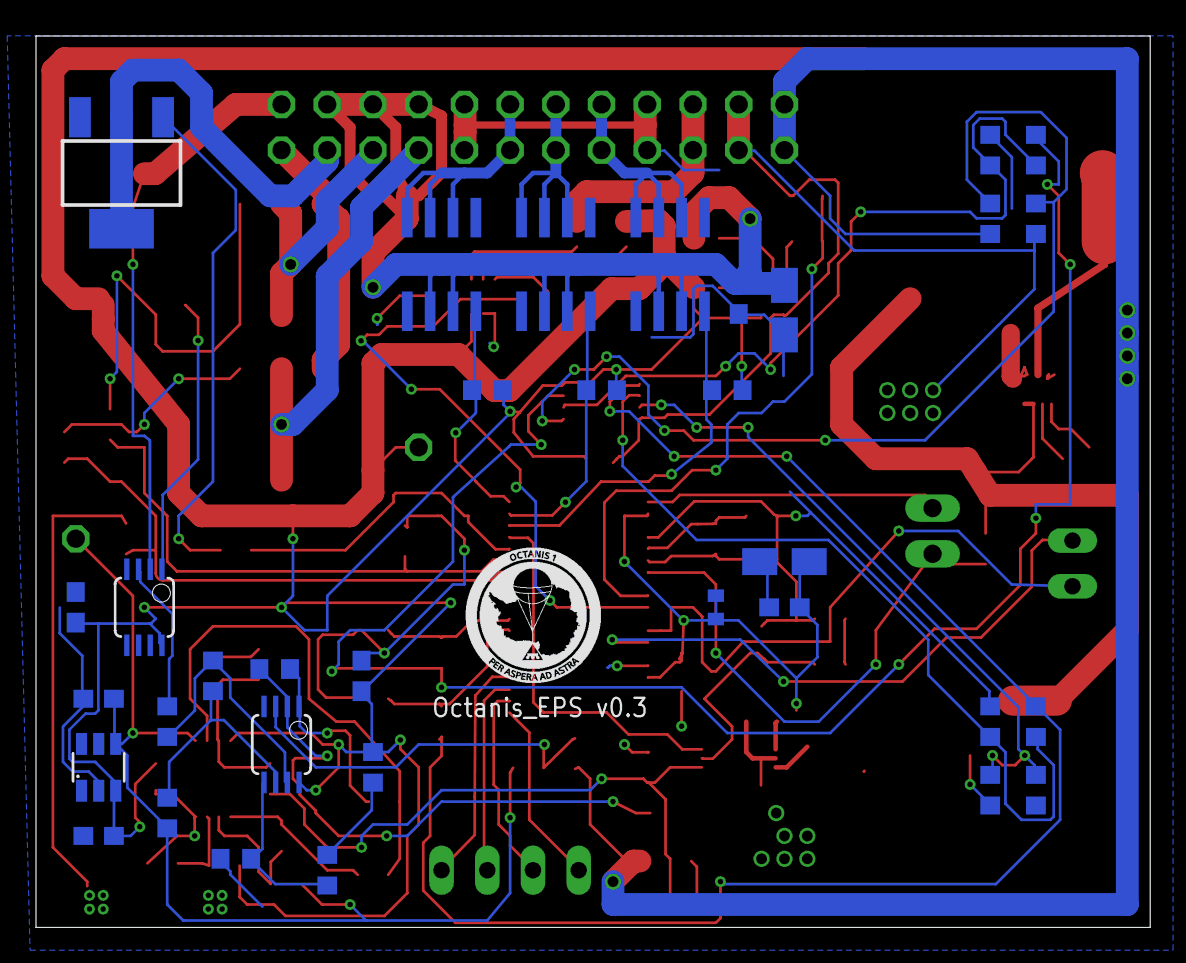
[picture p69: board octanis_eps_v03.brd from below]

Board: 4 copper layers, 61.9 x 49.5 mm, 101 parts (34 on the bottom side), 73 nets.
