Octanis1/Octanis1-Electronics/led-board/led-board.brd

## EAGLE design led-board/led-board.brd (2015-12-01)

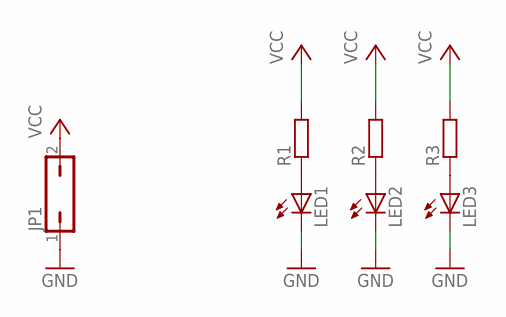
[picture p70: schematic led-board.sch]

Parts:
JP1: JP1Q; JP1
LED1, LED2, LED3: LED5MM
R1, R2, R3: R-EU_0414/15; 0414/15

Connections:
GND: JP1.1, LED1.K (C), LED2.K (C), LED3.K (C)
unnamed: LED1.A, R1.1
unnamed: LED2.A, R2.1
unnamed: LED3.A, R3.1
VCC: JP1.2, R1.2, R2.2, R3.2

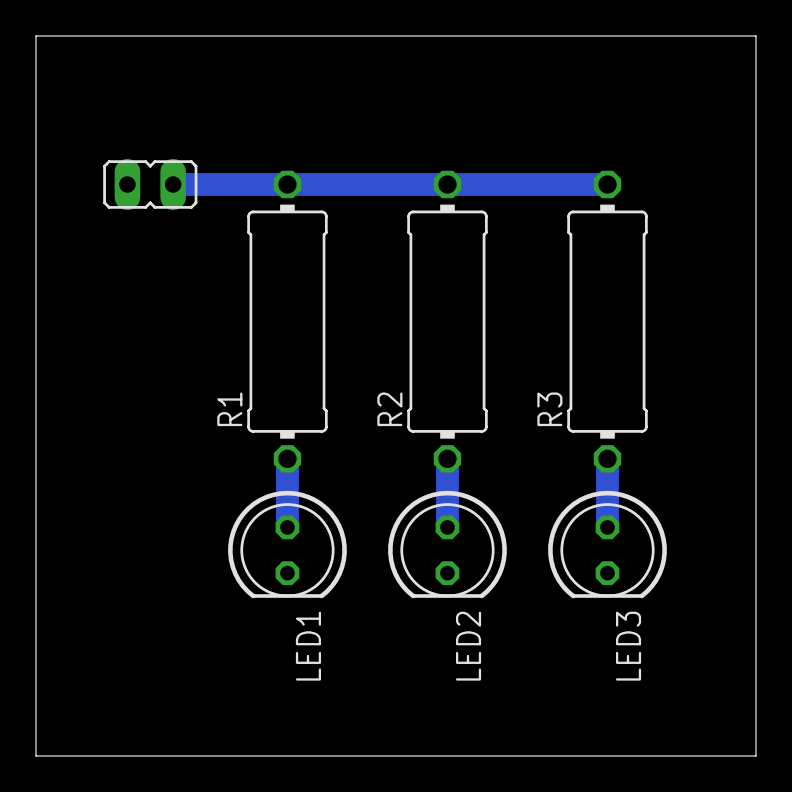
[picture p71: board led-board.brd from above]

Board: 2 copper layers, 40.0 x 40.0 mm, 7 parts (0 on the bottom side), 5 nets.
