Octanis1/Octanis1-Electronics/spectrometer/spectrometer.brd

## EAGLE design spectrometer/spectrometer.brd (2015-12-01)

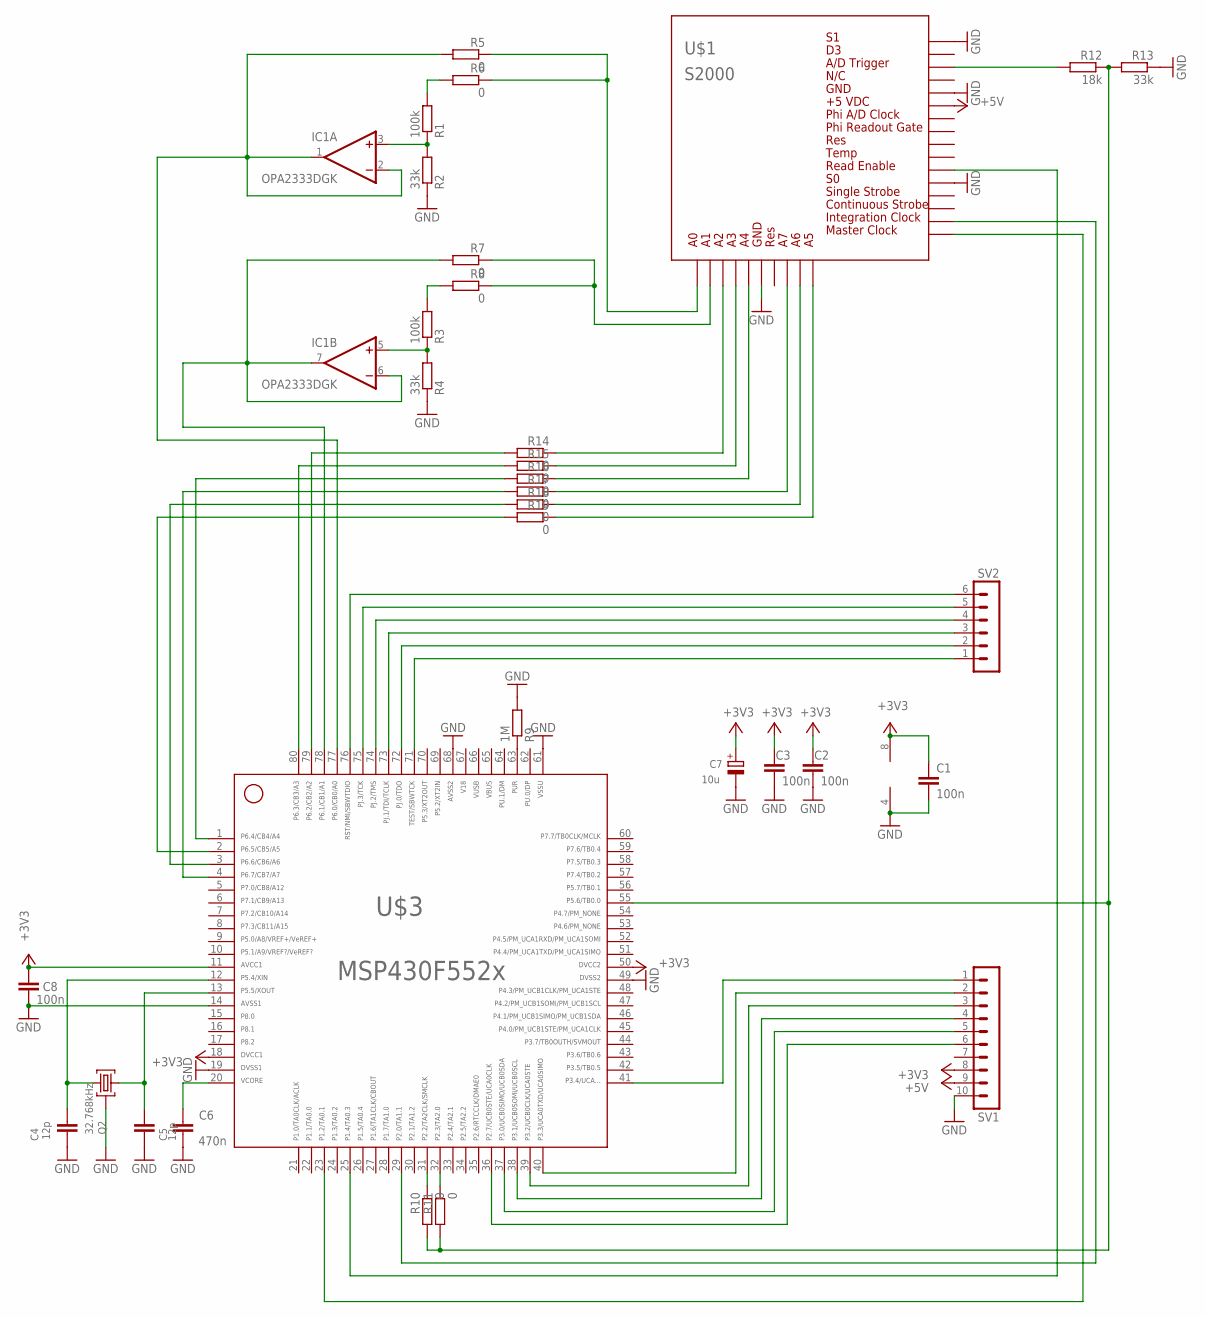
[picture p72: schematic spectrometer.sch]

Parts:
C1, C2, C3, C8: 100n; C0603
C4, C5: 12p; C0603
C6: 470n; C0603
C7: 10u; A/3216-18R
IC1: OPA2333DGK; MSOP08
Q2: 32.768kHz; MS3V-T1R
R1, R3: 100k; R0603
R2, R4, R13: 33k; R0603
R5, R6, R7, R8, R10, R11, R14, R15, R16, R17, R18, R19: 0; R0603
R9: 1M; R0603
R12: 18k; R0603
SV1: MA10-1
SV2: MA06-1
U$1: S2000
U$3: F552X---PN80; PN80

Connections:
65: U$3.65
66: U$3.66
67: U$3.67
+3V3: C1.1, C2.2, C3.2, C7.+, C8.1, IC1.8 (V+), SV1.8, U$3.11, U$3.18, U$3.50
+5V: SV1.9, U$1.H2$2
GND: C1.2, C2.1, C3.1, C4.1, C5.1, C6.1, C7.-, C8.2, IC1.4 (V-), Q2.P3 (GND), R2.1, R4.1, R9.2, R13.1, SV1.10, U$1.H1$6, U$1.H2$1, U$1.H2$8, U$1.H2$A, U$3.14, U$3.19, U$3.49, U$3.61, U$3.68
unnamed: IC1.3 (+IN), R1.1, R2.2
unnamed: IC1.5 (+IN), R3.1, R4.2
unnamed: IC1.1 (OUT), IC1.2 (-IN), R5.2, U$3.77
unnamed: IC1.6 (-IN), IC1.7 (OUT), R7.2, U$3.78
unnamed: R1.2, R6.2
unnamed: R3.2, R8.2
unnamed: R5.1, R6.1, U$1.H1$1
unnamed: R7.1, R8.1, U$1.H1$2
unnamed: SV1.1, U$3.41
unnamed: SV1.2, U$3.40
unnamed: SV1.3, U$3.39
unnamed: SV1.4, U$3.38
unnamed: SV1.5, U$3.37
unnamed: SV1.6, U$3.36
unnamed: R14.2, U$3.79
unnamed: R15.2, U$3.80
unnamed: R16.2, U$3.1
unnamed: R17.2, U$3.4
unnamed: R18.2, U$3.3
unnamed: R19.2, U$3.2
unnamed: R9.1, U$3.63
unnamed: SV2.1, U$3.71
unnamed: SV2.2, U$3.72
unnamed: SV2.3, U$3.73
unnamed: SV2.4, U$3.74
unnamed: SV2.5, U$3.75
unnamed: SV2.6, U$3.76
unnamed: U$1.H2$12, U$3.23
unnamed: C4.2, Q2.P2 (2), U$3.12
unnamed: C6.2, U$3.20
unnamed: C5.2, Q2.P1 (1), U$3.13
unnamed: U$1.H2$11, U$3.29
unnamed: R10.1, U$3.31
unnamed: R11.1, U$3.32
unnamed: R10.2, R11.2, R12.1, R13.2, U$3.55
unnamed: R14.1, U$1.H1$3
unnamed: R12.2, U$1.H2$C
unnamed: R15.1, U$1.H1$4
unnamed: R16.1, U$1.H1$5
unnamed: R17.1, U$1.H1$8
unnamed: R18.1, U$1.H1$9
unnamed: U$1.H2$7, U$3.25
unnamed: R19.1, U$1.H1$10

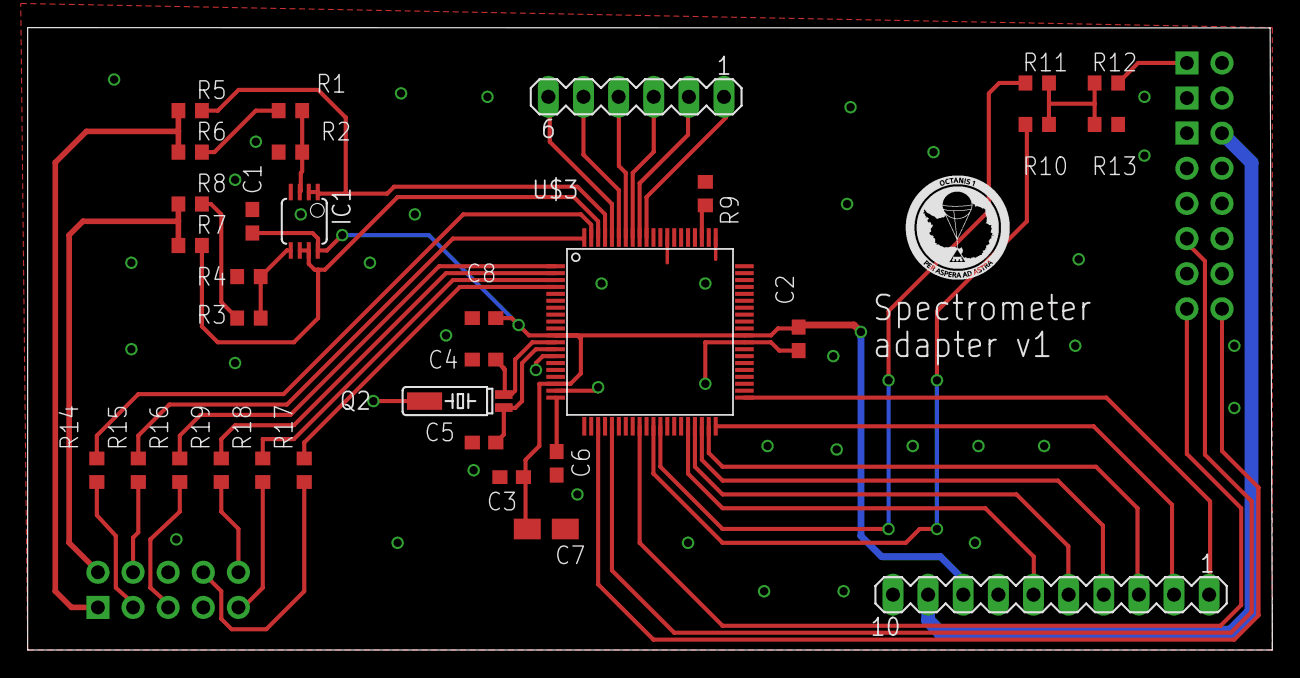
[picture p73: board spectrometer.brd from above]

Board: 2 copper layers, 90.0 x 45.0 mm, 33 parts (0 on the bottom side), 46 nets.
