Octanis1/Octanis1-Electronics/octanis_main_pcb_v0.5/octanis_v0.5.brd

## EAGLE design octanis_main_pcb_v0.5/octanis_v0.5.brd (continued)

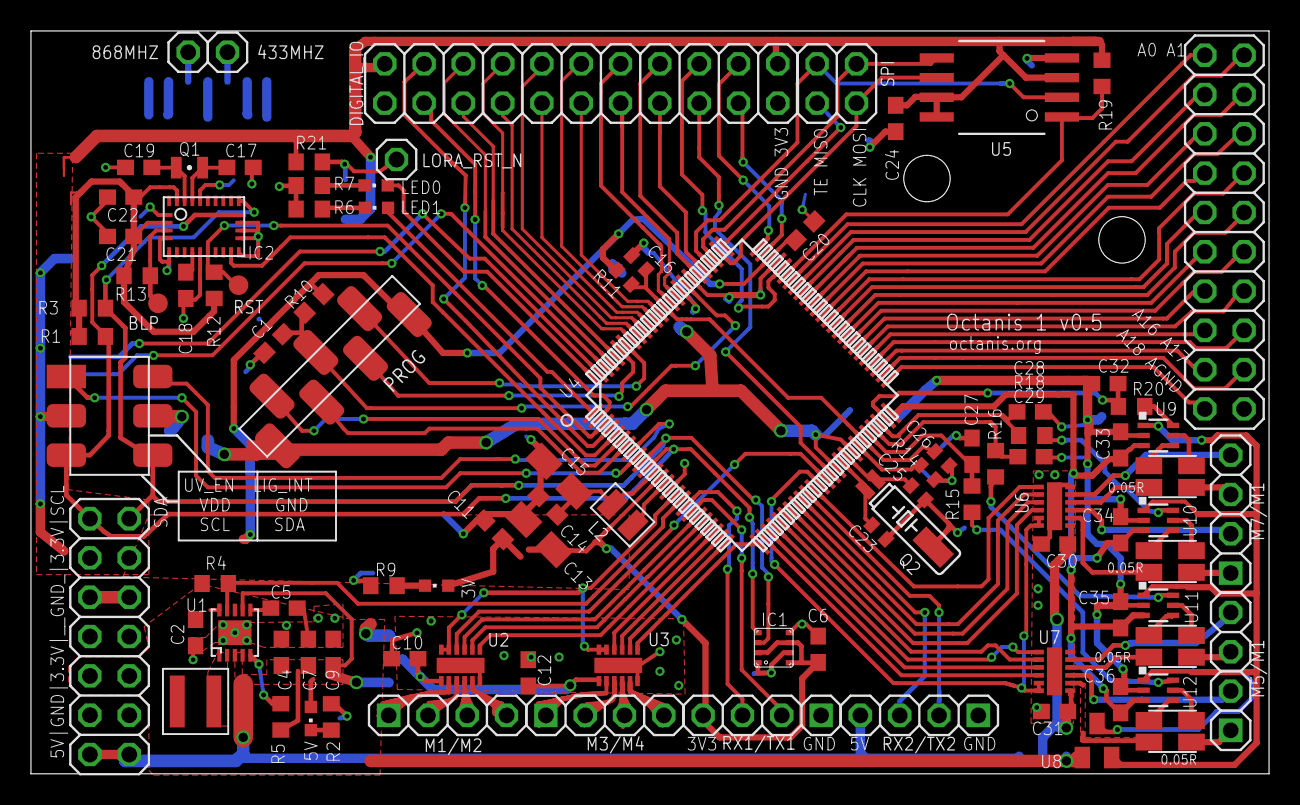
[picture p80: board octanis_v0.5.brd from above]

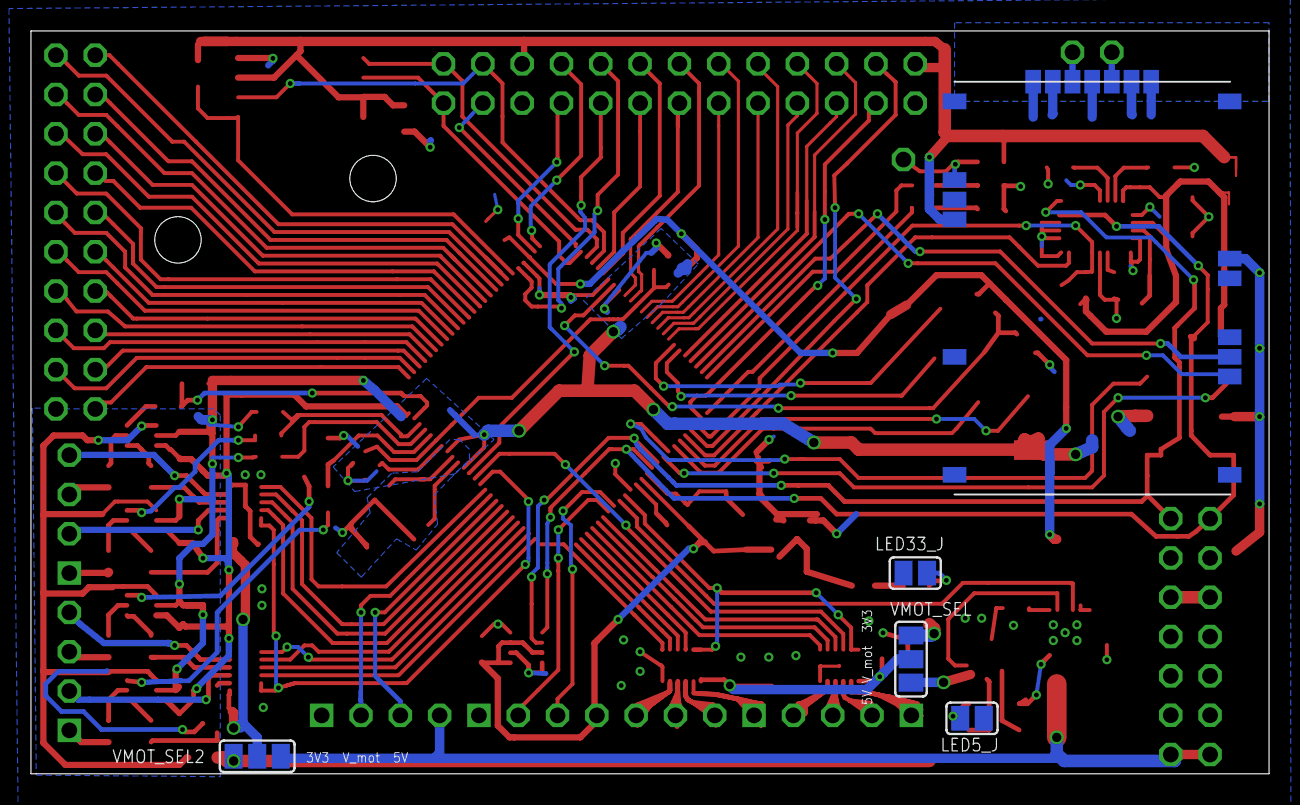
[picture p81: board octanis_v0.5.brd from below]

Board: 2 copper layers, 80.0 x 48.0 mm, 103 parts (5 on the bottom side), 147 nets.
