Octanis1/Octanis1-Electronics/octanis_eps/_old/v0.2_compact_version/octanis_eps_compact.brd

## EAGLE design octanis_eps/_old/v0.2_compact_version/octanis_eps_compact.brd (2015-05-29, an earlier design)

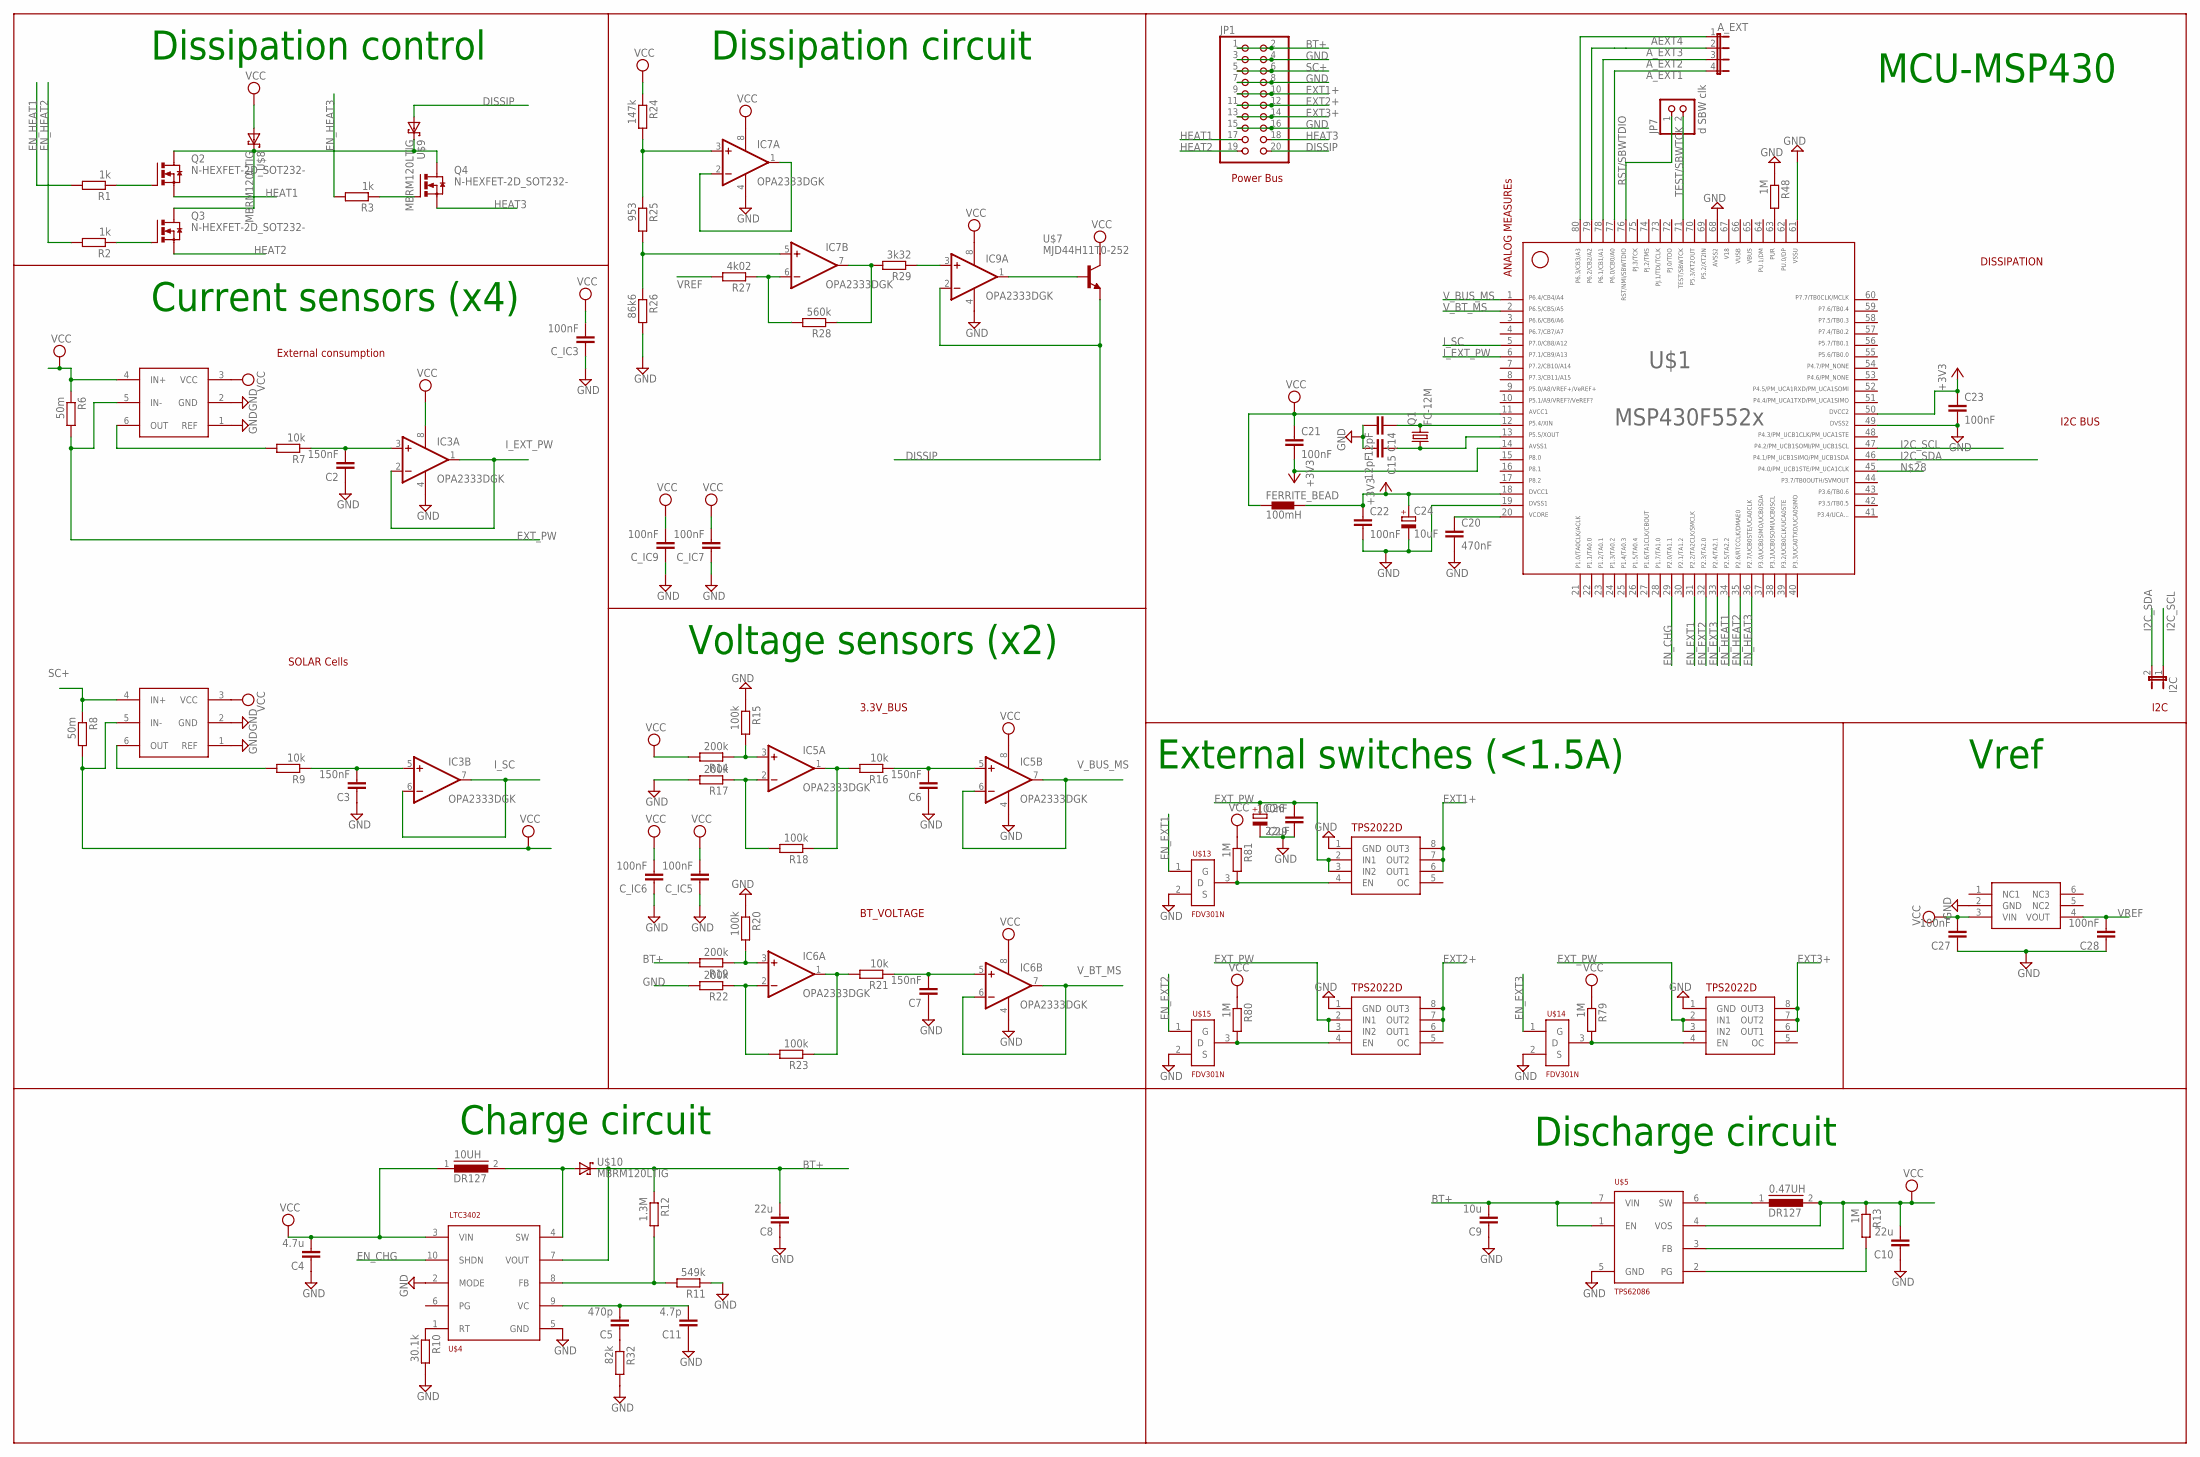
[picture p82: schematic octanis_eps_compact.sch]

Parts:
0.47UH, 10UH: DR127
A_EXT: JP4E; JP4
C2, C3, C6, C7: 150nF; C0603
C4: 4.7u; C1206
C5: 470p; C0603
C8: 22u; C0603
C9: 10u; C1206
C10: 22u; C1206
C11: 4.7p; C0603
C14, C15: 12pF; C0603
C20: 470nF; C0603
C21, C22, C23, C27, C28, C29: 100nF; C0603
C24: 10uF; A/3216-18R
C26: 22uF; A/3216-18R
C_IC3, C_IC5, C_IC6, C_IC7, C_IC9: 100nF; C0603
FERRITE_BEAD: 100mH; 0402
I2C: JP1E; JP1
IC3, IC5, IC6, IC7, IC9: OPA2333DGK; MSOP08
JP1: PINHD-2X10; 2X10
JP7: d SBW clk; 1X02
Q1: FC-12M
Q2, Q3, Q4: N-HEXFET-2D_SOT232-; SOT223
R1, R2, R3: 1k; R0603
R6, R8: 50m; R1206
R7, R9, R16, R21: 10k; R0603
R10: 30.1k; R0603
R11: 549k; R0603
R12: 1.3M; R0603
R13, R48, R79, R80, R81: 1M; R0603
R14, R17, R19, R22: 200k; R0603
R15, R18, R20, R23: 100k; R0603
R24: 147k; R0603
R25: 953; R0603
R26: 86k6; R0603
R27: 4k02; R0603
R28: 560k; R0603
R29: 3k32; R0603
R32: 82k; R0603
U$1: F552X---PN80; PN80
U$2, U$3: INA213; SC70-6
U$4: LTC3402; MSOP10
U$5: TPS62086; QFN-7
U$7: MJD44H11T0-252; TO252
U$8, U$9, U$10: MBRM120LTIG; DO216AA
U$13, U$14, U$15: FDV301N; SOT23
U$16, U$17, U$18: TPS2022D; SO8
U$19: ADR127B; TSOT23-6

Connections:
65: U$1.65
66: U$1.66
67: U$1.67
+3V3: C21.2, C22.1, C23.1, C24.+, FERRITE_BEAD.2, U$1.14, U$1.18, U$1.50
AEXT4: A_EXT.1, U$1.80
A_EXT1: A_EXT.4, U$1.77
A_EXT2: A_EXT.3, U$1.78
A_EXT3: A_EXT.2, U$1.79
BT+: C8.2, C9.2, JP1.1, JP1.2, R12.1, R19.2, U$4.7 (VOUT), U$5.1 (EN), U$5.7 (VIN), U$10.C (K)
DISSIP: IC9.2 (-IN), JP1.20, U$7.3 (E), U$9.A
EN_CHG: U$1.29, U$4.10 (SHDN)
EN_EXT1: U$1.31, U$13.1 (G)
EN_EXT2: U$1.32, U$15.1 (G)
EN_EXT3: U$1.33, U$14.1 (G)
EN_HEAT1: R1.2, U$1.34
EN_HEAT2: R2.2, U$1.35
EN_HEAT3: R3.2, U$1.36
EXT1+: JP1.9, JP1.10, U$16.6 (OUT1), U$16.7 (OUT2), U$16.8 (OUT3)
EXT2+: JP1.11, JP1.12, U$17.6 (OUT1), U$17.7 (OUT2), U$17.8 (OUT3)
EXT3+: JP1.13, JP1.14, U$18.6 (OUT1), U$18.7 (OUT2), U$18.8 (OUT3)
EXT_PW: C26.+, C29.2, R6.2, U$2.5 (IN-), U$16.2 (IN1), U$16.3 (IN2), U$17.2 (IN1), U$17.3 (IN2), U$18.2 (IN1), U$18.3 (IN2)
GND: C2.1, C3.1, C4.1, C6.1, C7.1, C8.1, C9.1, C10.1, C11.1, C14.2, C15.2, C20.2, C22.2, C23.2, C24.-, C26.-, C27.1, C28.1, C29.1, C_IC3.1, C_IC5.1, C_IC6.1, C_IC7.1, C_IC9.1, IC3.4 (V-), IC5.4 (V-), IC6.4 (V-), IC7.4 (V-), IC9.4 (V-), JP1.3, JP1.4, JP1.7, JP1.8, JP1.15, JP1.16, R10.2, R11.1, R15.1, R17.2, R20.1, R22.2, R26.2, R32.2, R48.1, U$1.19, U$1.49, U$1.61, U$1.68, U$2.1 (REF), U$2.2 (GND), U$3.1 (REF), U$3.2 (GND), U$4.2 (MODE), U$4.5 (GND), U$5.5 (GND), U$13.2 (S), U$14.2 (S), U$15.2 (S), U$16.1 (GND), U$17.1 (GND), U$18.1 (GND), U$19.2 (GND)
HEAT1: JP1.17, Q2.3 (S)
HEAT2: JP1.19, Q3.3 (S)
HEAT3: JP1.18, Q4.3 (S)
I2C_SCL: I2C.1, U$1.47
I2C_SDA: I2C.2, U$1.46
I_EXT_PW: IC3.1 (OUT), IC3.2 (-IN), U$1.6
I_SC: IC3.6 (-IN), IC3.7 (OUT), U$1.5
unnamed: R7.2, U$2.6 (OUT)
unnamed: R9.2, U$3.6 (OUT)
unnamed: R10.1, U$4.1 (RT)
unnamed: C5.1, R32.1
unnamed: Q2.2 (D), Q2.4 (D), Q3.2 (D), Q3.4 (D), Q4.2 (D), Q4.4 (D), U$8.C (K), U$9.C (K)
unnamed: C2.2, IC3.3 (+IN), R7.1
unnamed: C3.2, IC3.5 (+IN), R9.1
unnamed: C5.2, C11.2, U$4.9 (VC)
unnamed: C7.2, IC6.5 (+IN), R21.1
unnamed: IC6.1 (OUT), R21.2, R23.1
unnamed: C6.2, IC5.5 (+IN), R16.1
unnamed: IC5.1 (OUT), R16.2, R18.1
unnamed: IC5.2 (-IN), R17.1, R18.2
unnamed: IC5.3 (+IN), R14.1, R15.2
unnamed: IC6.2 (-IN), R22.1, R23.2
unnamed: IC6.3 (+IN), R19.1, R20.2
unnamed: IC7.1 (OUT), IC7.2 (-IN)
unnamed: IC7.3 (+IN), R24.2, R25.1
unnamed: IC7.5 (+IN), R25.2, R26.1
unnamed: IC7.6 (-IN), R27.1, R28.2
unnamed: IC7.7 (OUT), R28.1, R29.2
unnamed: IC9.3 (+IN), R29.1
unnamed: R11.2, R12.2, U$4.8 (FB)
unnamed: 10UH.2, U$4.4 (SW), U$10.A
unnamed: R13.2, U$5.2 (PG)
unnamed: 0.47UH.1, U$5.6 (SW)
unnamed: R48.2, U$1.63
unnamed: Q2.1 (G), R1.1
unnamed: Q3.1 (G), R2.1
unnamed: R80.2, U$15.3 (D), U$17.4 (EN)
unnamed: Q4.1 (G), R3.1
unnamed: IC9.1 (OUT), U$7.1 (B)
unnamed: C14.1, Q1.2, U$1.12
unnamed: C20.1, U$1.20
unnamed: C15.1, Q1.1, U$1.13
unnamed: R81.2, U$13.3 (D), U$16.4 (EN)
unnamed: R79.2, U$14.3 (D), U$18.4 (EN)
RST/SBWTDIO: JP7.1, U$1.76
SC+: JP1.5, JP1.6, R8.1, U$3.4 (IN+)
TEST/SBWTCK: JP7.2, U$1.71
VCC: 0.47UH.2, 10UH.1, C4.2, C10.2, C21.1, C27.2, C_IC3.2, C_IC5.2, C_IC6.2, C_IC7.2, C_IC9.2, FERRITE_BEAD.1, IC3.8 (V+), IC5.8 (V+), IC6.8 (V+), IC7.8 (V+), IC9.8 (V+), R6.1, R8.2, R13.1, R14.2, R24.1, R79.1, R80.1, R81.1, U$1.11, U$2.3 (VCC), U$2.4 (IN+), U$3.3 (VCC), U$3.5 (IN-), U$4.3 (VIN), U$5.3 (FB), U$5.4 (VOS), U$7.2 (C), U$8.A, U$19.3 (VIN)
VREF: C28.2, R27.2, U$19.4 (VOUT)
V_BT_MS: IC6.6 (-IN), IC6.7 (OUT), U$1.2
V_BUS_MS: IC5.6 (-IN), IC5.7 (OUT), U$1.1

Notes on the sheet:
Vref
Current sensors (x4)
SOLAR Cells
3.3V_BUS
Charge circuit
Discharge circuit
External switches (<1.5A)
MCU-MSP430
Voltage sensors (x2)
BT_VOLTAGE
Dissipation circuit
I2C BUS
ANALOG MEASUREs
I2C
External consumption
Dissipation control
DISSIPATION
Power Bus

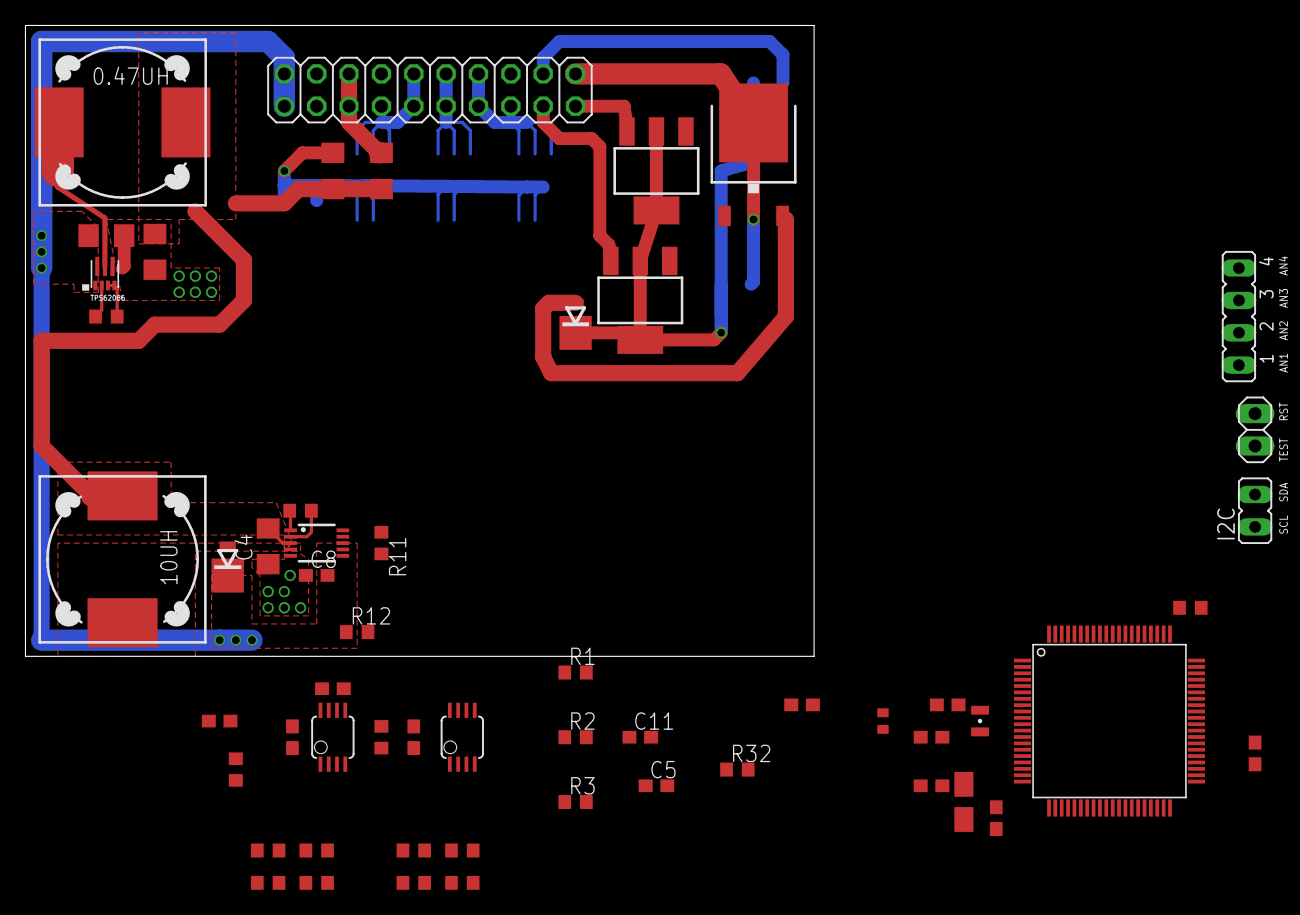
[picture p83: board octanis_eps_compact.brd from above]

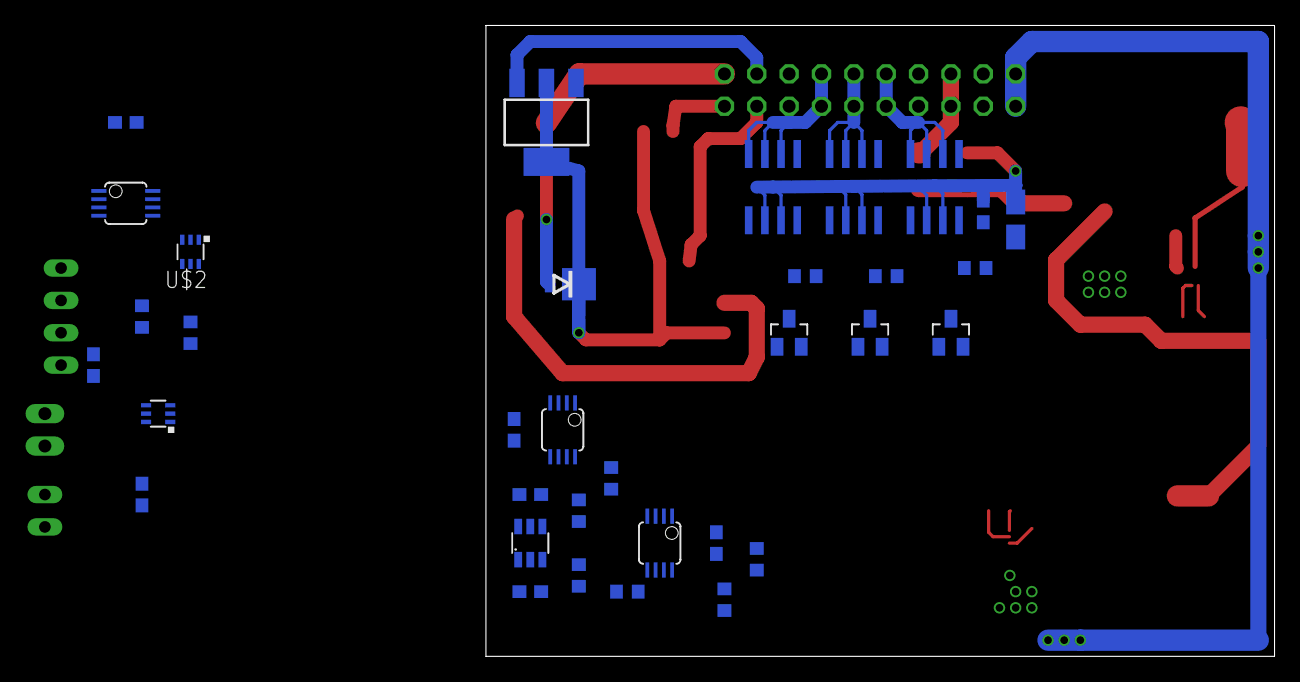
[picture p84: board octanis_eps_compact.brd from below]

Board: 4 copper layers, 61.9 x 49.5 mm, 90 parts (34 on the bottom side), 70 nets.
