Octanis1/Octanis1-Electronics/ARIA-BOB/aria-BOB.brd

## EAGLE design ARIA-BOB/aria-BOB.brd (2015-05-29)

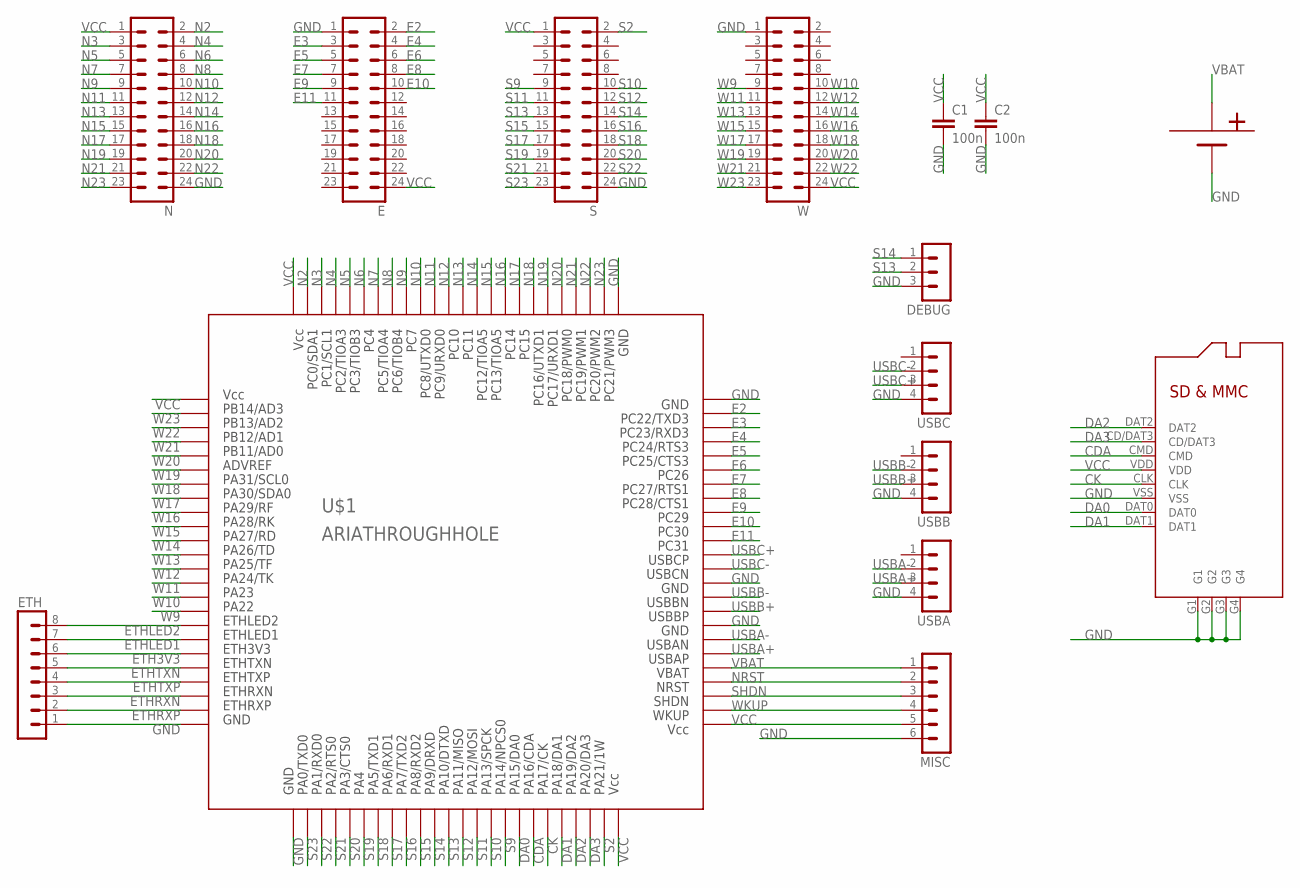
[picture p85: schematic aria-BOB.sch]

Parts:
C1, C2: 100n; C0603
DEBUG: MA03-1
E: MA12-2
ETH: MA08-1
MISC: MA06-1
N: MA12-2
S: MA12-2
U$1: ARIATHROUGHHOLE; ARIA-TROUGHHOLE
U$3: BAT; BAT-CR1220
U$4: MICRO-SD; MISCRO-SD
USBA: MA04-1
USBB: MA04-1
USBC: MA04-1
W: MA12-2

Connections:
CDA: U$1.S7, U$4.CMD
CK: U$1.S6, U$4.CLK
DA0: U$1.S8, U$4.DAT0
DA1: U$1.S5, U$4.DAT1
DA2: U$1.S4, U$4.DAT2
DA3: U$1.S3, U$4.CD/DAT3
E2: E.2, U$1.E2
E3: E.3, U$1.E3
E4: E.4, U$1.E4
E5: E.5, U$1.E5
E6: E.6, U$1.E6
E7: E.7, U$1.E7
E8: E.8, U$1.E8
E9: E.9, U$1.E9
E10: E.10, U$1.E10
E11: E.11, U$1.E11
ETH3V3: ETH.6, U$1.W6
ETHLED1: ETH.7, U$1.W7
ETHLED2: ETH.8, U$1.W8
ETHRXN: ETH.3, U$1.W3
ETHRXP: ETH.2, U$1.W2
ETHTXN: ETH.5, U$1.W5
ETHTXP: ETH.4, U$1.W4
GND: C1.2, C2.2, DEBUG.3, E.1, ETH.1, MISC.6, N.24, S.24, U$1.E1, U$1.E14, U$1.E17, U$1.N24, U$1.S24, U$1.W1, U$3.BAT-, U$4.G1, U$4.G2, U$4.G3, U$4.G4, U$4.VSS, USBA.4, USBB.4, USBC.4, W.1
N2: N.2, U$1.N2
N3: N.3, U$1.N3
N4: N.4, U$1.N4
N5: N.5, U$1.N5
N6: N.6, U$1.N6
N7: N.7, U$1.N7
N8: N.8, U$1.N8
N9: N.9, U$1.N9
N10: N.10, U$1.N10
N11: N.11, U$1.N11
N12: N.12, U$1.N12
N13: N.13, U$1.N13
N14: N.14, U$1.N14
N15: N.15, U$1.N15
N16: N.16, U$1.N16
N17: N.17, U$1.N17
N18: N.18, U$1.N18
N19: N.19, U$1.N19
N20: N.20, U$1.N20
N21: N.21, U$1.N21
N22: N.22, U$1.N22
N23: N.23, U$1.N23
NRST: MISC.2, U$1.E21
S2: S.2, U$1.S2
S9: S.9, U$1.S9
S10: S.10, U$1.S10
S11: S.11, U$1.S11
S12: S.12, U$1.S12
S13: DEBUG.2, S.13, U$1.S13
S14: DEBUG.1, S.14, U$1.S14
S15: S.15, U$1.S15
S16: S.16, U$1.S16
S17: S.17, U$1.S17
S18: S.18, U$1.S18
S19: S.19, U$1.S19
S20: S.20, U$1.S20
S21: S.21, U$1.S21
S22: S.22, U$1.S22
S23: S.23, U$1.S23
SHDN: MISC.3, U$1.E22
USBA+: U$1.E19, USBA.3
USBA-: U$1.E18, USBA.2
USBB+: U$1.E16, USBB.3
USBB-: U$1.E15, USBB.2
USBC+: U$1.E12, USBC.3
USBC-: U$1.E13, USBC.2
VBAT: MISC.1, U$1.E20, U$3.BAT1+ (BAT+), U$3.BAT+
VCC: C1.1, C2.1, E.24, MISC.5, N.1, S.1, U$1.E24, U$1.N1, U$1.S1, U$1.W24, U$4.VDD, W.24
W9: U$1.W9, W.9
W10: U$1.W10, W.10
W11: U$1.W11, W.11
W12: U$1.W12, W.12
W13: U$1.W13, W.13
W14: U$1.W14, W.14
W15: U$1.W15, W.15
W16: U$1.W16, W.16
W17: U$1.W17, W.17
W18: U$1.W18, W.18
W19: U$1.W19, W.19
W20: U$1.W20, W.20
W21: U$1.W21, W.21
W22: U$1.W22, W.22
W23: U$1.W23, W.23
WKUP: MISC.4, U$1.E23

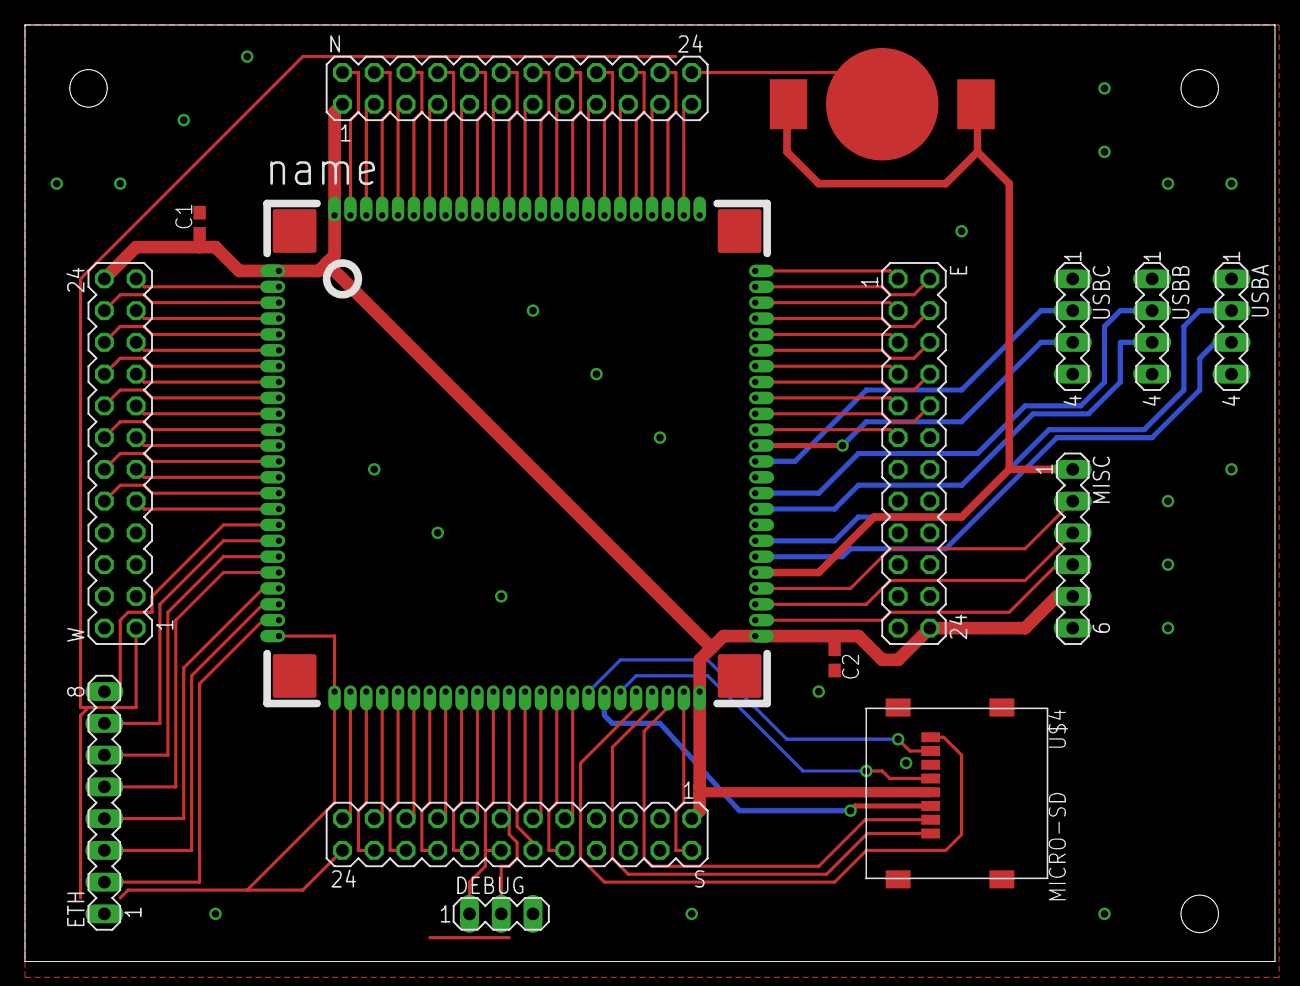
[picture p86: board aria-BOB.brd from above]

Board: 2 copper layers, 100.0 x 74.9 mm, 15 parts (0 on the bottom side), 88 nets.
