Octanis1/Octanis1-Electronics/pannelized v0_4/Untitled.brd

## EAGLE design pannelized v0_4/Untitled.brd (2015-05-29, an earlier design)

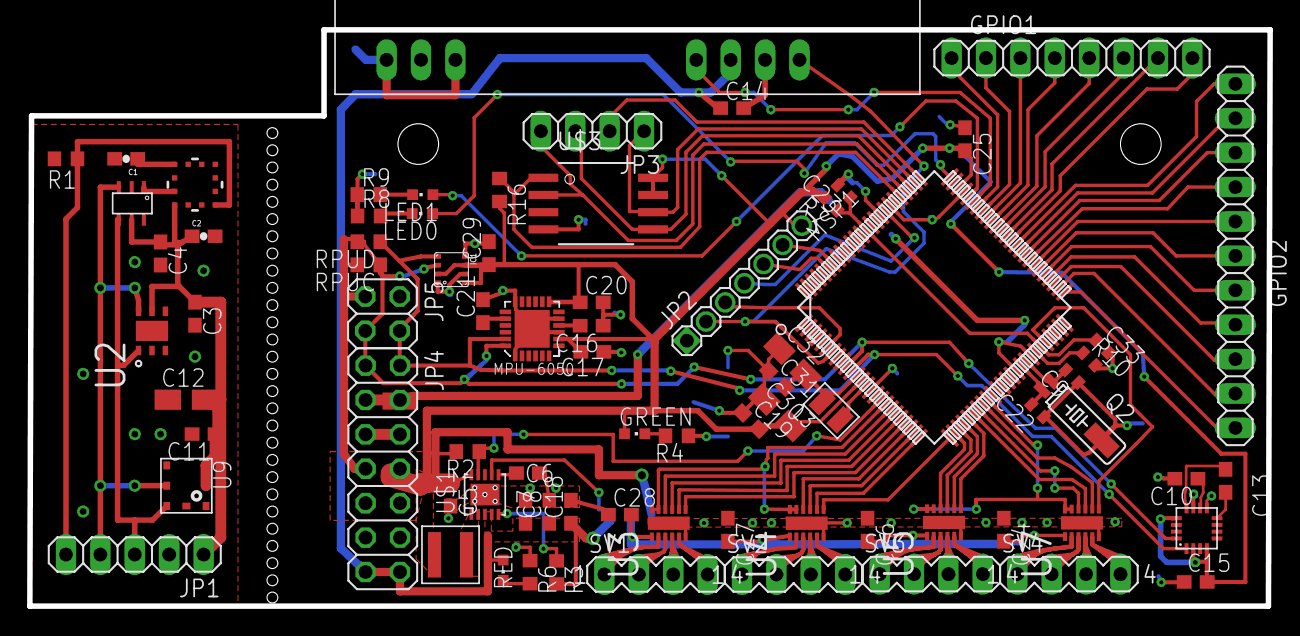
[picture p87: board Untitled.brd from above]

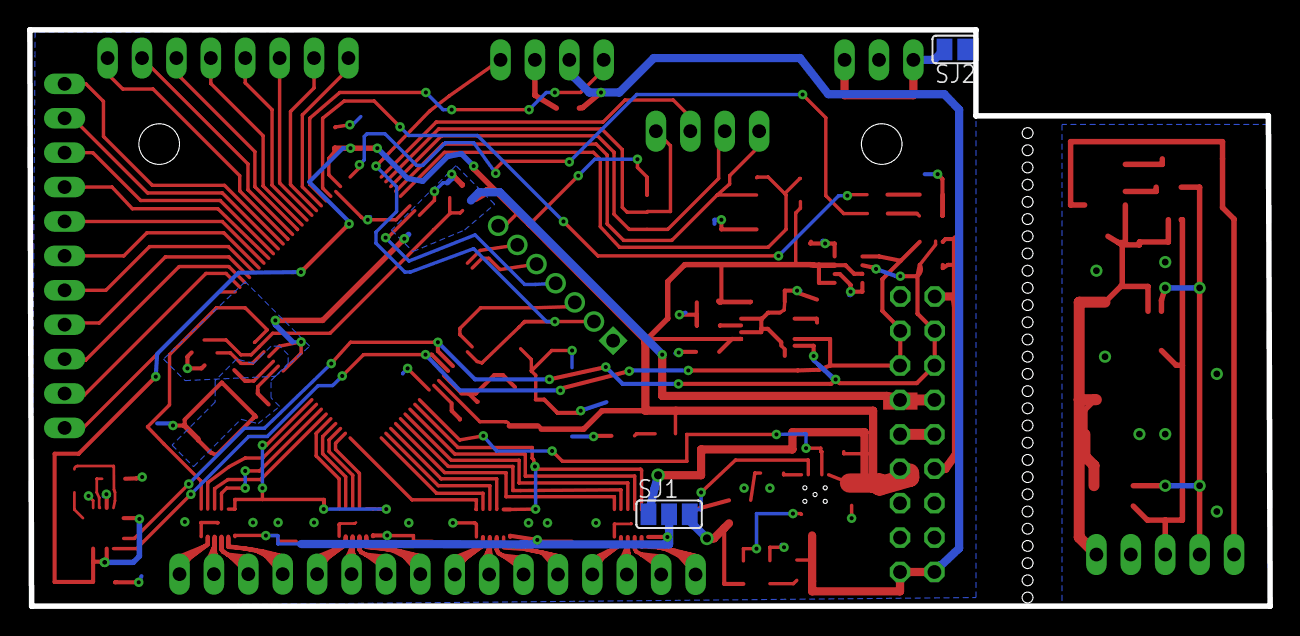
[picture p88: board Untitled.brd from below]

Board: 2 copper layers, 91.6 x 42.5 mm, 81 parts (2 on the bottom side), 100 nets.

Parts:
C1: 1nF; 0603-CAP
C2: 0.1uF; 0603-CAP
C3, C4, C11, C14, C15, C16, C19, C20, C25, C29, C31: 100n; C0603
C5, C7, C8: 22uF; C0603
C6: 10nF; C0603
C9, C22: 12p; C0402
C10: 4.7u; C0603
C12, C30, C32: 10u; A/3216-18R
C13: 220n; C0603
C17: 10n; C0603
C18: 3 x 22uF; C0603
C21: 2.2n; C0603
C23, C33: 100n; C0402
C24, C26, C27, C28: 470n; C0603
COMPASS: HMC5883L; LPCC16
GPIO1: A7:A0; 1X08
GPIO2: A18:A8; 1X11
GREEN: 3V-ok; CHIPLED_0603
IC1: BME280
JP1: 1X05
JP2: 1:07X2MM
JP3: SPI; 1X04
JP4: 2X07
JP5: 2X02
L1: 1uH; XFL4020
L3: 4.7uH; 0806
LED0: LED0; CHIPLED_0603
LED1: LED1; CHIPLED_0603
MPU-6050: MPU-6050; QFN24
MSP1: MSP432; PZ100
Q2: 32.768kHz; MS3V-T1R
R1, R16: 10k; R0603
R2, R3: 1M; R0603
R4, R6, R8, R9: 1k; R0603
R7: 0R; R0402
R10: 91k 0.1% ±25 ppm/°C; R0402
RED: 5V-ok; CHIPLED_0603
RPUC: 10k; R0603
RPUD: 10k; R0603
SJ1: 3V3 V_Motor 5V; SJ_2
SJ2: SJ
SV1, SV2, SV3, SV4: MA04-1
U1: ML8511-UV-SENSOR; ML8511
U2: SHT21; DFN300X300X110-7N
U3, U4, U5, U7: DRV8836DSSR; SON50P200X300X80-13N
U9: BMP180
U$1: TPS61232; S-PVSON-N10
U$2: STARGND; STAR
U$3: SST25VF064C; SOIC_8-LEAD
U$4: HX1
U$5: MCP3425; SOT-23-6

Connections:
5VEN: MSP1.17, R2.1, U$1.9
+3V1: C5.1, C15.2, C17.2, C19.2, C20.1, C25.2, C29.1, C30.+, COMPASS.2, COMPASS.4, COMPASS.13, GREEN.A, IC1.2, IC1.6, IC1.8, JP2.7, JP4.7, JP4.8, JP4.9, JP4.10, JP5.1, L1.P$1, MPU-6050.8, MPU-6050.13, MSP1.13, MSP1.73, R2.2, R7.2, R16.2, RPUC.2, RPUD.2, SJ1.1, U$1.10, U$3.RST/HOLD, U$3.VDD
+3V3: C2.1, C3.1, C4.1, C11.1, C12.+, JP1.1, U1.7, U2.5, U9.2, U9.3, U$5.VDD
+5V: C7.1, C8.1, C14.1, C18.1, JP4.13, JP4.14, R3.2, RED.A, SJ1.3, U$1.3, U$1.4, U$1.7, U$4.VCC
A14: GPIO2.7, MSP1.55
A15: GPIO2.8, MSP1.54
A16: GPIO2.9, MSP1.53
A17: GPIO2.10, MSP1.52
A18: GPIO2.11, MSP1.51
AGND: C23.2, C33.2, MSP1.40, MSP1.43, MSP1.84, R10.2, U$2.AGND
AVCC1: C23.1, C33.1, MSP1.45, MSP1.87, R7.1
GND: C1.2, C2.2, C3.2, C4.2, C11.2, C12.-, JP1.2, R1.2, U1.5, U2.2, U9.7, U$5.VIN-, U$5.VSS
GND1: C5.2, C6.2, C7.2, C8.2, C9.1, C10.2, C14.2, C15.1, C16.1, C17.1, C18.2, C19.1, C20.2, C21.2, C22.1, C24.1, C25.1, C26.1, C27.1, C28.1, C29.2, C30.-, C31.1, C32.-, COMPASS.9, COMPASS.11, IC1.1, IC1.5, IC1.7, JP2.1, JP4.3, JP4.4, JP4.5, JP4.6, JP4.11, JP4.12, JP5.2, MPU-6050.1, MPU-6050.9, MPU-6050.11, MPU-6050.18, MPU-6050.P, MSP1.15, MSP1.72, MSP1.82, Q2.P3, R4.1, R6.1, R8.1, R9.1, SJ2.1, U3.6, U3.13, U4.6, U4.13, U5.6, U5.13, U7.6, U7.13, U$1.EXPAD, U$2.DGND, U$2.GND, U$3.VSS, U$4.0V
HX1_EN: MSP1.70, U$4.EN
IND: L1.P$2, U$1.1, U$1.2
LED0: LED0.A, MSP1.75
LED1: LED1.A, MSP1.71
M1IN1: MSP1.19, U3.10
M1IN2: MSP1.20, U3.9
M2IN1: MSP1.21, U3.8
M2IN2: MSP1.22, U3.7
M3IN1: MSP1.23, U4.10
M3IN2: MSP1.24, U4.9
M4IN1: MSP1.25, U4.8
M4IN2: MSP1.26, U4.7
M5IN1: MSP1.27, U5.10
M5IN2: MSP1.28, U5.9
M6IN1: MSP1.29, U5.8
M6IN2: MSP1.30, U5.7
M7IN1: MSP1.32, U7.10
M7IN2: MSP1.31, U7.9
M8IN1: MSP1.33, U7.8
M8IN2: MSP1.46, U7.7
M1234SLEEP: MSP1.18, U3.11, U3.12, U4.11, U4.12
M5678SLEEP: MSP1.34, U5.11, U5.12, U7.11, U7.12
unnamed: U1.8, U$5.VIN+
unnamed: R3.1, U$1.5
unnamed: C1.1, U1.10
unnamed: GREEN.C, R4.2
unnamed: LED0.C, R8.2
unnamed: LED1.C, R9.2
unnamed: C31.2, C32.+, L3.1, MSP1.12
unnamed: C22.2, MSP1.41, Q2.P2
unnamed: C9.2, MSP1.42, Q2.P1
unnamed: SV2.1, U4.2
unnamed: GPIO2.1, MSP1.61
unnamed: GPIO2.2, MSP1.60
unnamed: C10.1, COMPASS.10
unnamed: C16.2, MPU-6050.10
unnamed: C21.1, MPU-6050.20
unnamed: GPIO2.3, MSP1.59
unnamed: GPIO2.4, MSP1.58
unnamed: GPIO2.5, MSP1.57
unnamed: GPIO2.6, MSP1.56
unnamed: C13.2, COMPASS.8
unnamed: GPIO1.1, MSP1.69
unnamed: GPIO1.2, MSP1.68
unnamed: GPIO1.3, MSP1.67
unnamed: C13.1, COMPASS.12
unnamed: MSP1.44, R10.1
unnamed: L3.2, MSP1.14
unnamed: GPIO1.4, MSP1.66
unnamed: GPIO1.5, MSP1.65
unnamed: GPIO1.6, MSP1.64
unnamed: GPIO1.8, MSP1.62
unnamed: SV2.2, U4.3
unnamed: SV2.3, U4.4
unnamed: SV2.4, U4.5
unnamed: C6.1, U$1.6
unnamed: GPIO1.7, MSP1.63
unnamed: R6.2, RED.C
unnamed: SV3.1, U5.2
unnamed: SV3.2, U5.3
unnamed: SV3.3, U5.4
unnamed: SV3.4, U5.5
unnamed: SV1.1, U3.2
unnamed: SV1.2, U3.3
unnamed: SV1.3, U3.4
unnamed: SV1.4, U3.5
unnamed: SV4.1, U7.2
unnamed: SV4.2, U7.3
unnamed: SV4.3, U7.4
unnamed: SV4.4, U7.5
unnamed: JP2.4, MSP1.83
unnamed: JP2.6, MSP1.94
unnamed: JP2.5, MSP1.95
RFGND: SJ2.2, U$4.RFGND, U$4.RFGND2
RX: JP2.2, MSP1.6
SCL: JP1.4, U2.6, U9.5, U$5.SCL
SCL1: COMPASS.1, IC1.4, JP4.2, JP5.4, MPU-6050.23, MSP1.11, RPUD.1
SDA: JP1.3, U2.1, U9.6, U$5.SDA
SDA1: COMPASS.16, IC1.3, JP4.1, JP5.3, MPU-6050.24, MSP1.10, RPUC.1
SPI_EXTSLAVE_TE: JP3.2, MSP1.76
SPI_FLASH_CS: MSP1.80, R16.1, U$3.CE
SPI_MISO: JP3.4, MSP1.79, U$3.SO
SPI_MOSI: JP3.3, MSP1.78, U$3.SI
SPI_SCK: JP3.1, MSP1.77, U$3.SCK
TX: JP2.3, MSP1.7, U$4.TXD
UV_EN: JP1.5, R1.1, U1.4
V_MOTOR: C24.2, C26.2, C27.2, C28.2, SJ1.2, U3.1, U4.1, U5.1, U7.1
