Octanis1/Octanis1-Electronics/MSP-EXP432P401R Hardware Design Files/Hardware/MSP-EXP432P401R.brd

## EAGLE design MSP-EXP432P401R Hardware Design Files/Hardware/MSP-EXP432P401R.brd (2015-04-08)

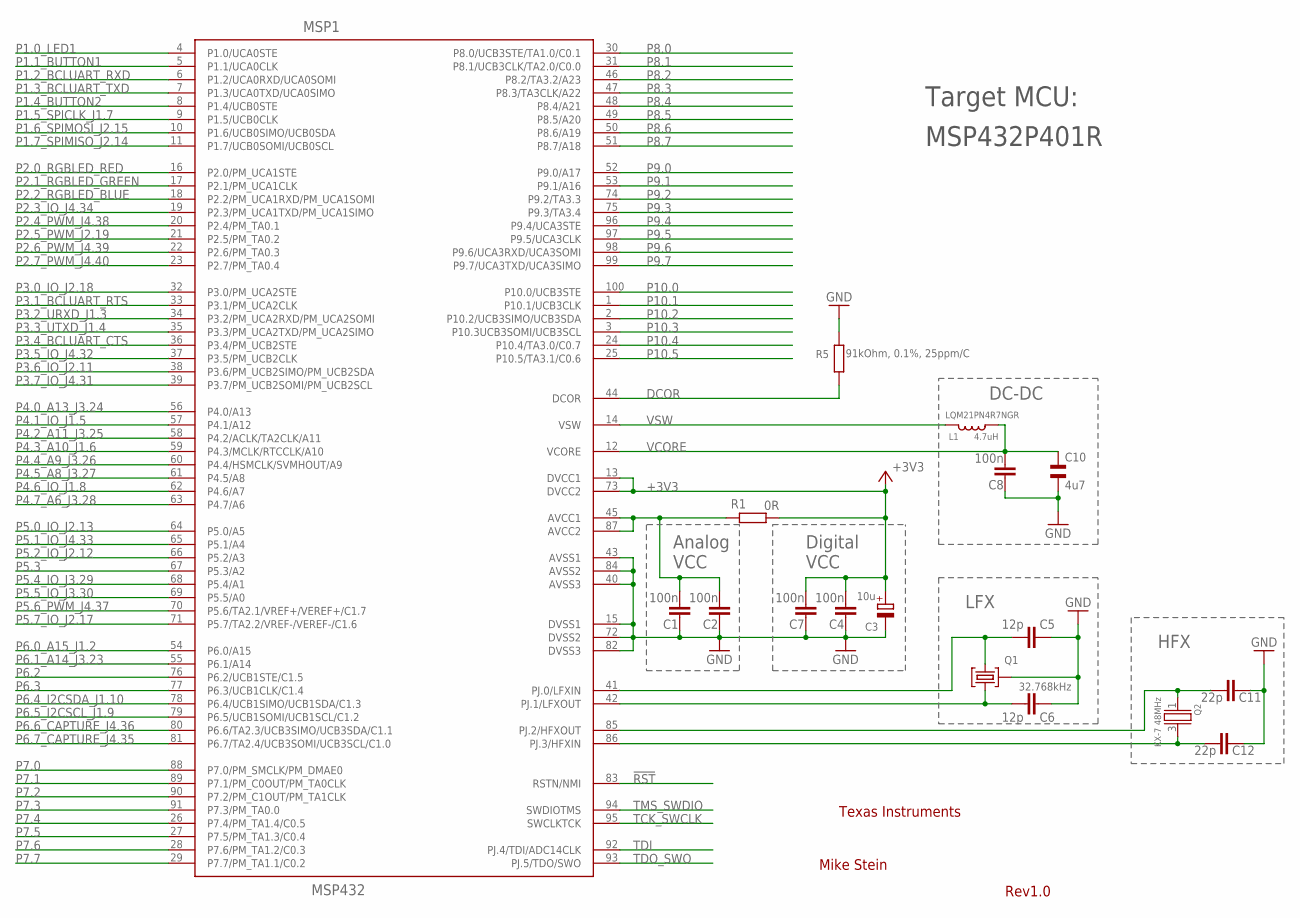
[picture p89: schematic MSP-EXP432P401R.sch, sheet 1]

Parts:
C1, C2, C4, C7, C8: 100n; 0402
C3: 10u; A/3216-18R
C5, C6: 12p; 0402
C10: 4u7; CSMD0805
C11, C12: 22p; 0402
L1: 4.7uH; 0806
MSP1: MSP432; PZ100
Q1: 32.768kHz; MS3V-T1R
Q2: KX-7 48MHz; KX-7
R1: 0R; 0402
R5: 91kOhm, 0.1%, 25ppm/C; 0805

Connections:
!RST: MSP1.83 (RSTN/NMI); also elsewhere on the board
+3V3: C3.+, C4.1, C7.1, MSP1.13 (DVCC1), MSP1.73 (DVCC2), R1.1; also elsewhere on the board
DCOR: MSP1.44 (DCOR), R5.1
GND: C1.2, C2.2, C3.-, C4.2, C5.2, C6.2, C7.2, C8.2, C10.2, C11.2, C12.2, MSP1.15 (DVSS1), MSP1.40 (AVSS3), MSP1.43 (AVSS1), MSP1.72 (DVSS2), MSP1.82 (DVSS3), MSP1.84 (AVSS2), Q1.P3 (GND), R5.2; also elsewhere on the board
unnamed: C1.1, C2.1, MSP1.45 (AVCC1), MSP1.87 (AVCC2), R1.2
unnamed: C6.1, MSP1.42 (PJ.1/LFXOUT), Q1.P1 (1)
unnamed: C5.1, MSP1.41 (PJ.0/LFXIN), Q1.P2 (2)
P1.0_LED1: MSP1.4 (P1.0/UCA0STE); also elsewhere on the board
P1.1_BUTTON1: MSP1.5 (P1.1/UCA0CLK); also elsewhere on the board
P1.2_BCLUART_RXD: MSP1.6 (P1.2/UCA0RXD/UCA0SOMI); also elsewhere on the board
P1.3_BCLUART_TXD: MSP1.7 (P1.3/UCA0TXD/UCA0SIMO); also elsewhere on the board
P1.4_BUTTON2: MSP1.8 (P1.4/UCB0STE); also elsewhere on the board
P1.5_SPICLK_J1.7: MSP1.9 (P1.5/UCB0CLK); also elsewhere on the board
P1.6_SPIMOSI_J2.15: MSP1.10 (P1.6/UCB0SIMO/UCB0SDA); also elsewhere on the board
P1.7_SPIMISO_J2.14: MSP1.11 (P1.7/UCB0SOMI/UCB0SCL); also elsewhere on the board
P2.0_RGBLED_RED: MSP1.16 (P2.0/PM_UCA1STE); also elsewhere on the board
P2.1_RGBLED_GREEN: MSP1.17 (P2.1/PM_UCA1CLK); also elsewhere on the board
P2.2_RGBLED_BLUE: MSP1.18 (P2.2/PM_UCA1RXD/PM_UCA1SOMI); also elsewhere on the board
P2.3_IO_J4.34: MSP1.19 (P2.3/PM_UCA1TXD/PM_UCA1SIMO); also elsewhere on the board
P2.4_PWM_J4.38: MSP1.20 (P2.4/PM_TA0.1); also elsewhere on the board
P2.5_PWM_J2.19: MSP1.21 (P2.5/PM_TA0.2); also elsewhere on the board
P2.6_PWM_J4.39: MSP1.22 (P2.6/PM_TA0.3); also elsewhere on the board
P2.7_PWM_J4.40: MSP1.23 (P2.7/PM_TA0.4); also elsewhere on the board
P3.0_IO_J2.18: MSP1.32 (P3.0/PM_UCA2STE); also elsewhere on the board
P3.1_BCLUART_RTS: MSP1.33 (P3.1/PM_UCA2CLK); also elsewhere on the board
P3.2_URXD_J1.3: MSP1.34 (P3.2/PM_UCA2RXD/PM_UCA2SOMI); also elsewhere on the board
P3.3_UTXD_J1.4: MSP1.35 (P3.3/PM_UCA2TXD/PM_UCA2SIMO); also elsewhere on the board
P3.4_BCLUART_CTS: MSP1.36 (P3.4/PM_UCB2STE); also elsewhere on the board
P3.5_IO_J4.32: MSP1.37 (P3.5/PM_UCB2CLK); also elsewhere on the board
P3.6_IO_J2.11: MSP1.38 (P3.6/PM_UCB2SIMO/PM_UCB2SDA); also elsewhere on the board
P3.7_IO_J4.31: MSP1.39 (P3.7/PM_UCB2SOMI/PM_UCB2SCL); also elsewhere on the board
P4.0_A13_J3.24: MSP1.56 (P4.0/A13); also elsewhere on the board
P4.1_IO_J1.5: MSP1.57 (P4.1/A12); also elsewhere on the board
P4.2_A11_J3.25: MSP1.58 (P4.2/ACLK/TA2CLK/A11); also elsewhere on the board
P4.3_A10_J1.6: MSP1.59 (P4.3/MCLK/RTCCLK/A10); also elsewhere on the board
P4.4_A9_J3.26: MSP1.60 (P4.4/HSMCLK/SVMHOUT/A9); also elsewhere on the board
P4.5_A8_J3.27: MSP1.61 (P4.5/A8); also elsewhere on the board
P4.6_IO_J1.8: MSP1.62 (P4.6/A7); also elsewhere on the board
P4.7_A6_J3.28: MSP1.63 (P4.7/A6); also elsewhere on the board
P5.0_IO_J2.13: MSP1.64 (P5.0/A5); also elsewhere on the board
P5.1_IO_J4.33: MSP1.65 (P5.1/A4); also elsewhere on the board
P5.2/XT2IN: C12.1, MSP1.86 (PJ.3/HFXIN), Q2.3 (2)
P5.2_IO_J2.12: MSP1.66 (P5.2/A3); also elsewhere on the board
P5.3: MSP1.67 (P5.3/A2); also elsewhere on the board
P5.3/XT2OUT: C11.1, MSP1.85 (PJ.2/HFXOUT), Q2.1
P5.4_IO_J3.29: MSP1.68 (P5.4/A1); also elsewhere on the board
P5.5_IO_J3.30: MSP1.69 (P5.5/A0); also elsewhere on the board
P5.6_PWM_J4.37: MSP1.70 (P5.6/TA2.1/VREF+/VEREF+/C1.7); also elsewhere on the board
P5.7_IO_J2.17: MSP1.71 (P5.7/TA2.2/VREF-/VEREF-/C1.6); also elsewhere on the board
P6.0_A15_J1.2: MSP1.54 (P6.0/A15); also elsewhere on the board
P6.1_A14_J3.23: MSP1.55 (P6.1/A14); also elsewhere on the board
P6.2: MSP1.76 (P6.2/UCB1STE/C1.5); also elsewhere on the board
P6.3: MSP1.77 (P6.3/UCB1CLK/C1.4); also elsewhere on the board
P6.4_I2CSDA_J1.10: MSP1.78 (P6.4/UCB1SIMO/UCB1SDA/C1.3); also elsewhere on the board
P6.5_I2CSCL_J1.9: MSP1.79 (P6.5/UCB1SOMI/UCB1SCL/C1.2); also elsewhere on the board
P6.6_CAPTURE_J4.36: MSP1.80 (P6.6/TA2.3/UCB3SIMO/UCB3SDA/C1.1); also elsewhere on the board
P6.7_CAPTURE_J4.35: MSP1.81 (P6.7/TA2.4/UCB3SOMI/UCB3SCL/C1.0); also elsewhere on the board
P7.0: MSP1.88 (P7.0/PM_SMCLK/PM_DMAE0); also elsewhere on the board
P7.1: MSP1.89 (P7.1/PM_C0OUT/PM_TA0CLK); also elsewhere on the board
P7.2: MSP1.90 (P7.2/PM_C1OUT/PM_TA1CLK); also elsewhere on the board
P7.3: MSP1.91 (P7.3/PM_TA0.0); also elsewhere on the board
P7.4: MSP1.26 (P7.4/PM_TA1.4/C0.5); also elsewhere on the board
P7.5: MSP1.27 (P7.5/PM_TA1.3/C0.4); also elsewhere on the board
P7.6: MSP1.28 (P7.6/PM_TA1.2/C0.3); also elsewhere on the board
P7.7: MSP1.29 (P7.7/PM_TA1.1/C0.2); also elsewhere on the board
P8.0: MSP1.30 (P8.0/UCB3STE/TA1.0/C0.1); also elsewhere on the board
P8.1: MSP1.31 (P8.1/UCB3CLK/TA2.0/C0.0)
P8.2: MSP1.46 (P8.2/TA3.2/A23); also elsewhere on the board
P8.3: MSP1.47 (P8.3/TA3CLK/A22); also elsewhere on the board
P8.4: MSP1.48 (P8.4/A21); also elsewhere on the board
P8.5: MSP1.49 (P8.5/A20); also elsewhere on the board
P8.6: MSP1.50 (P8.6/A19); also elsewhere on the board
P8.7: MSP1.51 (P8.7/A18); also elsewhere on the board
P9.0: MSP1.52 (P9.0/A17); also elsewhere on the board
P9.1: MSP1.53 (P9.1/A16); also elsewhere on the board
P9.2: MSP1.74 (P9.2/TA3.3); also elsewhere on the board
P9.3: MSP1.75 (P9.3/TA3.4); also elsewhere on the board
P9.4: MSP1.96 (P9.4/UCA3STE); also elsewhere on the board
P9.5: MSP1.97 (P9.5/UCA3CLK); also elsewhere on the board
P9.6: MSP1.98 (P9.6/UCA3RXD/UCA3SOMI); also elsewhere on the board
P9.7: MSP1.99 (P9.7/UCA3TXD/UCA3SIMO); also elsewhere on the board
P10.0: MSP1.100 (P10.0/UCB3STE); also elsewhere on the board
P10.1: MSP1.1 (P10.1/UCB3CLK); also elsewhere on the board
P10.2: MSP1.2 (P10.2/UCB3SIMO/UCB3SDA); also elsewhere on the board
P10.3: MSP1.3 (P10.3UCB3SOMI/UCB3SCL); also elsewhere on the board
P10.4: MSP1.24 (P10.4/TA3.0/C0.7); also elsewhere on the board
P10.5: MSP1.25 (P10.5/TA3.1/C0.6); also elsewhere on the board
TCK_SWCLK: MSP1.95 (SWCLKTCK); also elsewhere on the board
TDI: MSP1.92 (PJ.4/TDI/ADC14CLK); also elsewhere on the board
TDO_SWO: MSP1.93 (PJ.5/TDO/SWO); also elsewhere on the board
TMS_SWDIO: MSP1.94 (SWDIOTMS); also elsewhere on the board
VCORE: C8.1, C10.1, L1.1, MSP1.12 (VCORE)
VSW: L1.2, MSP1.14 (VSW)

Notes on the sheet:
Target MCU:
Texas Instruments
Mike Stein
Rev1.0
LQM21PN4R7NGR
HFX
LFX
Analog
VCC
Digital
DC-DC
MSP432P401R

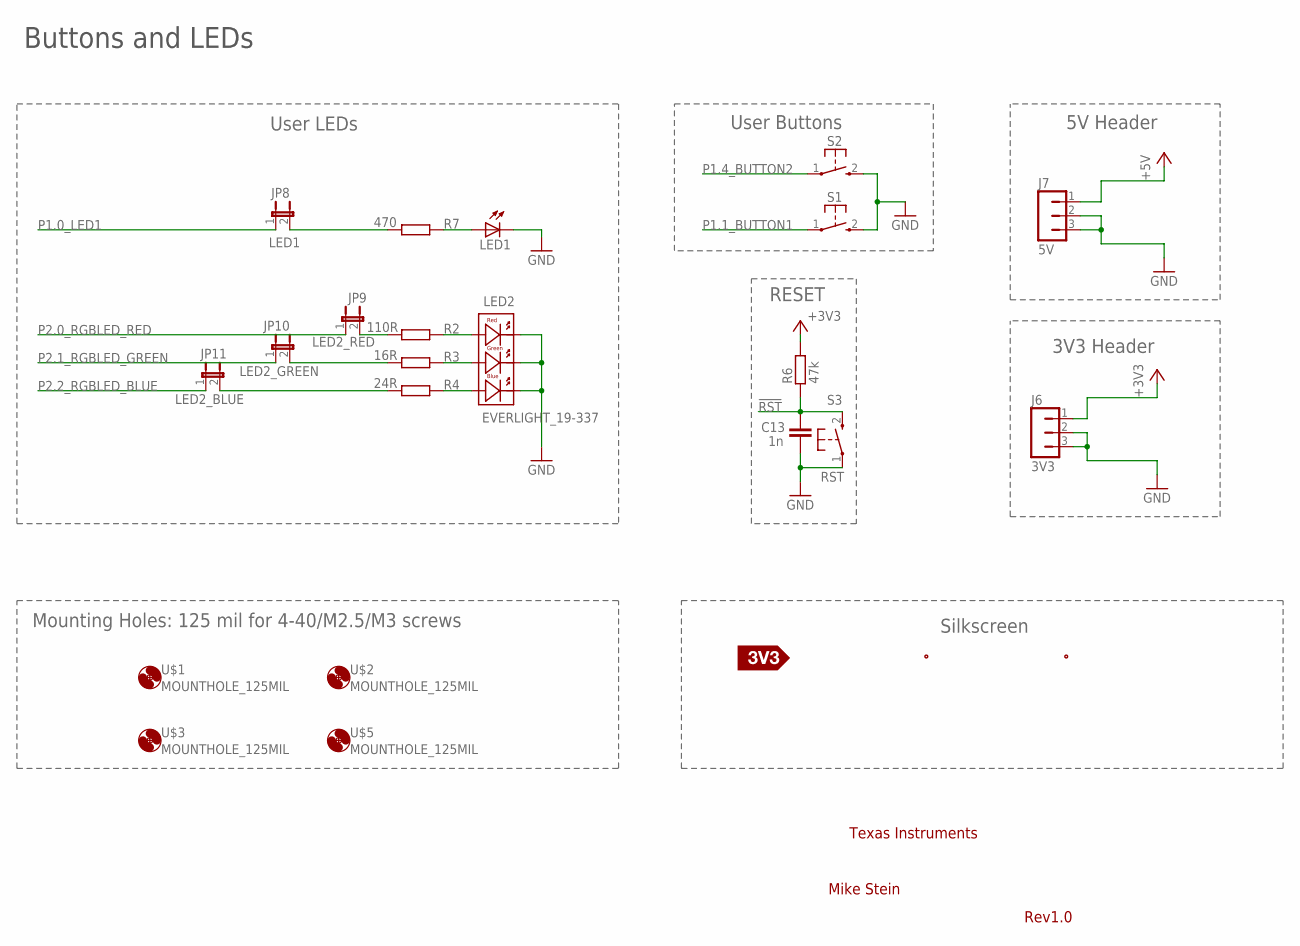
[picture p90: schematic MSP-EXP432P401R.sch, sheet 2]

Parts:
C13: 1n; 0402
J6: 3V3; JP3
J7: 5V; JP3
JP8: LED1; JP1M
JP9: LED2_RED; JP1M
JP10: LED2_GREEN; JP1M
JP11: LED2_BLUE; JP1M
LED1: LEDCHIPLED_0603; CHIPLED_0603
LED2: EVERLIGHT_19-337; RGB_LED
R2: 110R; 0402
R3: 16R; 0402
R4: 24R; 0402
R6: 47k; 0402
R7: 470; 0402
S1, S2: PB; PBTH
S3: RST; PBTH
U$1, U$2, U$3, U$5: MOUNTHOLE_125MIL
U$6: SILK_HEADER_LABEL
U$7: SILK_3V3_TAG
U$8: SILK_P401R_REAR

Connections:
!RST: C13.1, R6.1, S3.2 (S); also elsewhere on the board
+3V3: J6.1, R6.2; also elsewhere on the board
+5V: J7.1; also elsewhere on the board
GND: C13.2, J6.2, J6.3, J7.2, J7.3, LED1.C, LED2.1 (BC), LED2.2 (RC), LED2.3 (GC), S1.2 (S), S2.2 (S), S3.1; also elsewhere on the board
unnamed: JP9.2, R2.1
unnamed: LED2.5 (RA), R2.2
unnamed: LED2.6 (GA), R3.2
unnamed: LED2.4 (BA), R4.2
unnamed: LED1.A, R7.2
unnamed: JP10.2, R3.1
unnamed: JP11.2, R4.1
unnamed: JP8.2, R7.1
P1.0_LED1: JP8.1; also elsewhere on the board
P1.1_BUTTON1: S1.1; also elsewhere on the board
P1.4_BUTTON2: S2.1; also elsewhere on the board
P2.0_RGBLED_RED: JP9.1; also elsewhere on the board
P2.1_RGBLED_GREEN: JP10.1; also elsewhere on the board
P2.2_RGBLED_BLUE: JP11.1; also elsewhere on the board

Notes on the sheet:
User LEDs
User Buttons
RESET
Buttons and LEDs
5V Header
3V3 Header
Mounting Holes: 125 mil for 4-40/M2.5/M3 screws
Silkscreen
Texas Instruments
Mike Stein
Rev1.0

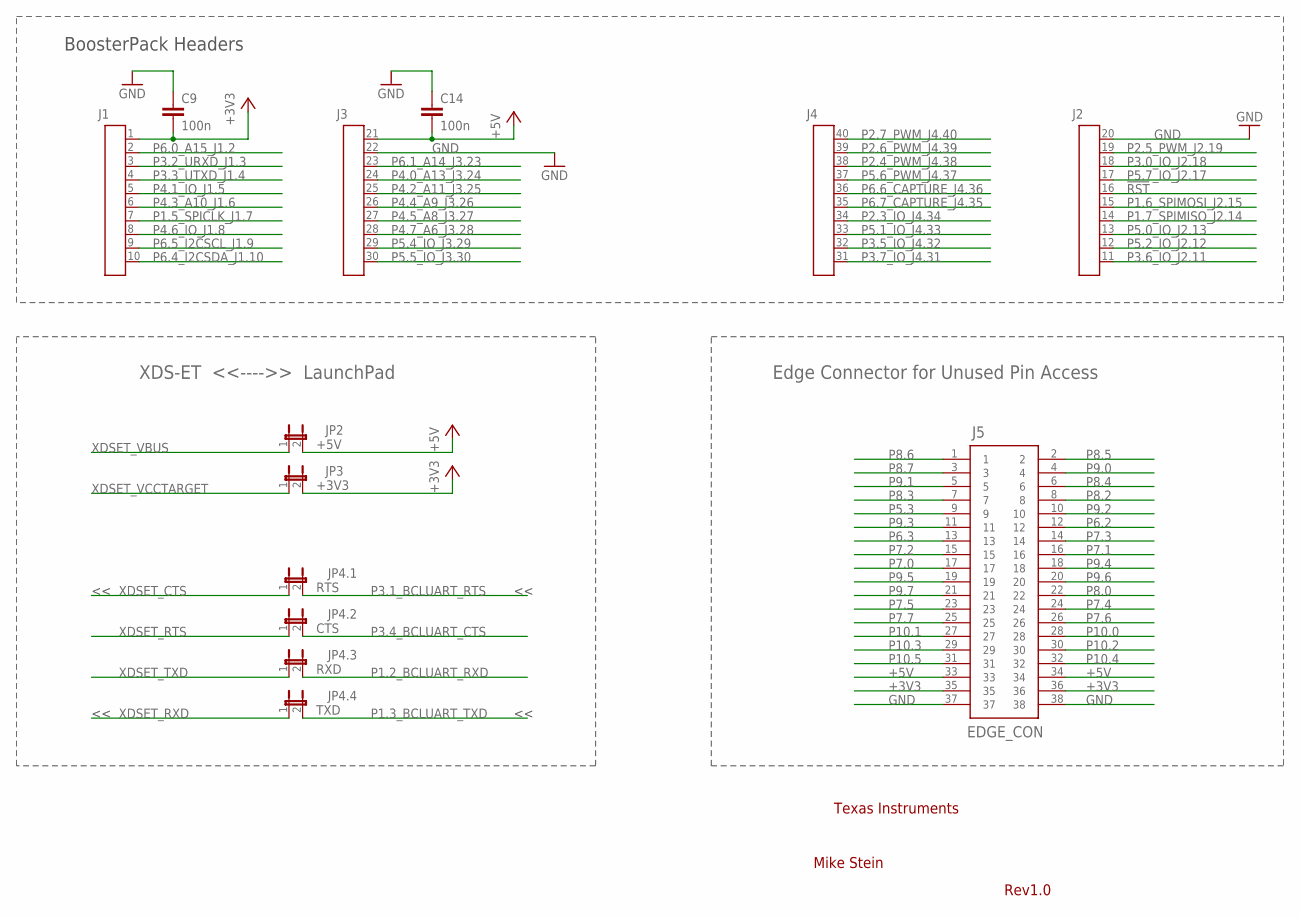
[picture p91: schematic MSP-EXP432P401R.sch, sheet 3]

Parts:
C9, C14: 100n; 0402
J1: HEADER1X10; 1X10
J2: HEADER1X10-J2; 1X10-J2
J3: HEADER1X10-J3; 1X10-J3
J4: HEADER1X10-J4; 1X10-J4
J5: EDGE_CON; BOTTOM_CONNECTOR
JP2: +5V; JP1M
JP3: +3V3; JP1M
JP4.1: RTS; JP1M
JP4.2: CTS; JP1M
JP4.3: RXD; JP1M
JP4.4: TXD; JP1M

Connections:
!RST: J2.16 (5); also elsewhere on the board
+3V3: C9.2, J1.1, J5.35, J5.36, JP3.2; also elsewhere on the board
+5V: C14.2, J3.21 (1), J5.33, J5.34, JP2.2; also elsewhere on the board
GND: C9.1, C14.1, J2.20 (1), J3.22 (2), J5.37, J5.38; also elsewhere on the board
P1.2_BCLUART_RXD: JP4.3.2; also elsewhere on the board
P1.3_BCLUART_TXD: JP4.4.2; also elsewhere on the board
P1.5_SPICLK_J1.7: J1.7; also elsewhere on the board
P1.6_SPIMOSI_J2.15: J2.15 (6); also elsewhere on the board
P1.7_SPIMISO_J2.14: J2.14 (7); also elsewhere on the board
P2.3_IO_J4.34: J4.34 (7); also elsewhere on the board
P2.4_PWM_J4.38: J4.38 (3); also elsewhere on the board
P2.5_PWM_J2.19: J2.19 (2); also elsewhere on the board
P2.6_PWM_J4.39: J4.39 (2); also elsewhere on the board
P2.7_PWM_J4.40: J4.40 (1); also elsewhere on the board
P3.0_IO_J2.18: J2.18 (3); also elsewhere on the board
P3.1_BCLUART_RTS: JP4.1.2; also elsewhere on the board
P3.2_URXD_J1.3: J1.3; also elsewhere on the board
P3.3_UTXD_J1.4: J1.4; also elsewhere on the board
P3.4_BCLUART_CTS: JP4.2.2; also elsewhere on the board
P3.5_IO_J4.32: J4.32 (9); also elsewhere on the board
P3.6_IO_J2.11: J2.11 (10); also elsewhere on the board
P3.7_IO_J4.31: J4.31 (10); also elsewhere on the board
P4.0_A13_J3.24: J3.24 (4); also elsewhere on the board
P4.1_IO_J1.5: J1.5; also elsewhere on the board
P4.2_A11_J3.25: J3.25 (5); also elsewhere on the board
P4.3_A10_J1.6: J1.6; also elsewhere on the board
P4.4_A9_J3.26: J3.26 (6); also elsewhere on the board
P4.5_A8_J3.27: J3.27 (7); also elsewhere on the board
P4.6_IO_J1.8: J1.8; also elsewhere on the board
P4.7_A6_J3.28: J3.28 (8); also elsewhere on the board
P5.0_IO_J2.13: J2.13 (8); also elsewhere on the board
P5.1_IO_J4.33: J4.33 (8); also elsewhere on the board
P5.2_IO_J2.12: J2.12 (9); also elsewhere on the board
P5.3: J5.9; also elsewhere on the board
P5.4_IO_J3.29: J3.29 (9); also elsewhere on the board
P5.5_IO_J3.30: J3.30 (10); also elsewhere on the board
P5.6_PWM_J4.37: J4.37 (4); also elsewhere on the board
P5.7_IO_J2.17: J2.17 (4); also elsewhere on the board
P6.0_A15_J1.2: J1.2; also elsewhere on the board
P6.1_A14_J3.23: J3.23 (3); also elsewhere on the board
P6.2: J5.12; also elsewhere on the board
P6.3: J5.13; also elsewhere on the board
P6.4_I2CSDA_J1.10: J1.10; also elsewhere on the board
P6.5_I2CSCL_J1.9: J1.9; also elsewhere on the board
P6.6_CAPTURE_J4.36: J4.36 (5); also elsewhere on the board
P6.7_CAPTURE_J4.35: J4.35 (6); also elsewhere on the board
P7.0: J5.17; also elsewhere on the board
P7.1: J5.16; also elsewhere on the board
P7.2: J5.15; also elsewhere on the board
P7.3: J5.14; also elsewhere on the board
P7.4: J5.24; also elsewhere on the board
P7.5: J5.23; also elsewhere on the board
P7.6: J5.26; also elsewhere on the board
P7.7: J5.25; also elsewhere on the board
P8.0: J5.22; also elsewhere on the board
P8.2: J5.8; also elsewhere on the board
P8.3: J5.7; also elsewhere on the board
P8.4: J5.6; also elsewhere on the board
P8.5: J5.2; also elsewhere on the board
P8.6: J5.1; also elsewhere on the board
P8.7: J5.3; also elsewhere on the board
P9.0: J5.4; also elsewhere on the board
P9.1: J5.5; also elsewhere on the board
P9.2: J5.10; also elsewhere on the board
P9.3: J5.11; also elsewhere on the board
P9.4: J5.18; also elsewhere on the board
P9.5: J5.19; also elsewhere on the board
P9.6: J5.20; also elsewhere on the board
P9.7: J5.21; also elsewhere on the board
P10.0: J5.28; also elsewhere on the board
P10.1: J5.27; also elsewhere on the board
P10.2: J5.30; also elsewhere on the board
P10.3: J5.29; also elsewhere on the board
P10.4: J5.32; also elsewhere on the board
P10.5: J5.31; also elsewhere on the board
XDSET_CTS: JP4.1.1; also elsewhere on the board
XDSET_RTS: JP4.2.1; also elsewhere on the board
XDSET_RXD: JP4.4.1; also elsewhere on the board
XDSET_TXD: JP4.3.1; also elsewhere on the board
XDSET_VBUS: JP2.1; also elsewhere on the board
XDSET_VCCTARGET: JP3.1; also elsewhere on the board

Notes on the sheet:
BoosterPack Headers
XDS-ET <<---->> LaunchPad
Edge Connector for Unused Pin Access
Texas Instruments
Mike Stein
Rev1.0

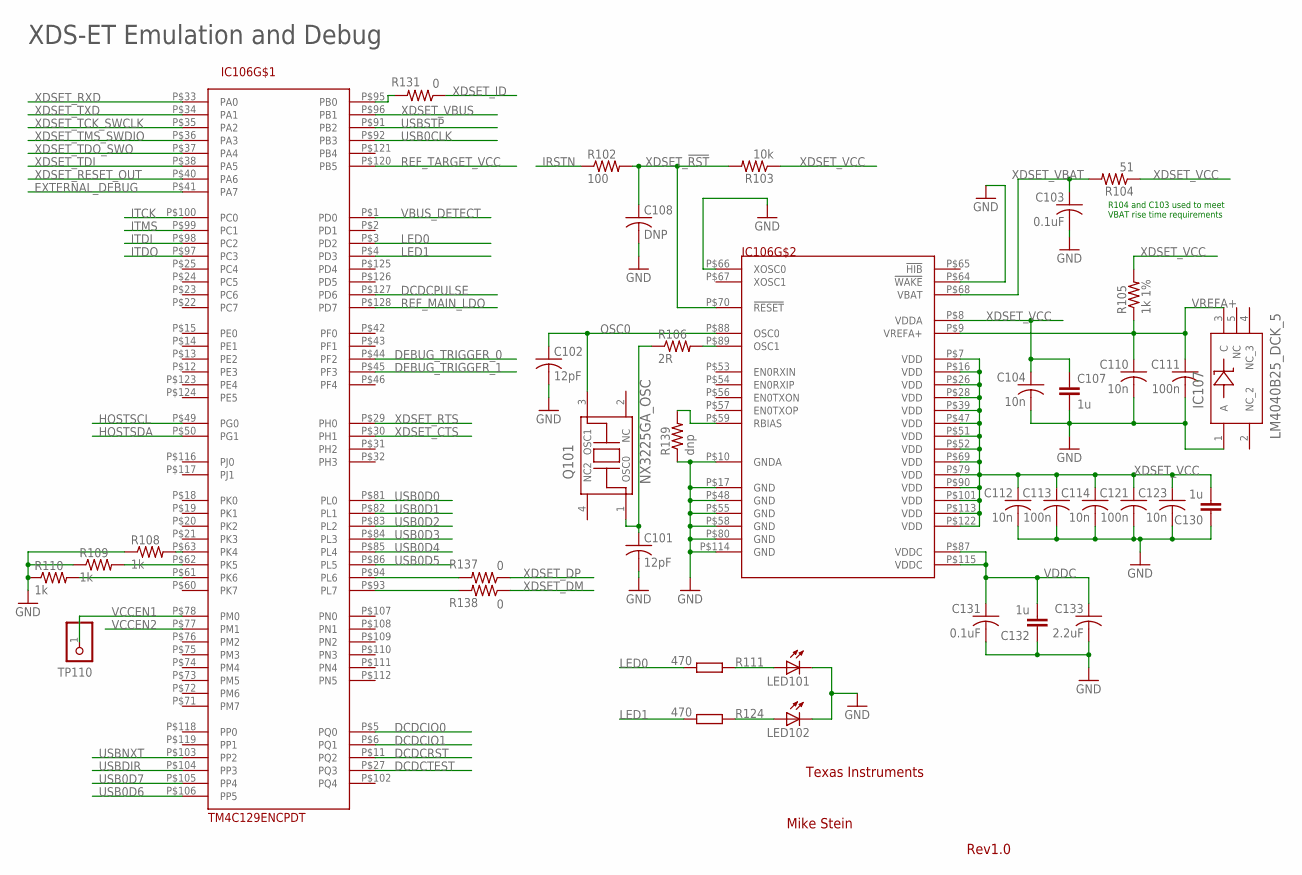
[picture p92: schematic MSP-EXP432P401R.sch, sheet 4]

Parts:
C101, C102: 12pF; C0402
C103, C131: 0.1uF; C0402
C104, C110, C112, C114, C123: 10n; C0402
C107, C130, C132: 1u; C0603
C108: DNP; C0402
C111, C113, C121: 100n; C0402
C133: 2.2uF; C0603K; DIGIKEY_PARTNUM 311-1451-2-ND
IC106: TM4C129ENCPDT; TQFP-128
IC107: LM4040B25_DCK_5; DCK5
LED101, LED102: LEDCHIPLED_0603; CHIPLED_0603
Q101: NX3225GA_OSC; NX3225GA
R102: 100; R0402
R103: 10k; R0402
R104: 51; R0402
R105: 1k 1%; R0402
R106: 2R; R0402
R108, R109, R110: 1k; R0402
R111, R124: 470; 0402
R131, R137, R138: 0; R0402
R139: dnp; R0402
TP110: TEST_PIN2; 1X01

Connections:
DCDCIO0: IC106.P$5 (PQ0); also elsewhere on the board
DCDCIO1: IC106.P$6 (PQ1); also elsewhere on the board
DCDCPULSE: IC106.P$127 (PD6); also elsewhere on the board
DCDCRST: IC106.P$11 (PQ2); also elsewhere on the board
DCDCTEST: IC106.P$27 (PQ3); also elsewhere on the board
DEBUG_TRIGGER_0: IC106.P$44 (PF2)
DEBUG_TRIGGER_1: IC106.P$45 (PF3)
EXTERNAL_DEBUG: IC106.P$41 (PA7)
GND: C101.2, C102.2, C103.2, C104.2, C107.2, C108.2, C110.2, C111.2, C112.2, C113.2, C114.2, C121.2, C123.2, C130.1, C131.2, C132.1, C133.2, IC106.P$10 (GNDA), IC106.P$17 (GND), IC106.P$48 (GND), IC106.P$55 (GND), IC106.P$58 (GND), IC106.P$64 (!WAKE), IC106.P$66 (XOSC0), IC106.P$80 (GND), IC106.P$114 (GND), IC107.1 (A), LED101.C, LED102.C, R108.1, R109.1, R110.1, R139.1; also elsewhere on the board
HOSTSCL: IC106.P$49 (PG0); also elsewhere on the board
HOSTSDA: IC106.P$50 (PG1); also elsewhere on the board
IRSTN: R102.1; also elsewhere on the board
ITCK: IC106.P$100 (PC0); also elsewhere on the board
ITDI: IC106.P$98 (PC2); also elsewhere on the board
ITDO: IC106.P$97 (PC3); also elsewhere on the board
ITMS: IC106.P$99 (PC1); also elsewhere on the board
LED0: IC106.P$3 (PD2), R111.1
LED1: IC106.P$4 (PD3), R124.1
unnamed: IC106.P$63 (PK4), R108.2
unnamed: LED102.A, R124.2
unnamed: LED101.A, R111.2
unnamed: IC106.P$93 (PL7), R138.2
unnamed: IC106.P$61 (PK6), R110.2
unnamed: IC106.P$95 (PB0), R131.2
unnamed: IC106.P$62 (PK5), R109.2
unnamed: IC106.P$59 (RBIAS), R139.2
OSC0: C102.1, IC106.P$88 (OSC0), Q101.3 (OSC1)
OSC1: IC106.P$89 (OSC1), R106.2
OSC1_R: C101.1, Q101.1 (OSC0), R106.1
REF_MAIN_LDO: IC106.P$128 (PD7); also elsewhere on the board
REF_TARGET_VCC: IC106.P$120 (PB5); also elsewhere on the board
USB0CLK: IC106.P$92 (PB3); also elsewhere on the board
USB0D0: IC106.P$81 (PL0); also elsewhere on the board
USB0D1: IC106.P$82 (PL1); also elsewhere on the board
USB0D2: IC106.P$83 (PL2); also elsewhere on the board
USB0D3: IC106.P$84 (PL3); also elsewhere on the board
USB0D4: IC106.P$85 (PL4); also elsewhere on the board
USB0D5: IC106.P$86 (PL5); also elsewhere on the board
USB0D6: IC106.P$106 (PP5); also elsewhere on the board
USB0D7: IC106.P$105 (PP4); also elsewhere on the board
USBDIR: IC106.P$104 (PP3); also elsewhere on the board
USBNXT: IC106.P$103 (PP2); also elsewhere on the board
USBSTP: IC106.P$91 (PB2); also elsewhere on the board
VBUS_DETECT: IC106.P$1 (PD0); also elsewhere on the board
VCCEN1: IC106.P$78 (PM0), TP110.1; also elsewhere on the board
VCCEN2: IC106.P$77 (PM1)
VDDC: C131.1, C132.2, C133.1, IC106.P$87 (VDDC), IC106.P$115 (VDDC)
VREFA+: C110.1, C111.1, IC106.P$9 (VREFA+), IC107.3 (C), R105.1
XDSET_!RST: C108.1, IC106.P$70 (!RESET), R102.2, R103.2
XDSET_CTS: IC106.P$30 (PH1); also elsewhere on the board
XDSET_DM: R138.1; also elsewhere on the board
XDSET_DP: R137.1; also elsewhere on the board
XDSET_DPR: IC106.P$94 (PL6), R137.2
XDSET_ID: R131.1; also elsewhere on the board
XDSET_RESET_OUT: IC106.P$40 (PA6); also elsewhere on the board
XDSET_RTS: IC106.P$29 (PH0); also elsewhere on the board
XDSET_RXD: IC106.P$33 (PA0); also elsewhere on the board
XDSET_TCK_SWCLK: IC106.P$35 (PA2); also elsewhere on the board
XDSET_TDI: IC106.P$38 (PA5); also elsewhere on the board
XDSET_TDO_SWO: IC106.P$37 (PA4); also elsewhere on the board
XDSET_TMS_SWDIO: IC106.P$36 (PA3); also elsewhere on the board
XDSET_TXD: IC106.P$34 (PA1); also elsewhere on the board
XDSET_VBAT: C103.1, IC106.P$68 (VBAT), R104.2
XDSET_VBUS: IC106.P$96 (PB1); also elsewhere on the board
XDSET_VCC: C104.1, C107.1, C112.1, C113.1, C114.1, C121.1, C123.1, C130.2, IC106.P$7 (VDD), IC106.P$8 (VDDA), IC106.P$16 (VDD), IC106.P$26 (VDD), IC106.P$28 (VDD), IC106.P$39 (VDD), IC106.P$47 (VDD), IC106.P$51 (VDD), IC106.P$52 (VDD), IC106.P$69 (VDD), IC106.P$79 (VDD), IC106.P$90 (VDD), IC106.P$101 (VDD), IC106.P$113 (VDD), IC106.P$122 (VDD), R103.1, R104.1, R105.2; also elsewhere on the board

Notes on the sheet:
R104 and C103 used to meet VBAT rise time requirements
XDS-ET Emulation and Debug
Texas Instruments
Mike Stein
Rev1.0

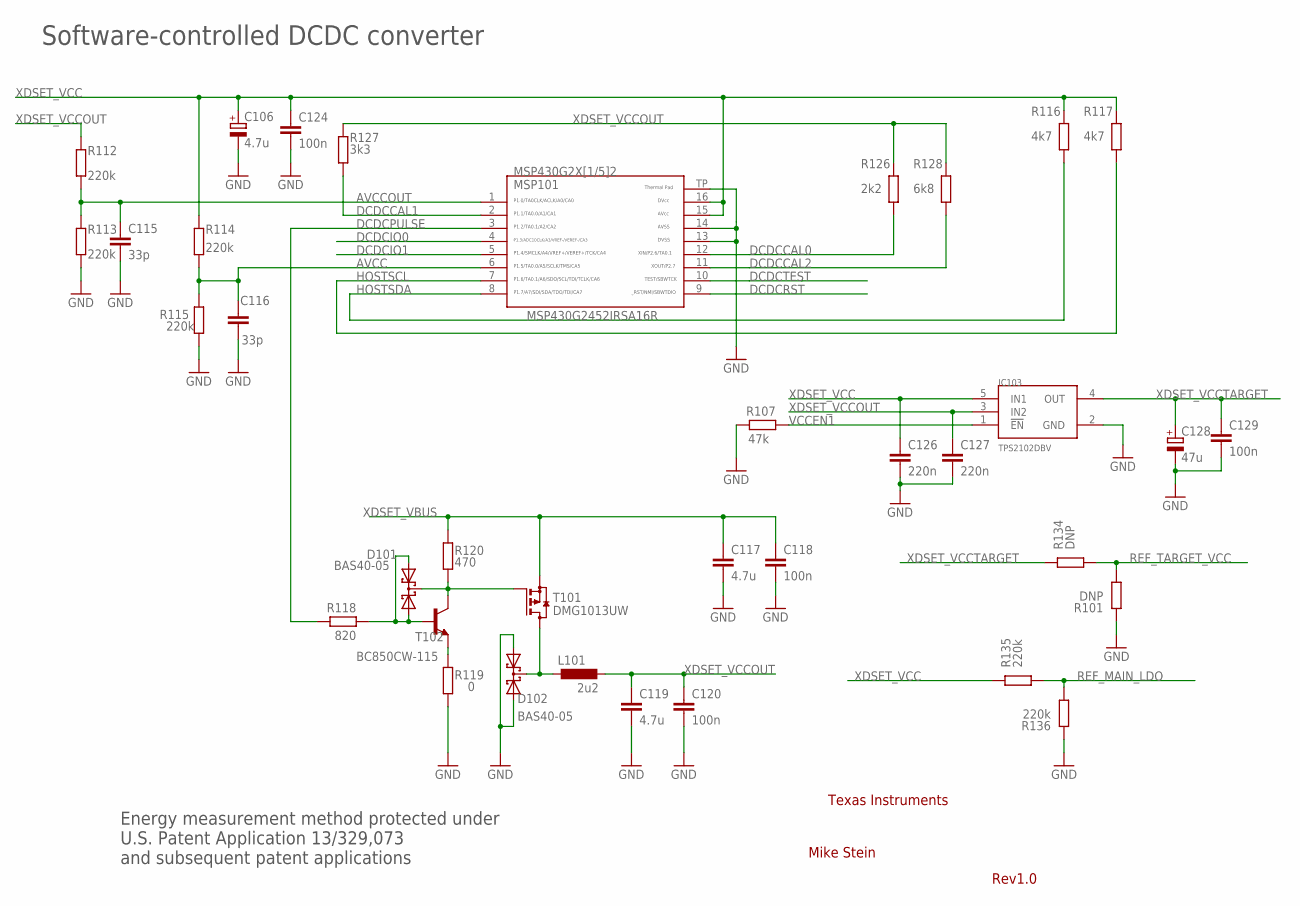
[picture p93: schematic MSP-EXP432P401R.sch, sheet 5]

Parts:
C106: 4.7u; A/3216-18R
C115, C116: 33p; 0402
C117, C119: 4.7u; C0603
C118, C120, C124, C129: 100n; 0402
C126, C127: 220n; 0402
C128: 47u; A/3216-18R
D101, D102: BAS40-05; SOT23
IC103: TPS2102DBV; SOT23-5
L101: 2u2; L3216C
MSP101: MSP430G2452IRSA16R; RSA16
R101, R134: DNP; 0402
R107: 47k; 0402
R112, R113, R114, R115, R135, R136: 220k; 0402
R116, R117: 4k7; 0402
R118: 820; 0402
R119: 0; 0402
R120: 470; 0402
R126: 2k2; 0402
R127: 3k3; 0402
R128: 6k8; 0402
T101: DMG1013UW; SOT23
T102: BC850CW-115; SOT23-BEC

Connections:
AVCC: C116.2, MSP101.6, R114.2, R115.1
AVCCOUT: C115.2, MSP101.1, R112.2, R113.1
DCDCCAL0: MSP101.12, R126.2
DCDCCAL1: MSP101.2, R127.2
DCDCCAL2: MSP101.11, R128.2
DCDCIO0: MSP101.4; also elsewhere on the board
DCDCIO1: MSP101.5; also elsewhere on the board
DCDCPULSE: MSP101.3, R118.2; also elsewhere on the board
DCDCRST: MSP101.9; also elsewhere on the board
DCDCTEST: MSP101.10; also elsewhere on the board
GND: C106.-, C115.1, C116.1, C117.2, C118.2, C119.2, C120.2, C124.2, C126.2, C127.2, C128.-, C129.2, D102.1 (A1), D102.2 (A2), IC103.2 (GND), MSP101.13, MSP101.14, MSP101.TP, R101.1, R107.2, R113.2, R115.2, R119.2, R136.1; also elsewhere on the board
HOSTSCL: MSP101.7, R117.2; also elsewhere on the board
HOSTSDA: MSP101.8, R116.2; also elsewhere on the board
unnamed: R119.1, T102.E
unnamed: D101.1 (A1), D101.2 (A2), R118.1, T102.B
unnamed: D102.3 (C), L101.1, T101.3 (D)
unnamed: D101.3 (C), R120.2, T101.1 (G), T102.C
REF_MAIN_LDO: R135.2, R136.2; also elsewhere on the board
REF_TARGET_VCC: R101.2, R134.2; also elsewhere on the board
VCCEN1: IC103.1 (!EN), R107.1; also elsewhere on the board
XDSET_VBUS: C117.1, C118.1, R120.1, T101.2 (S); also elsewhere on the board
XDSET_VCC: C106.+, C124.1, C126.1, IC103.5 (IN1), MSP101.15, MSP101.16, R114.1, R116.1, R117.1, R135.1; also elsewhere on the board
XDSET_VCCOUT: C119.1, C120.1, C127.1, IC103.3 (IN2), L101.2, R112.1, R126.1, R127.1, R128.1
XDSET_VCCTARGET: C128.+, C129.1, IC103.4 (OUT), R134.1; also elsewhere on the board

Notes on the sheet:
Software-controlled DCDC converter
MSP430G2452IRSA16R
Energy measurement method protected under U.S. Patent Application 13/329,073 and subsequent patent applications
Texas Instruments
Mike Stein
Rev1.0

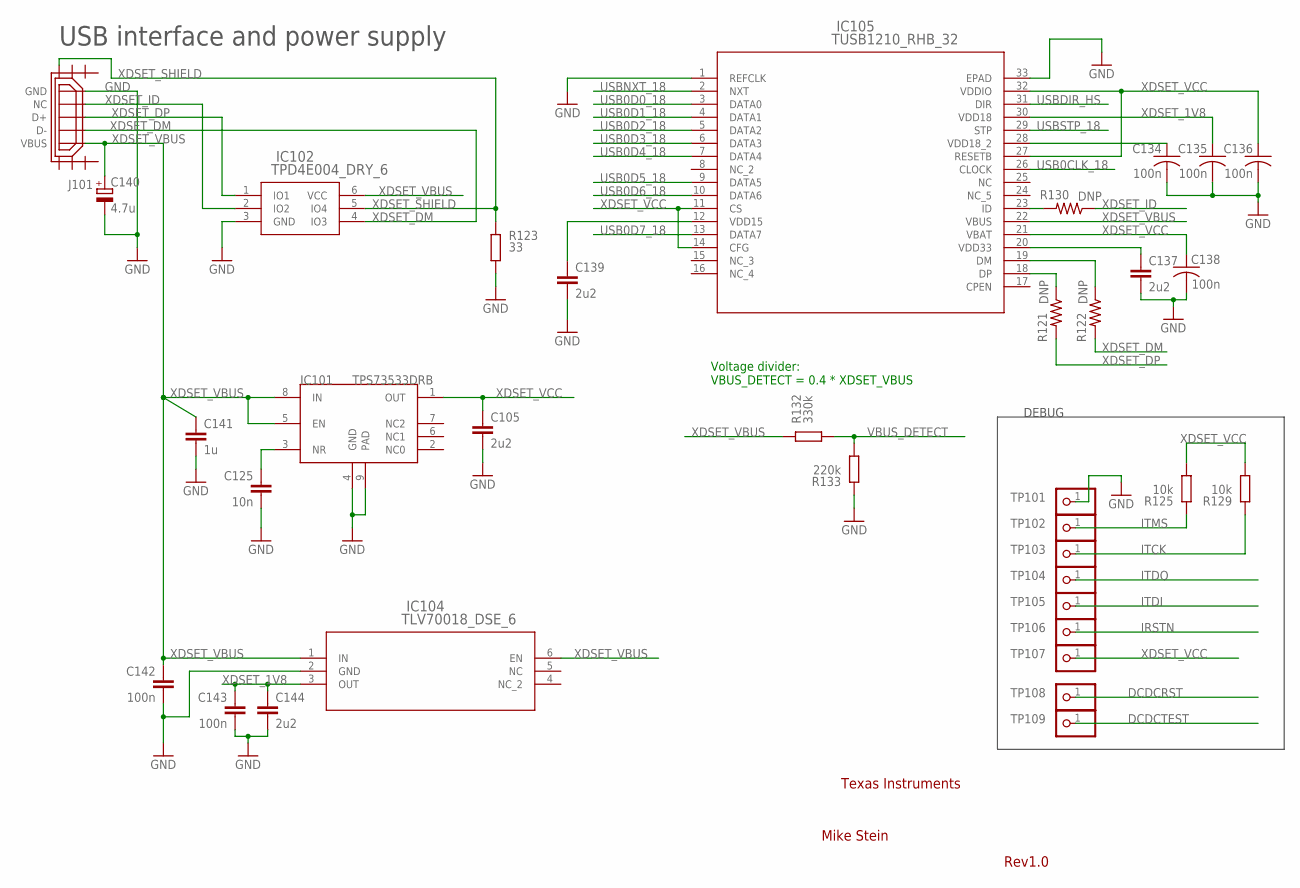
[picture p94: schematic MSP-EXP432P401R.sch, sheet 6]

Parts:
C105, C137, C139, C144: 2u2; C0603
C125: 10n; 0402
C134, C135, C136, C138: 100n; C0402
C140: 4.7u; A/3216-18R
C141: 1u; C0603
C142, C143: 100n; 0402
IC101: TPS73533DRB; SON8
IC102: TPD4E004_DRY_6; DRY6
IC104: TLV70018_DSE_6; DSE6
IC105: TUSB1210_RHB_32; RHB32_3P45X3P45
J101: USB_MICRO_FLIPPED; HIROSE-ZX62R-B-5P
R121, R122, R130: DNP; R0402
R123: 33; 0402
R125, R129: 10k; 0402
R132: 330k; 0402
R133: 220k; 0402
TP101, TP102, TP103, TP104, TP105, TP106, TP107, TP108, TP109: TEST_PIN2; 1X01

Connections:
DCDCRST: TP108.1; also elsewhere on the board
DCDCTEST: TP109.1; also elsewhere on the board
GND: C105.2, C125.2, C134.2, C135.2, C136.2, C137.2, C138.2, C139.2, C140.-, C141.2, C142.2, C143.2, C144.2, IC101.4 (GND), IC101.9 (PAD), IC102.3 (GND), IC104.2 (GND), IC105.1 (REFCLK), IC105.33 (EPAD), J101.GND, R123.2, R133.1, TP101.1; also elsewhere on the board
IRSTN: TP106.1; also elsewhere on the board
ITCK: R129.1, TP103.1; also elsewhere on the board
ITDI: TP105.1; also elsewhere on the board
ITDO: TP104.1; also elsewhere on the board
ITMS: R125.1, TP102.1; also elsewhere on the board
unnamed: IC105.18 (DP), R121.1
unnamed: IC105.19 (DM), R122.1
unnamed: C125.1, IC101.3 (NR)
unnamed: C137.1, IC105.20 (VDD33)
unnamed: C139.1, IC105.12 (VDD15)
unnamed: C134.1, IC105.28 (VDD18_2)
USB0CLK_18: IC105.26 (CLOCK); also elsewhere on the board
USB0D0_18: IC105.3 (DATA0); also elsewhere on the board
USB0D1_18: IC105.4 (DATA1); also elsewhere on the board
USB0D2_18: IC105.5 (DATA2); also elsewhere on the board
USB0D3_18: IC105.6 (DATA3); also elsewhere on the board
USB0D4_18: IC105.7 (DATA4); also elsewhere on the board
USB0D5_18: IC105.9 (DATA5); also elsewhere on the board
USB0D6_18: IC105.10 (DATA6); also elsewhere on the board
USB0D7_18: IC105.13 (DATA7); also elsewhere on the board
USBDIR_HS: IC105.31 (DIR); also elsewhere on the board
USBNXT_18: IC105.2 (NXT); also elsewhere on the board
USBSTP_18: IC105.29 (STP); also elsewhere on the board
VBUS_DETECT: R132.2, R133.2; also elsewhere on the board
XDSET_1V8: C135.1, C143.1, C144.1, IC104.3 (OUT), IC105.30 (VDD18); also elsewhere on the board
XDSET_DM: IC102.4 (IO3), J101.D-, R122.2; also elsewhere on the board
XDSET_DP: IC102.1 (IO1), J101.D+, R121.2; also elsewhere on the board
XDSET_ID: IC102.2 (IO2), J101.NC, R130.1; also elsewhere on the board
XDSET_IDR: IC105.23 (ID), R130.2
XDSET_SHIELD: IC102.5 (IO4), J101.SHIELD3, R123.1
XDSET_VBUS: C140.+, C141.1, C142.1, IC101.5 (EN), IC101.8 (IN), IC102.6 (VCC), IC104.1 (IN), IC104.6 (EN), IC105.22 (VBUS), J101.VBUS, R132.1; also elsewhere on the board
XDSET_VCC: C105.1, C136.1, C138.1, IC101.1 (OUT), IC105.11 (CS), IC105.14 (CFG), IC105.21 (VBAT), IC105.27 (RESETB), IC105.32 (VDDIO), R125.2, R129.2, TP107.1; also elsewhere on the board

Notes on the sheet:
USB interface and power supply
DEBUG
Voltage divider: VBUS_DETECT = 0.4 * XDSET_VBUS
Texas Instruments
Mike Stein
Rev1.0
