Octanis1/Octanis1-Electronics/MSP-EXP432P401R Hardware Design Files/Hardware/MSP-EXP432P401R.brd

## EAGLE design MSP-EXP432P401R Hardware Design Files/Hardware/MSP-EXP432P401R.brd (continued)

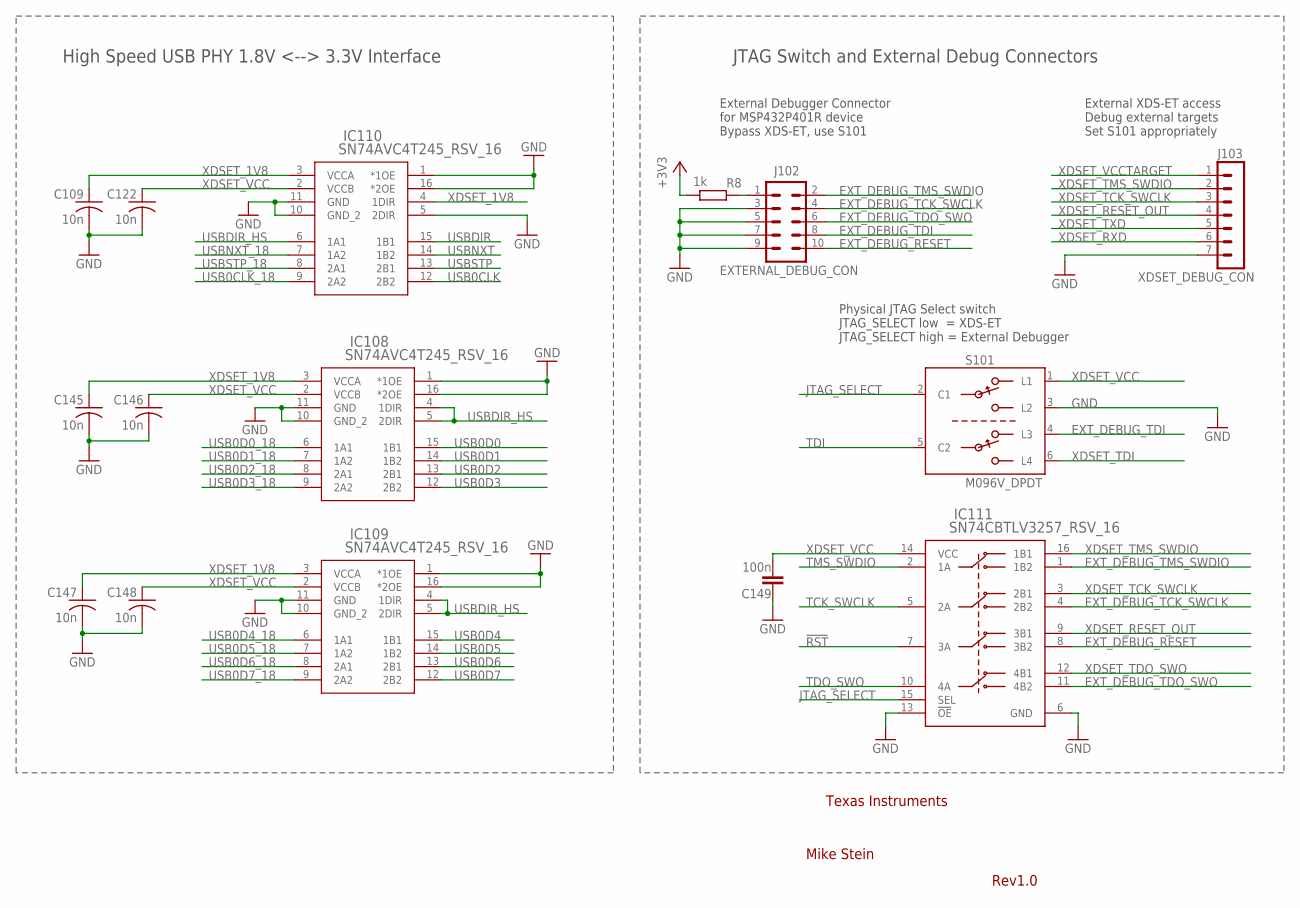
[picture p95: schematic MSP-EXP432P401R.sch, sheet 7]

Parts:
C109, C122, C145, C146, C147, C148: 10n; C0402
C149: 100n; 0402
IC108, IC109, IC110: SN74AVC4T245_RSV_16; RSV16
IC111: SN74CBTLV3257_RSV_16; RSV16
J102: EXTERNAL_DEBUG_CON; EXTERNAL_DEBUG
J103: XDSET_DEBUG_CON; XDSET_DEBUG
R8: 1k; 0402
S101: M096V_DPDT

Connections:
!RST: IC111.7 (3A); also elsewhere on the board
+3V3: R8.1; also elsewhere on the board
EXT_DEBUG_RESET: IC111.8 (3B2), J102.10
EXT_DEBUG_TCK_SWCLK: IC111.4 (2B2), J102.4
EXT_DEBUG_TDI: J102.8, S101.4 (L3)
EXT_DEBUG_TDO_SWO: IC111.11 (4B2), J102.6
EXT_DEBUG_TMS_SWDIO: IC111.1 (1B2), J102.2
GND: C109.2, C122.2, C145.2, C146.2, C147.2, C148.2, C149.2, IC108.1 (*1OE), IC108.10 (GND_2), IC108.11 (GND), IC108.16 (*2OE), IC109.1 (*1OE), IC109.10 (GND_2), IC109.11 (GND), IC109.16 (*2OE), IC110.1 (*1OE), IC110.5 (2DIR), IC110.10 (GND_2), IC110.11 (GND), IC110.16 (*2OE), IC111.6 (GND), IC111.13 (!OE), J102.3, J102.5, J102.7, J102.9, J103.7, S101.3 (L2); also elsewhere on the board
JTAG_SELECT: IC111.15 (SEL), S101.2 (C1)
unnamed: J102.1, R8.2
TCK_SWCLK: IC111.5 (2A); also elsewhere on the board
TDI: S101.5 (C2); also elsewhere on the board
TDO_SWO: IC111.10 (4A); also elsewhere on the board
TMS_SWDIO: IC111.2 (1A); also elsewhere on the board
USB0CLK: IC110.12 (2B2); also elsewhere on the board
USB0CLK_18: IC110.9 (2A2); also elsewhere on the board
USB0D0: IC108.15 (1B1); also elsewhere on the board
USB0D0_18: IC108.6 (1A1); also elsewhere on the board
USB0D1: IC108.14 (1B2); also elsewhere on the board
USB0D1_18: IC108.7 (1A2); also elsewhere on the board
USB0D2: IC108.13 (2B1); also elsewhere on the board
USB0D2_18: IC108.8 (2A1); also elsewhere on the board
USB0D3: IC108.12 (2B2); also elsewhere on the board
USB0D3_18: IC108.9 (2A2); also elsewhere on the board
USB0D4: IC109.15 (1B1); also elsewhere on the board
USB0D4_18: IC109.6 (1A1); also elsewhere on the board
USB0D5: IC109.14 (1B2); also elsewhere on the board
USB0D5_18: IC109.7 (1A2); also elsewhere on the board
USB0D6: IC109.13 (2B1); also elsewhere on the board
USB0D6_18: IC109.8 (2A1); also elsewhere on the board
USB0D7: IC109.12 (2B2); also elsewhere on the board
USB0D7_18: IC109.9 (2A2); also elsewhere on the board
USBDIR: IC110.15 (1B1); also elsewhere on the board
USBDIR_HS: IC108.4 (1DIR), IC108.5 (2DIR), IC109.4 (1DIR), IC109.5 (2DIR), IC110.6 (1A1); also elsewhere on the board
USBNXT: IC110.14 (1B2); also elsewhere on the board
USBNXT_18: IC110.7 (1A2); also elsewhere on the board
USBSTP: IC110.13 (2B1); also elsewhere on the board
USBSTP_18: IC110.8 (2A1); also elsewhere on the board
XDSET_1V8: C109.1, C145.1, C147.1, IC108.3 (VCCA), IC109.3 (VCCA), IC110.3 (VCCA), IC110.4 (1DIR); also elsewhere on the board
XDSET_RESET_OUT: IC111.9 (3B1), J103.4; also elsewhere on the board
XDSET_RXD: J103.6; also elsewhere on the board
XDSET_TCK_SWCLK: IC111.3 (2B1), J103.3; also elsewhere on the board
XDSET_TDI: S101.6 (L4); also elsewhere on the board
XDSET_TDO_SWO: IC111.12 (4B1); also elsewhere on the board
XDSET_TMS_SWDIO: IC111.16 (1B1), J103.2; also elsewhere on the board
XDSET_TXD: J103.5; also elsewhere on the board
XDSET_VCC: C122.1, C146.1, C148.1, C149.1, IC108.2 (VCCB), IC109.2 (VCCB), IC110.2 (VCCB), IC111.14 (VCC), S101.1 (L1); also elsewhere on the board
XDSET_VCCTARGET: J103.1; also elsewhere on the board

Notes on the sheet:
High Speed USB PHY 1.8V <--> 3.3V Interface
External Debugger Connector for MSP432P401R device Bypass XDS-ET, use S101
External XDS-ET access Debug external targets Set S101 appropriately
Physical JTAG Select switch JTAG_SELECT low = XDS-ET JTAG_SELECT high = External Debugger
JTAG Switch and External Debug Connectors
Texas Instruments
Mike Stein
Rev1.0

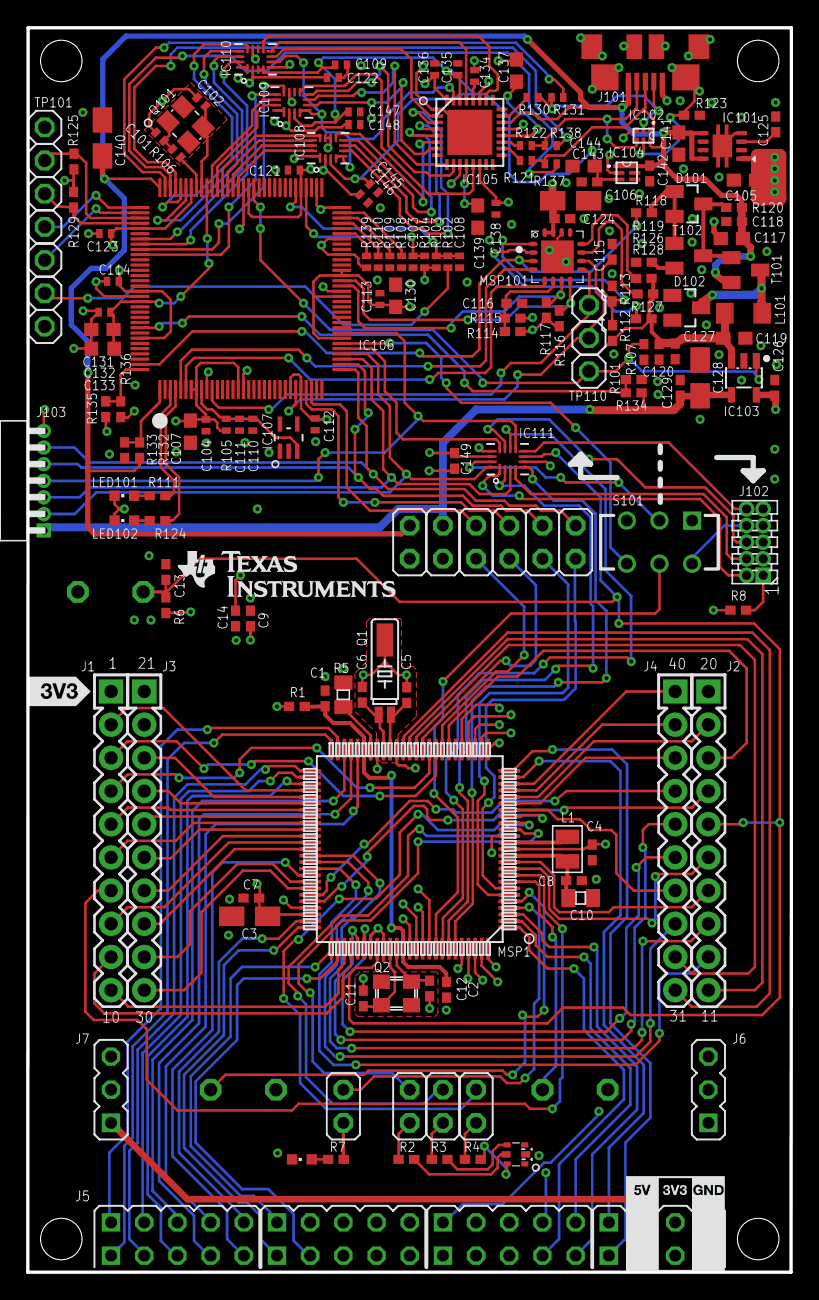
[picture p96: board MSP-EXP432P401R.brd from above]

Board: 4 copper layers, 58.4 x 95.2 mm, 179 parts (0 on the bottom side), 200 nets.

Other parts of the board:
DRAW3: LOGO-ROCKET-10X7MM-BRD
U$4: LOGO16_TPLACE
