Octanis1/Octanis1-Electronics/octanis_main_pcb_v0.3/octanis_v0.1.brd

## EAGLE design octanis_main_pcb_v0.3/octanis_v0.1.brd (2015-04-06, an earlier design)

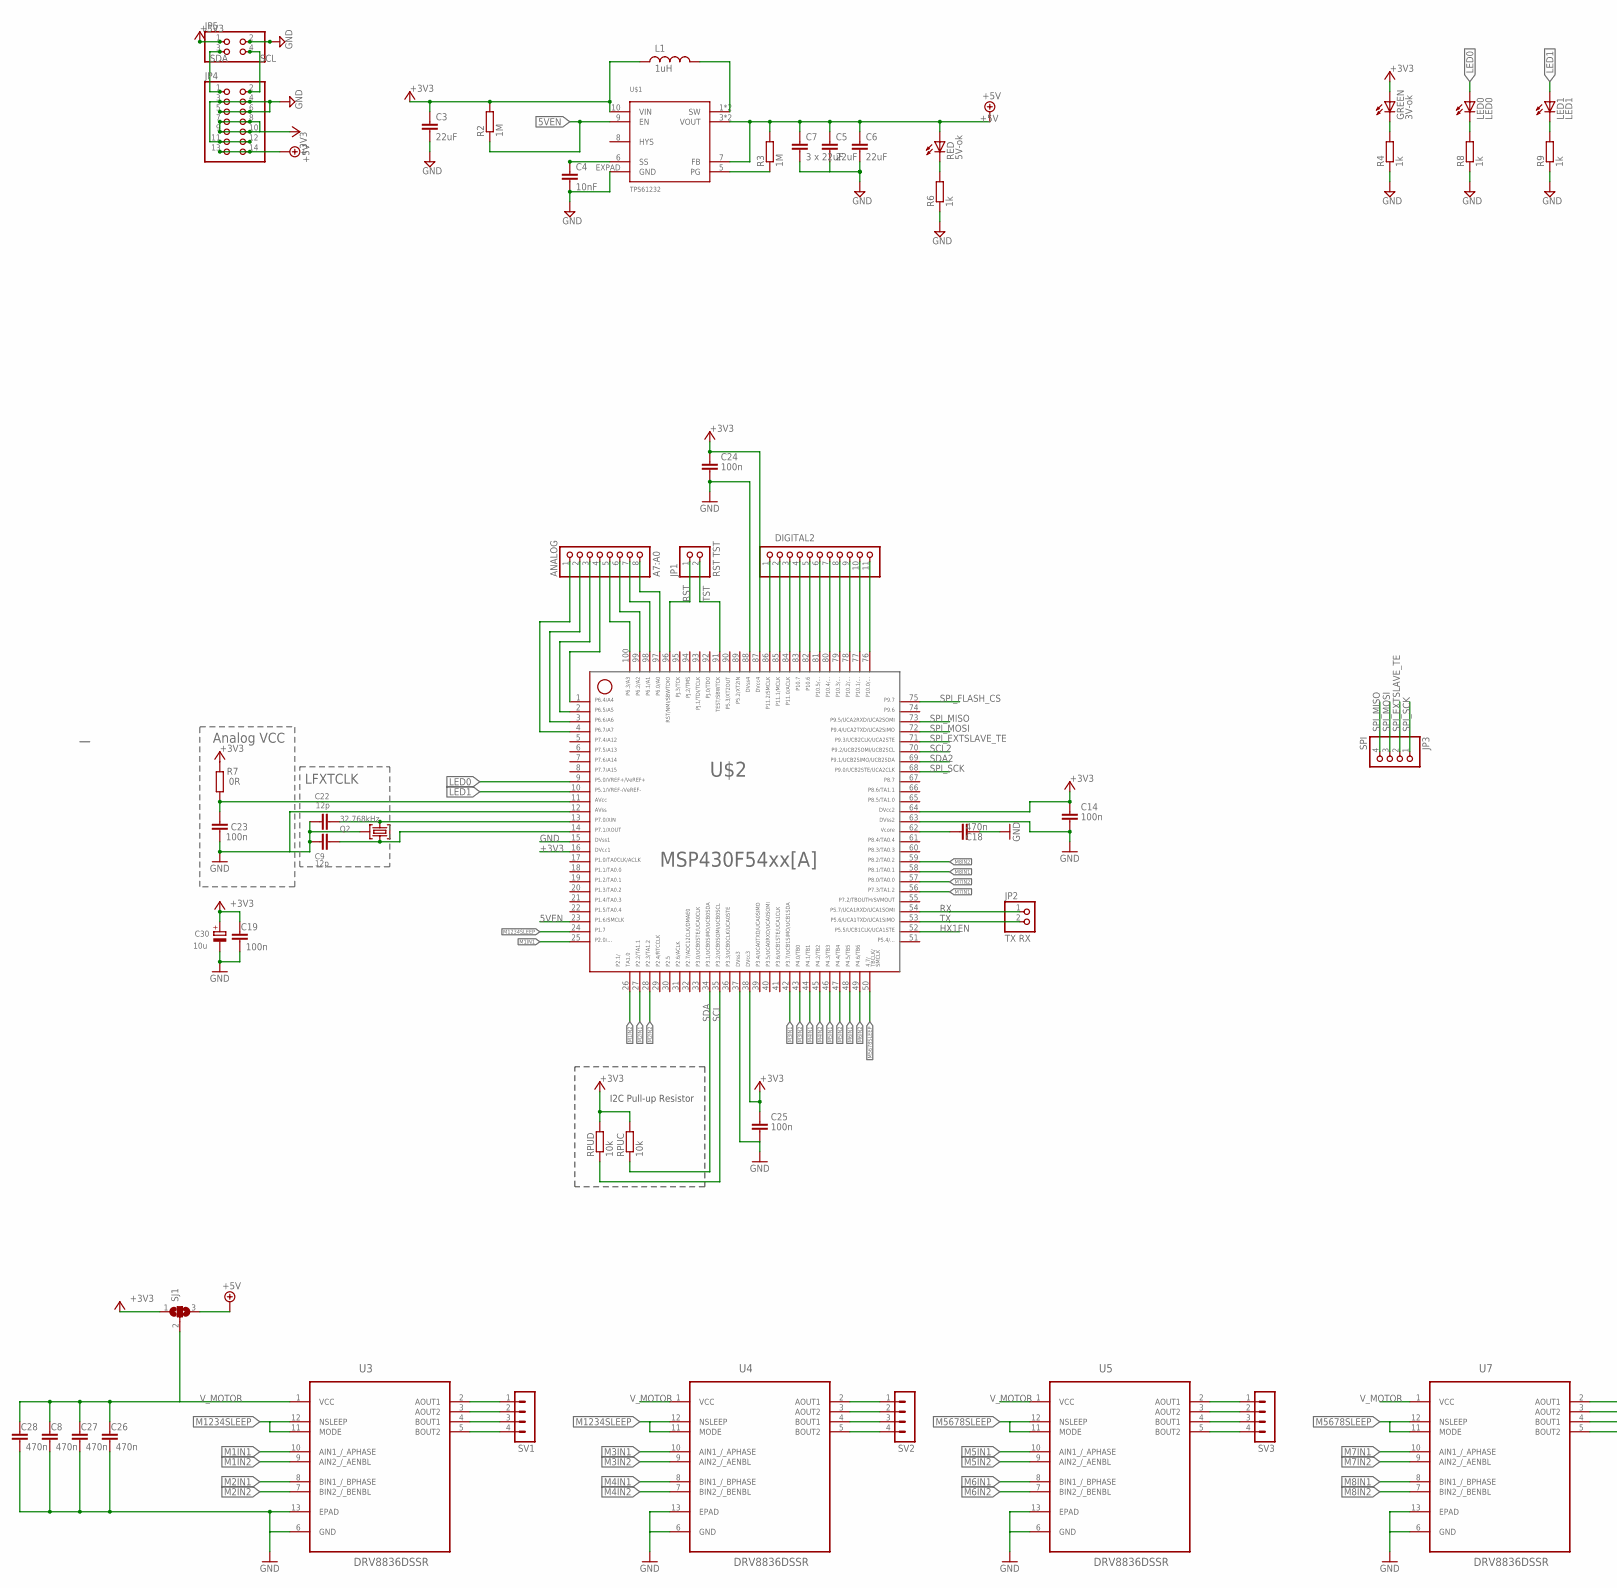
[picture p97: schematic octanis_v0.1.sch, part in row 1, column 1]

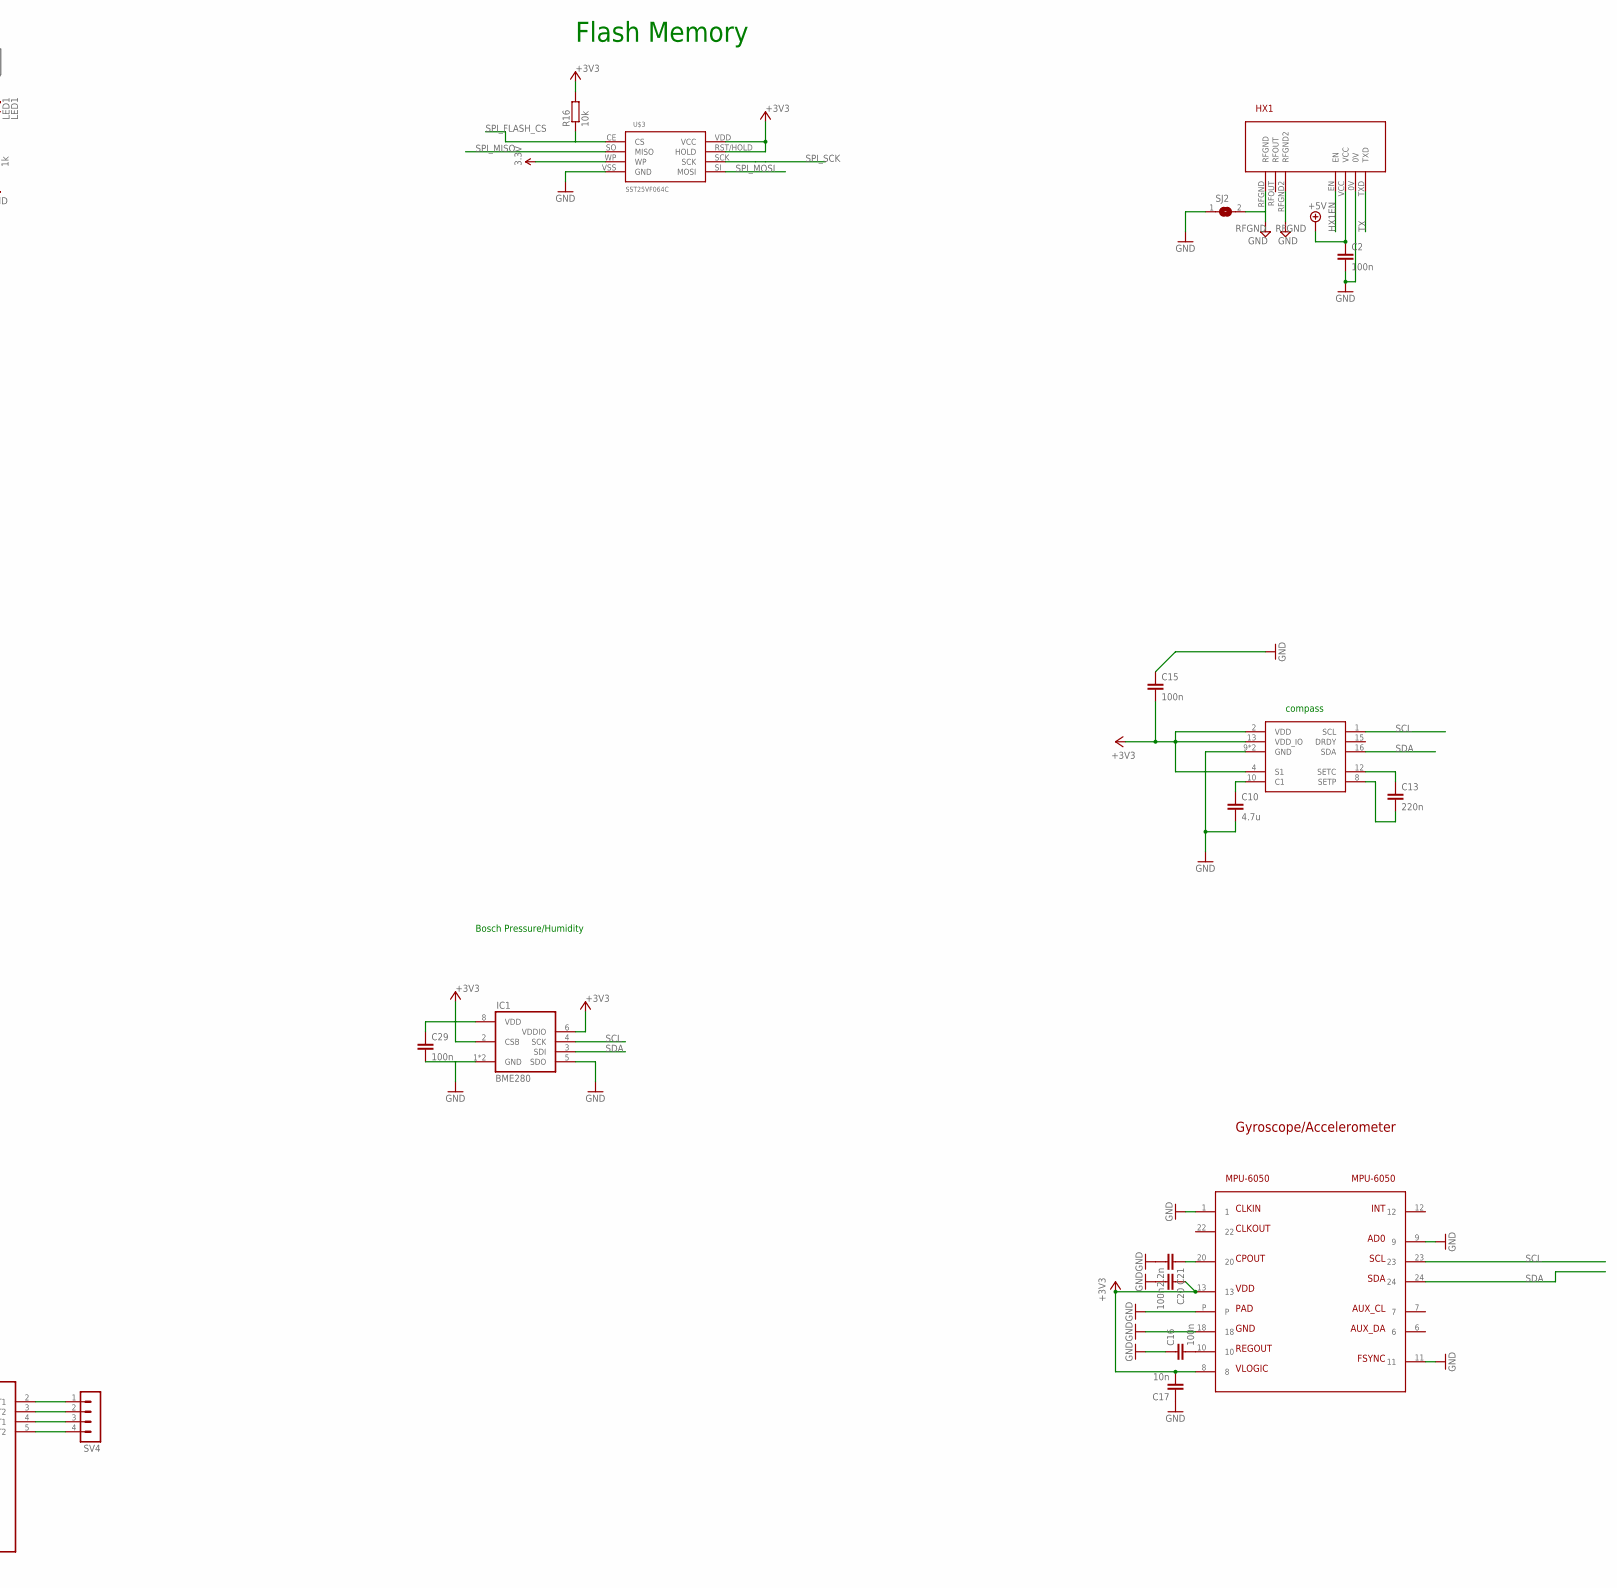
[picture p98: schematic octanis_v0.1.sch, part in row 1, column 2]

Parts:
ANALOG: A7:A0; 1X08
C2, C14, C15, C16, C19, C20, C24, C25, C29: 100n; C0603
C3, C5, C6: 22uF; C0603
C4: 10nF; C0603
C7: 3 x 22uF; C0603
C8, C18, C26, C27, C28: 470n; C0603
C9, C22: 12p; C0402
C10: 4.7u; C0603
C13: 220n; C0603
C17: 10n; C0603
C21: 2.2n; C0603
C23: 100n; C0402
C30: 10u; A/3216-18R
COMPASS: HMC5883L; LPCC16
DIGITAL2: DIGITAL I/O; 1X11
GREEN: 3V-ok; CHIPLED_0603
IC1: BME280
JP1: RST TST; 1X02
JP2: TX RX; 1X02
JP3: SPI; 1X04
JP4: PINHD-2X7; 2X07
JP5: PINHD-2X2; 2X02
L1: 1uH; XFL4020
LED0: LED0; CHIPLED_0603
LED1: LED1; CHIPLED_0603
MPU-6050: MPU-6050; QFN24
Q2: 32.768kHz; MS3V-T1R
R2, R3: 1M; R0603
R4, R6, R8, R9: 1k; R0603
R7: 0R; R0402
R16: 10k; R0603
RED: 5V-ok; CHIPLED_0603
RPUC: 10k; R0603
RPUD: 10k; R0603
SJ1: SJ2W; SJ_2
SJ2: SJ
SV1, SV2, SV3, SV4: MA04-1
U3, U4, U5, U7: DRV8836DSSR; SON50P200X300X80-13N
U$1: TPS61232; S-PVSON-N10
U$2: MSP430F5438A; PZ100
U$3: SST25VF064C; SOIC_8-LEAD
U$4: HX1

Connections:
3.3V: U$3.WP
5VEN: R2.1, U$1.9 (EN), U$2.23
+3V3: C3.1, C14.1, C15.2, C17.2, C19.2, C20.1, C24.1, C25.1, C29.1, C30.+, COMPASS.2 (VDD), COMPASS.4 (S1), COMPASS.13 (VDD_IO), GREEN.A, IC1.2 (CSB), IC1.6 (VDDIO), IC1.8 (VDD), JP4.7, JP4.8, JP4.9, JP4.10, JP5.1, L1.P$1 (1), MPU-6050.8, MPU-6050.13, R2.2, R7.2, R16.2, RPUC.2, RPUD.2, SJ1.1, U$1.10 (VIN), U$2.16, U$2.38, U$2.64, U$2.87, U$3.RST/HOLD (HOLD), U$3.VDD (VCC)
+5V: C2.1, C5.1, C6.1, C7.1, JP4.13, JP4.14, R3.2, RED.A, SJ1.3, U$1.3 (VOUT), U$1.4 (VOUT), U$1.7 (FB), U$4.VCC
AVCC1: C23.1, R7.1, U$2.11
GND: C2.2, C3.2, C4.2, C5.2, C6.2, C7.2, C8.1, C9.1, C10.2, C14.2, C15.1, C16.1, C17.1, C18.1, C19.1, C20.2, C21.2, C22.1, C23.2, C24.2, C25.2, C26.1, C27.1, C28.1, C29.2, C30.-, COMPASS.9 (GND), COMPASS.11 (GND), IC1.1 (GND), IC1.5 (SDO), IC1.7 (GND), JP4.3, JP4.4, JP4.5, JP4.6, JP4.11, JP4.12, JP5.2, MPU-6050.1, MPU-6050.9, MPU-6050.11, MPU-6050.18, MPU-6050.P, Q2.P3 (GND), R4.1, R6.1, R8.1, R9.1, SJ2.1, U3.6 (GND), U3.13 (EPAD), U4.6 (GND), U4.13 (EPAD), U5.6 (GND), U5.13 (EPAD), U7.6 (GND), U7.13 (EPAD), U$1.EXPAD (GND), U$2.12, U$2.15, U$2.37, U$2.63, U$2.88, U$3.VSS (GND), U$4.0V
HX1EN: U$2.52, U$4.EN
IND: L1.P$2 (2), U$1.1 (SW), U$1.2 (SW)
LED0: LED0.A, U$2.9
LED1: LED1.A, U$2.10
M1IN1: U3.10 (AIN1_/_APHASE), U$2.25
M1IN2: U3.9 (AIN2_/_AENBL), U$2.26
M2IN1: U3.8 (BIN1_/_BPHASE), U$2.27
M2IN2: U3.7 (BIN2_/_BENBL), U$2.28
M3IN1: U4.10 (AIN1_/_APHASE), U$2.42
M3IN2: U4.9 (AIN2_/_AENBL), U$2.43
M4IN1: U4.8 (BIN1_/_BPHASE), U$2.44
M4IN2: U4.7 (BIN2_/_BENBL), U$2.45
M5IN1: U5.10 (AIN1_/_APHASE), U$2.46
M5IN2: U5.9 (AIN2_/_AENBL), U$2.47
M6IN1: U5.8 (BIN1_/_BPHASE), U$2.48
M6IN2: U5.7 (BIN2_/_BENBL), U$2.49
M7IN1: U7.10 (AIN1_/_APHASE), U$2.56
M7IN2: U7.9 (AIN2_/_AENBL), U$2.57
M8IN1: U7.8 (BIN1_/_BPHASE), U$2.58
M8IN2: U7.7 (BIN2_/_BENBL), U$2.59
M1234SLEEP: U3.11 (MODE), U3.12 (NSLEEP), U4.11 (MODE), U4.12 (NSLEEP), U$2.24
M5678SLEEP: U5.11 (MODE), U5.12 (NSLEEP), U7.11 (MODE), U7.12 (NSLEEP), U$2.50
unnamed: R3.1, U$1.5 (PG)
unnamed: GREEN.C, R4.2
unnamed: LED0.C, R8.2
unnamed: LED1.C, R9.2
unnamed: SV2.1, U4.2 (AOUT1)
unnamed: DIGITAL2.1, U$2.86
unnamed: DIGITAL2.2, U$2.85
unnamed: C10.1, COMPASS.10 (C1)
unnamed: C16.2, MPU-6050.10
unnamed: C21.1, MPU-6050.20
unnamed: DIGITAL2.3, U$2.84
unnamed: DIGITAL2.4, U$2.83
unnamed: DIGITAL2.5, U$2.82
unnamed: DIGITAL2.6, U$2.81
unnamed: DIGITAL2.7, U$2.80
unnamed: C13.2, COMPASS.8 (SETP)
unnamed: DIGITAL2.8, U$2.79
unnamed: ANALOG.8, U$2.97
unnamed: ANALOG.7, U$2.98
unnamed: ANALOG.6, U$2.99
unnamed: DIGITAL2.9, U$2.78
unnamed: C13.1, COMPASS.12 (SETC)
unnamed: SV2.2, U4.3 (AOUT2)
unnamed: SV2.3, U4.4 (BOUT1)
unnamed: SV2.4, U4.5 (BOUT2)
unnamed: C4.1, U$1.6 (SS)
unnamed: R6.2, RED.C
unnamed: SV3.1, U5.2 (AOUT1)
unnamed: SV3.2, U5.3 (AOUT2)
unnamed: SV3.3, U5.4 (BOUT1)
unnamed: SV3.4, U5.5 (BOUT2)
unnamed: SV1.1, U3.2 (AOUT1)
unnamed: SV1.2, U3.3 (AOUT2)
unnamed: SV1.3, U3.4 (BOUT1)
unnamed: SV1.4, U3.5 (BOUT2)
unnamed: SV4.1, U7.2 (AOUT1)
unnamed: SV4.2, U7.3 (AOUT2)
unnamed: SV4.3, U7.4 (BOUT1)
unnamed: SV4.4, U7.5 (BOUT2)
unnamed: ANALOG.5, U$2.100
unnamed: ANALOG.4, U$2.1
unnamed: ANALOG.3, U$2.2
unnamed: ANALOG.2, U$2.3
unnamed: ANALOG.1, U$2.4
unnamed: DIGITAL2.10, U$2.77
unnamed: DIGITAL2.11, U$2.76
P5.4/XIN1: C22.2, Q2.P2 (2), U$2.13
P5.5/XOUT1: C9.2, Q2.P1 (1), U$2.14
RFGND: SJ2.2, U$4.RFGND, U$4.RFGND2
RST: JP1.1, U$2.96
RX: JP2.1, U$2.54
SCL: COMPASS.1 (SCL), IC1.4 (SCK), JP4.2, JP5.4, MPU-6050.23, RPUD.1, U$2.35
SCL2: U$2.70
SDA: COMPASS.16 (SDA), IC1.3 (SDI), JP4.1, JP5.3, MPU-6050.24, RPUC.1, U$2.34
SDA2: U$2.69
SPI_EXTSLAVE_TE: JP3.2, U$2.71
SPI_FLASH_CS: R16.1, U$2.75, U$3.CE (CS)
SPI_MISO: JP3.4, U$2.73, U$3.SO (MISO)
SPI_MOSI: JP3.3, U$2.72, U$3.SI (MOSI)
SPI_SCK: JP3.1, U$2.68, U$3.SCK
TST: JP1.2, U$2.91
TX: JP2.2, U$2.53, U$4.TXD
VCORE: C18.2, U$2.62
V_MOTOR: C8.2, C26.2, C27.2, C28.2, SJ1.2, U3.1 (VCC), U4.1 (VCC), U5.1 (VCC), U7.1 (VCC)

Notes on the sheet:
compass
LFXTCLK
Analog VCC
I2C Pull-up Resistor
Flash Memory
Gyroscope/Accelerometer
Bosch Pressure/Humidity

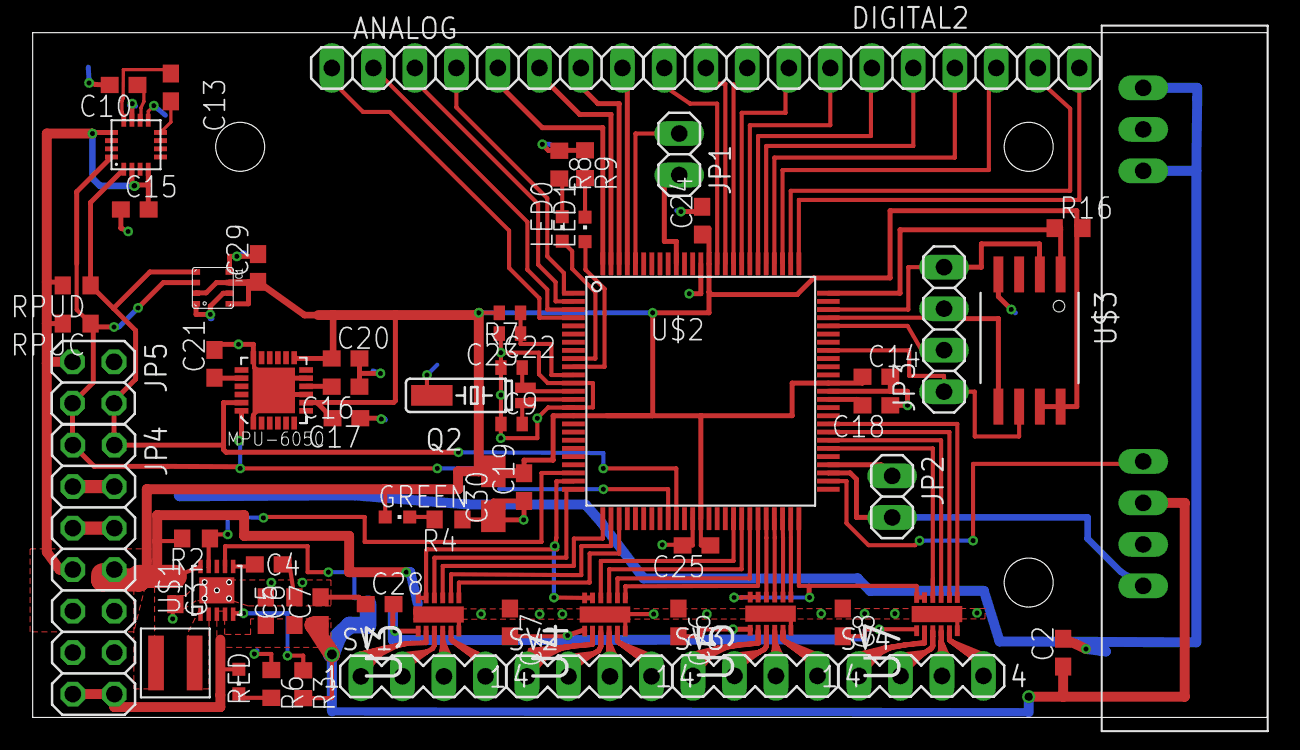
[picture p99: board octanis_v0.1.brd from above]

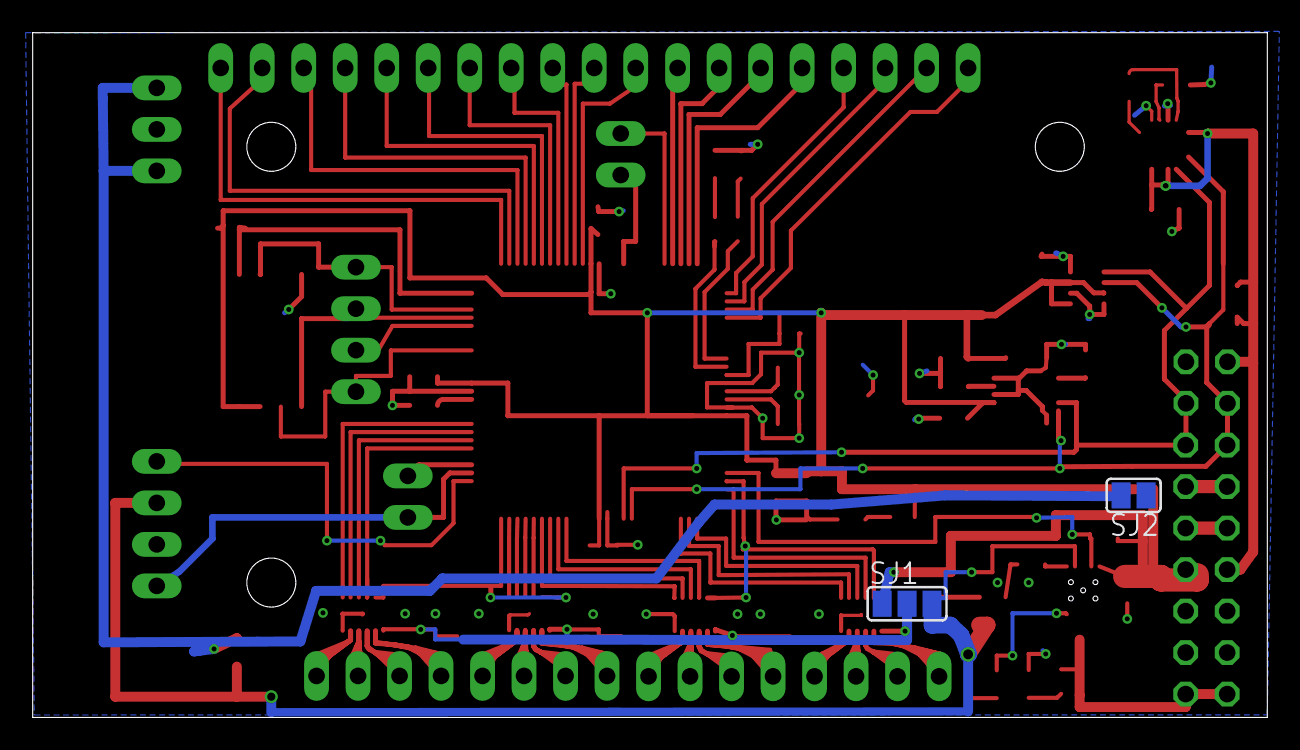
[picture p100: board octanis_v0.1.brd from below]

Board: 2 copper layers, 75.6 x 41.9 mm, 67 parts (2 on the bottom side), 89 nets.
