Octanis1/Octanis1-Electronics/ML8511_Breakout/ML8511_Breakout.brd

## EAGLE design ML8511_Breakout/ML8511_Breakout.brd (2015-04-06)

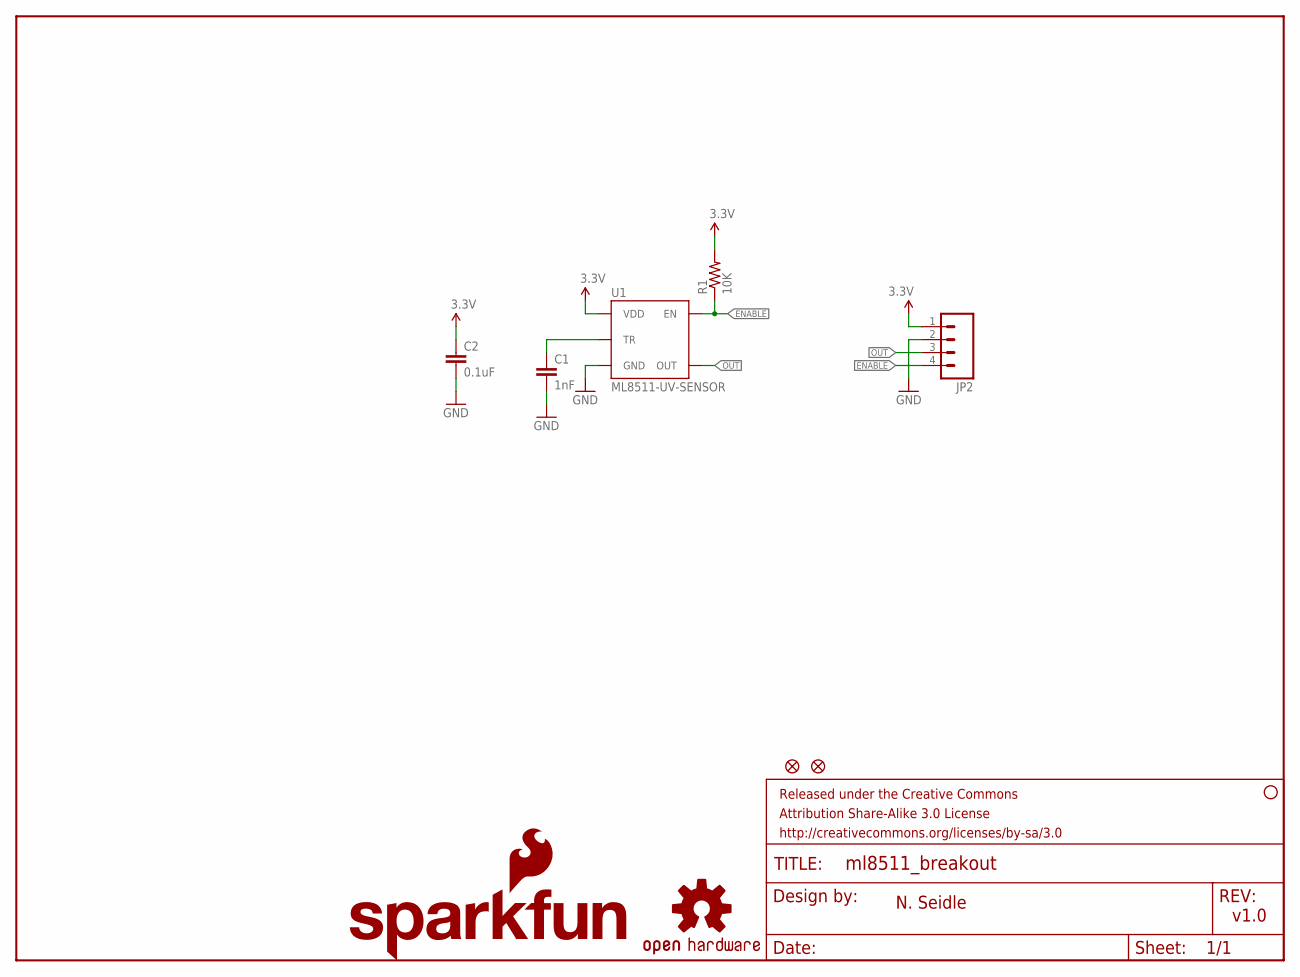
[picture p101: schematic ML8511_Breakout.sch]

Parts:
C1: 1nF; 0603-CAP
C2: 0.1uF; 0603-CAP
FID1, FID2: FIDUCIAL1X2; FIDUCIAL-1X2
FRAME2: FRAME-LETTER; CREATIVE_COMMONS
JP2: M04PTH; 1X04
LOGO2: OSHW-LOGOS; OSHW-LOGO-S
LOGO3: SFE_LOGO_FLAME.1_INCH; SFE_LOGO_FLAME_.1
LOGO4: SFE_LOGO_NAME.1_INCH; SFE_LOGO_NAME_.1
R1: 10K; 0603-RES
STANDOFF1: STAND-OFF
U1: ML8511-UV-SENSOR; ML8511

Connections:
3.3V: C2.1, JP2.1, R1.2, U1.7 (VDD)
ENABLE: JP2.4, R1.1, U1.4 (EN)
GND: C1.2, C2.2, JP2.2, U1.5 (GND)
unnamed: C1.1, U1.10 (TR)
OUT: JP2.3, U1.8 (OUT)

Notes on the sheet:
N. Seidle
v1.0

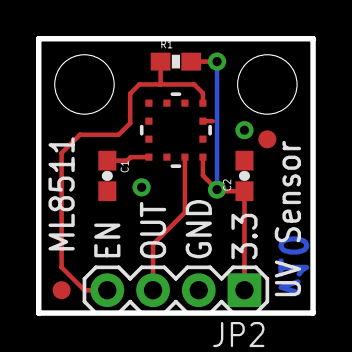
[picture p102: board ML8511_Breakout.brd from above]

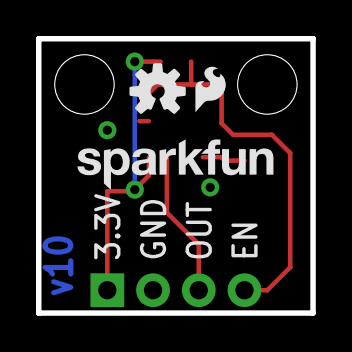
[picture p103: board ML8511_Breakout.brd from below]

Board: 2 copper layers, 15.2 x 15.2 mm, 13 parts (3 on the bottom side), 5 nets.

Other parts of the board:
STANDOFF2: STAND-OFF
