Octanis1/Octanis1-Electronics/octanis_eps/_old/v0.0_analog_shdn/octanis_eps.brd

## EAGLE design octanis_eps/_old/v0.0_analog_shdn/octanis_eps.brd (2015-01-28, an earlier design)

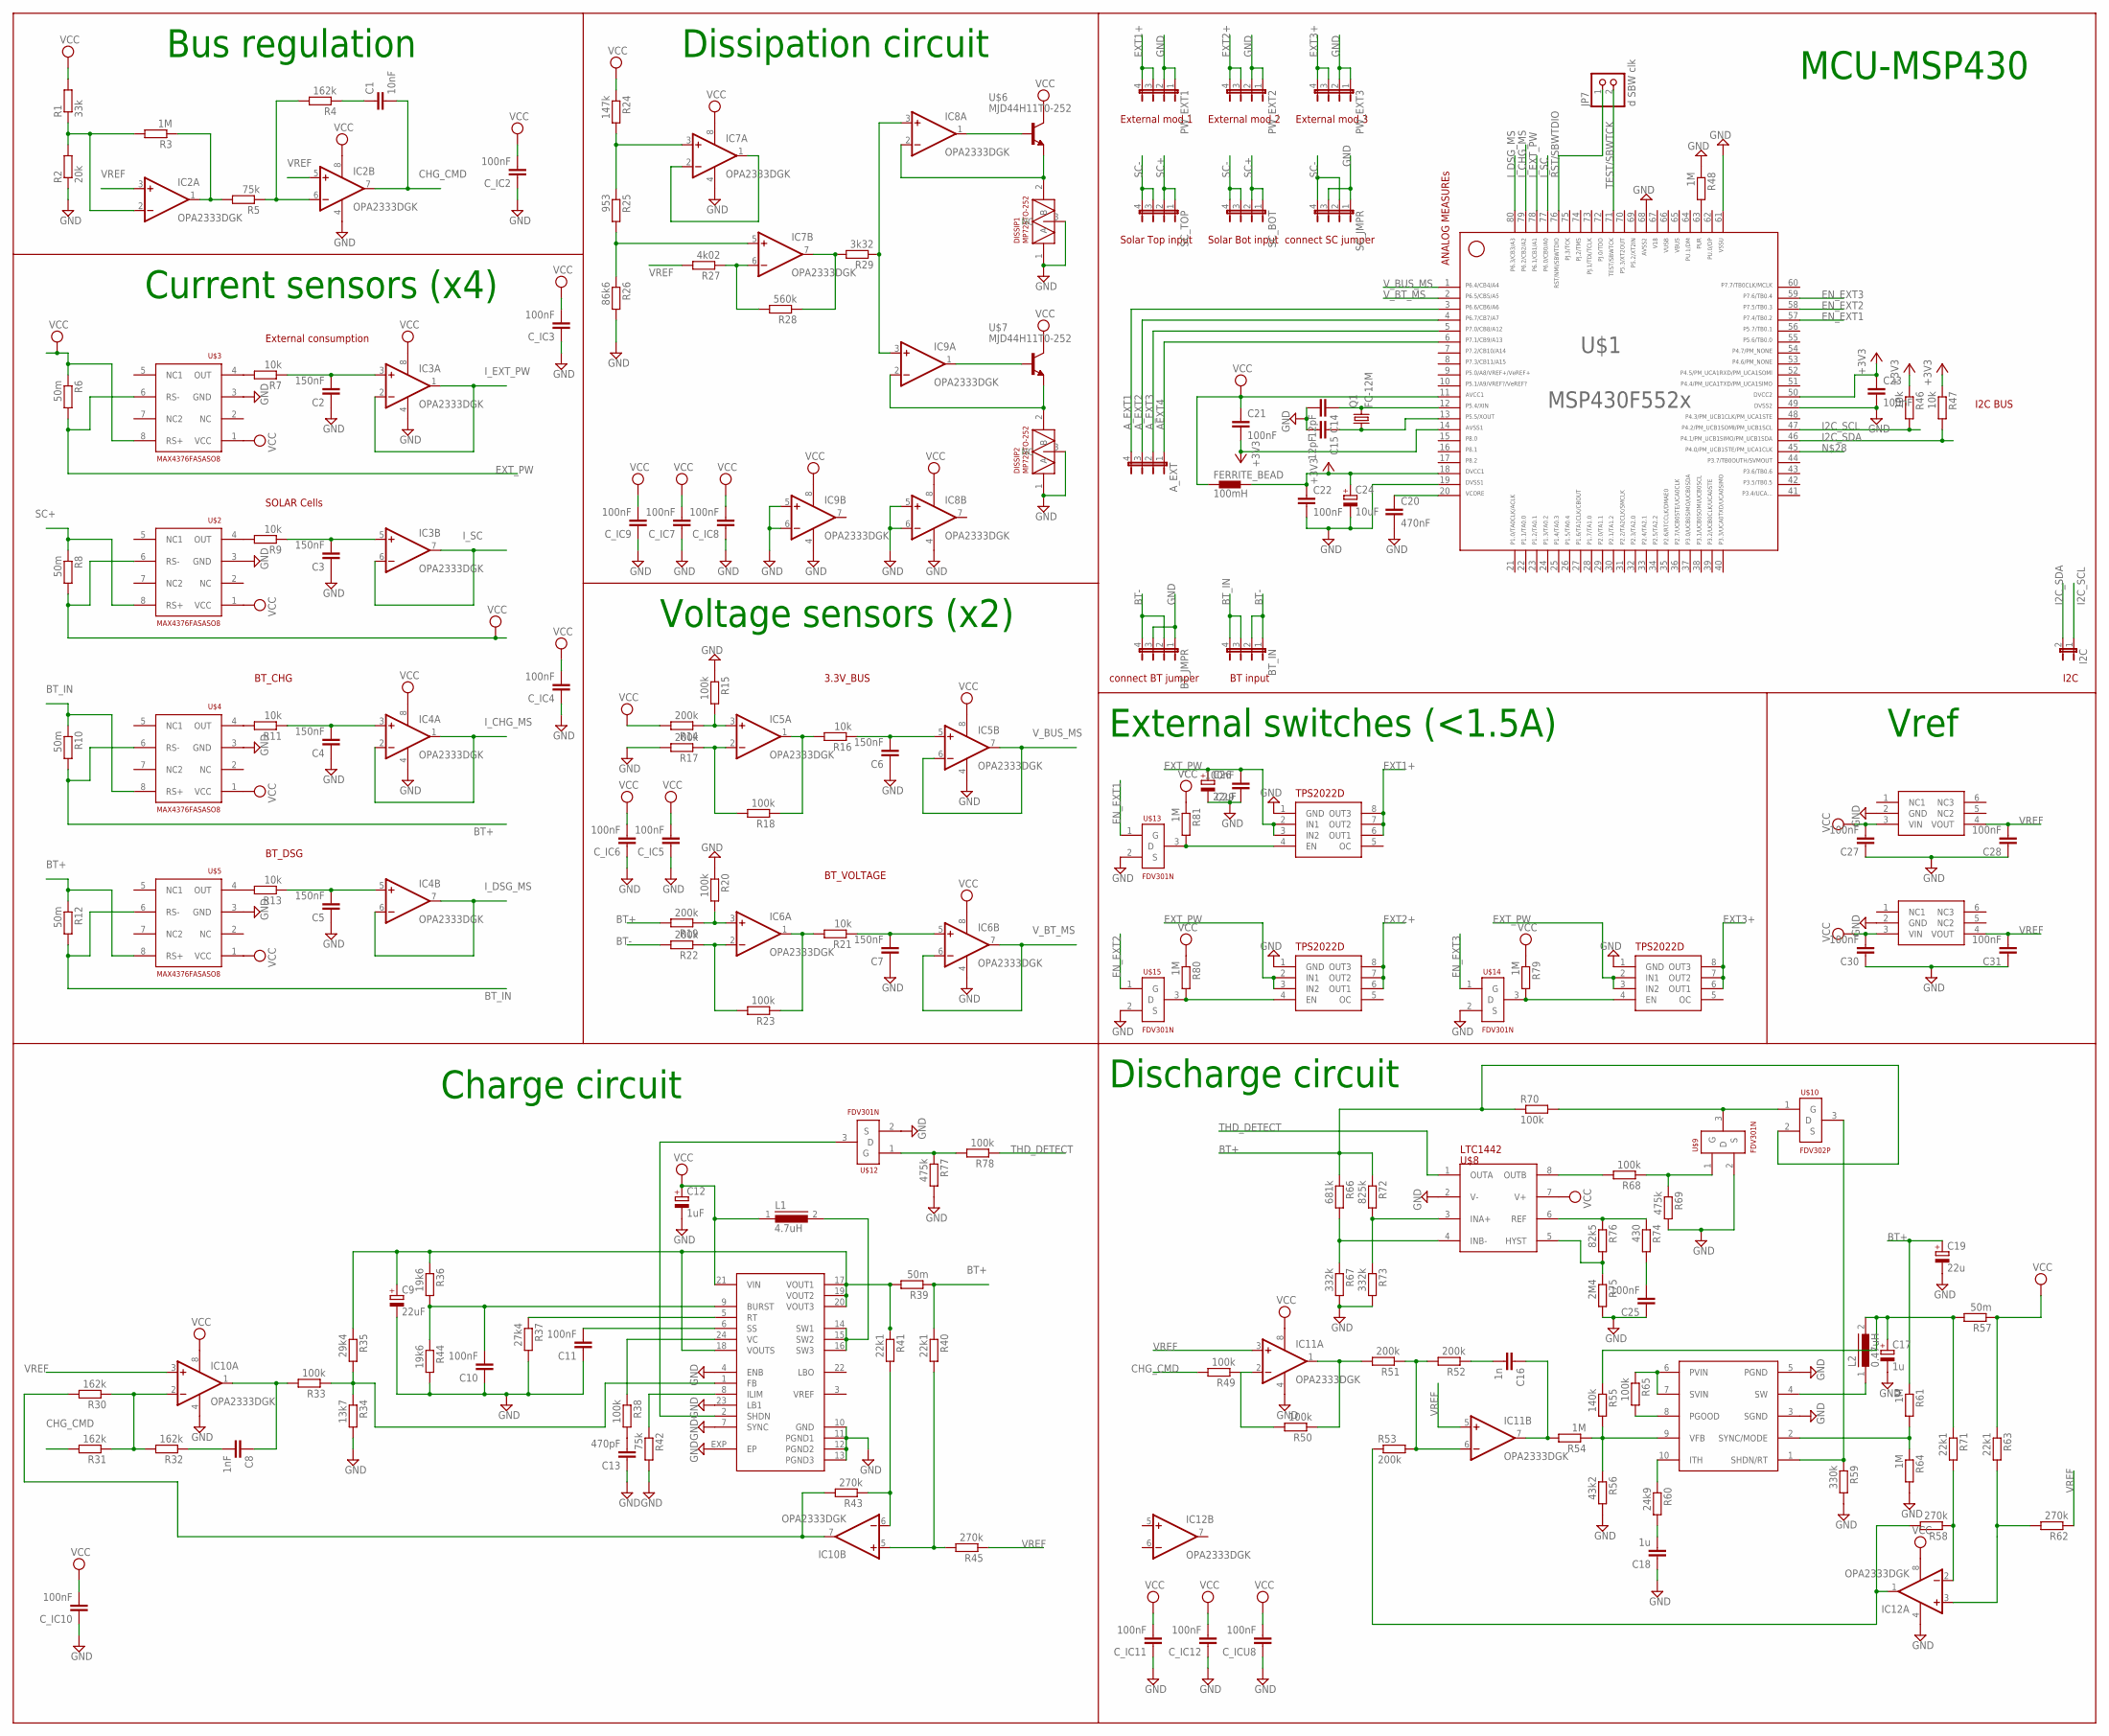
[picture p104: schematic octanis_eps.sch]

Parts:
A_EXT: JP4E; JP4
BT_IN: JP4E; JP4
BT_JMPR: JP4E; JP4
C1: 10nF; C0603
C2, C3, C4, C5, C6, C7: 150nF; C0603
C8: 1nF; C0603
C9, C26: 22uF; A/3216-18R
C10, C11, C21, C22, C23, C25, C27, C28, C29, C30, C31: 100nF; C0603
C12: 1uF; A/3216-18R
C13: 470pF; C0603
C14, C15: 12pF; C0603
C16: 1n; C0603
C17: 1u; A/3216-18R
C18: 1u; C0603
C19: 22u; A/3216-18R
C20: 470nF; C0603
C24: 10uF; A/3216-18R
C_IC2, C_IC3, C_IC4, C_IC5, C_IC6, C_IC7, C_IC8, C_IC9, C_IC10, C_IC11, C_IC12: 100nF; C0603
C_ICU8: 100nF; C0603
DISSIP1, DISSIP2: MP725TO-252; TO252
FERRITE_BEAD: 100mH; 0402
I2C: JP1E; JP1
IC2, IC3, IC4, IC5, IC6, IC7, IC8, IC9, IC10, IC11, IC12: OPA2333DGK; MSOP08
JP7: d SBW clk; 1X02
L1: 4.7uH; DR73
L2: 0.47uH; DR73
LTC3411: LT3411; MSOP10
PW_EXT1, PW_EXT2, PW_EXT3: JP4E; JP4
Q1: FC-12M
R1: 33k; R0603
R2: 20k; R0603
R3, R48, R54, R61, R64, R79, R80, R81: 1M; R0603
R4, R30, R31, R32: 162k; R0603
R5, R42: 75k; R0603
R6, R8, R10, R12, R39, R57: 50m; R1206
R7, R9, R11, R13, R16, R21, R46, R47: 10k; R0603
R14, R17, R19, R22, R51, R52, R53: 200k; R0603
R15, R18, R20, R23, R33, R38, R49, R50, R65, R68, R70, R78: 100k; R0603
R24: 147k; R0603
R25: 953; R0603
R26: 86k6; R0603
R27: 4k02; R0603
R28: 560k; R0603
R29: 3k32; R0603
R34: 13k7; R0603
R35: 29k4; R0603
R36, R44: 19k6; R0603
R37: 27k4; R0603
R40, R41, R63, R71: 22k1; R0603
R43, R45, R58, R62: 270k; R0603
R55: 140k; R0603
R56: 43k2; R0603
R59: 330k; R0603
R60: 24k9; R0603
R66: 681k; R0603
R67, R73: 332k; R0603
R69, R77: 475k; R0603
R72: 825k; R0603
R74: 430; R0603
R75: 2M4; R0603
R76: 82k5; R0603
SC_BOT: JP4E; JP4
SC_JMPR: JP4E; JP4
SC_TOP: JP4E; JP4
U$1: F552X---PN80; PN80
U$2, U$3, U$4, U$5: MAX4376FASASO8; SO8
U$6, U$7: MJD44H11T0-252; TO252
U$8: LTC1442; SO8
U$9, U$12, U$13, U$14, U$15: FDV301N; SOT23
U$10: FDV302P; SOT23
U$11: LTC3421; QFN24
U$16, U$17, U$18: TPS2022D; SO8
U$19, U$20: ADR127B; TSOT23-6

Connections:
65: U$1.65
66: U$1.66
67: U$1.67
+3V3: C21.2, C22.1, C23.1, C24.+, FERRITE_BEAD.2, R46.1, R47.1, U$1.14, U$1.18, U$1.50
AEXT4: A_EXT.1, U$1.6
A_EXT1: A_EXT.4, U$1.3
A_EXT2: A_EXT.3, U$1.4
A_EXT3: A_EXT.2, U$1.5
BT+: C19.+, R10.2, R12.1, R19.2, R39.1, R40.1, R61.1, R66.1, R70.1, R72.1, U$4.6 (RS-), U$5.8 (RS+), U$10.2 (S)
BT-: BT_IN.1, BT_IN.2, BT_JMPR.2, BT_JMPR.4, R22.2
BT_IN: BT_IN.3, BT_IN.4, R10.1, R12.2, U$4.8 (RS+), U$5.6 (RS-)
CHG_CMD: C1.2, IC2.7 (OUT), R31.2, R49.2
EN_EXT1: U$1.57, U$13.1 (G)
EN_EXT2: U$1.58, U$15.1 (G)
EN_EXT3: U$1.59, U$14.1 (G)
EXT1+: PW_EXT1.3, PW_EXT1.4, U$16.6 (OUT1), U$16.7 (OUT2), U$16.8 (OUT3)
EXT2+: PW_EXT2.3, PW_EXT2.4, U$17.6 (OUT1), U$17.7 (OUT2), U$17.8 (OUT3)
EXT3+: PW_EXT3.3, PW_EXT3.4, U$18.6 (OUT1), U$18.7 (OUT2), U$18.8 (OUT3)
EXT_PW: C26.+, C29.2, R6.2, U$3.6 (RS-), U$16.2 (IN1), U$16.3 (IN2), U$17.2 (IN1), U$17.3 (IN2), U$18.2 (IN1), U$18.3 (IN2)
GND: BT_JMPR.1, BT_JMPR.3, C2.1, C3.1, C4.1, C5.1, C6.1, C7.1, C9.-, C10.1, C11.1, C12.-, C13.1, C14.2, C15.2, C17.-, C18.1, C19.-, C20.2, C22.2, C23.2, C24.-, C25.1, C26.-, C27.1, C28.1, C29.1, C30.1, C31.1, C_IC2.1, C_IC3.1, C_IC4.1, C_IC5.1, C_IC6.1, C_IC7.1, C_IC8.1, C_IC9.1, C_IC10.1, C_IC11.1, C_IC12.1, C_ICU8.1, DISSIP1.1 (A), DISSIP1.3 (NC), DISSIP2.1 (A), DISSIP2.3 (NC), IC2.4 (V-), IC3.4 (V-), IC4.4 (V-), IC5.4 (V-), IC6.4 (V-), IC7.4 (V-), IC8.4 (V-), IC8.5 (+IN), IC8.6 (-IN), IC9.4 (V-), IC9.5 (+IN), IC9.6 (-IN), IC10.4 (V-), IC11.4 (V-), IC12.4 (V-), LTC3411.3 (SGND), LTC3411.5 (PGND), PW_EXT1.1, PW_EXT1.2, PW_EXT2.1, PW_EXT2.2, PW_EXT3.1, PW_EXT3.2, R2.1, R15.1, R17.2, R20.1, R26.2, R34.2, R37.2, R42.2, R44.2, R48.1, R56.2, R59.2, R64.2, R67.2, R69.2, R73.2, R75.2, R77.2, SC_JMPR.1, SC_JMPR.3, U$1.19, U$1.49, U$1.61, U$1.68, U$2.3 (GND), U$3.3 (GND), U$4.3 (GND), U$5.3 (GND), U$8.2 (V-), U$9.2 (S), U$11.4 (ENB), U$11.7 (SYNC), U$11.10 (GND), U$11.11 (PGND1), U$11.12 (PGND2), U$11.13 (PGND3), U$11.23 (LB1), U$11.EXP (EP), U$12.2 (S), U$13.2 (S), U$14.2 (S), U$15.2 (S), U$16.1 (GND), U$17.1 (GND), U$18.1 (GND), U$19.2 (GND), U$20.2 (GND)
I2C_SCL: I2C.1, R46.2, U$1.47
I2C_SDA: I2C.2, R47.2, U$1.46
I_CHG_MS: IC4.1 (OUT), IC4.2 (-IN), U$1.79
I_DSG_MS: IC4.6 (-IN), IC4.7 (OUT), U$1.80
I_EXT_PW: IC3.1 (OUT), IC3.2 (-IN), U$1.78
I_SC: IC3.6 (-IN), IC3.7 (OUT), U$1.77
unnamed: IC2.2 (-IN), R1.1, R2.2, R3.2
unnamed: IC2.1 (OUT), R3.1, R5.2
unnamed: C1.1, R4.1
unnamed: IC2.6 (-IN), R4.2, R5.1
unnamed: C4.2, IC4.3 (+IN), R11.1
unnamed: C2.2, IC3.3 (+IN), R7.1
unnamed: C3.2, IC3.5 (+IN), R9.1
unnamed: C5.2, IC4.5 (+IN), R13.1
unnamed: C7.2, IC6.5 (+IN), R21.1
unnamed: IC6.1 (OUT), R21.2, R23.1
unnamed: C6.2, IC5.5 (+IN), R16.1
unnamed: IC5.1 (OUT), R16.2, R18.1
unnamed: IC5.2 (-IN), R17.1, R18.2
unnamed: IC5.3 (+IN), R14.1, R15.2
unnamed: IC6.2 (-IN), R22.1, R23.2
unnamed: IC6.3 (+IN), R19.1, R20.2
unnamed: IC7.1 (OUT), IC7.2 (-IN)
unnamed: IC7.3 (+IN), R24.2, R25.1
unnamed: IC7.5 (+IN), R25.2, R26.1
unnamed: IC7.6 (-IN), R27.1, R28.2
unnamed: IC7.7 (OUT), R28.1, R29.2
unnamed: IC8.3 (+IN), IC9.3 (+IN), R29.1
unnamed: IC10.2 (-IN), R30.1, R31.1, R32.2
unnamed: C8.2, R32.1
unnamed: C8.1, IC10.1 (OUT), R33.2
unnamed: R33.1, R34.1, R35.2, U$11.1 (FB)
unnamed: R48.2, U$1.63
unnamed: R42.1, U$11.8 (ILIM)
unnamed: C10.2, R36.2, R44.1, U$11.9 (BURST)
unnamed: C13.2, R38.2
unnamed: R37.1, U$11.5 (RT)
unnamed: C11.2, U$11.6 (SS)
unnamed: R80.2, U$15.3 (D), U$17.4 (EN)
unnamed: C18.2, R60.2
unnamed: R38.1, U$11.24 (VC)
unnamed: U$11.2 (SHDN), U$12.3 (D)
unnamed: IC10.5 (+IN), R40.2, R45.2
unnamed: IC10.6 (-IN), R41.2, R43.1
unnamed: R9.2, U$2.4 (OUT)
unnamed: R11.2, U$4.4 (OUT)
unnamed: R7.2, U$3.4 (OUT)
unnamed: R13.2, U$5.4 (OUT)
unnamed: IC8.1 (OUT), U$6.1 (B)
unnamed: IC9.1 (OUT), U$7.1 (B)
unnamed: DISSIP2.2 (B), IC9.2 (-IN), U$7.3 (E)
unnamed: DISSIP1.2 (B), IC8.2 (-IN), U$6.3 (E)
unnamed: C14.1, Q1.2, U$1.12
unnamed: C20.1, U$1.20
unnamed: C15.1, Q1.1, U$1.13
unnamed: C16.1, IC11.7 (OUT), R54.2
unnamed: IC11.2 (-IN), R49.1, R50.2
unnamed: IC11.1 (OUT), R50.1, R51.2
unnamed: IC11.6 (-IN), R51.1, R52.2, R53.2
unnamed: C16.2, R52.1
unnamed: IC12.1 (OUT), R53.1, R58.2
unnamed: LTC3411.9 (VFB), R54.1, R55.2, R56.1
unnamed: C17.+, L2.2, R55.1, R57.2, R71.1
unnamed: LTC3411.10 (ITH), R60.1
unnamed: LTC3411.2 (SYNC/MODE), R61.2, R64.1
unnamed: IC12.2 (-IN), R58.1, R71.2
unnamed: IC12.3 (+IN), R62.2, R63.2
unnamed: LTC3411.8 (PGOOD), R65.2
unnamed: LTC3411.6 (PVIN), LTC3411.7 (SVIN), R65.1
unnamed: LTC3411.1 (SHDN/RT), R59.1, U$10.3 (D)
unnamed: R66.2, R67.1, U$8.4 (INB-)
unnamed: R68.2, U$8.8 (OUTB)
unnamed: R68.1, R69.1, U$9.1 (G)
unnamed: R72.2, R73.1, U$8.3 (INA+)
unnamed: R70.2, U$9.3 (D), U$10.1 (G)
unnamed: R74.1, R76.1, U$8.6 (REF)
unnamed: R75.1, R76.2, U$8.5 (HYST)
unnamed: C25.2, R74.2
unnamed: C9.+, R35.1, R36.1, R39.2, R41.1, U$11.17 (VOUT1), U$11.18 (VOUTS), U$11.19 (VOUT2), U$11.20 (VOUT3)
unnamed: R77.1, R78.2, U$12.1 (G)
unnamed: L2.1, LTC3411.4 (SW)
unnamed: L1.2, U$11.14 (SW1), U$11.15 (SW2), U$11.16 (SW3)
unnamed: R81.2, U$13.3 (D), U$16.4 (EN)
unnamed: R79.2, U$14.3 (D), U$18.4 (EN)
RST/SBWTDIO: JP7.1, U$1.76
SC+: R8.1, SC_BOT.1, SC_BOT.2, SC_TOP.1, SC_TOP.2, U$2.8 (RS+)
SC-: SC_BOT.3, SC_BOT.4, SC_JMPR.2, SC_JMPR.4, SC_TOP.3, SC_TOP.4
TEST/SBWTCK: JP7.2, U$1.71
THD_DETECT: R78.1, U$8.1 (OUTA)
UUU: IC10.7 (OUT), R30.2, R43.2
VCC: C12.+, C21.1, C27.2, C30.2, C_IC2.2, C_IC3.2, C_IC4.2, C_IC5.2, C_IC6.2, C_IC7.2, C_IC8.2, C_IC9.2, C_IC10.2, C_IC11.2, C_IC12.2, C_ICU8.2, FERRITE_BEAD.1, IC2.8 (V+), IC3.8 (V+), IC4.8 (V+), IC5.8 (V+), IC6.8 (V+), IC7.8 (V+), IC8.8 (V+), IC9.8 (V+), IC10.8 (V+), IC11.8 (V+), IC12.8 (V+), L1.1, R1.2, R6.1, R8.2, R14.2, R24.1, R57.1, R63.1, R79.1, R80.1, R81.1, U$1.11, U$2.1 (VCC), U$2.6 (RS-), U$3.1 (VCC), U$3.8 (RS+), U$4.1 (VCC), U$5.1 (VCC), U$6.2 (C), U$7.2 (C), U$8.7 (V+), U$11.21 (VIN), U$19.3 (VIN), U$20.3 (VIN)
VREF: C28.2, C31.2, IC2.3 (+IN), IC2.5 (+IN), IC10.3 (+IN), IC11.3 (+IN), IC11.5 (+IN), R27.2, R45.1, R62.1, U$19.4 (VOUT), U$20.4 (VOUT)
V_BT_MS: IC6.6 (-IN), IC6.7 (OUT), U$1.2
V_BUS_MS: IC5.6 (-IN), IC5.7 (OUT), U$1.1

Notes on the sheet:
Bus regulation
Vref
Current sensors (x4)
SOLAR Cells
3.3V_BUS
Charge circuit
Discharge circuit
External switches (<1.5A)
MCU-MSP430
BT_CHG
BT_DSG
Voltage sensors (x2)
BT_VOLTAGE
Dissipation circuit
I2C BUS
ANALOG MEASUREs
connect BT jumper
BT input
Solar Bot input
Solar Top input
External mod 2
External mod 1
I2C
External mod 3
External consumption
connect SC jumper

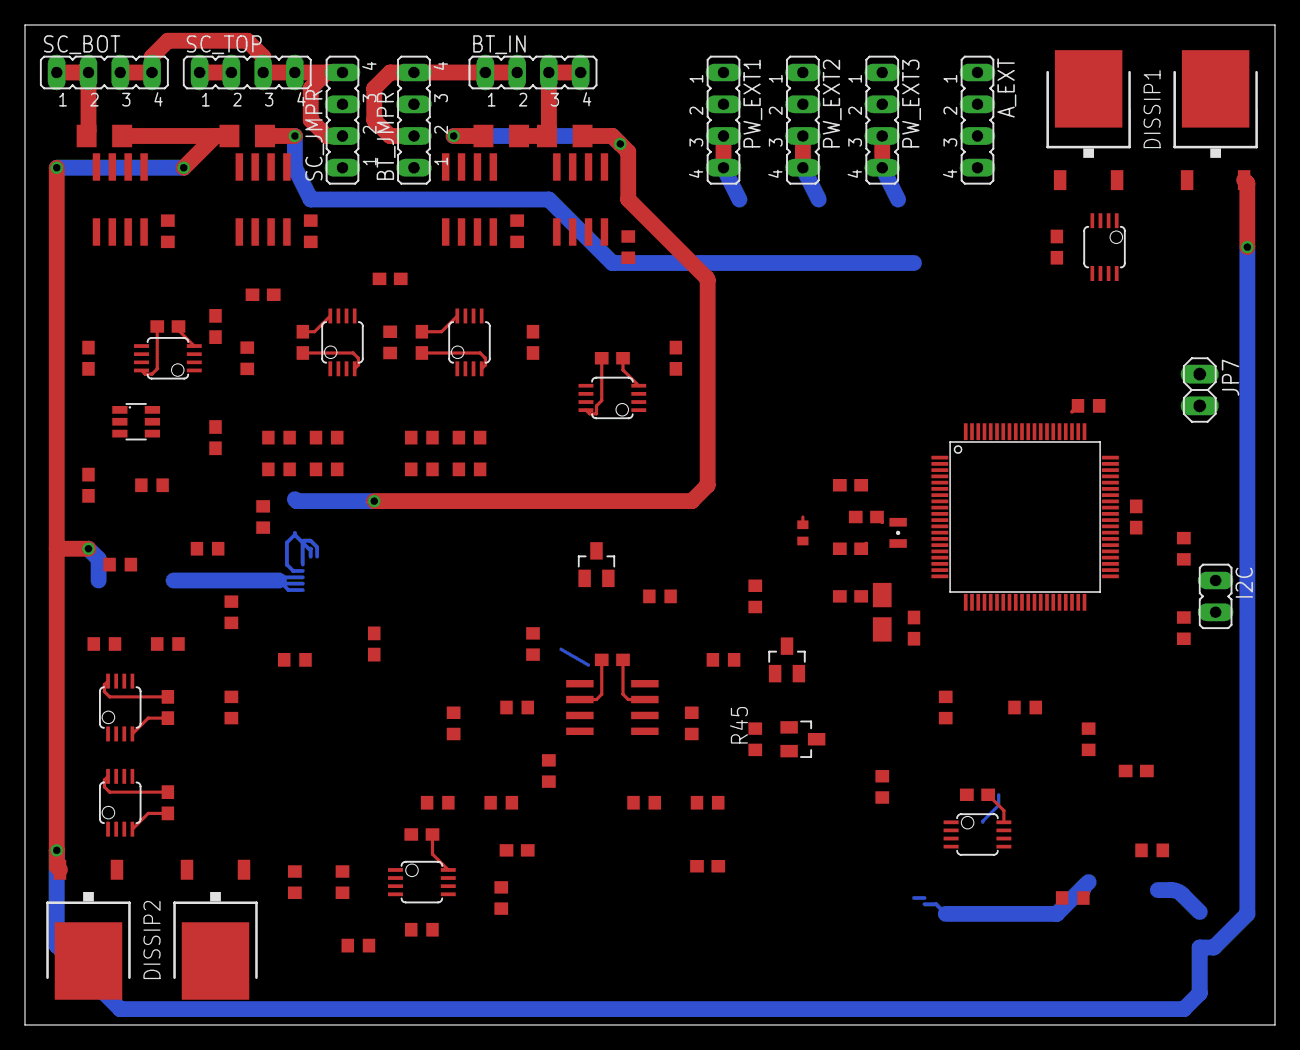
[picture p105: board octanis_eps.brd from above]

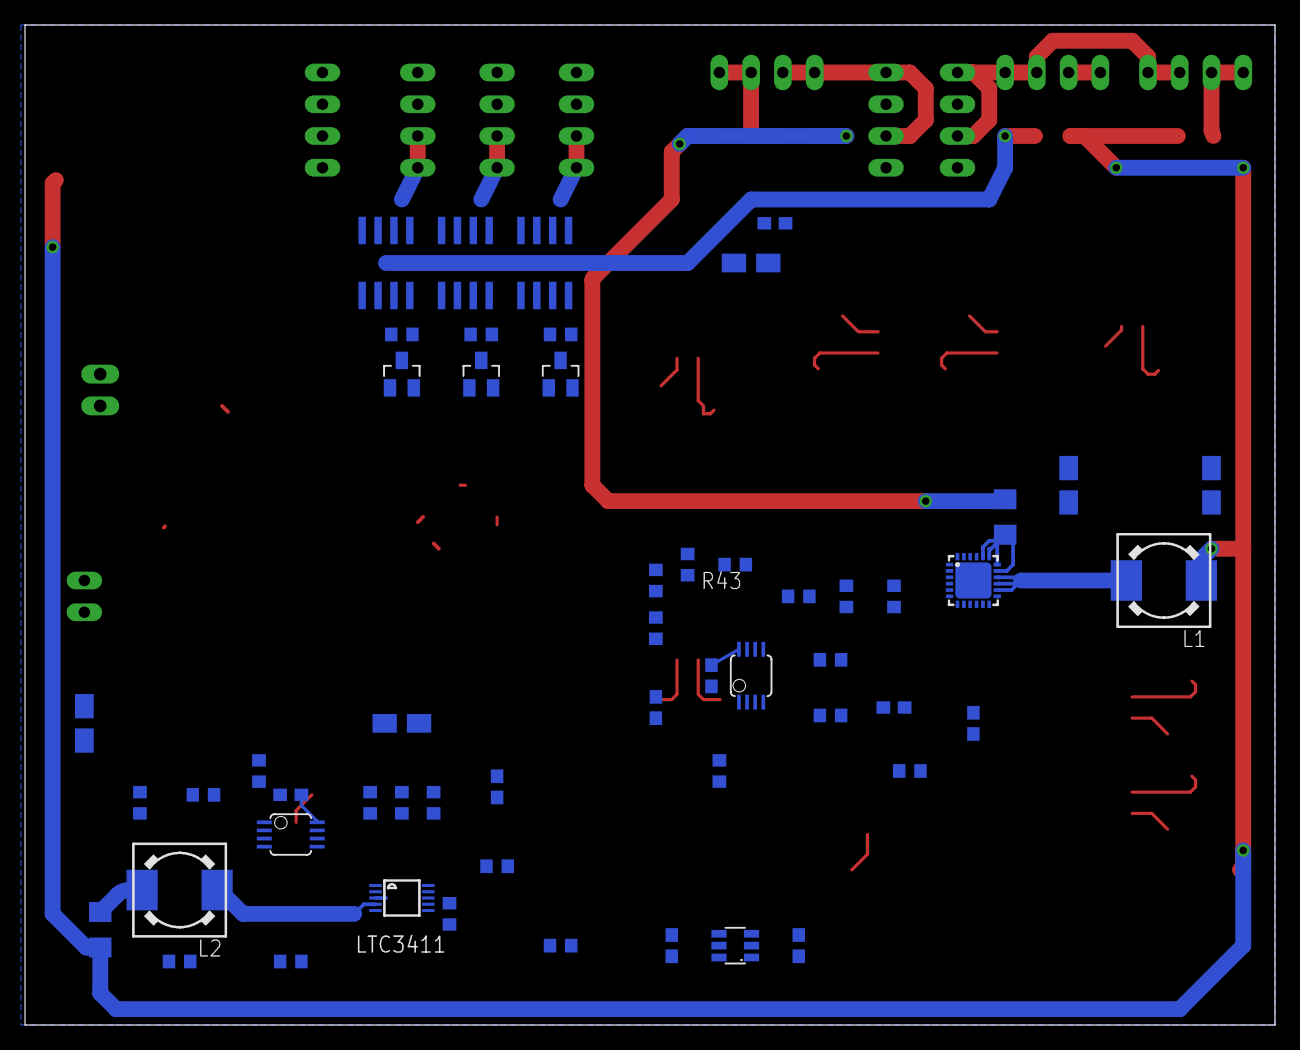
[picture p106: board octanis_eps.brd from below]

Board: 2 copper layers, 100.0 x 80.0 mm, 173 parts (54 on the bottom side), 111 nets.
