Octanis1/Octanis1-Electronics/octanis_main_pcb_v0.2/octanis_v0.2.brd

## EAGLE design octanis_main_pcb_v0.2/octanis_v0.2.brd (2014-08-10, an earlier design)

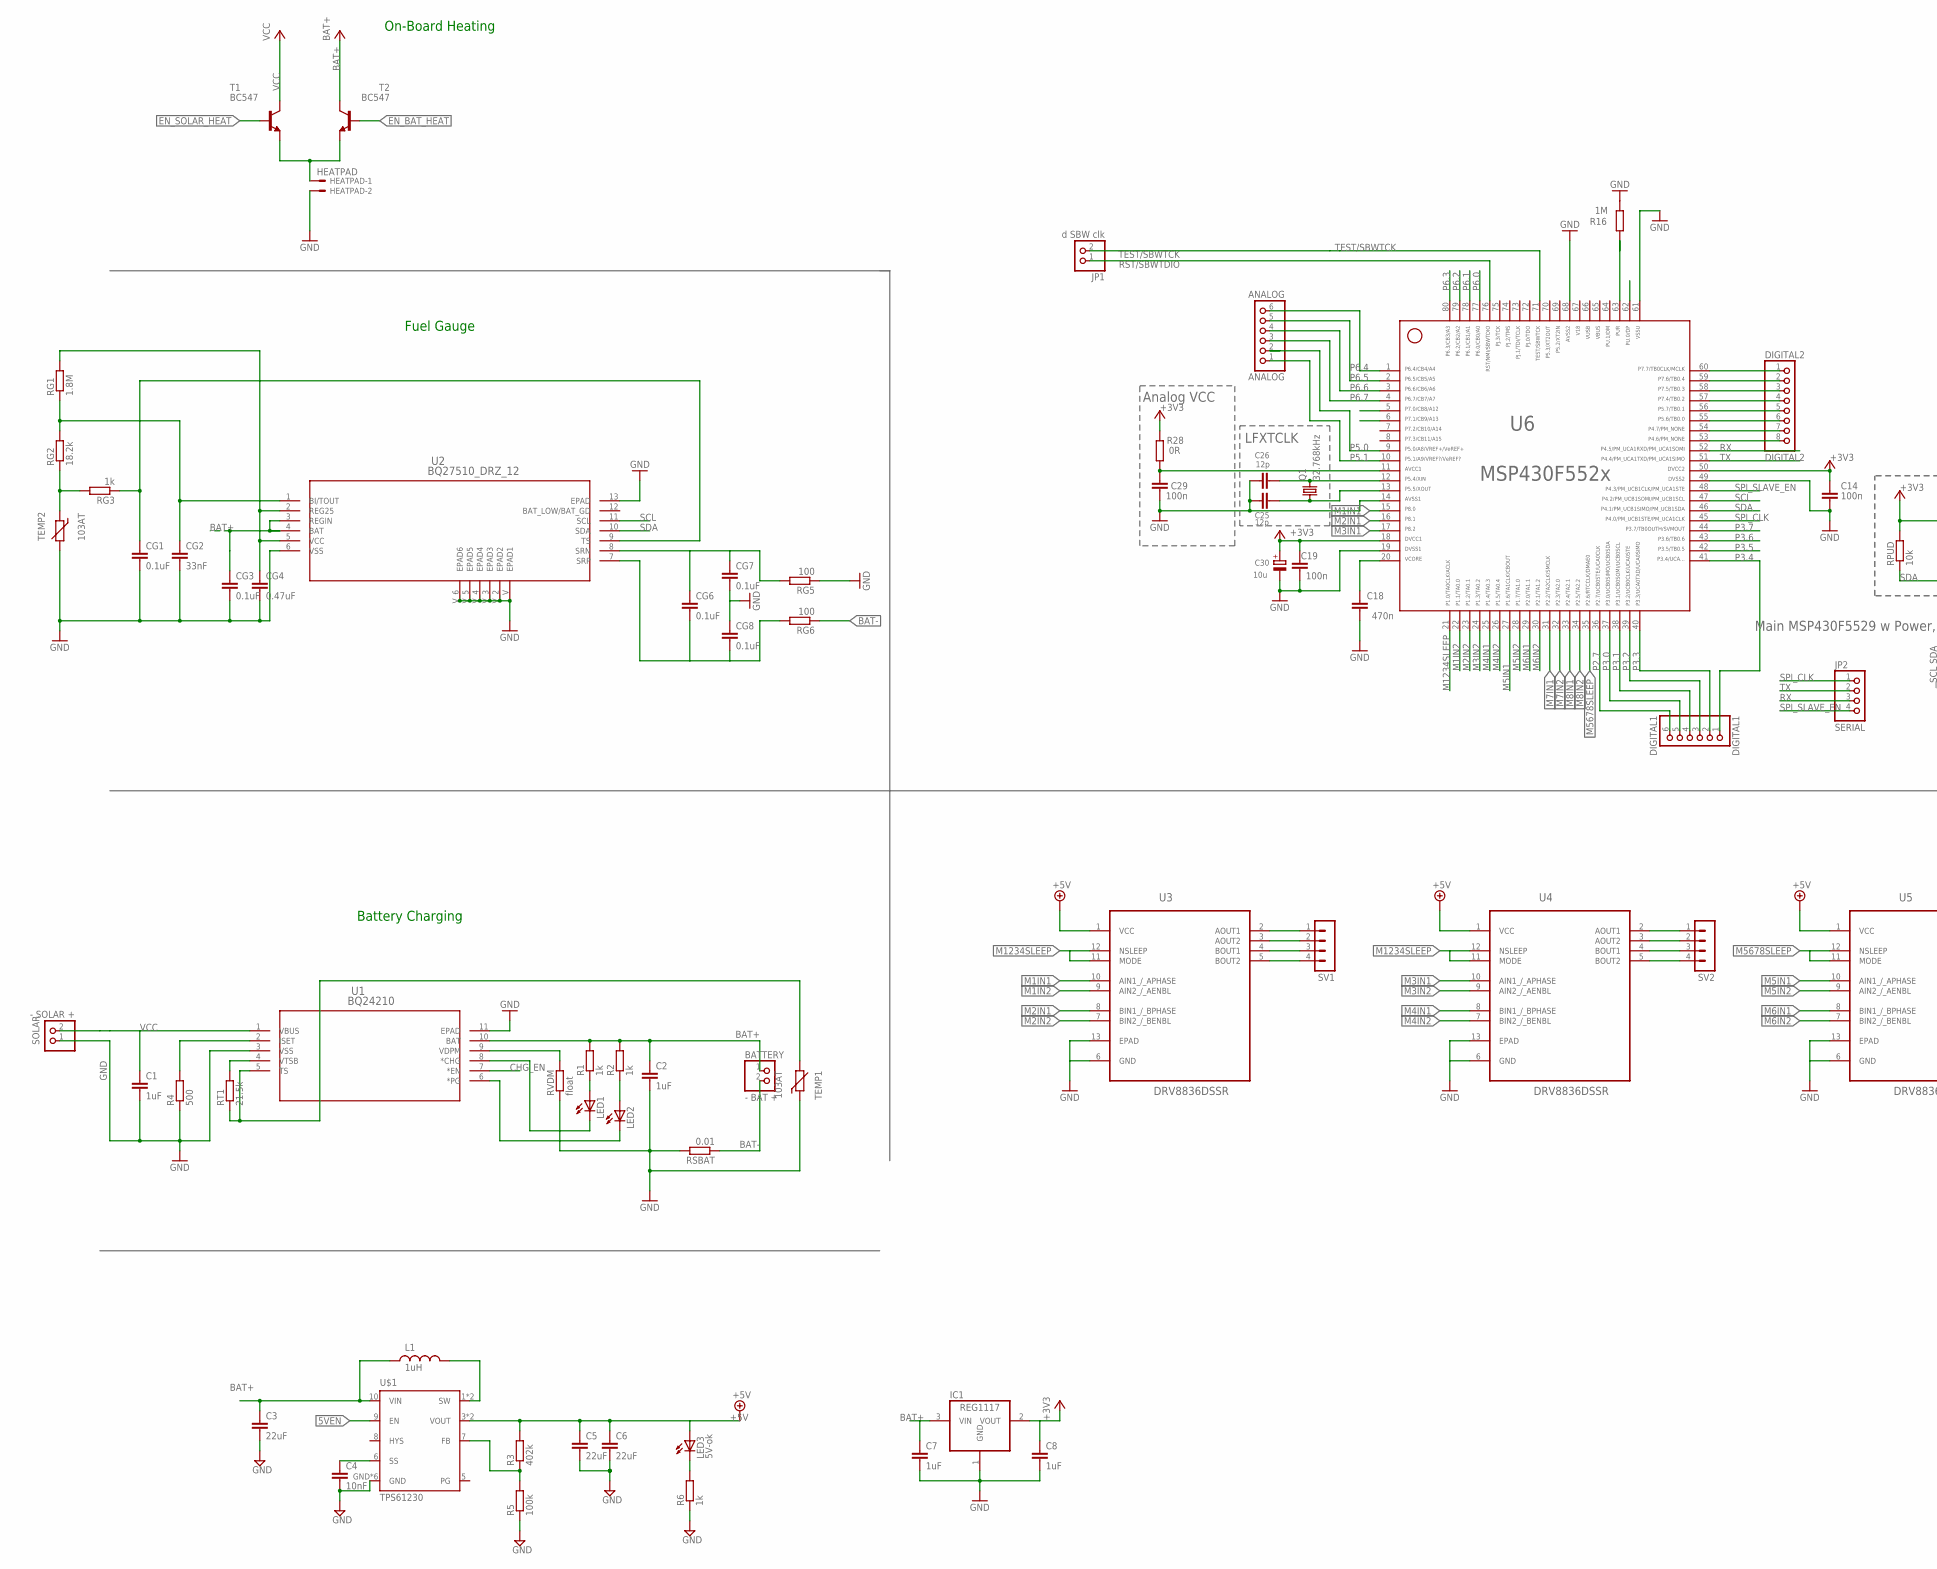
[picture p107: schematic octanis_v0.2.sch, part in row 1, column 1]

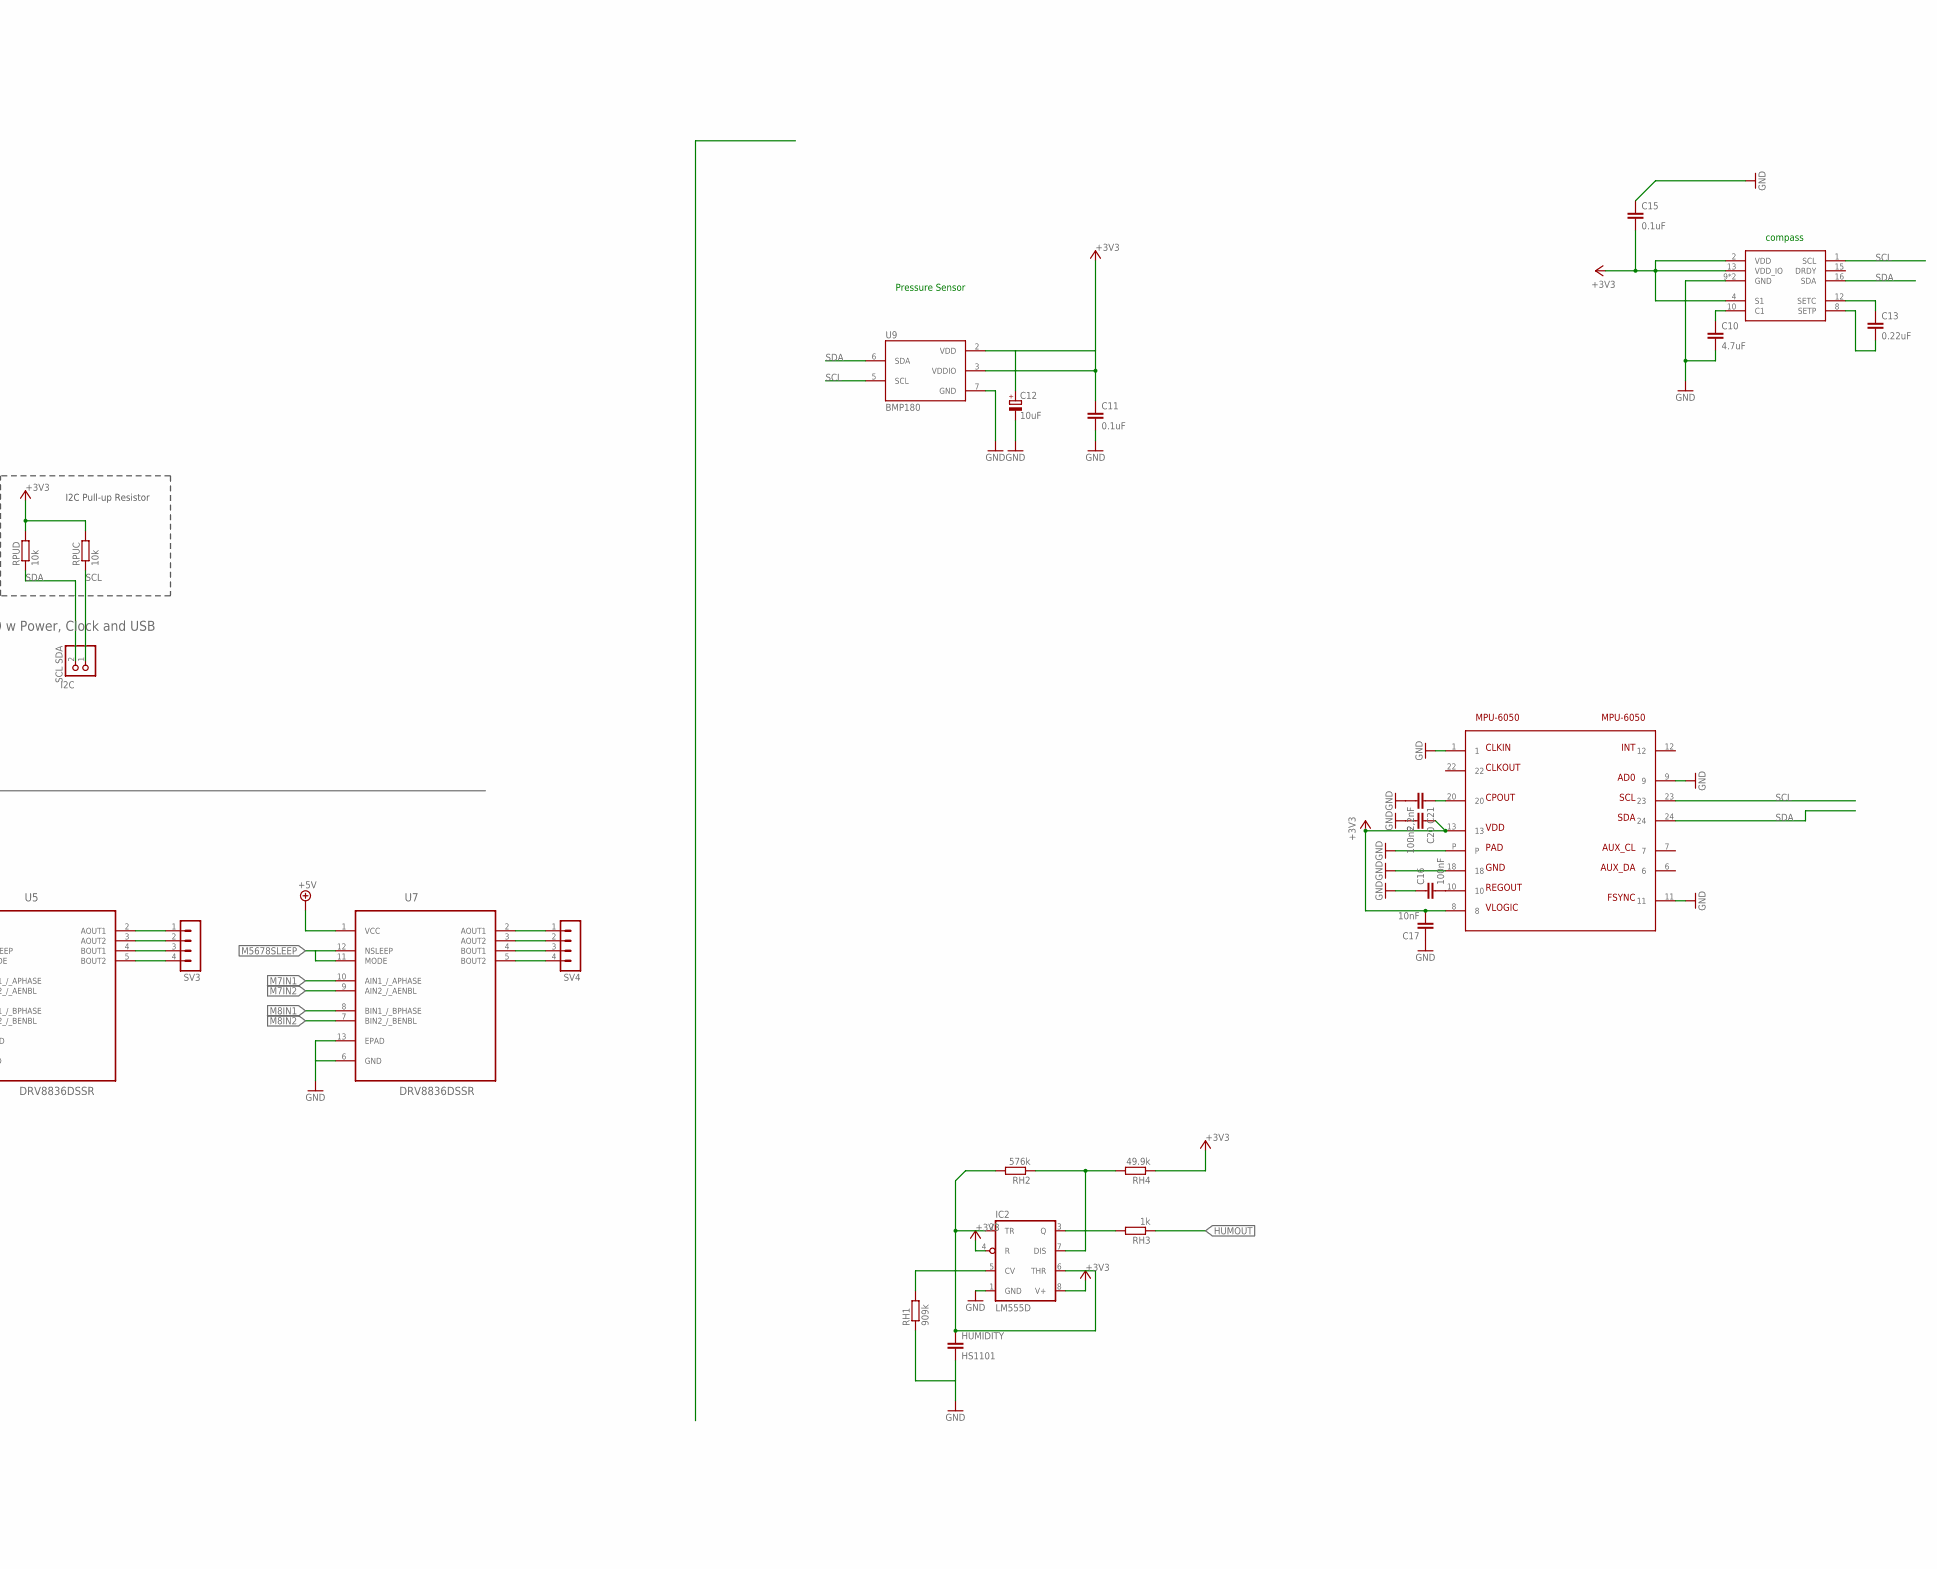
[picture p108: schematic octanis_v0.2.sch, part in row 1, column 2]

Parts:
ANALOG: ANALOG; 1X06
BATTERY: - BAT +; 1X02
C1, C2: 1uF; C1206
C3, C5, C6: 22uF; C0603
C4, C17: 10nF; C0603
C7, C8: 1uF; C0603
C10: 4.7uF; C0603
C11, C15: 0.1uF; C0603
C12: 10uF; A/3216-18R
C13: 0.22uF; C0603
C14, C19, C29: 100n; C0603
C16, C20: 100nF; C0603
C18: 470n; C0603
C21: 2,2nF; C0603
C25, C26: 12p; C0603
C30: 10u; A/3216-18R
CG1, CG3, CG6, CG7, CG8: 0.1uF; C0603
CG2: 33nF; C0603
CG4: 0.47uF; C0603
COMPASS: HMC5883L; LPCC16
DIGITAL1: DIGITAL1; 1X06
DIGITAL2: DIGITAL2; 1X08
HEATPAD: HEATPAD; 22-23-2021
HUMIDITY: HS1101; C025-024X044
I2C: SCL SDA; 1X02
IC1: REG1117; SOT223
IC2: LM555D; SO08
JP1: d SBW clk; 1X02
JP2: SERIAL; 1X04
L1: 1uH; XFL4020
LED1, LED2: LEDCHIP-LED0603; CHIP-LED0603
LED3: 5V-ok; CHIPLED_0603
MPU-6050: MPU-6050; QFN24
Q1: 32.768kHz; FC-12M
R1, R2, R6: 1k; R0603
R3: 402k; R0603
R4: 500; R1206
R5: 100k; R0603
R16: 1M; R0603
R28: 0R; R0603
RG1: 1.8M; R0603
RG2: 18.2k; R0603
RG3: 1k; R0603
RG5, RG6: 100; R0603
RH1: 909k; R0603
RH2: 576k; R0603
RH3: 1k; R0603
RH4: 49.9k; R0603
RPUC: 10k; R0603
RPUD: 10k; R0603
RSBAT: 0.01; R1206
RT1: 21.5k; R1206
RVDM: float; R1206
SOLAR: - SOLAR +; 1X02
SV1, SV2, SV3, SV4: MA04-1
T1, T2: BC547; TO92
TEMP1, TEMP2: 103AT; RS-2,5
U1: BQ24210; DQC10_P84X2P4
U2: BQ27510_DRZ_12; DRZ12_1P95X2P45
U3, U4, U5, U7: DRV8836DSSR; SON50P200X300X80-13N
U6: MSP430F5529IPNR; PN80
U9: BMP180
U$1: TPS61230; DRC-S-PVSON-N11

Connections:
5VEN: U6.6, U$1.9 (EN)
65: U6.65
66: U6.66
67: U6.67
+3V3: C8.1, C11.1, C12.+, C14.1, C15.2, C17.2, C19.2, C20.1, C30.+, COMPASS.2 (VDD), COMPASS.4 (S1), COMPASS.13 (VDD_IO), IC1.2 (VOUT), IC2.4 (R), IC2.8 (V+), MPU-6050.8, MPU-6050.13, R28.2, RH4.1, RPUC.2, RPUD.2, U6.18, U6.50, U9.2 (VDD), U9.3 (VDDIO)
+5V: C5.1, C6.1, LED3.A, R3.2, U3.1 (VCC), U4.1 (VCC), U5.1 (VCC), U7.1 (VCC), U$1.3 (VOUT), U$1.4 (VOUT)
AVCC: C29.1, R28.1, U6.11
BAT+: BATTERY.1, C2.1, C3.1, C7.1, CG3.1, IC1.3 (VIN), L1.P$1 (1), R1.2, R2.2, T2.3 (C), U1.10 (BAT), U2.3 (REGIN), U2.4 (BAT), U$1.10 (VIN)
BAT-: BATTERY.2, RG6.1, RSBAT.1
CHG_EN: U1.7 (*EN), U6.5
EN_BAT_HEAT: T2.2 (B)
EN_SOLAR_HEAT: T1.2 (B)
GND: C1.2, C2.2, C3.2, C4.2, C5.2, C6.2, C7.2, C8.2, C10.2, C11.2, C12.-, C14.2, C15.1, C16.1, C17.1, C18.1, C19.1, C20.2, C21.2, C25.1, C26.1, C29.2, C30.-, CG1.2, CG2.2, CG3.2, CG4.2, CG7.2, CG8.1, COMPASS.9 (GND), COMPASS.11 (GND), HEATPAD.2, HUMIDITY.2, IC1.1 (GND), IC2.1 (GND), MPU-6050.1, MPU-6050.9, MPU-6050.11, MPU-6050.18, MPU-6050.P, R4.1, R5.1, R6.1, R16.1, RG5.1, RH1.1, RSBAT.2, RVDM.1, SOLAR.1, TEMP1.1, TEMP2.2, U1.3 (VSS), U1.11 (EPAD), U2.6 (VSS), U2.13 (EPAD), U2.V (EPAD1), U2.V_2 (EPAD2), U2.V_3 (EPAD3), U2.V_4 (EPAD4), U2.V_5 (EPAD5), U2.V_6 (EPAD6), U3.6 (GND), U3.13 (EPAD), U4.6 (GND), U4.13 (EPAD), U5.6 (GND), U5.13 (EPAD), U6.14, U6.19, U6.49, U6.61, U6.68, U7.6 (GND), U7.13 (EPAD), U9.7 (GND), U$1.GND, U$1.GND@1 (GND), U$1.GND@2 (GND), U$1.GND@3 (GND), U$1.GND@4 (GND), U$1.GND@5 (GND)
HUMOUT: RH3.1
IND: L1.P$2 (2), U$1.1 (SW), U$1.2 (SW)
M1IN1: U3.10 (AIN1_/_APHASE), U6.15
M1IN2: U3.9 (AIN2_/_AENBL), U6.22
M2IN1: U3.8 (BIN1_/_BPHASE), U6.16
M2IN2: U3.7 (BIN2_/_BENBL), U6.23
M3IN1: U4.10 (AIN1_/_APHASE), U6.17
M3IN2: U4.9 (AIN2_/_AENBL), U6.24
M4IN1: U4.8 (BIN1_/_BPHASE), U6.25
M4IN2: U4.7 (BIN2_/_BENBL), U6.26
M5IN1: U5.10 (AIN1_/_APHASE), U6.27
M5IN2: U5.9 (AIN2_/_AENBL), U6.28
M6IN1: U5.8 (BIN1_/_BPHASE), U6.29
M6IN2: U5.7 (BIN2_/_BENBL), U6.30
M7IN1: U6.31, U7.10 (AIN1_/_APHASE)
M7IN2: U6.32, U7.9 (AIN2_/_AENBL)
M8IN1: U6.33, U7.8 (BIN1_/_BPHASE)
M8IN2: U6.34, U7.7 (BIN2_/_BENBL)
M1234SLEEP: U3.11 (MODE), U3.12 (NSLEEP), U4.11 (MODE), U4.12 (NSLEEP), U6.21
M5678SLEEP: U5.11 (MODE), U5.12 (NSLEEP), U6.35, U7.11 (MODE), U7.12 (NSLEEP)
unnamed: CG2.1, RG1.1, RG2.2, U2.1 (BI/TOUT)
unnamed: LED1.A, R1.1
unnamed: LED2.A, R2.1
unnamed: LED1.C, U1.8 (*CHG)
unnamed: LED2.C, U1.6 (*PG)
unnamed: RVDM.2, U1.9 (VDPM)
unnamed: RT1.1, TEMP1.2, U1.5 (TS)
unnamed: RT1.2, U1.4 (VTSB)
unnamed: R4.2, U1.2 (ISET)
unnamed: SV2.1, U4.2 (AOUT1)
unnamed: DIGITAL2.1, U6.60
unnamed: DIGITAL2.2, U6.59
unnamed: C10.1, COMPASS.10 (C1)
unnamed: C16.2, MPU-6050.10
unnamed: C21.1, MPU-6050.20
unnamed: DIGITAL2.3, U6.58
unnamed: DIGITAL2.4, U6.57
unnamed: DIGITAL2.5, U6.56
unnamed: DIGITAL2.6, U6.55
unnamed: DIGITAL2.7, U6.54
unnamed: C13.2, COMPASS.8 (SETP)
unnamed: DIGITAL2.8, U6.53
unnamed: IC2.5 (CV), RH1.2
unnamed: HUMIDITY.1, IC2.2 (TR), IC2.6 (THR), RH2.2
unnamed: IC2.7 (DIS), RH2.1, RH4.2
unnamed: IC2.3 (Q), RH3.2
unnamed: C13.1, COMPASS.12 (SETC)
unnamed: RG2.1, RG3.2, TEMP2.1
unnamed: CG1.1, RG3.1, U2.9 (TS)
unnamed: CG4.1, RG1.2, U2.2 (REG25), U2.5 (VCC)
unnamed: CG6.1, CG7.1, RG5.2, U2.8 (SRN)
unnamed: HEATPAD.1, T1.1 (E), T2.1 (E)
unnamed: CG6.2, CG8.2, RG6.2, U2.7 (SRP)
unnamed: SV2.2, U4.3 (AOUT2)
unnamed: SV2.3, U4.4 (BOUT1)
unnamed: SV2.4, U4.5 (BOUT2)
unnamed: C4.1, U$1.6 (SS)
unnamed: R3.1, R5.2, U$1.7 (FB)
unnamed: LED3.C, R6.2
unnamed: SV3.1, U5.2 (AOUT1)
unnamed: SV3.2, U5.3 (AOUT2)
unnamed: SV3.3, U5.4 (BOUT1)
unnamed: SV3.4, U5.5 (BOUT2)
unnamed: SV1.1, U3.2 (AOUT1)
unnamed: SV1.2, U3.3 (AOUT2)
unnamed: SV1.3, U3.4 (BOUT1)
unnamed: SV1.4, U3.5 (BOUT2)
unnamed: SV4.1, U7.2 (AOUT1)
unnamed: SV4.2, U7.3 (AOUT2)
unnamed: SV4.3, U7.4 (BOUT1)
unnamed: SV4.4, U7.5 (BOUT2)
P2.7: DIGITAL1.6, U6.36
P3.0: DIGITAL1.5, U6.37
P3.1: DIGITAL1.4, U6.38
P3.2: DIGITAL1.3, U6.39
P3.3: DIGITAL1.2, U6.40
P3.4: DIGITAL1.1, U6.41
P3.5: U6.42
P3.6: U6.43
P3.7: U6.44
P5.0: ANALOG.2, U6.9
P5.1: ANALOG.1, U6.10
P5.4/XIN: C26.2, Q1.2, U6.12
P5.5/XOUT: C25.2, Q1.1, U6.13
P6.0: U6.77
P6.1: U6.78
P6.2: U6.79
P6.3: U6.80
P6.4: ANALOG.6, U6.1
P6.5: ANALOG.5, U6.2
P6.6: ANALOG.4, U6.3
P6.7: ANALOG.3, U6.4
PG: U$1.5 (PG)
RST/SBWTDIO: JP1.1, U6.76
RX: JP2.3, U6.52
SCL: COMPASS.1 (SCL), I2C.1, MPU-6050.23, RPUC.1, U2.11 (SCL), U6.47, U9.5 (SCL)
SDA: COMPASS.16 (SDA), I2C.2, MPU-6050.24, RPUD.1, U2.10 (SDA), U6.46, U9.6 (SDA)
SPI_CLK: JP2.1, U6.45
SPI_SLAVE_EN: JP2.4, U6.48
TARGET_DP: U6.62
TARGET_PUR: R16.2, U6.63
TEST/SBWTCK: JP1.2, U6.71
TX: JP2.2, U6.51
VCC: C1.1, SOLAR.2, T1.3 (C), U1.1 (VBUS)
VCORE: C18.2, U6.20

Notes on the sheet:
Battery Charging
Fuel Gauge
LFXTCLK
Main MSP430F5529 w Power, Clock and USB
Analog VCC
I2C Pull-up Resistor
On-Board Heating
Pressure Sensor
compass
