Octanis1/Octanis1-Electronics/octanis_main_pcb_v0.2/octanis_v0.2.brd

## EAGLE design octanis_main_pcb_v0.2/octanis_v0.2.brd (continued)

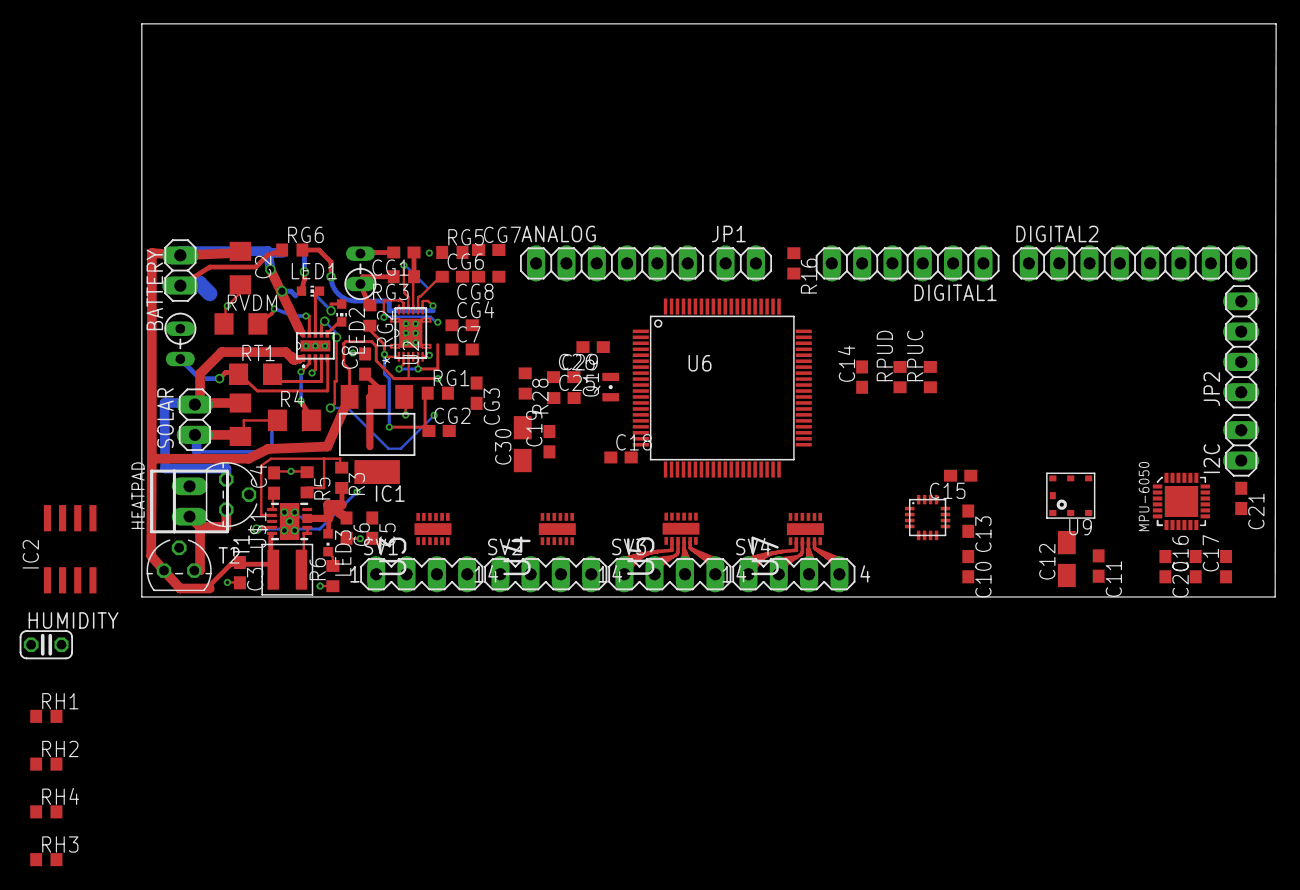
[picture p109: board octanis_v0.2.brd from above]

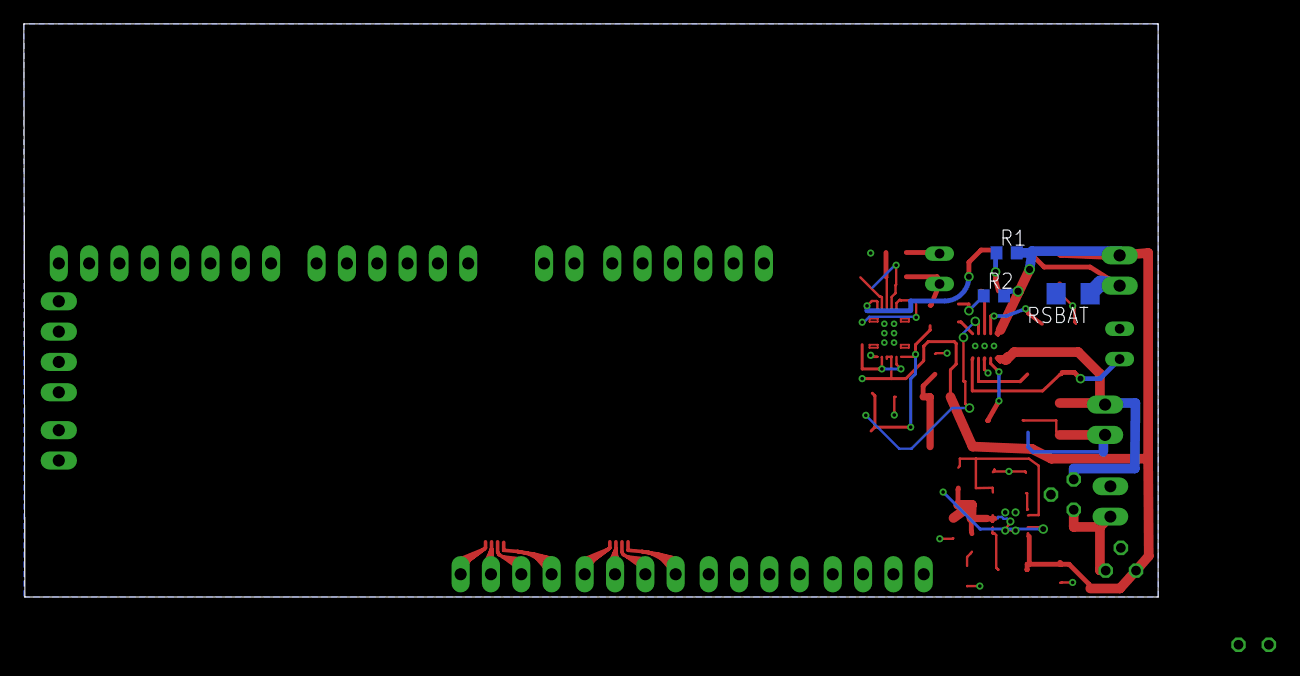
[picture p110: board octanis_v0.2.brd from below]

Board: 4 copper layers, 95.0 x 48.0 mm, 89 parts (3 on the bottom side), 103 nets.
