Octanis1/Octanis1-Electronics/MSP430 LaunchPad/MSP-EXP430F5529LP.brd

## EAGLE design MSP430 LaunchPad/MSP-EXP430F5529LP.brd (2014-07-14)

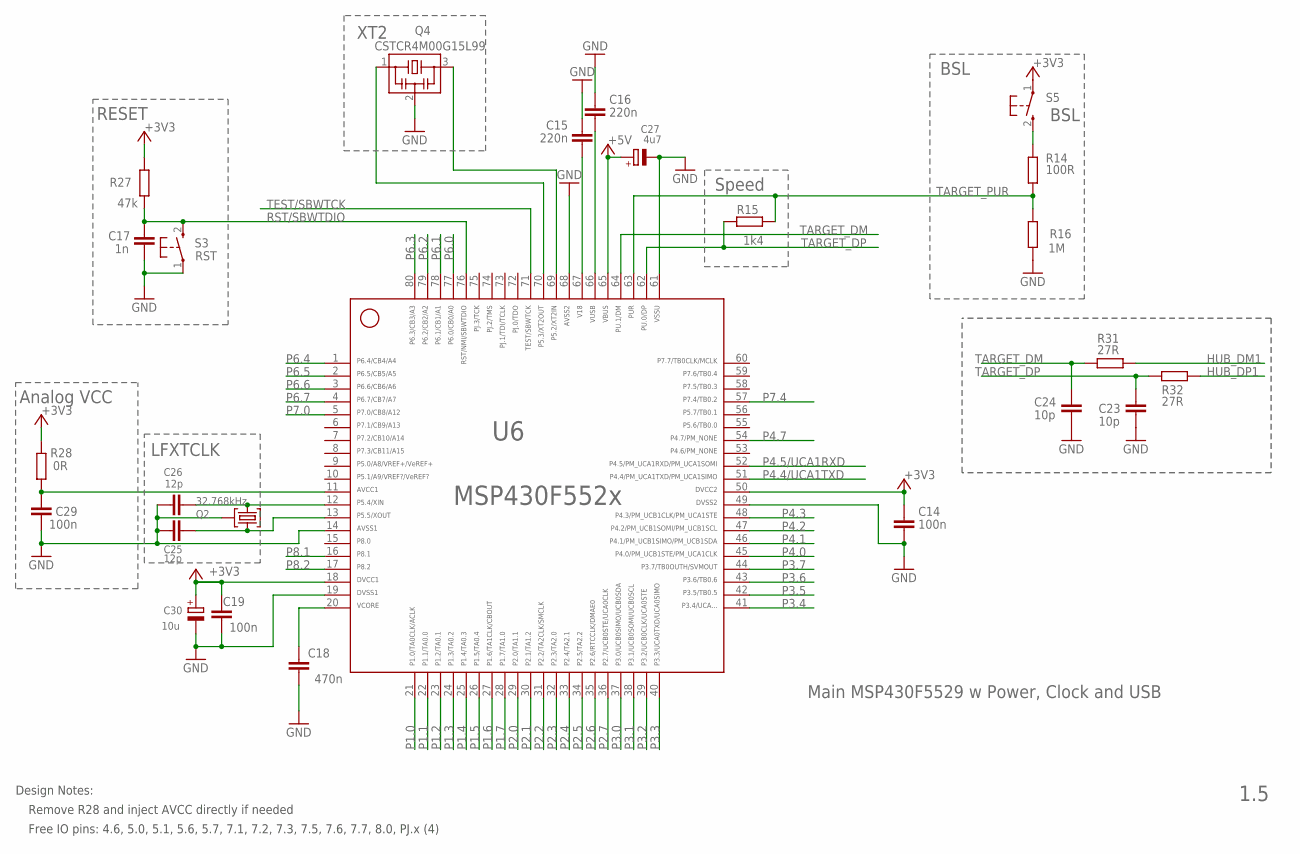
[picture p111: schematic MSP-EXP430F5529LP.sch, sheet 1]

Parts:
C14, C19, C29: 100n; C0402
C15, C16: 220n; C0402
C17: 1n; C0402
C18: 470n; C0402
C23, C24: 10p; C0402
C25, C26: 12p; C0402
C27: 4u7; A/3216-18R
C30: 10u; A/3216-18R
Q2: 32.768kHz; MS3V-T1R
Q4: CSTCR4M00G15L99; MURATA-FILTER_CSTCR
R14: 100R; R0402
R15: 1k4; R0402
R16: 1M; R0402
R27: 47k; R0402
R28: 0R; R0402
R31, R32: 27R; R0402
S3: RST; PBTH
S5: BSL; PBTH
U6: MSP430F5529IPNR; PN80

Connections:
+3V3: C14.1, C19.2, C30.+, R27.2, R28.2, S5.1, U6.18, U6.50; also elsewhere on the board
+5V: C27.+, U6.65; also elsewhere on the board
AVCC: C29.1, R28.1, U6.11
GND: C14.2, C15.2, C16.2, C17.2, C18.1, C19.1, C23.2, C24.2, C25.1, C26.1, C27.-, C29.2, C30.-, Q2.P3 (GND), Q4.2, R16.1, S3.1, U6.14, U6.19, U6.49, U6.61, U6.68; also elsewhere on the board
HUB_DM1: R31.1; also elsewhere on the board
HUB_DP1: R32.1; also elsewhere on the board
unnamed: R14.1, S5.2 (S)
P1.0: U6.21; also elsewhere on the board
P1.1: U6.22; also elsewhere on the board
P1.2: U6.23; also elsewhere on the board
P1.3: U6.24; also elsewhere on the board
P1.4: U6.25; also elsewhere on the board
P1.5: U6.26; also elsewhere on the board
P1.6: U6.27; also elsewhere on the board
P1.7: U6.28; also elsewhere on the board
P2.0: U6.29; also elsewhere on the board
P2.1: U6.30; also elsewhere on the board
P2.2: U6.31; also elsewhere on the board
P2.3: U6.32; also elsewhere on the board
P2.4: U6.33; also elsewhere on the board
P2.5: U6.34; also elsewhere on the board
P2.6: U6.35; also elsewhere on the board
P2.7: U6.36; also elsewhere on the board
P3.0: U6.37; also elsewhere on the board
P3.1: U6.38; also elsewhere on the board
P3.2: U6.39; also elsewhere on the board
P3.3: U6.40; also elsewhere on the board
P3.4: U6.41; also elsewhere on the board
P3.5: U6.42; also elsewhere on the board
P3.6: U6.43; also elsewhere on the board
P3.7: U6.44; also elsewhere on the board
P4.0: U6.45; also elsewhere on the board
P4.1: U6.46; also elsewhere on the board
P4.2: U6.47; also elsewhere on the board
P4.3: U6.48; also elsewhere on the board
P4.4/UCA1TXD: U6.51; also elsewhere on the board
P4.5/UCA1RXD: U6.52; also elsewhere on the board
P4.7: U6.54; also elsewhere on the board
P5.2/XT2IN: Q4.3, U6.69
P5.3/XT2OUT: Q4.1, U6.70
P5.4/XIN: C26.2, Q2.P2 (2), U6.12
P5.5/XOUT: C25.2, Q2.P1 (1), U6.13
P6.0: U6.77; also elsewhere on the board
P6.1: U6.78; also elsewhere on the board
P6.2: U6.79; also elsewhere on the board
P6.3: U6.80; also elsewhere on the board
P6.4: U6.1; also elsewhere on the board
P6.5: U6.2; also elsewhere on the board
P6.6: U6.3; also elsewhere on the board
P6.7: U6.4; also elsewhere on the board
P7.0: U6.5; also elsewhere on the board
P7.4: U6.57; also elsewhere on the board
P8.1: U6.16; also elsewhere on the board
P8.2: U6.17; also elsewhere on the board
RST/SBWTDIO: C17.1, R27.1, S3.2 (S), U6.76; also elsewhere on the board
TARGET_DM: C24.1, R31.2, U6.64
TARGET_DP: C23.1, R15.2, R32.2, U6.62
TARGET_PUR: R14.2, R15.1, R16.2, U6.63
TARGET_VUSB: C16.1, U6.66
TEST/SBWTCK: U6.71; also elsewhere on the board
V18: C15.1, U6.67
VCORE: C18.2, U6.20

Notes on the sheet:
RESET
LFXTCLK
XT2
Main MSP430F5529 w Power, Clock and USB
1.5
BSL
Speed
Analog VCC
Remove R28 and inject AVCC directly if needed
Design Notes:
Free IO pins: 4.6, 5.0, 5.1, 5.6, 5.7, 7.1, 7.2, 7.3, 7.5, 7.6, 7.7, 8.0, PJ.x (4)

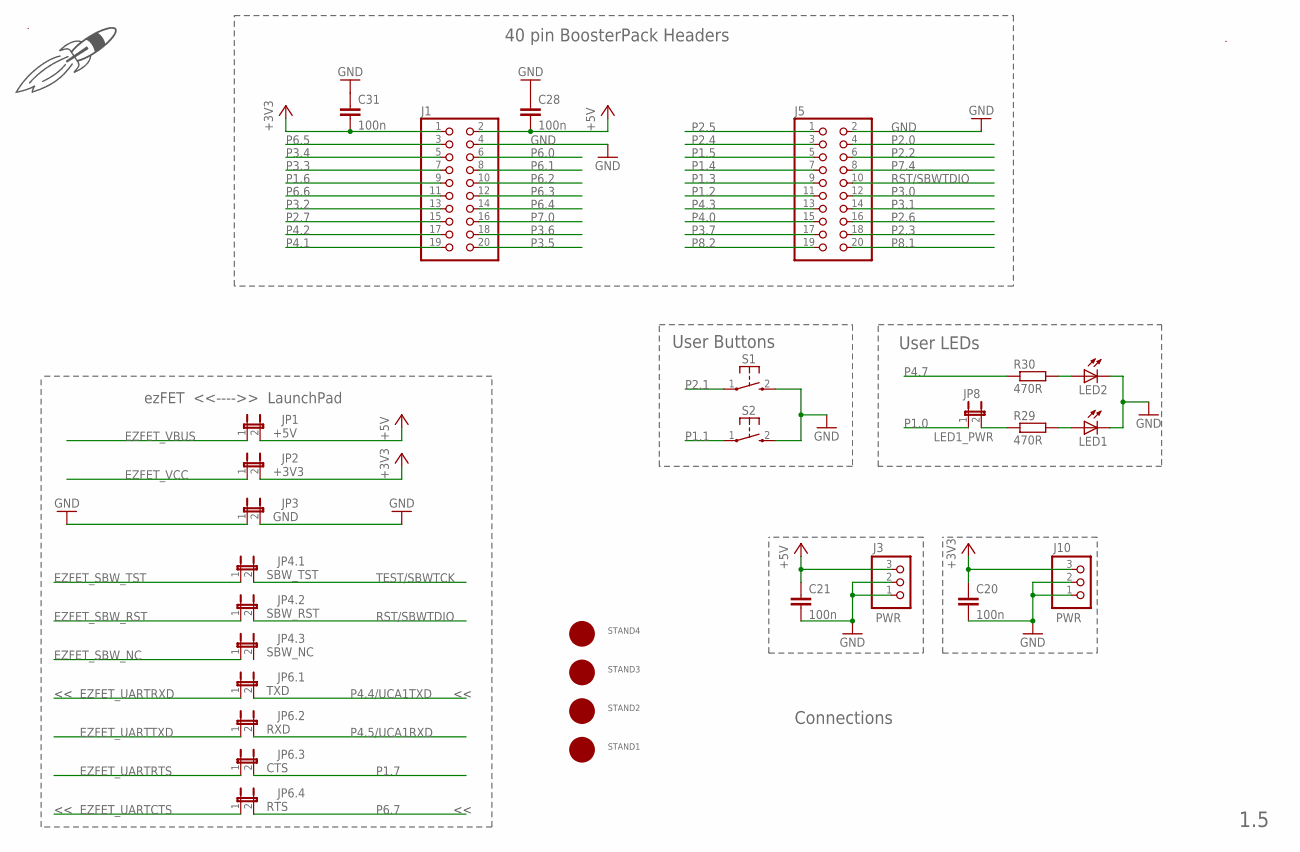
[picture p112: schematic MSP-EXP430F5529LP.sch, sheet 2]

Parts:
C20, C21, C28, C31: 100n; C0402
DRAW1: LOGO-ROCKET-20X13MM-SCH-S; LOGO-ROCKET-10X7MM-BRD
J1, J5: PINHD-2X10; 2X10
J3, J10: PWR; 1X03
JP1: +5V; JP1M
JP2: +3V3; JP1M
JP3: GND; JP1M
JP4.1: SBW_TST; JP1M
JP4.2: SBW_RST; JP1M
JP4.3: SBW_NC; JP1M
JP6.1: TXD; JP1M
JP6.2: RXD; JP1M
JP6.3: CTS; JP1M
JP6.4: RTS; JP1M
JP8: LED1_PWR; JP1
LED1, LED2: LEDCHIPLED_0603; CHIPLED_0603
R29, R30: 470R; R0402
S1, S2: PB; PBTH
STAND1, STAND2, STAND3, STAND4: MOUNT; MOUNTHOLE_110MIL
U$3: 5529_REAR_SILK_REV1_5_FINAL
U$4: MS_TM

Connections:
+3V3: C20.1, C31.2, J1.1, J10.3, JP2.2; also elsewhere on the board
+5V: C21.1, C28.2, J1.2, J3.3, JP1.2; also elsewhere on the board
EZFET_SBW_NC: JP4.3.1; also elsewhere on the board
EZFET_SBW_RST: JP4.2.1; also elsewhere on the board
EZFET_SBW_TST: JP4.1.1; also elsewhere on the board
EZFET_UARTCTS: JP6.4.1; also elsewhere on the board
EZFET_UARTRTS: JP6.3.1; also elsewhere on the board
EZFET_UARTRXD: JP6.1.1; also elsewhere on the board
EZFET_UARTTXD: JP6.2.1; also elsewhere on the board
EZFET_VBUS: JP1.1; also elsewhere on the board
EZFET_VCC: JP2.1; also elsewhere on the board
GND: C20.2, C21.2, C28.1, C31.1, J1.4, J3.1, J3.2, J5.2, J10.1, J10.2, JP3.1, JP3.2, LED1.C, LED2.C, S1.2 (S), S2.2 (S); also elsewhere on the board
unnamed: JP8.2, R29.1
unnamed: LED1.A, R29.2
unnamed: LED2.A, R30.2
P1.0: JP8.1; also elsewhere on the board
P1.1: S2.1; also elsewhere on the board
P1.2: J5.11; also elsewhere on the board
P1.3: J5.9; also elsewhere on the board
P1.4: J5.7; also elsewhere on the board
P1.5: J5.5; also elsewhere on the board
P1.6: J1.9; also elsewhere on the board
P1.7: JP6.3.2; also elsewhere on the board
P2.0: J5.4; also elsewhere on the board
P2.1: S1.1; also elsewhere on the board
P2.2: J5.6; also elsewhere on the board
P2.3: J5.18; also elsewhere on the board
P2.4: J5.3; also elsewhere on the board
P2.5: J5.1; also elsewhere on the board
P2.6: J5.16; also elsewhere on the board
P2.7: J1.15; also elsewhere on the board
P3.0: J5.12; also elsewhere on the board
P3.1: J5.14; also elsewhere on the board
P3.2: J1.13; also elsewhere on the board
P3.3: J1.7; also elsewhere on the board
P3.4: J1.5; also elsewhere on the board
P3.5: J1.20; also elsewhere on the board
P3.6: J1.18; also elsewhere on the board
P3.7: J5.17; also elsewhere on the board
P4.0: J5.15; also elsewhere on the board
P4.1: J1.19; also elsewhere on the board
P4.2: J1.17; also elsewhere on the board
P4.3: J5.13; also elsewhere on the board
P4.4/UCA1TXD: JP6.1.2; also elsewhere on the board
P4.5/UCA1RXD: JP6.2.2; also elsewhere on the board
P4.7: R30.1; also elsewhere on the board
P6.0: J1.6; also elsewhere on the board
P6.1: J1.8; also elsewhere on the board
P6.2: J1.10; also elsewhere on the board
P6.3: J1.12; also elsewhere on the board
P6.4: J1.14; also elsewhere on the board
P6.5: J1.3; also elsewhere on the board
P6.6: J1.11; also elsewhere on the board
P6.7: JP6.4.2; also elsewhere on the board
P7.0: J1.16; also elsewhere on the board
P7.4: J5.8; also elsewhere on the board
P8.1: J5.20; also elsewhere on the board
P8.2: J5.19; also elsewhere on the board
RST/SBWTDIO: J5.10, JP4.2.2; also elsewhere on the board
TEST/SBWTCK: JP4.1.2; also elsewhere on the board

Notes on the sheet:
40 pin BoosterPack Headers
Connections
1.5
User LEDs
User Buttons
ezFET <<---->> LaunchPad

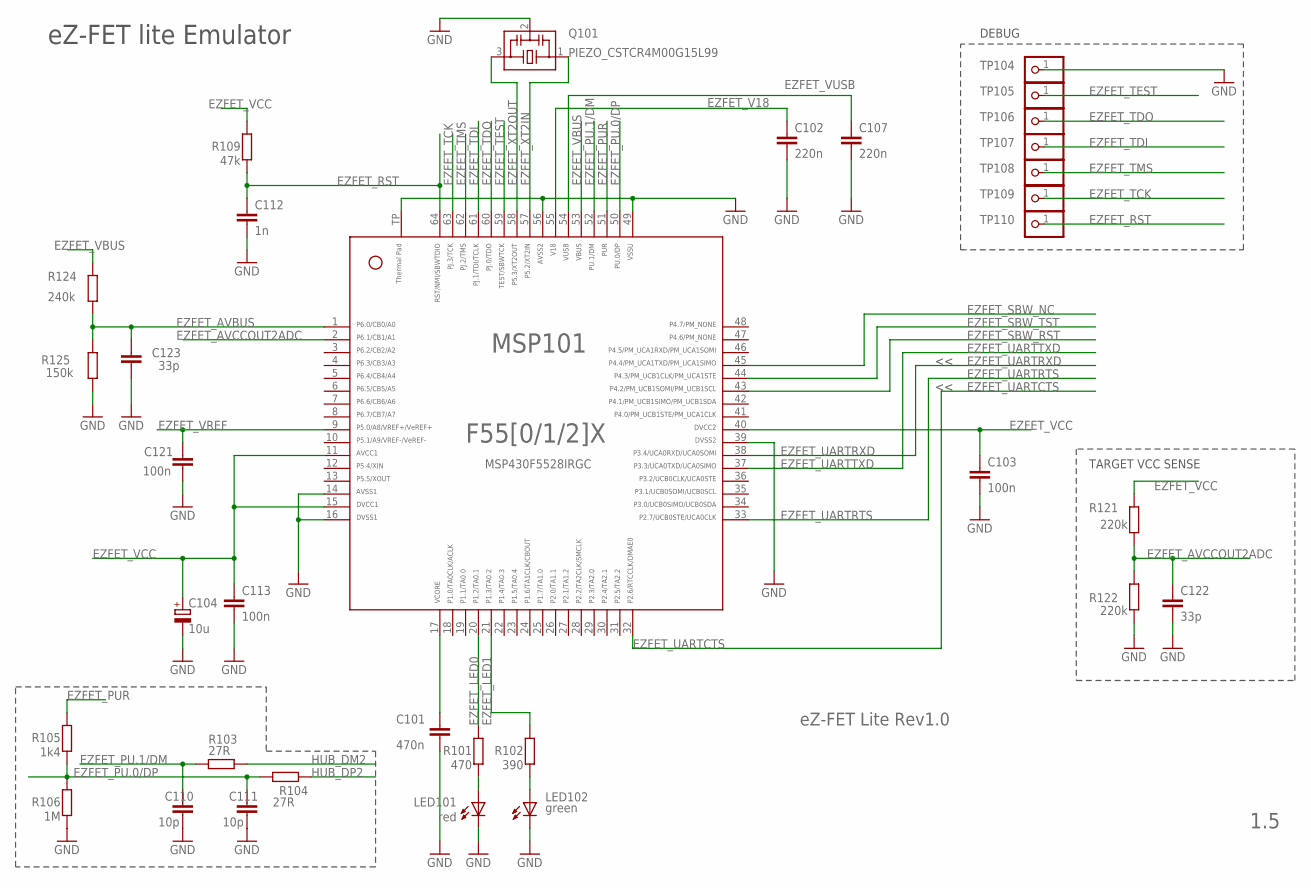
[picture p113: schematic MSP-EXP430F5529LP.sch, sheet 3]

Parts:
C101: 470n; C0402
C102, C107: 220n; C0402
C103, C113, C121: 100n; C0402
C104: 10u; A/3216-18R
C110, C111: 10p; C0402
C112: 1n; C0402
C122, C123: 33p; C0402
LED101: red; CHIP-LED0603
LED102: green; CHIP-LED0603
MSP101: MSP430F5528IRGC; RGC64
Q101: PIEZO_CSTCR4M00G15L99; MURATA-FILTER_CSTCR
R101: 470; R0402
R102: 390; R0402
R103, R104: 27R; R0402
R105: 1k4; R0402
R106: 1M; R0402
R109: 47k; R0402
R121, R122: 220k; R0402
R124: 240k; R0402
R125: 150k; R0402
TP104, TP105, TP106, TP107, TP108, TP109, TP110: TEST_PIN2; 1X01

Connections:
EZFET_AVBUS: C123.2, MSP101.1, R124.2, R125.1
EZFET_AVCCOUT2ADC: C122.2, MSP101.2, R121.2, R122.1
EZFET_LED0: MSP101.20, R101.2
EZFET_LED1: MSP101.21, R102.2
EZFET_PU.0/DP: C111.1, MSP101.50, R104.2, R105.1, R106.2
EZFET_PU.1/DM: C110.1, MSP101.52, R103.2
EZFET_PUR: MSP101.51, R105.2
EZFET_RST: C112.1, MSP101.64, R109.1, TP110.1
EZFET_SBW_NC: MSP101.45; also elsewhere on the board
EZFET_SBW_RST: MSP101.43; also elsewhere on the board
EZFET_SBW_TST: MSP101.44; also elsewhere on the board
EZFET_TCK: MSP101.63, TP109.1
EZFET_TDI: MSP101.61, TP107.1
EZFET_TDO: MSP101.60, TP106.1
EZFET_TEST: MSP101.59, TP105.1
EZFET_TMS: MSP101.62, TP108.1
EZFET_UARTCTS: MSP101.32; also elsewhere on the board
EZFET_UARTRTS: MSP101.33; also elsewhere on the board
EZFET_UARTRXD: MSP101.38; also elsewhere on the board
EZFET_UARTTXD: MSP101.37; also elsewhere on the board
EZFET_V18: C102.1, MSP101.55
EZFET_VBUS: MSP101.53, R124.1; also elsewhere on the board
EZFET_VCC: C103.1, C104.+, C113.1, MSP101.11, MSP101.15, MSP101.40, R109.2, R121.1; also elsewhere on the board
EZFET_VREF: C121.1, MSP101.9
EZFET_VUSB: C107.1, MSP101.54
EZFET_XT2IN: MSP101.57, Q101.1
EZFET_XT2OUT: MSP101.58, Q101.3
GND: C101.2, C102.2, C103.2, C104.-, C107.2, C110.2, C111.2, C112.2, C113.2, C121.2, C122.1, C123.1, LED101.C, LED102.C, MSP101.14, MSP101.16, MSP101.39, MSP101.49, MSP101.56, MSP101.TP, Q101.2, R106.1, R122.2, R125.2, TP104.1; also elsewhere on the board
HUB_DM2: R103.1; also elsewhere on the board
HUB_DP2: R104.1; also elsewhere on the board
unnamed: LED101.A, R101.1
unnamed: LED102.A, R102.1
unnamed: C101.1, MSP101.17

Notes on the sheet:
eZ-FET lite Emulator
MSP430F5528IRGC
TARGET VCC SENSE
eZ-FET Lite Rev1.0
1.5
DEBUG

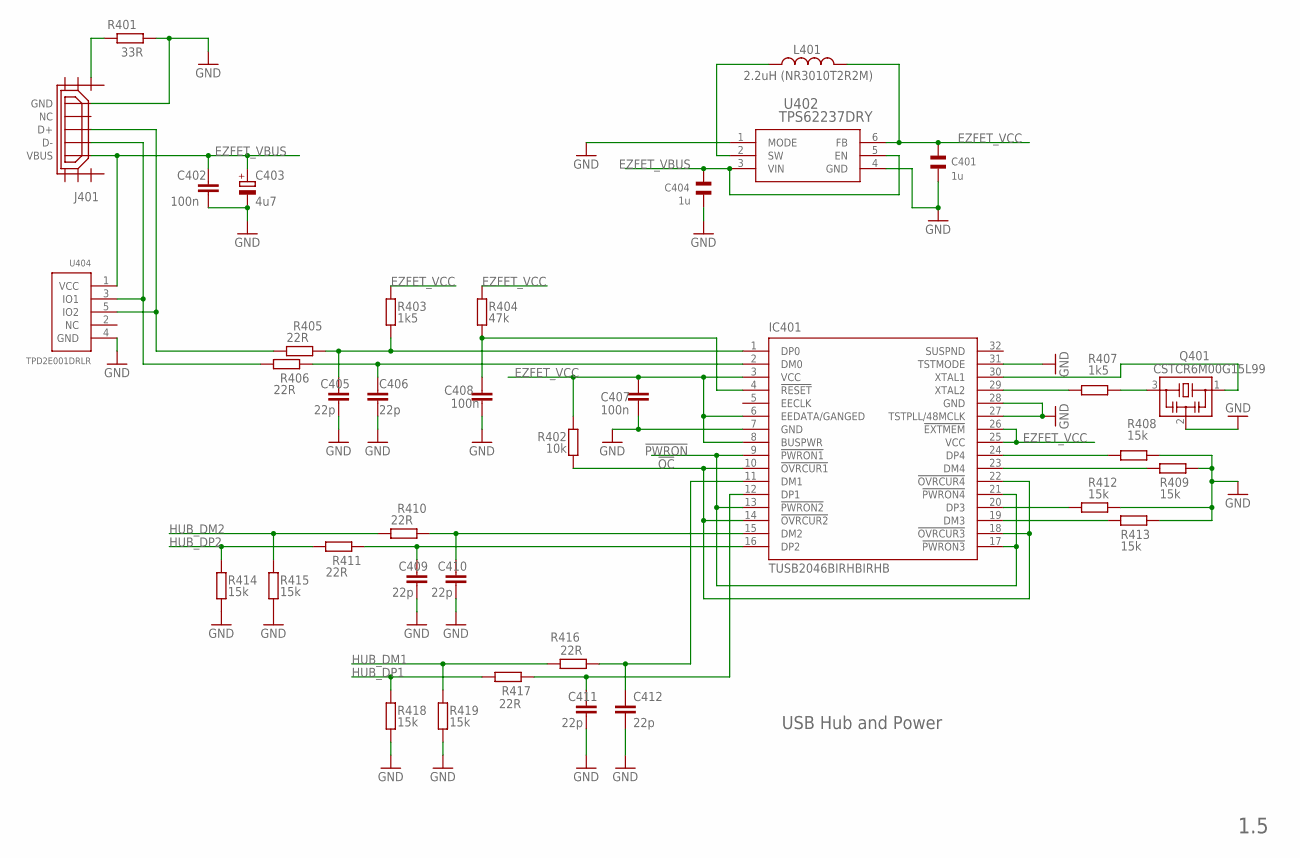
[picture p114: schematic MSP-EXP430F5529LP.sch, sheet 4]

Parts:
C401, C404: 1u; CSMD0805
C402, C407, C408: 100n; C0402
C403: 4u7; A/3216-18R
C405, C406, C409, C410, C411, C412: 22p; C0402
IC401: TUSB2046BIRHBIRHB; RHB_S-PQFP-N32
J401: USB_MICRO_FLIPPED; HIROSE-ZX62R-B-5P
L401: 2.2uH (NR3010T2R2M); L-NR3010
Q401: CSTCR6M00G15L99; MURATA-FILTER_CSTCR
R401: 33R; R0402
R402: 10k; R0402
R403, R407: 1k5; R0402
R404: 47k; R0402
R405, R406, R410, R411, R416, R417: 22R; R0402
R408, R409, R412, R413, R414, R415, R418, R419: 15k; R0402
U402: TPS62237DRY; DRY6
U404: TPD2E001DRLR; TPD2E001-DRL

Connections:
!OC: IC401.10 (!OVRCUR1), IC401.14 (!OVRCUR2), IC401.18 (!OVRCUR3), IC401.22 (!OVRCUR4), R402.2
!PWRON: IC401.9 (!PWRON1), IC401.13 (!PWRON2), IC401.17 (!PWRON3), IC401.21 (!PWRON4)
EZFET_VBUS: C402.1, C403.+, C404.2, J401.VBUS, U402.3 (VIN), U402.5 (EN), U404.1 (VCC); also elsewhere on the board
EZFET_VCC: C401.2, C407.1, IC401.3 (VCC), IC401.6 (EEDATA/GANGED), IC401.8 (BUSPWR), IC401.25 (VCC), IC401.26 (!EXTMEM), L401.P$2 (2), R402.1, R403.1, R404.1, U402.6 (FB); also elsewhere on the board
GND: C401.1, C402.2, C403.-, C404.1, C405.2, C406.2, C407.2, C408.2, C409.2, C410.2, C411.2, C412.2, IC401.7 (GND), IC401.27 (TSTPLL/48MCLK), IC401.28 (GND), IC401.31 (TSTMODE), J401.GND, Q401.2, R401.2, R408.1, R409.1, R412.1, R413.1, R414.2, R415.2, R418.2, R419.2, U402.1 (MODE), U402.4 (GND), U404.4 (GND); also elsewhere on the board
HUB_DM1: R416.2, R419.1; also elsewhere on the board
HUB_DM2: R410.2, R415.1; also elsewhere on the board
HUB_DP1: R417.2, R418.1; also elsewhere on the board
HUB_DP2: R411.2, R414.1; also elsewhere on the board
unnamed: C410.1, IC401.15 (DM2), R410.1
unnamed: C405.1, IC401.1 (DP0), R403.2, R405.1
unnamed: IC401.30 (XTAL1), Q401.1
unnamed: J401.SHIELD1, R401.1
unnamed: C406.1, IC401.2 (DM0), R406.1
unnamed: J401.D+, R405.2, U404.5 (IO2)
unnamed: J401.D-, R406.2, U404.3 (IO1)
unnamed: L401.P$1 (1), U402.2 (SW)
unnamed: IC401.29 (XTAL2), R407.2
unnamed: C412.1, IC401.11 (DM1), R416.1
unnamed: C411.1, IC401.12 (DP1), R417.1
unnamed: C409.1, IC401.16 (DP2), R411.1
unnamed: C408.1, IC401.4 (!RESET), R404.2
unnamed: IC401.20 (DP3), R412.2
unnamed: IC401.24 (DP4), R408.2
unnamed: IC401.23 (DM4), R409.2
unnamed: IC401.19 (DM3), R413.2
unnamed: Q401.3, R407.1

Notes on the sheet:
USB Hub and Power
1.5

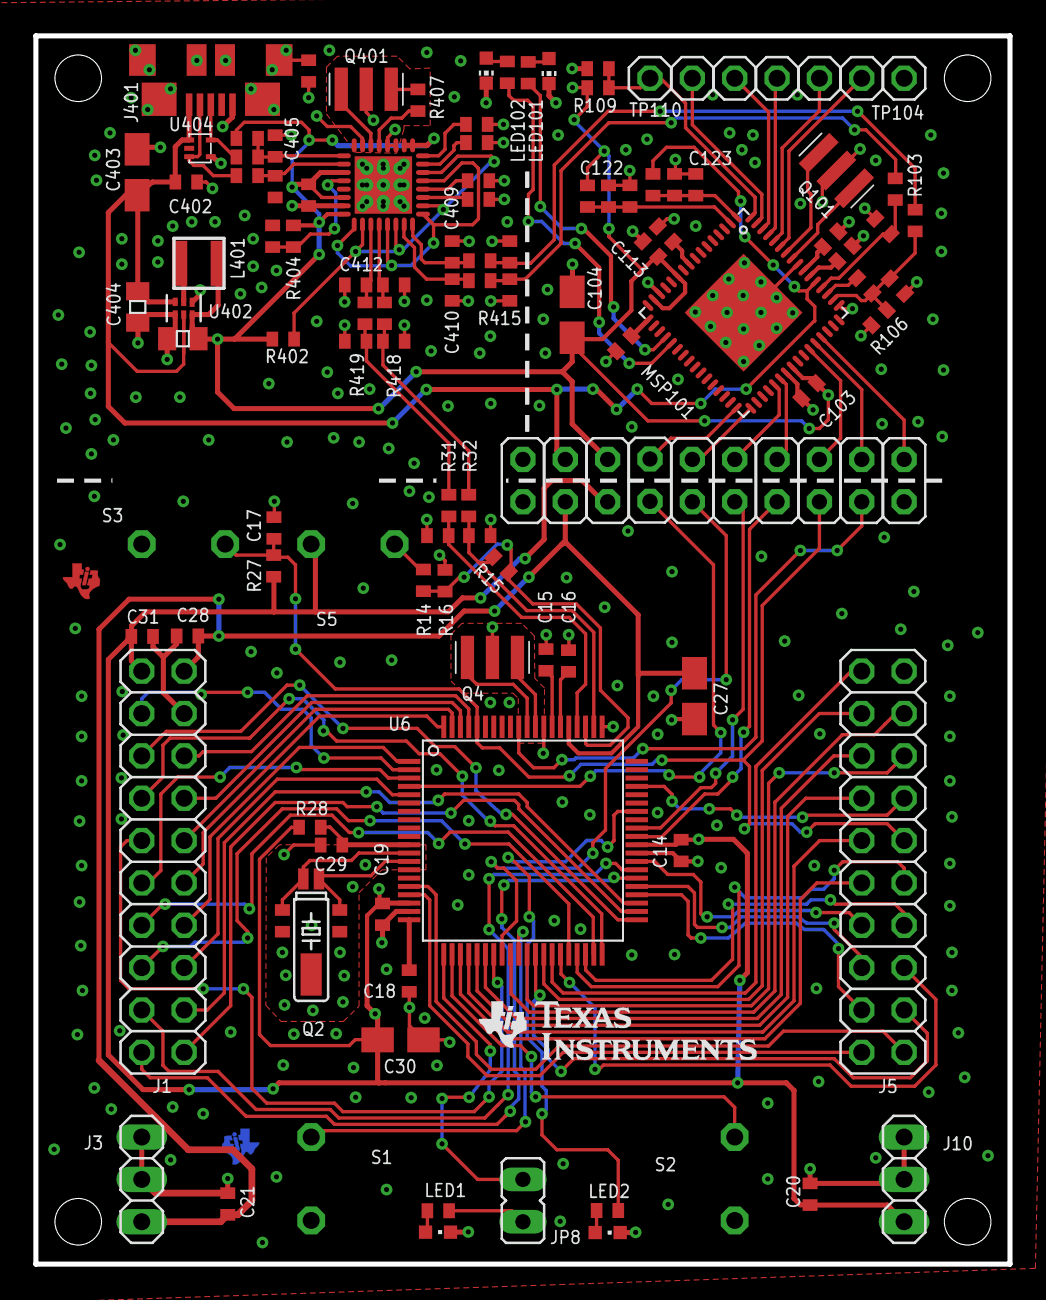
[picture p115: board MSP-EXP430F5529LP.brd from above]

Board: 2 copper layers, 58.4 x 73.7 mm, 132 parts (1 on the bottom side), 117 nets.

Other parts of the board:
DRAW2: LOGO-ROCKET-10X7MM-BRD
U$1: LOGO16_TPLACE
U$2, U$5: TILOGO_SMALL
