Octanis1/Octanis1-Electronics/pannelized v0_5/pannelized_eps_weather.brd

## EAGLE design pannelized v0_5/pannelized_eps_weather.brd (2015-09-01)

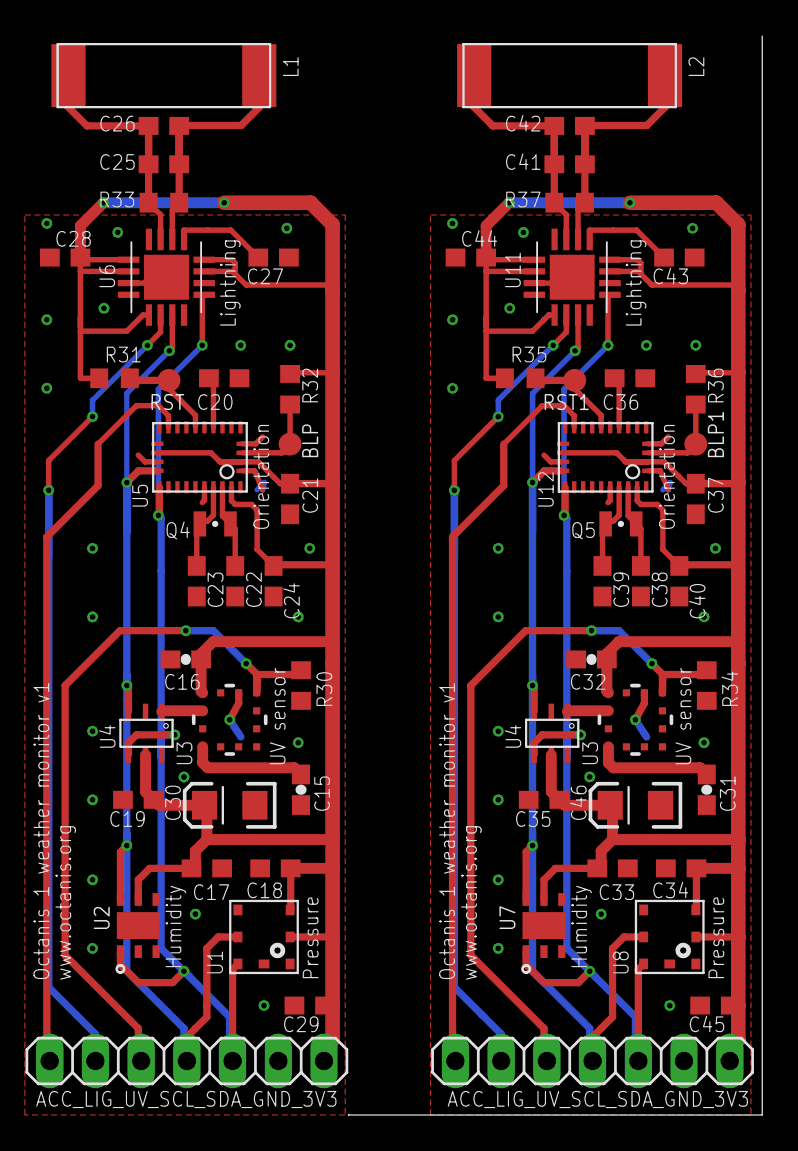
[picture p116: board pannelized_eps_weather.brd from above]

Board: 4 copper layers, 62 parts (0 on the bottom side), 32 nets.

Parts:
BLP, BLP1: PTR1B1,27; B1,27
C15, C31: 1n; 0603-CAP
C16, C32: 100n; 0603-CAP
C17, C18, C19, C20, C21, C29, C33, C34, C35, C36, C37, C45: 100n; C0603
C22, C23, C38, C39: 12p; C0603
C24, C40: 120n; C0603
C25, C41: 670p; C0603
C26, C42: 270p; C0603
C27, C43: 10u; C0603
C28, C44: 1u; C0603
C30, C46: 10uF; EIA3216
JP4, JP5: 1X07
L1, L2: 100uH; COILCRAFT
Q4, Q5: 32.768kHz; FC-12M
R30, R31, R32, R33, R34, R35, R36, R37: 10k; R0603
RST, RST1: PTR1B1,27; B1,27
U1, U8: BMP180
U2, U7: SHT21; DFN300X300X110-7N
U3, U10: ML8511-UV-SENSORSMD; ML8511
U4, U9: MCP3425; SOT-23-6
U5, U12: BNO055A; BNO055
U6, U11: AS3935; 16LDMLPQ

Connections:
+3V1: C32.1, C33.1, C34.1, C35.1, C37.1, C40.1, C44.2, C45.1, C46.A, JP5.1, R35.1, R36.2, U7.5, U8.2, U8.3, U9.VDD, U10.7, U11.5, U11.6, U11.9, U11.15, U11.16, U12.3, U12.17, U12.28
+3V3: C16.1, C17.1, C18.1, C19.1, C21.1, C24.1, C28.2, C29.1, C30.A, JP4.1, R31.1, R32.2, U1.2, U1.3, U2.5, U3.7, U4.VDD, U5.3, U5.17, U5.28, U6.5, U6.6, U6.9, U6.15, U6.16
ACCEL_IRQ: JP4.7, U5.14
ACCEL_IRQ1: JP5.7, U12.14
ACCEL_N_BOOTLD: BLP.TP, R32.1, U5.4
ACCEL_N_BOOTLD1: BLP1.TP, R36.1, U12.4
ACCEL_N_RST: R31.2, RST.TP, U5.11
ACCEL_N_RST1: R35.2, RST1.TP, U12.11
GND1: C15.2, C16.2, C17.2, C18.2, C19.2, C20.1, C21.2, C22.2, C23.2, C24.2, C25.2, C26.2, C27.1, C28.1, C29.2, C30.C, JP4.2, L1.2, R30.2, R33.1, U1.7, U2.2, U3.5, U4.VIN-, U4.VSS, U5.2, U5.5, U5.6, U5.10, U5.15, U5.16, U5.18, U5.25, U6.2, U6.4, U6.7, U6.EXP
GND2: C31.2, C32.2, C33.2, C34.2, C35.2, C36.1, C37.2, C38.2, C39.2, C40.2, C41.2, C42.2, C43.1, C44.1, C45.2, C46.C, JP5.2, L2.2, R34.2, R37.1, U7.2, U8.7, U9.VIN-, U9.VSS, U10.5, U11.2, U11.4, U11.7, U11.EXP, U12.2, U12.5, U12.6, U12.10, U12.15, U12.16, U12.18, U12.25
LIGHTNING_IRQ: JP4.6, U6.10
LIGHTNING_IRQ1: JP5.6, U11.10
unnamed: C15.1, U3.10
unnamed: U3.8, U4.VIN+
unnamed: C25.1, C26.1, L1.1, R33.2, U6.3
unnamed: C27.2, U6.1
unnamed: C20.2, U5.9
unnamed: C22.1, Q4.2, U5.27
unnamed: C31.1, U10.10
unnamed: U9.VIN+, U10.8
unnamed: C41.1, C42.1, L2.1, R37.2, U11.3
unnamed: C43.2, U11.1
unnamed: C36.2, U12.9
unnamed: C39.1, Q5.1, U12.26
unnamed: C38.1, Q5.2, U12.27
unnamed: C23.1, Q4.1, U5.26
SCL: JP4.4, U1.5, U2.6, U4.SCL, U5.19, U6.11
SCL1: JP5.4, U7.6, U8.5, U9.SCL, U11.11, U12.19
SDA: JP4.3, U1.6, U2.1, U4.SDA, U5.20, U6.13
SDA1: JP5.3, U7.1, U8.6, U9.SDA, U11.13, U12.20
UV_EN: JP4.5, R30.1, U3.4
UV_EN1: JP5.5, R34.1, U10.4
