Octanis1/Octanis1-Electronics/(commit log)

2014-06-19 Adding solar charger / battery gauge dev board based on TI BQ24210 and TI BQ27510-G3. Samples ordered, dev board needs to be completed and ordered.
    [solar_charger_fuel_gauge_dev.brd, solar_charger_fuel_gauge_dev.sch]
2014-07-14 Drew Schematic for Battery Charger. Arranged parts on PCB.
    [solar_charger_fuel_gauge_dev.sch]
2014-07-14 Completed Routing for Battery charging Part
    [solar_charger_fuel_gauge_dev.brd, solar_charger_fuel_gauge_dev.sch]
2014-07-14 Added the correct MSP430 microcontroller with example circuit from LaunchPad DevBrd
    [MSP-EXP430F5529LP-bom.xlsx, MSP-EXP430F5529LP.brd, MSP-EXP430F5529LP.sch, solar_charger_fuel_gauge_dev.brd, solar_charger_fuel_gauge_dev.sch]
2014-07-15 Added I2C
    [solar_charger_fuel_gauge_dev.brd, solar_charger_fuel_gauge_dev.sch]
2014-07-15 Added Fuel Gauge Circuit in Schematic
    [solar_charger_fuel_gauge_dev.brd]
2014-07-16 Renamed and placed Parts for fuel gauge part of circuit
    [solar_charger_fuel_gauge_dev.brd, solar_charger_fuel_gauge_dev.sch]
2014-07-16 Rearranged some components and routes and increased thickness of power lines
    [solar_charger_fuel_gauge_dev.brd, solar_charger_fuel_gauge_dev.sch]
2014-07-16 Calculated R-values for Battery chargin circuit
    [solar_charger_fuel_gauge_dev.brd, solar_charger_fuel_gauge_dev.sch]
2014-07-22 changed PCB-size and Added 5V-booster circuit
    [solar_charger_fuel_gauge_dev.brd, solar_charger_fuel_gauge_dev.sch]
2014-07-29 added heating circuit
    [solar_charger_fuel_gauge_dev.brd, solar_charger_fuel_gauge_dev.sch]
2014-08-04 added heating circuit. added correct step up converter. rearranged components to top layer. drew bigger power traces.
    [solar_charger_fuel_gauge_dev.brd, solar_charger_fuel_gauge_dev.sch]
2014-08-04 added H-bridge library
    [solar_charger_fuel_gauge_dev.brd, solar_charger_fuel_gauge_dev.sch]
2014-08-05 arranged power components and h-bridges
    [solar_charger_fuel_gauge_dev.brd, solar_charger_fuel_gauge_dev.sch]
2014-08-05 rearranged and routed fuel gauge circuit part
    [solar_charger_fuel_gauge_dev.brd]
2014-08-05 connected h-bridges to pins
    [solar_charger_fuel_gauge_dev.brd, solar_charger_fuel_gauge_dev.sch]
2014-08-05 h-bridge: connected sleep pin with mode pin
    [solar_charger_fuel_gauge_dev.brd, solar_charger_fuel_gauge_dev.sch]
2014-08-06 deleted unnecessary components from launchpad board. rearranged
    [solar_charger_fuel_gauge_dev.brd, solar_charger_fuel_gauge_dev.sch]
2014-08-06 mapped ports for motors
    [solar_charger_fuel_gauge_dev.brd, solar_charger_fuel_gauge_dev.sch]
2014-08-06 routed motor ports
    [solar_charger_fuel_gauge_dev.brd]
2014-08-06 added gyro, accelerometer, pressure sensor, compass, serial connectors, analog input pins.
    [solar_charger_fuel_gauge_dev.brd, solar_charger_fuel_gauge_dev.sch]
2014-08-06 created gerber files, with logo. In v0.1
    [octanis_v0.1.brd, octanis_v0.1.sch, solar_charger_fuel_gauge_dev.brd, solar_charger_fuel_gauge_dev.sch]
2014-08-06 corrected silk layer
    [octanis_v0.1.brd, octanis_v0.1.sch]
2014-08-07 increased space between traces, connected ch_en and 5Ven to uC
    [octanis_v0.1.brd, octanis_v0.1.sch]
2014-08-10 next version 0.2, bigger pcb, added humidity sensor
    [octanis_v0.2.brd, octanis_v0.2.sch]
2015-01-22 octanis_eps first proto in progress
    [octanis_eps.brd, octanis_eps.sch, octanis_v0.2.brd, octanis_v0.2.sch]
2015-01-22 replaced the msp430 to the same component like in the octanis 0.1 board
    [octanis_eps.brd, octanis_eps.sch]
2015-01-22 eps board save Thu-22-01-2015
    [octanis_eps.brd, octanis_eps.sch, octanis_v0.2.sch]
2015-01-28 initial prototype v0.1 of EPS PCB ready for production, BOM in process
    [octanis_eps.brd, octanis_eps.sch, octanis_eps_mcu_shdn.brd, octanis_eps_mcu_shdn.sch, octanis_v0.2.brd]
2015-01-30 modified compact version schematics
    [octanis_eps_compact.brd, octanis_eps_compact.sch]
2015-01-30 corrected zener connection error
    [octanis_eps_compact.brd, octanis_eps_compact.sch]
2015-01-31 compact version 5X6cm with MSP420Gxx24
    [octanis_eps_compact_no_OPA2333.brd, octanis_eps_compact_no_OPA2333.sch]
2015-02-02 completed documentation & added BOM
    [BOM EPS octanis1.xlsx]
2015-02-10 correction & redesign on of the boost converter running
    [octanis_eps_compact_no_OPA2333.brd, octanis_eps_compact_no_OPA2333.sch]
2015-02-10 completed FeedBack loop regulation on charge circuit & routing
    [octanis_eps_compact_no_OPA2333.brd, octanis_eps_compact_no_OPA2333.sch]
2015-02-13 most recent version
    [octanis_v0.1.brd, octanis_v0.1.sch]
2015-02-17 EPS revized, routing correction performed, voltage check point added, VCC corrected
    [BOM EPS octanis1.xlsx, octanis_eps_revised.brd, octanis_eps_revised.sch]
2015-02-18 added pull down on heat EN entries
    [octanis_eps_revised.brd, octanis_eps_revised.sch]
2015-02-18 added 0Ohm jumper on discharge circuit
    [octanis_eps_revised.brd, octanis_eps_revised.sch]
2015-02-21 generated Gerbers for EPS, cosmetic corrections
    [octanis_eps_revised.GBL, octanis_eps_revised.GBO, octanis_eps_revised.GBP, octanis_eps_revised.GBS, octanis_eps_revised.GTL, octanis_eps_revised.GTO, octanis_eps_revised.GTP, octanis_eps_revised.GTS]
2015-02-23 added octanis logo and reorganised files
    [octanis_eps.brd, octanis_eps.sch, octanis_eps_mcu_shdn.brd, octanis_eps_mcu_shdn.sch, octanis_eps_revised.brd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]
2015-02-23 modified BOM for EPS
    [BOM EPS octanis1.xlsx]
2015-03-28 startet new mainboard PCB
    [BOM EPS octanis1.xlsx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]
2015-04-01 added aria bob
    [aria-BOB.brd, aria-BOB.sch, octanis_v0.1.brd, octanis_v0.1.sch]
2015-04-01 changed to throughhole
    [aria-BOB.brd, aria-BOB.sch]
2015-04-01 revoked changes
    [aria-BOB.brd, aria-BOB.sch]
2015-04-01 usb wires longer, ground plane, vdd trace wider
    [aria-BOB.brd, aria-BOB.sch]
2015-04-05 starting layout v0.3
    [octanis_v0.1.brd, octanis_v0.1.sch]
2015-04-05 layout done
    [octanis_v0.1.brd, octanis_v0.1.sch]
2015-04-05 generated gerber
    [octanis_v0.1.GBL, octanis_v0.1.GBO, octanis_v0.1.GBP, octanis_v0.1.GBS, octanis_v0.1.GTL, octanis_v0.1.GTO, octanis_v0.1.GTP, octanis_v0.1.GTS]
2015-04-05 SD card footprint aria bob
    [aria-BOB.brd, aria-BOB.sch]
2015-04-05 changed board size, increased isolation of gnd
    [aria-BOB.brd]
2015-04-06 replaced sensirion humidity sensor with bosch
    [ML8511_Breakout.brd, ML8511_Breakout.sch, external_strip_v1.brd, external_strip_v1.sch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]
2015-04-06 added holes
    [aria-BOB.brd, aria-BOB.sch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]
2015-04-08 layouting 0.4
    [MSP-EXP432P401R.brd, MSP-EXP432P401R.sch, MSP-EXP432P401R_BOM.xlsx, external_strip_v1.brd, external_strip_v1.sch, octanis_v0.4.brd, octanis_v0.4.sch]
2015-04-09 layout 0.4 almost done
    [octanis_v0.4.brd, octanis_v0.4.sch]
2015-04-10 v0.4 layout finished
    [octanis_v0.4.brd, octanis_v0.4.sch]
2015-04-11 gerber v0.4
    [octanis_v0.4.GBL, octanis_v0.4.GBO, octanis_v0.4.GBP, octanis_v0.4.GBS, octanis_v0.4.GTL, octanis_v0.4.GTO, octanis_v0.4.GTP, octanis_v0.4.GTS]
2015-04-13 finished weather strip
    [external_strip_v1.brd, external_strip_v1.sch]
2015-05-15 corrected I2C SDA short to 3V
    [Bom04.csv, Untitled.brd, Untitled.sch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]
2015-05-29 corrected footprints for MSP & Step down, 50mOhms still to be changed (4points probe)
    [octanis_eps_compact.brd, octanis_eps_compact.sch, octanis_eps_compact_no_OPA2333.brd, octanis_eps_compact_no_OPA2333.sch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]
2015-05-29 corrected MSP & Step-down foorptints, 50Ohms still to be changed (4points probe-type)
    [octanis_eps_compact.brd, octanis_eps_compact.sch, octanis_eps_compact_no_OPA2333.brd, octanis_eps_compact_no_OPA2333.sch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]
2015-05-29 reorganized folder and backed up files after bad merger operation
    [octanis_eps_compact.brd, octanis_eps_compact.sch, octanis_eps_compact_no_OPA2333.brd, octanis_eps_compact_no_OPA2333.sch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]
2015-05-29 new gerbers, carefull 4 point probes not ready yet
    [octanis_eps_v03.GBL, octanis_eps_v03.GBO, octanis_eps_v03.GBP, octanis_eps_v03.GBS, octanis_eps_v03.GTL, octanis_eps_v03.GTO, octanis_eps_v03.GTP, octanis_eps_v03.GTS]
2015-07-26 pull-up on RST, need to modify the current sensor pads
    [octanis_eps_v03.brd, octanis_eps_v03.sch]
2015-07-29 started mainboard v0.5 (added bosch accelerometer/gyro)
    [Bom04.csv, octanis_v0.5.brd, octanis_v0.5.sch]
2015-07-29 various corrections on EPS v0.3, new v0.4 for second run
    [octanis_eps_v03.GBL, octanis_eps_v03.GBO, octanis_eps_v03.GBP, octanis_eps_v03.GBS, octanis_eps_v03.GTL, octanis_eps_v03.GTO, octanis_eps_v03.GTP, octanis_eps_v03.GTS]
2015-07-31 rearranged GPIOs
    [octanis_v0.5.brd, octanis_v0.5.sch]
2015-07-31 separated motor supply. added pull ups for sleep pin
    [octanis_v0.5.brd, octanis_v0.5.sch]
2015-07-31 redesigned hx1 pins
    [octanis_v0.5.brd, octanis_v0.5.sch]
2015-08-04 thicker analog tracks for CHGCMD, better analog Grounding (same ref), regenerated gerbers. Checked with Beat
    [octanis_eps_v04.GBL, octanis_eps_v04.GBO, octanis_eps_v04.GBP, octanis_eps_v04.GBS, octanis_eps_v04.GTL, octanis_eps_v04.GTO, octanis_eps_v04.GTP, octanis_eps_v04.GTS]
2015-08-11 assigned all GPIO
    [octanis_v0.5.brd, octanis_v0.5.sch]
2015-08-11 mainboard: digital gpio routed
    [octanis_v0.5.brd, octanis_v0.5.sch]
2015-08-11 mainboard routing finished
    [octanis_v0.5.brd, octanis_v0.5.sch]
2015-08-12 mainboard finished
    [octanis_v0.5.brd, octanis_v0.5.sch]
2015-08-13 corrected UV sensor footprint
    [external_strip_v1.brd, external_strip_v1.sch, octanis_v0.5.brd, octanis_v0.5.sch]
2015-08-13 modified silk screen for EPS
    [octanis_eps_v04.brd, octanis_eps_v04.sch]
2015-08-15 added RST pull-up
    [octanis_v0.5.brd, octanis_v0.5.sch]
2015-08-21 added current sensors to motors on mainboard
    [octanis_v0.5.brd, octanis_v0.5.sch]
2015-08-21 silkscreen ready
    [octanis_v0.5.brd, octanis_v0.5.sch]
2015-08-21 added Vref and low pass filters for current sensors to mainboard
    [octanis_v0.5.brd, octanis_v0.5.sch]
2015-08-21 finised revised mainboard
    [octanis_v0.5.brd, octanis_v0.5.sch]
2015-08-21 finished revised weather strip
    [external_strip_v1.brd, external_strip_v1.sch, octanis_v0.5.brd]
2015-08-21 renumbered parts in mainboard
    [octanis_v0.5.brd, octanis_v0.5.sch]
2015-08-24 added RN2483 LoRa module, separated 3v supply for motors and 5V converter from main circuit supply. *
    [octanis_v0.5.brd, octanis_v0.5.sch]
2015-08-25 finished mainboard v0.5 silkscreen
    [octanis_v0.5.brd, octanis_v0.5.sch]
2015-08-27 minor changes on mainboard
    [octanis_v0.5.brd, octanis_v0.5.sch]
2015-08-28 added pull down on boost Cvtr enable pin, C1 and R34 in parallel, Note that Rsense = 10 mOhms instead of 50mOhms at the entry of the INA213 current sensors, Rsense 3 still at 50mOhms
    [octanis_eps_v04.brd, octanis_eps_v04.sch]
2015-08-28 changed ADR127 1.25V ref for MAX6190BESA (lower power), added 2 pins with pull down for main board sleep, DRC checked. One OPA2333 need to be changed on disispation circuit.
    [octanis_eps_v04.brd, octanis_eps_v04.sch]
2015-08-28 changed IC9A=OPA2333 (2ch) for IC9=0PA347 with SC70-5 small outline package. OPA347 allows for bigger driving currents so to be able to drive the POWER N-FET on disispation CMD (cf bgeissma for detai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
    [octanis_eps_v04.brd, octanis_eps_v04.sch]
2015-08-29 re-routed EPS. adapted silkscreen on EPS
    [octanis_eps_v04.brd, octanis_eps_v04.sch]
2015-08-31 generated gerber files and pannelized pcbs
    [octanis_v0.5.GBL, octanis_v0.5.GBO, octanis_v0.5.GBP, octanis_v0.5.GBS, octanis_v0.5.GTL, octanis_v0.5.GTO, octanis_v0.5.GTP, octanis_v0.5.GTS]
2015-09-01 created bom for v0.5
    [Bom04.csv, bomv0-5.xls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]
2015-11-14 started v0.6 mainboard. moved motor drivers to the side
    [octanis_v0.6.brd, octanis_v0.6.sch]
2015-11-15 finalized changes for v0.6. coax connector missing
    [octanis_v0.6.brd, octanis_v0.6.sch]
2015-11-18 added SMA connector for LoRa
    [octanis_v0.5.brd, octanis_v0.5.sch, octanis_v0.6.brd, octanis_v0.6.sch]
2015-11-19 DRC clean layout
    [octanis_v0.6.brd, octanis_v0.6.sch]
2015-11-19 revised silklayer
    [octanis_v0.6.brd, octanis_v0.6.sch]
2015-11-19 created gerber
    [octanis_v0.6.GBL, octanis_v0.6.GBO, octanis_v0.6.GBP, octanis_v0.6.GBS, octanis_v0.6.GTL, octanis_v0.6.GTO, octanis_v0.6.GTP, octanis_v0.6.GTS]
2015-11-30 Spectrometer and LED-BOB added
    Added s2000 spectrometer interface and small LED-board
    [led-board.brd, led-board.sch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]
2015-11-30 First ideas of new EPS
    [octanis_eps_v05.brd, octanis_eps_v05.sch]
2015-11-30 Added components for MPPT-charger
    [octanis_eps_v05.brd, octanis_eps_v05.sch]
2015-12-10 adding Beat new EPS architecture schematics
    [octanis_eps_v03.GBL, octanis_eps_v03.GBO, octanis_eps_v03.GBP, octanis_eps_v03.GBS, octanis_eps_v03.GTL, octanis_eps_v03.GTO, octanis_eps_v03.GTP, octanis_eps_v03.GTS]
2015-12-20 Arranged parts for EPS v05
    [octanis_eps_v05.brd, octanis_eps_v05.sch]
2015-12-21 started manual routing
    [octanis_eps_v05.brd]
2015-12-27 Routed 3.3V, 5V and Solar Cell stepdown
    [octanis_eps_v05.brd, octanis_eps_v05.sch]
2015-12-28 EPS v05 routed, except enable and GND
    [octanis_eps_v05.brd]
2015-12-28 Routed EPS v05, issue with heatpad under Solar and 5V DCDC
    [octanis_eps_v05.brd]
2015-12-29 EPS v05 routing complete
    [octanis_eps_v05.brd, octanis_eps_v05.sch]
2015-12-30 Added mounting holes and header names
    [octanis_eps_v05.brd]
2015-12-30 magnetic encoder board
    [magnetic_encoder.brd, magnetic_encoder.sch]
2015-12-30 silk layer
    [magnetic_encoder.brd, magnetic_encoder.sch]
2016-01-02 minor eps changes. stencil laser cut files for v0.6 added
    [octanis_eps_v04.brd, octanis_eps_v04.sch, octanis_eps_v05.brd, octanis_v0.6%N.cmp.dxf, octanis_v0.6%N.sol.dxf, octanis_v0.6.dxf, stencilw.dxf]
2016-01-03 Labels of EPS05 changed
    [octanis_eps_v05.brd, octanis_eps_v05.sch]
2016-01-03 measured correct dimensions
    [magnetic_encoder.brd]
2016-01-03 corrected eps libraries so that they are GERBER-izable. (ERROR was: 'Board contains a polygon that may cause extremely large plot data' and is due to drawn polygons with width=0 in tStop, tCream and 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
    [octanis_eps_v05.GBL, octanis_eps_v05.GBO, octanis_eps_v05.GBP, octanis_eps_v05.GBS, octanis_eps_v05.GTL, octanis_eps_v05.GTO, octanis_eps_v05.GTP, octanis_eps_v05.GTS]
2016-01-03 pannelized EPS with magnet sensor board, created gerber files
    [magnetic_encoder.brd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]
2016-02-22 Started redesign of EPS
    [12Vcalcs.xlsx, octanis_bom.xlsx, octanis_eps_v06.brd, octanis_eps_v06.sch]
2016-02-24 started v1.0
    [octanis_v1.brd, octanis_v1.sch]
2016-03-02 started v1.0 mainboard
    [octanis_v1.brd, octanis_v1.sch]
2016-03-02 added 5V on-off switch and battery boost converter to mainboard
    [octanis_v1.brd, octanis_v1.sch]
2016-03-02 silkscreen artwork, lightning input interrupt
    [octanis_v1.brd, octanis_v1.sch]
2016-03-02 octanis 1.0 finished
    [octanis_v1.brd, octanis_v1.sch]
2016-03-03 weather strip v3. revised mainboard v1
    [external_strip_v1.brd, external_strip_v3.brd, external_strip_v3.sch, octanis_v1.brd]
2016-03-03 created final gerber files
    [external_strip_v3.GBL, external_strip_v3.GBO, external_strip_v3.GBP, external_strip_v3.GBS, external_strip_v3.GTL, external_strip_v3.GTO, external_strip_v3.GTP, external_strip_v3.GTS]
2016-03-05 replaced 3.3v converters to the BGA component. started moving components to make space on top side
    [octanis_eps_v05.brd, octanis_eps_v05.sch]
2016-03-08 replaced MSP430 for more efficient model. added mosfet circuit braker to schematic
    [octanis_eps_v05.brd, octanis_eps_v05.sch]
2016-03-08 restored old v0.5, renamed v1.0 correctly
    [octanis_eps_v05.GBL, octanis_eps_v05.GBO, octanis_eps_v05.GBP, octanis_eps_v05.GBS, octanis_eps_v05.GTL, octanis_eps_v05.GTO, octanis_eps_v05.GTP, octanis_eps_v05.GTS]
2016-03-20 now all EPS components are on top side
    [BOMv1.xlsx, octanis_eps_v05.sch, octanis_eps_v1.brd, octanis_eps_v1.sch]
2016-03-20 finished component placement of new EPS
    [octanis_eps_v1.brd, octanis_eps_v1.sch]
2016-03-21 dru check; added proper grounding and AVCC for all amps
    [octanis_eps_v1.brd, octanis_eps_v1.sch]
2016-03-21 removed ground loops
    [octanis_eps_v1.brd, octanis_eps_v1.sch]
2016-03-21 reworked silkscreen
    [octanis_eps_v1.brd, octanis_eps_v1.sch]
2016-03-21 final silk and minor copper rework. files ready for production
    [octanis_eps_v1.brd, octanis_eps_v1.sch]
2016-03-23 removed stitching at 12V boost; final files that were sent to production
    [octanis_eps_v1.brd]
2016-04-05 corrected the feedback pin error on battery DC-DC converter.
    [octanis_v1.brd, octanis_v1.sch]
2016-05-22 adjusted final resistor values for eps v1.0
    [octanis_eps_v05.brd, octanis_eps_v05.sch, octanis_eps_v1.brd, octanis_eps_v1.sch]
2016-05-28 connected VCC of BMP280 to 3V3 -> v3.1
    [external_strip_v3.GBL, external_strip_v3.GBO, external_strip_v3.GBP, external_strip_v3.GBS, external_strip_v3.GTL, external_strip_v3.GTO, external_strip_v3.GTP, external_strip_v3.GTS]
2016-06-11 Added direct battery out, 5V and USB charger
    [octanis_eps_v2.brd, octanis_eps_v2.sch]
2016-06-21 EPS v2.0 finished routing
    [octanis_eps_v1.brd, octanis_eps_v1.sch, octanis_eps_v2.brd, octanis_eps_v2.sch]
2016-06-21 performed DRC
    [octanis_eps_v2.brd, octanis_eps_v2.sch]
2016-06-22 corrected some GND mistakes; finished v2.0 silk layer
    [octanis_eps_v2.brd, octanis_eps_v2.sch]
2016-06-22 updated titles and moved logo
    [octanis_eps_v2.brd]
2016-06-23 finalized silkscreen, generated Gerber files for EPS v2; replaced UV sensor in weather board, generated gerber files for v4
    [external_strip_v4.GBL, external_strip_v4.GBO, external_strip_v4.GBP, external_strip_v4.GBS, external_strip_v4.GTL, external_strip_v4.GTO, external_strip_v4.GTP, external_strip_v4.GTS]
