Octanis1/Octanis1-Electronics/(notices)

Notices in the files:
MSP430 LaunchPad/MSP-EXP430F5529LP.brd:
(C)2003 A. DANNENBERG
parts and their libraries:
SparkFun-Aesthetics: Licensing: CC v3.0 Share-Alike You are welcome to use this library for commercial purposes.
SparkFun-Retired: Licensing:Creative Commons ShareAlike 4.0 International - https://creativecommons.org/licenses/by-sa/4.0
SparkFun-Aesthetics: Released under the Creative Commons
